OpenSourceAppliances/dryer/docs/design-rules.md

# Dryer design rules

Draft 9, 2026-11-06. Status: proposed, not yet reviewed against a real build.

Changes in draft 9: the parts of the reference build are finished (`DECISIONS.md`, 2026-11-06, three entries). The blower housing hangs on a blower plate, a 1.5 mm steel plate across the bay in front of it on two angle feet, with the spool's bore cut through it (7a Drive). The exhaust is drawn as parts: the housing's 102 discharge collar, a catalog 4 in aluminium pipe along the bay floor through the rear lower panel's port and 50 proud of it as the vent hose spigot, two clamps, the air-proving tap and its tube (7a Air). The two chassis sensors the UCI-D wires to J2 are placed: the exhaust thermistor on the lint box's back plate and the moisture bar set on the front bulkhead's drum side (7a Air, 7a Bulkheads). The gas entry and the condensate drain are cut in the rear lower panel and blanked (3.2, 7a Panels). The cable clamp holes get their clips. The no-heat module is the electric module's empty box (5.1). Section 11 closes its items 4 and 5. 213 parts.

Changes in draft 8: the ducts are drawn as parts (`DECISIONS.md`, 2026-11-06). Every duct is 1.5 mm laser-cut plate screwed with M4 button heads into the tapped edges of aluminium flat bar frames: the lint box between the front stubs (30 x 8 bars, the bulkhead its back wall above 265), a spool to the blower's mouth (40 x 8), the riser's hood (25 x 8), trunk (50 x 8) and inlet nozzle (40 x 8). Drawing them found that nothing closed the door throat between the ring and the bulkhead, so a rolled 1.5 mm throat liner now stands there and the lint box's top follows it (7a Door, 7a Air). The lint filter is a mesh basket on laser-cut sector plates through the slot (widened to radius 238 to 267), lifted out through the door by a D-pull on its lip (7 Lint management). The door switch, the air-proving switch, the exhaust thermostats and the motor cradle bolts are placed (7a Door, 7a Drive). Fusion's motion model slides the basket. 198 parts.

Changes in draft 7: the two modules and the drum's support are drawn, from published figures, before the first build (`DECISIONS.md`, 2026-11-06). The electric heat module is a bolted 1.5 mm duct box on the tray with the catalog element on two angle rails inside, a round 125 collar on its lid under the riser's hood, and its contactor and terminal strips on a DIN rail on a plate behind the box; the tray rails run the full depth and take the tray with M4 T-nuts (7a Heat module, 5.2). The common power module is no longer a box in the bay: it is a 150 x 720 plate on the rear faces of the two rear cross rails, left of the riser, with five short DIN rails, a cover over the mains rails and a barrier below the SELV rails, serviced with the rear upper panel off (section 4, 7a Power module); the cord and the harnesses pass through grommets in the bay ceiling and the top panel. The drum is located endways by two nylon glides on each bulkhead, with the felt in two arcs round them (7b Seals), and the rollers turn on ISO 7379 shoulder screws through the bulkheads (7b Rollers), 32 degrees each side of bottom so their nuts clear the lint duct. The motor pulley is 20 mm: 30 gave 83 drum rpm, outside the 45 to 55 target (7a Drive). The box joints are M4 button heads with nuts, not rivets, and the tray and box use M4, not M6, into the 2020 rails (section 8).

Changes in draft 6: the three findings of draft 5 are settled (`DECISIONS.md`, 2026-11-06). The drum rings' bore grows from 480 to 540 and the lint slot becomes a curved slot inside that bore, below the 460 door opening, so the front felt fits and both seals are drawn (7a Bulkheads, 7b). The heat module leaves by the back: the riser's bottom rises to 230, with a hood over the module's outlet, and the cord enters through the base pan instead of the rear lower panel (7a Air, 7a Panels, 7 Access). The console is a 200 mm box across the rear of the top on its own small 4040 frame, deep enough for the whole UCI-D envelope (7a Console). Every M4 is a button head with a hex socket (section 8). The Tier 0 faceplate moves its 22 mm devices up and K1's rail down so K1 stays inside the aperture (`controls/tier0-mechanical`). The feet grow to 18 mm under the pan for the cord.

Changes in draft 3: the mechanical architecture is decided (section 7a) and exists as a parametric model in `mechanical/cad/osa_dryer_cad.py`; the drum is made by the builder from a laser-cut sheet on two laser-cut rings (section 7b); drum 620 mm; the verification plan (`docs/verification.md`) is the gate structure for building this fully on paper and then once for real.

Changes in draft 5: the model now draws what this document already called for but had only implied: the T-slot profiles of every extrusion, 6 mm corner radii on every plate (3 mm on the cheeks, the splice and the tabs), every panel bolt (M6 x 12 hex with washer into a T-nut), the four leveling feet, the belt on its real path with the flat idler, its arm and spring, the door's two flag hinges, handle, seal and catch with their screws, the ring's eight M4 bolts, the Tier 0 control module (faceplate, timers, knobs, selector, START, K1), the rear felt seal, the cord bushing, and the detail of the motor, pulley and blower. Drawing the belt showed that a single ceiling slot on the centre line cannot pass it; the bay ceiling now has two slots where the runs cross (7a). Drawing the felt showed that the front felt annulus and the lint slot occupy the same band of the front bulkhead, and that the slot's ends lie outside the drum; the front felt is not drawn and the slot waits on a decision (`docs/verification.md` V-010, V-016). The drum's M4 bolts are 8 long, not 10, and the baffle bolts are M6 (the holes were always 6.5).

Changes in draft 4: numbers in 7a and 7b corrected to what the model and the drawings hold after the CAD audit (`mechanical/cad/cad_audit.py`, V-010): inlet field 200 x 130, lint duct 336 x 36, rings' hole circle 299.2, bay ceiling behind the front bulkhead, front and rear panels split at the bottom of the mid rail, belt track on the drum at the pulley, rollers over the rings. The audit also found and fixed a console face plate drawn sloping the wrong way.

Changes in draft 2: the heat source is a module and the builder picks one of four (none, electric, gas, heat pump); the cabinet base is the heat module bay; the heat module interface (section 3.2); the door switch has a contact in the motor line; a note on fastener heads.

The charter sets the rules for every appliance. This document sets the rules for this one. The UCI-D spec (`controls/uci-spec.md`) sets the control interface. CAD, the wiring, the BOM, and the build guide must meet all three. The Fusion archive is the design of record and the script, STEP, DXF and the wiring document are its open form (`DECISIONS.md` 2026-11-06). Where this document and the charter disagree, the charter wins unless `DECISIONS.md` records why not.

## 1. One chassis, four heat choices

The chassis (frame, cabinet, drum, drive, blower, console, common power module, control module) is the same whatever makes the heat. The builder picks a heat module. The heat module and the cord are the only things that change.

| Heat choice | What goes in the bay | Supply and cord | What else the builder needs | Dry time, 4 kg cotton (target) | Difficulty | Status |
| --- | --- | --- | --- | --- | --- | --- |
| None | The electric module's duct box on its tray with nothing in it, so room air reaches the drum (5.1, `DECISIONS.md` 2026-11-06) | 120 V, 15 A, NEMA 5-15 | Nothing. Vent outside, or into the room if lint is acceptable there. | Not a target. It is a tumbling fan: line-dry assist, fluffing, airing, pet hair. | Easiest. Every build runs this way first (section 5.1). | Part of every build |
| Electric | Element box, 5.0 to 5.6 kW, thermal fuse, high-limit, contactor | 240 V split phase, 30 A, NEMA 14-30 | A dryer circuit | 45 to 60 min | Easy. The deepest parts market there is. | Reference build |
| Gas | Listed burner assembly (valve, igniter, flame sensor, orifice), burner high-limit, thermal fuse, relay | 120 V, 15 A, NEMA 5-15, plus a gas line | A gas supply with a shutoff, an LP orifice kit on propane, combustion air, and venting outdoors, which is not optional | 45 to 60 min | Moderate. Connecting gas may legally require a licensed person; the builder finds that out before buying anything. | Variant, after the reference build |
| Heat pump | Sealed, pre-charged heat pump unit, compressor contactor, anti-short-cycle timer, condensate pump or tank with float switch, secondary lint filter, return duct | 120 V, 15 or 20 A | A drain or a tank to empty; no vent | 2 to 3 h | Hardest. Depends on a sealed unit being obtainable (section 5.4). No refrigerant work, ever. | Variant, blocked on sourcing |

Rules that follow from the table:

- The reference build is electric. It is the first one built and the one the build guide is written from.
- Every build, whatever its heat choice, is first run with no heat module fitted, during commissioning, to prove the drum, drive, airflow, and interlocks before anything hot goes in.
- A builder may change heat choice later by swapping the module and the cord. Nothing else moves.
- 230 V single-phase (Europe, UK, Australia and elsewhere) is the same chassis with a 230 V motor and a 230 V heat module. It is documented after the reference build works.

## 2. Six blocks

Everything in the dryer belongs to one of these, and each one comes out as a unit.

| Block | What is in it | Expected life | What wears |
| --- | --- | --- | --- |
| Frame and cabinet | T-slot aluminum extrusion or bolted steel angle frame, laser-cut flat panels bolted on, the console, the heat module bay, feet | The life of the building | Nothing. A dented panel is unbolted and a new one cut. |
| Drum and door | Drum, front and rear bulkheads, drum support (rollers or bearings), felt seals, door, door glass or panel, hinge, latch, door switch | Decades | Rollers, bearings, felts, glides, door switch, latch |
| Drive and air | Motor, belt, idler, blower wheel and housing, lint filter, riser duct, exhaust or return duct | Decades for the housings and ducts | Belt, idler bearing, motor (as a whole; it is a catalog part), lint filter |
| Heat module | One of: nothing but a blanking duct; an element box with its limits; a burner assembly with its limits; a sealed heat pump unit with its contactor, timer, and condensate handling. Each on its own tray. | Element: years to decades. Burner: decades, parts by the kit. Heat pump: as long as the sealed unit lasts, then the whole unit. | Element, every fuse and thermostat, igniter, flame sensor, valve coils, compressor contactor, condensate pump |
| Common power module | Terminal block for the cord, 24 V supply, motor contactor, interface relays, air-proving switch, exhaust thermal fuse, cycling thermostats, PTC fuses, harness to J1 and J2, terminals to the heat module | Decades | Contactor contacts, relays, supply (as a whole), thermostats |
| Control module | Whatever is bolted into the UCI-D aperture | Until its technology is gone, then it is replaced by whatever exists | The whole thing, by design |

## 3. Electrical architecture: the interlock chain

This is the part of the design that decides whether the dryer is safe, so it is fixed here before any wiring is drawn. The ladder diagram and the part families are in `controls/uci-spec.md` section 9. This section states the rules behind it.

### 3.1 Rules

1. Every heat module has its own listed limits in series with its heat source, independent of everything else: a one-shot thermal fuse and an auto-reset high-limit for the element and for the burner, both rated for their circuit; the compressor's own thermal protector and a condenser outlet high-limit for the heat pump. No control, relay, or contactor can bypass them. (Charter: every heat source has a non-resettable thermal fuse and a resettable high-limit in series, independent of any control board.)
2. The common power module permits heat through one 24 V terminal, HEAT_EN, which is live only while all of these are closed, in series: the door switch, the air-proving switch, the exhaust thermal fuse, the selected cycling thermostat, and the contact of the interface relay that the control module drives. Every one of those is a plain switch. Opening any one of them removes the permission.
3. The door switch has two contacts. One is in the motor's 120 V line and is rated for the motor, so opening the door opens the motor circuit itself (the charter's hardwired interlock in the mains path). The other gates the 24 V bus that every coil circuit and STAT_DOOR hang from. The motor contactor's coil circuit passes through that bus and the contact of its interface relay. The motor has its own overload: a built-in thermal protector or a separate listed overload relay. No heat module has a door contact in its own mains line, because no door switch is rated for element current; heat is cut by the 24 V bus and by the air-proving switch when the motor stops.
4. Airflow is proven by a switch that senses the blower, not by assuming the motor is turning. With the motor stopped, a broken belt, or a seized blower, no heat module can be energized.
5. Everything the control module touches is 24 V DC or less. There is no mains voltage in the console.
6. The 24 V supply is a listed unit. 0V is bonded to protective earth at one point in the common power module.
7. The cord enters through a strain relief into a terminal block. PE bonds to the frame at that block with a ring terminal and a star washer on bare metal, and every panel and tray that carries anything electrical is bonded to the frame the same way.
8. Wire colors follow the US convention on the mains side (black and red for L1 and L2, white for N, green for PE) and are listed on the wiring drawing. The 24 V side uses its own distinct colors, listed on the same drawing.
9. Mains and the 24 V side are separated inside the common power module and inside every heat module: mains on one side of a barrier or in its own compartment, 24 V on the other. The SELV side never shares a terminal strip with mains.

### 3.2 The heat module interface

The common power module and the heat module meet at one terminal strip and three flanges. This interface is fixed for the dryer family the same way the UCI-D is fixed for controls, so a heat module designed later fits a chassis built earlier.

Electrical, on two DIN terminal strips in the common power module (mains and SELV never share a strip), reached with the rear upper panel off (draft 7); the module's own strips are on its tray behind the rear lower panel. The full terminal map and wire list are in `electrical/wiring/common-power-module.md`.

| Terminals | What | Rule |
| --- | --- | --- |
| X2:1 to X2:4 (L1, L2, N, PE), on the mains strip | Unswitched mains from the cord terminal block | The heat module carries its own listed switching device (contactor or relay) and its own fuse if its circuit needs one. L2 is live only with a 240 V cord; a 120 V heat module leaves it unconnected. |
| X4:1, X4:2 (HEAT_EN, 0V), on the SELV strip | 24 V DC, up to 1 A, present only while the common chain in rule 2 is closed | The heat module makes heat only while HEAT_EN is present, and only through its own limits (rule 1), which it must have whether or not HEAT_EN is there. The heat module may put more switches in series with HEAT_EN on its side (the heat pump's anti-short-cycle timer, high-limit, and condensate safety switch). |
| X4:3, X4:4 (HEAT_ON_A, HEAT_ON_B), on the SELV strip | A dry contact from the heat module, closed while it is producing heat, or as close to that as a listed part can sense | The common power module puts 24 V through this contact and a PTC to STAT_HEAT_ON on J1. The source per heat module is listed in `controls/uci-spec.md` 6.3. The "none" module leaves it open. |

Mechanical, in the cabinet base (section 7):

| Flange or feature | What | Rule |
| --- | --- | --- |
| Riser hood | The inlet of the duct that carries air up to the rear bulkhead and into the drum: a hood 300 wide, 28 tall, with its bottom at 230 from Y 448 to the riser, carrying a 3 mm foam ring round a 125 hole at X 0, Y 525 | Fixed position and size, set in CAD (draft 7). Every heat module stands a 125 round collar under that hole with its rim 3 under the hood, brushing the foam; nothing on the module reaches above 227, so the tray slides out the back under the hood. No bolts at the riser: the tray's bolts hold the module in place. |
| Blower outlet flange | 102 mm round, the blower's discharge: the housing's own collar on the rear face of its outlet box at Y 190, X 230, Z 150 (draft 9) | Vented modules slide the catalog 4 in exhaust pipe over it (7a Air). The heat pump module takes it as the return duct inlet and blanks the rear exhaust port. |
| Tray rails | Two 2020 rails the full depth of the base at X plus and minus 150 to 170, on the bottom end rails, that any heat module tray slides onto and bolts to with M4 button heads into T-nuts in their top slots (draft 7; draft 2 said M6, which a 6 mm slot does not take) | The tray is laser-cut flat stock, 340 x 280 x 1.5 from Y 420 to 700; the heat module is built on it on the bench, then slid in from the back. |
| Air inlet | Louvers in the lower rear and side panels | Vented modules draw room air through them into the module and up the riser. The gas module draws its combustion air through them too. |
| Gas inlet | A 25 mm hole in the rear lower panel at X -230, Z 150 for a 3/8 NPT bulkhead fitting, blanked on every other build by a 60 x 44 x 1.5 plate on two M4 (`drawings/entry-blank.dxf`, draft 9) | Gas module only. The shutoff valve is outside the cabinet. |
| Condensate outlet | A 20 mm hole in the rear lower panel at X -230, Z 66 for a drain hose grommet, blanked on every other build by the same 60 x 44 plate (draft 9) | Heat pump module only. |

### 3.3 Why the cycling thermostats are in the coil circuit (proposed)

Residential dryers put the cycling thermostat in the element circuit, where it switches the full element current. Commercial dryers with contactors put it in the coil circuit. This design proposes the coil circuit because:

- it keeps every temperature control except each heat module's own limits at 24 V,
- it lets the control module select high or low heat through a 24 V relay contact instead of switching element current,
- the thermostats then carry milliamps and last longer,
- it means the same two thermostats serve every heat module, with only their L-ratings changing.

The cost is that the contactor operates every time the thermostat cycles, a few times per load. The contactor is a catalog wear part and gets an entry in the failure-mode guide. If the chosen contactor's rated electrical life does not cover 20 years of that, the thermostats move to the element circuit and this section is rewritten with a `DECISIONS.md` entry. For the heat pump the anti-short-cycle timer sits between the thermostat and the compressor, so the thermostat cannot short-cycle it.

### 3.4 What the control module can and cannot do

Can: start and stop the motor, ask for high or low heat, end heat early, read the door, airflow, and heater state, read temperature and moisture.

Cannot: energize any heat module with the door open, without airflow, past a tripped limit, past the cycling thermostat, or without the motor; keep the motor running with the door open; raise the temperature above the hardware thermostats; restart a compressor against a pressure head; reach mains; tell which heat module is fitted, except by being told in its configuration.

## 4. Common power module rules

- Lives on a laser-cut steel plate, 150 x 720 x 1.5, bolted with four M6 to the rear faces of the two rear cross rails in the rear compartment behind the rear bulkhead, left of the riser, behind the rear upper panel (draft 7; drafts 2 to 6 had a box in the bay, which the heat module tray and the drive left no room for). One panel off gives access to every terminal, relay, and fuse; the heat module's own terminal strip is behind the rear lower panel on its tray.
- Five short DIN rails (140) across the plate for the supply, motor contactor, interface relays, PTC holders, and terminal blocks: A1, A2, A3 (mains) at 360, 470 and 580 from the floor under a 1.5 mm cover on four M4 x 75 standoffs; a 20x20x2 angle with a 1.5 mm shelf at 640 as the barrier; B1 and B2 (SELV) at 700 and 820 above it. All catalog, all clip on and off without tools. Every device is drawn as an envelope from published figures, 15 or more from the rear panel (V-112).
- The cord comes up through its strain relief bushing in the base pan at X -275, Y 690, straight up the bay, through a grommet in the bay ceiling, to X1 on rail A1. The bay harness (motor, door switch, heat module) goes down through a second grommet beside it; the console harness goes up through a grommet in the top panel at X -225, Y 690.
- Terminals: screw or spring-clamp DIN terminal blocks for mains, with the cord, motor leads, and heat module leads landing on them with crimped ferrules or ring terminals. No wire is ever cut to remove a part; every lead unplugs or unscrews.
- The harness to J1 and J2 leaves the box through a grommet with strain relief, and is the only thing that goes to the console.
- Thermistor and moisture leads are twisted pairs routed away from the mains harness.
- It is identical for all four heat choices. A no-heat build may omit the heat-enable chain parts (air-proving switch, exhaust thermal fuse, cycling thermostats, RLY_HEAT, RLY_HEAT_LO); the BOM marks those lines "omit only if a heat module will never be fitted". The default is to fit them, so heat can be added later by sliding in a tray.
- The wiring drawing shows physical routing, every wire color, every terminal number, and the torque for the mains terminals.

## 5. Heat modules

Each heat module is built on its own tray, has its own BOM file (`bom/heat-<choice>.csv`), its own wiring diagram, and its own entries in the failure-mode guide. Each must meet 3.1 rule 1 and 3.2 on its own.

### 5.1 None

- The tray carries the electric module's duct box with nothing in it (`DECISIONS.md` 2026-11-06): the tray, the four walls, the lid, the angles, the collar and the bonding stud, cut and bolted exactly as 7a Heat module draws them, with no element, no element rails, no thermostats, no terminal plate and no devices; the element's terminal opening stays open. `bom/heat-none.csv` lists it. Room air comes in through the louvers and the box's 150 x 60 inlet and leaves through the collar into the riser. Nothing electrical. An electric builder adds the element and the electrics to this same box later.
- This is the first stage of commissioning for every build: the drum turns, the belt tracks, the blower proves airflow, the door stops everything, the control module starts and stops a cycle, and only then does a heat module go in.
- As a finished dryer it is an unheated tumbler. It will not dry a wet load in an evening, and the docs say so. It is the right build for someone who line-dries and wants to soften and de-lint, or who will add heat later.
- A control module at Tier 1 or 2 is configured `heat: none` so it never calls a heat fault. Tier 0 needs nothing; its HEAT switch does nothing and its docs say so.

### 5.2 Electric

- Element 5.0 to 5.6 kW at 240 V, open coil in a steel box, switched on both poles by a contactor in the module.
- The heater-box thermal fuse and high-limit are in the element's mains path, rated for the element current.
- Preferred box: an appliance-market heater element assembly (cheap, listed, imperial). Alternative: a laser-cut box with a bought coil on ceramic insulators (metric, but the mounting is our design and the listing covers only the coil).
- Drawn in draft 7 (7a Heat module): the catalog element on its own frame (Whirlpool 279838 class, a listed subassembly) inside a laser-cut 1.5 mm box of our design, because the chassis wants the outlet on top under the riser's hood, which the appliance cans (open at one end, out the other) would need an elbow for. The box is 290 x 205 x 110 outside on the tray, joined at every edge with 20x20x2 aluminium angle and M4 button heads with nuts, no bends, no rivets; the lid comes off with ten M4 to change the element. Inlet 150 x 60 in the left end, outlet a 125 round catalog starting collar on the lid, the thermal cut-off and high-limit on the lid beside the collar. The element's frame fit, its terminal position and the air speed over the coil are V-108 checks against the element bought.
- Element terminals use rated high-temperature wire and listed terminals.

### 5.3 Gas

- The burner is a listed dryer burner assembly bought as one unit from the appliance market: valve body with its coils, hot surface igniter, radiant flame sensor, orifice, and burner tube. Its parts stay available by the kit for decades. The flame safety is electromechanical and lives in the assembly: the igniter heats through the sensor, the sensor opens when it sees the glow, that opens the valve, and if the flame goes out the sensor closes and the valve closes with it. No board.
- 120 V. The module's relay switches the burner circuit on HEAT_EN. The burner high-limit and a thermal fuse are in that circuit on the burner housing.
- The burner tube is sealed from the lint path. Combustion air comes through the cabinet louvers; the cabinet is lint-managed (section 7) because lint reaching a burner is the classic dryer fire.
- Natural gas by default, LP by the maker's conversion kit (orifice and regulator setting). The docs say which and how to tell.
- The gas connection: a shutoff valve outside the cabinet, a listed flexible connector, a leak test with soap solution before the first light. Many places require a licensed person to connect gas; the build guide says so in the first paragraph of the gas section, and the builder is responsible for finding out.
- Venting outdoors is mandatory for gas. The docs do not describe any other arrangement.
- STAT_HEAT_ON comes from a relay with a 120 V coil wired across the gas valve, so the control module sees "valve open", which is as close to "flame" as a listed part gets without a flame rod.

### 5.4 Heat pump

Rules:

- The refrigeration circuit is a sealed, pre-charged unit bought as one part and never opened. No brazing, no charging, no refrigerant handling. (Charter decision on the fridge: refrigerant loops are not hobbyist work. In the US, handling refrigerant also needs certification.)
- The compressor is fixed-speed and driven by a contactor from HEAT_EN through an anti-short-cycle timer. An inverter-driven compressor is not acceptable, because the inverter is the OEM's board: firmware and a single source in the heat path, which breaks the Tier 0 rule.
- Closed air loop: blower outlet, return duct, evaporator (air is cooled and the water condenses out), condenser (air is reheated), riser, drum, lint filter, blower. The rear exhaust port is blanked. Nothing is vented.
- A secondary fine lint filter sits at the evaporator inlet and is reachable by the person without tools, because lint on the evaporator is what kills heat pump dryers.
- Condensate goes to a drain hose through the rear panel, or to a condensate pump with a safety switch, or to a removable tank with a float switch. The float or safety switch is in series with HEAT_EN on the module side: a full tank or a failed pump stops heat without a board. (Charter, wet appliances: a float switch that cuts the fill without a board; this is the dryer's version of it.)
- A condenser outlet high-limit thermostat is in series with HEAT_EN on the module side, in addition to the compressor's own protector and any high-pressure switch the sealed unit has.
- Weight: a sealed unit is 20 to 35 kg. The tray and rails are sized for it, and the build guide says it is a two-person lift.
- The cycling thermostats for this module are a lower L-rating than for electric, chosen when the unit is known.

What is known about sourcing, as of this draft: Whirlpool lists the heat pump unit of its WHD560CHW family of 24 in dryers as a repair part (W11551760), and GE lists the heat pump module of its combination washer-dryer (WE03X36780). Both are single-source OEM assemblies tied to one model family. Whether their compressors are fixed-speed (usable here) or inverter-driven (not usable), what refrigerant they hold, what they weigh, how they ship, and what they cost on the day, all need checking against the OEM's own documentation before this module gets past paper. A dehumidifier's sealed unit is the same arrangement (evaporator and condenser in series in one air stream) in a cheap, many-maker package, but a dehumidifier is built for room-temperature air and this loop runs warmer; it is an experiment, not a part, until someone measures one. Until a unit is confirmed, this module is specified in principle and blocked in practice, and the docs say so.

## 6. Controls

- UCI-D as published in `controls/uci-spec.md`. Nothing about the controls is decided anywhere else.
- The control module never knows which heat module is fitted. It asks for heat; the chassis decides. Tier 1 and 2 modules are told the heat choice in their configuration file only so they can set the fault timeout and hide the heat settings on a no-heat build.
- Tier 0 is the reference build: two spring-wound interval timers, a heat selector, a start button, and a hold relay. See `controls/tier0-mechanical/`. Timers of 0 to 2 h suit vented builds, 0 to 4 h a heat pump build.
- Tiers 1 and 2 are built after the Tier 0 dryer dries clothes, not before.
- A screen is a Tier 3 accessory with its own mounting spec on the console or the door, never part of the chassis.

## 7a. Mechanical architecture (decided, modeled)

The whole machine is one parametric model, `mechanical/cad/osa_dryer_cad.py`, which writes every STEP and DXF, the extrusion cut list, and the check views in `mechanical/drawings/`. The numbers below are the model's defaults; a measured part changes a parameter, not a drawing.

| Element | How it is done |
| --- | --- |
| Frame | Four 4040 corner posts, 1000 mm. Three levels of rails: bottom (0 to 40), mid (260 to 300, the bay ceiling), top (960 to 1000). Each level has two side rails (670) and a rear end rail (610); bottom and top have a front end rail (610); the mid level has two front stubs (135 each) with a gap for the lint box, their inner end bores tapped M8 for the box's two hang bolts (draft 8). The mid and top levels each have a rear cross rail (610) at the rear bulkhead. Two 2020 tray rails (750, draft 7) the full depth at X plus and minus 150 to 170, lying on the front and rear bottom end rails, each held at both ends by a catalog 2020 inside corner bracket with two M4 x 8 button heads (one into the rail's side slot, one into the end rail's top slot). The console's own frame (below) adds four 200 posts, two 610 end rails and two 58.5 side rails. 29 pieces, all square cuts; `drawings/frame-cut-list.csv`, which now also lists the flat bar for the ducts and the liner strip. Every piece is drawn with its T-slot profile (a generic 8 mm slot 4040 with a 6.8 centre bore, 6 mm slot 2020 with a 4.2 bore; the bought profile's own drawing governs, V-105), so a bolt in the model sits in a slot and a foot in a bore. The four post bores are tapped M8 at the bottom for the feet. |
| Bulkheads | Two 1.5 mm steel plates, 610 wide, from the mid rails to the top rails. The front one sits behind the front rails and carries the door opening (460), the lint slot (draft 8: a curved slot between radius 238 and 267 about the drum axis, 36 degrees each side of straight down, 9201 mm2; it sits 8 outside the opening and 3 inside the rings' 540 bore, so the air leaves the drum through the rings, not past them, and the basket passes it with 0.9 each side), the glide positions (draft 7: four 4.5 holes for the two nylon glides at 10 and 2 o'clock on radius 282) and six 4.5 holes at X plus and minus 162, Z 310, 345 and 380 for the M4 that pull the lint box's side bars against it from the drum side, outside the felt (draft 8). It is the lint box's back wall above 265. Draft 9 adds the moisture bar set (uci-spec 7.2, `MOIST`) on its drum side, right of the lint slot and inside the ring bore: an appliance-market set of two stainless strips on an insulating base, drawn 90 x 30 x 8 along the tangent at 58 degrees right of bottom on radius 250 (its corners reach radius 268.8, inside the rings' 270 bore, and its near end is 47 degrees right of bottom, clear of the basket's lip ring at 37.5), two M4 x 16 from the drum side through its tabs, 35 each side of its centre, nuts in the front gap, and a 16 hole under its centre (X 212, Z 499) for its two terminals; its twisted pair runs down the bulkhead's front face to the door switch cable's bulkhead grommet, which grows to 16 (as does the one in the bay ceiling) to pass both cables. The rear one sits in front of the rear cross rails and carries the same glide holes, the roller stud holes (8.5 for the studs' M8 threads, on both bulkheads, at plus and minus 32 degrees from straight down on the rim radius plus the roller radius, 340: X 180.173, Z 343.164; draft 7, 30 degrees put the front studs' nuts into the lint duct's sides), the air inlet hole field (200 x 130 above the axis: 14 x 9 holes of 10 mm on a 14 mm pitch, 126 holes, inside the ring opening) and ten 4.5 holes round the field for the riser nozzle's M4 from the drum side (draft 8). The rear one passes through a slot in the bay ceiling plate and the front one stands at the plate's front edge, so no lint path exists between the bay and the drum compartment. |
| Bay ceiling | One 1.5 mm plate on the mid rails from 0.5 mm behind the front bulkhead to the back, notched at the rear posts, slotted for the rear bulkhead, cut for the belt (two slots of 40 x 90 at the pulley's Y 402, centred at X -137.9 and X 145.4, where the two belt runs cross the plate: a run from a small pulley 200 mm below the drum leaves the drum far from the centre line, so the single slot at X 0 of draft 4 was 138 mm from one run and 148 from the other), the riser trunk (264 x 57 at Y 650.5 to 707.5, 2 mm around the trunk's plates, draft 8), the power module plate (a 152 x 3.5 slot at Y 652.25, draft 7) and two grommets at Y 690 (22 at X -275 for the cord, 30 at X -200 for the bay harness). In front of the bulkhead the two front stubs and the lint box close the bay. |
| Drum | Made by the builder: one laser-cut 0.8 mm 304 sheet wrapped around two laser-cut 2 mm rings, a splice strip under a butt seam, three catalog aluminum angle baffles, four catalog dryer rollers. Section 7b. Every piece is flat stock, extrusion, or catalog, and the DXF is the documentation. |
| Drive | **Superseded 2026-11-09, to be redrawn in draft 10 (`DECISIONS.md`): a single-shaft NEMA 56 drum motor through a countershaft (6J160 on the motor, 6J 4.5 in and 6J190 on a 5/8 in shaft in two pillow blocks), a 6-rib J drum belt with a 2.4 in flat idler, and a separate packaged blower (Dayton 1TDV4 class) on its own motor. The text that follows describes the draft 9 model until then.** A dual-shaft NEMA 48 frame 1/3 hp 1725 rpm motor on the bay floor, axis along the drum, at 120 mm height, on two cradle mounts from a dryer motor mount kit. Blower wheel on the front shaft in a catalog blower housing, inlet facing front, outlet box on its right side turning into the exhaust duct at Y 190. PJ poly-V pulley (5 ribs), 20 mm, on the 1/2 in rear shaft at Y 402: 1725 x 20 / 620 = 56 drum rpm (draft 7; the 30 pulley of drafts 3 to 6 gave 83, outside the 45 to 55 target in section 7; the model refuses a pulley outside 45 to 57). A catalog J-section poly-V belt, 5 ribs, 12 wide: 2222 mm along the drawn path (round the drum on the 40 mm belt track centred on the pulley, 352 from the drum's front edge; down the right run through the right ceiling slot to the pulley; up the left run over the idler and through the left slot), nearest catalog length chosen at V-012. The idler is a catalog 40 mm flat idler pulley on the left (slack) run at X -60, Z 165, on a 25 x 4 aluminium flat bar arm that pivots on an M8 bolt through an angle bracket on the base pan at X -115, Z 25, pulled toward the belt by an extension spring from a post on the arm to a post on a second bracket at X 65; the arm runs from Y 390 to 394, just behind the motor, the belt 396 to 408, the spring 409 to 417, the heat module tray starts at 420. The pulley wraps 120 degrees with the idler where it is drawn; V-105 sets the final idler position from the bought belt. Blower plate (draft 9): the housing hangs on a 1.5 mm steel plate 260 wide, from the base pan to 245 (15 under the mid rails), standing across the bay at Y 84 to 85.5 in front of the housing on two 90 mm 20x20x2 angle feet (two M4 x 8 and nuts through the plate into each foot's leg, heads on the plate's back below the housing; two M6 x 12 through the base pan into each foot at X plus and minus 70 and 110, Y 74, nuts on the foot). The spool's 140 x 120 bore is cut through the plate at the motor axis; the housing's inlet face sits on the plate's back and its own screws go into the plate on the bought housing's pattern, drawn as four M4 x 8 on 176 x 120 (V-107); the spool's foam lands on the plate's front face. The plate clears the tray rails by 20 and the lint box's bottom bar and the spool pass in front of it. |
| Air, vented | Louvers in the lower panels, heat module tray (Y 420 to 700), the module's inlet (150 x 60 in its left end), the module's 125 round collar on its lid (at X 0, Y 525, rim at 227), the riser (draft 8, all 1.5 mm plates on aluminium flat bar frames, M4 x 8 button heads into tapped edges): a hood of 25 x 8 bars between two 350 x 257.5 plates over the collar, from Y 448 to 705.5, bottom at 230 with a 128 hole and a 3 mm foam ring round the collar, top at 258 under the mid rear cross rail (its top screws sit clear of the rail's footprint), 334 x 25 inside (8350 mm2); a trunk of two 50 x 8 bars between two 260 wide plates standing on the hood's top plate behind the rear bulkhead, Y 652.5 to 705.5, up to 831.5, 244 x 50 inside (12200 mm2), its side bars screwed from inside the hood into their tapped feet; a nozzle of four 40 x 8 bars (228 x 158 outside, 212 x 142 inside) from the bulkhead's back face (2 mm foam compressed to 1) to the trunk's front plate, round the hole field, ten M4 x 10 from the drum side through the bulkhead and ten M4 x 8 from inside the trunk. Then the inlet field, the drum, the lint slot, the lint basket (7 Lint management), the lint box: 1.5 mm front plate at Y 7 (2.5 behind the ring bolts' tips) on two 30 x 8 side bars at X plus and minus 158 to 166 and a bottom bar at Z 62 (2 above the tray rails), hung on the front stubs by two M8 x 20 button heads through the bars and 4 mm spacers into the stubs' tapped end bores, pulled against the bulkhead (its back wall above 265, with 3 mm foam compressed to 1.5 along the bars) by six M4 x 10 from the drum side, a lower back plate below the bulkhead from Z 62 to 275 with a 140 x 120 opening into the spool; the plates' top edges and the bars' mitred ends follow the throat liner on radius 237.2, so the liner is the box's top; 316 x 30 inside (9480 mm2). The spool: four 40 x 8 bars, 156 wide and 62 to 198 tall (140 x 120 inside, 16800 mm2), screwed through the back plate from inside the box (the bottom bar by three M4 x 40 through the box's own bottom bar), its rear edges on 6 mm foam compressed to 4 against the blower's inlet face (V-107); its bottom bar covers the lowest 15 mm of the 130 mouth. Then the blower, whose outlet box (an envelope 100 to 291 across, 94 to 206 tall, Y 111.5 to 190, draft 9) carries the 102 discharge collar of 3.2 on its rear face; a catalog 4 in (102 x 1) aluminium pipe, 609.5 long, slides 23 over the collar and runs along the bay floor's right side at X 230, Z 150, through the 106 port in the rear lower panel and 50 proud of it as the vent hose spigot, held by a worm-drive clamp over the collar joint and a second clamp inside the panel that bears on it (the builder's hose clamp goes on the spigot outside). The air-proving tap is a 6.5 hole on the pipe's top at Y 300 with a brass barb fitting and locknut; the 6 mm silicone tube rises to 240, runs forward over the exhaust thermostats and drops in front of the outlet box to PS1's port (the setpoint and which port are V-205). The exhaust thermistor TH1 (uci-spec 7.1, `TEMP_EXH`) sits on the bay side of the lint box's lower back plate at X 120, Z 160, between the spool's bar and the box's side bar, its sensing nib through a 12 x 18 slot into the box where the air sweeps toward the spool, one M4 x 20 from inside the box through the plate and its body, nut on the body; its two spade terminals face the bay. The hood is what lets the module slide out the back: nothing of the riser reaches below 230. |
| Panels | 1.5 mm steel, flat, 6 mm corner radii, bolted to the extrusion slots with M6 x 12 hex head bolts, flat washers and drop-in T-nuts at 150 mm pitch, every hole on a rail centre line (the model draws every bolt; the T-nuts are not drawn): two side panels, front upper (260 to 1000, door ring opening, bolted to the posts, the mid stubs and the top rail; draft 8 adds the door switch plunger hole, 8.5 on radius 258 at 45 degrees right of bottom, and two 4.5 holes for the switch's ears on radius 288) and lower (0 to 259, 56 louvers of 60 x 5, bolted to the posts and the bottom rail; comes off for the bay), rear upper and lower (the same split; 32 louvers, the 106 exhaust port; draft 9 adds the gas entry, 25 at X -230, Z 150, and the condensate drain, 20 at X -230, Z 66 (4 above the bottom rail), each with two 4.5 holes 21 either side for its 60 x 44 blanking plate inside the panel, M4 x 8 heads outside), top panel (full depth; the console stands on it, so its side rows of bolts stop short of the console posts and four more holes take the console's foot bolts), base pan (with a 22 mm hole at X -275, Y 690, at the rear left, for the cord's strain relief bushing: the cord comes up through the pan, up the bay and through the ceiling grommet to the power module, and runs under the pan to the back in the 18 mm the feet give; draft 8 adds four 6.5 holes for the motor cradles' M6 at X plus and minus 22, Y 230 and 350, and two at X 235 and 265, Y 70, for the air-proving switch's bracket; draft 9 four more at X plus and minus 70 and 110, Y 74, for the blower plate's feet, and the four M4 cable clamp holes at X -250 carry nylon P-clips for a 12 mm bundle). Rubber grommets for 1.5 mm panels in the bay ceiling (22 and 30 for the cord and the bay harness; 16 at X 290, Y 60 for the door switch cable and the moisture pair, draft 9), the front bulkhead (16 at X 290, Z 330, the same two cables) and the top panel (22, at X -225, Y 690, for the console harness). |
| Console | A 200 mm tall box across the rear of the top, from the top rear cross rail (Y 611.5) to the back, on its own small 4040 frame built like the cabinet's: four 200 posts standing on the top panel over the cabinet's top rear cross rail and rear top rail, two 610 end rails and two 58.5 side rails between the posts at the top, twelve catalog inside corner brackets with M6 x 12 hex bolts and T-nuts (the foot brackets bolt down through the top panel into those cabinet rails' top slots, so the console's weight and the push on its knobs go into the frame). Five flat plates bolt to its slots like the cabinet's panels: the vertical face (690 x 200) carrying the UCI-D aperture (500 x 120, uci-spec draft 5) centred 83 above the top panel (the module's nuts clear the front rail, the faceplate clears the rail's bolts, the envelope clears the posts' bracket bolts by 45 each side), a cap, a rear plate and two cheeks that continue the rear and side panels. 138.5 deep inside, which holds the UCI-D envelope (500 x 120 x 120 behind the panel plane) with 18 to spare. Total height 1203 on the frame, 1221 on the feet. The Tier 0 module is drawn on the face: 620 x 160 faceplate (UCI-D draft 6, draft 8 of this document: the 560 x 120 aperture, its holes on 590 x 140, the plate 35 from the console's edges and 9 from the posts' bolt heads) on six M4 button heads, two timers with their yokes and 40 mm skirted knobs, the 22 mm selector and START 20 above the centre line, K1 on its DIN rail segment 24 below it, inside the aperture's projection. |
| Door | 2 mm steel ring (560 outside, 470 inside) bolted to the front panel with eight M4 x 8 button heads on a 257.5 radius, 22.5 degrees off the axes, nuts behind the panel. 2 mm steel disc (540), 8 mm in front of the ring, on two catalog flag hinges at the left: an 8 mm vertical pin at X -278.5, 14 mm in front of the panel, 18 mm knuckles 30 tall at 50 above and 50 below the axis; the pinned halves bolt through the ring and panel with two M6 x 16 countersunk screws each, 14 mm apart (nuts behind the panel), the lift-off halves to the disc with two M4 x 8 button heads from the door's front into tapped leaves (a 2 mm disc cannot take a countersink, and the DXF stays a plain 4.5 hole). A 128 mm D-handle (14 round, 30 standoffs) at X 220, M4 from the back of the disc. A 6 mm OEM seal on the disc's back between radius 237 and 246. A magnetic catch on the ring at X 256 to 268 with its strike on the disc. Opens past 90 degrees (100 in the motion model). No window: a glazed door is a later upgrade, not part of the design (`DECISIONS.md` 2026-11-06). Throat liner (draft 8): a 1.5 mm 5052 aluminium strip, 41.3 wide and 1482.4 long (`drawings/liner.dxf`), rolled by hand round a 471 form to an inside radius of 235.5 and spliced at the top with a 40 x 38.3 strip inside it and two M3 x 6 button heads (heads inside, nuts outside), standing between the ring's back face and the front bulkhead with 0.2 of float (seat it against the bulkhead); the ring's 235 edge covers its front end, the bulkhead opening's 230 edge its back, and the lint box's plates cradle it from below. Without it the 40 mm gap behind the panel was open all round the opening and the blower would have drawn room air past the drum. Door switch (draft 8): a catalog two-contact plunger switch (uci-spec section 13, envelope 30 x 25 x 45, V-115) behind the panel on radius 258 at 45 degrees right of bottom, its 8 mm plunger through the ring and the panel; the closed disc presses it 3 mm; two M4 x 8 button heads from the panel's front into its ears on radius 288, outside the ring. |
| Power module | A 150 x 720 x 1.5 plate on the rear faces of the two rear cross rails (M6 x 12 with T-nuts at Z 280 and 980, X -285 and -165), from X -300 to -150, 20 left of the riser, through a slot in the bay ceiling, behind the rear upper panel (draft 7). Five 140 DIN rails across it at Z 360, 470, 580 (mains: X1, CB1, F1; the PSU and K_MOTOR; X2, X3) and 700, 820 (SELV: the three interface relays, the PTC holders, F2, X4; X5, X6), devices drawn as envelopes from datasheets and listings (V-112), the deepest (the relays, 70) 19.5 from the panel. A 1.5 mm cover 150 x 330 over the mains rails on four M4 x 75 standoffs; a 20x20x2 angle at 640 carrying a 1.5 mm shelf out to the devices' depth as the barrier. An M6 ground stud at the top right. The cord ends under X1 after its grommet; the bay harness leaves by the second ceiling grommet, the console harness by the top panel's. |
| Heat module, electric | On the tray (340 x 280 x 1.5, Y 420 to 700, X plus and minus 170, on the tray rails with four M4 T-nuts shared with the box's side angles, an M6 bonding stud at the rear right): a duct box 290 x 205 x 110 outside from Y 422 to 627, four 1.5 mm walls and a lid, joined with 20x20x2 aluminium angle at every edge (bottom angles outside the side walls and inside the end walls, lid angles outside, four corner angles between them) and 64 M4 x 8 button heads with 60 nuts. Two more angles inside the side walls, sharing the bottom angles' bolts, carry the element on their top legs at 81.5: the catalog open-coil element on its frame (267 x 190 x 51, listing figures) lying along X, its terminals out through a 40 x 25 opening in the right end. Inlet 150 x 60 in the left end (9000 mm2); a 125 flanged starting collar on the lid at X 0, Y 525, cut so its rim stands at 227, 3 under the hood (12272 mm2); the thermal cut-off and high-limit on brackets on the lid at X plus and minus 110. Behind the box a 290 x 100 x 1.5 terminal plate at Y 634 on an angle foot, with a 280 DIN rail on its rear face carrying X_HM mains (4 x UK 6 N), K_HEAT (LC1D18 class, 86 deep, its front at 729, 21 from the rear lower panel), a partition, X_HM SELV (4 x UK 2.5 N) and CS1, the current switch for STAT_HEAT_ON. Nothing on the module reaches above 227, so the whole thing slides out the back under the hood (230) and the mid rear end rail (260). The element's frame holes, terminal position and the box's air speed are V-108; the device sizes are V-112. |

## 7b. The drum

The drum is the one part the charter's fabrication rule makes hard, so it gets its own section. A cylinder cannot be laser-cut, but a thin sheet can be wrapped: 0.8 mm 304 bent to a 310 mm radius stays elastic (about 0.13 percent strain), so the sheet does not take a set and does not need a roll; it needs something round to hold it. Two laser-cut rings do that.

| Piece | What it is | Drawing |
| --- | --- | --- |
| Sheet | One laser-cut 304 blank, 0.8 mm, 1945.3 x 550 plus 30 tabs on each long edge (24 wide, 16 tall, one 4.5 hole each, 8 mm out from the fold), eight seam holes down each short edge (15 in from the edge, 50 mm pitch from 55 to 455, skipping the belt track at 352 and both 45 mm roller tracks), and three columns (at a sixth, a half and five sixths of the width) of four 6.5 baffle holes at 105, 225, 325 and 445 from the front edge | `mechanical/drawings/drum-sheet.dxf` |
| Rings | Two laser-cut 304 rings, 2 mm, 618.4 outside (the sheet's inside), 540 inside (the drum opening; draft 6, up from 480, so the curved lint slot sits inside the bore and the felt has a 18 mm face to ride on), 30 holes of 4.5 on a 301.2 mm radius for the tabs, 12 degrees apart | `drum-ring.dxf` (cut two) |
| Splice | One laser-cut 304 strip, 1 mm, 60 x 544, holes matching the seam holes | `drum-splice.dxf` |
| Baffles | Three pieces of catalog aluminum angle 40 x 40 x 3, 480 long, drilled on the drill press to the sheet's baffle holes, bolted through the wall at 120 degrees apart | `frame-cut-list.csv` |
| Hardware | M4 x 8 button head bolts, nuts, and washers: 60 for the tabs (the stack is 2 ring + 0.8 tab + 3.2 nut; a 10 mm bolt would stop 0.5 mm from the front bulkhead), 16 for the seam; M6 x 12 button heads and nuts, 12 for the baffles (the baffle holes are 6.5, so the M4 of draft 4 was a misprint); button heads inside the drum, nuts outside, except at the baffles where the angle is inside | |
| Rollers | Four catalog dryer drum rollers (60 diameter, 25 wide, 10.5 bore, V-106), two on each bulkhead at 32 degrees each side of bottom on radius 340, the front pair flush with the drum's front end, the rear pair 1.5 proud of its rear end, running on the sheet's outer surface over the rings (whether a 0.8 mm sheet backed by a 2 mm ring carries the roller load without denting is a V-208 question). Each turns on an ISO 7379 shoulder screw 10 x 35 with an M8 thread (draft 7): the shoulder's step bears on the bulkhead's drum-side face and the nut, on a washer on the far side, clamps it there; between the head and the bulkhead the roller runs on the shoulder with a 1.0 shim under the head and a spacer 16 x 10.5 x 8.5 against the bulkhead, 0.5 end float. The front nuts sit in the gap in front of the bulkhead beside the lint duct, 4 from its sides; the rear ones in the rear compartment. 5 mm hex key, 13 mm socket | |
| Seals | Felt strip, 10 mm, 18 wide, glued to each bulkhead on the ring faces between radius 273 and 291, outside the 540 bore and inboard of the tabs (the 16 tall tabs start at 293.2), in two arcs: a long one round the bottom (260 degrees, 1282 long on the strip's centre line) and a short one over the top (80 degrees, 396), with a nylon glide pad in each gap (draft 7). The glides, 45 x 20 on the same radius at 10 and 2 o'clock, two M4 each with the nuts sunk in the pad, locate the drum endways: 8 thick at the front (41.5 to 49.5, 0.5 off the ring face at 50) and 9.5 at the rear (600.5 to 610, 0.5 off the ring face at 600), so the drum floats 1 mm between them and the felt only seals. The felt is drawn compressed to the gap: 8 at the front, 10 at the rear. The lint slot sits inside the bore (7a Bulkheads), so the front felt and the slot do not compete (the draft 5 finding, settled in `DECISIONS.md`) | `felt-seal-long.dxf`, `felt-seal-short.dxf` (cut two of each, or cut the strip to the lengths in `frame-cut-list.csv`) |

The tab holes are placed for a sharp 90 degree fold at the sheet's inner surface; the hole then lands on the ring's 301.2 radius. A real fold has a small radius, so V-208 checks that the holes line up and the tab height absorbs the bend allowance if they do not. The seam is at the top in the model (12 o'clock), the first tab centre 6 degrees to each side of it, the baffles at 60, 180 and 300 degrees from the seam.

How it goes together: lay the sheet flat, fold every tab inward 90 degrees with a hand seamer, stand the two rings on their edges, wrap the sheet around them with two people, bolt the tabs to the rings working from the seam outward in both directions, close the seam over the splice strip, then fit the baffles. The rings make the ends round; the seam and the tabs hold the middle. The seam goes at the top of the drum in the model only so the drawing is unambiguous; it rotates with the drum.

What is not settled by reasoning and is checked at V-208 before any stainless is cut: how round the wrapped sheet is at mid-length, how much the belt pulls it out of round, and whether 0.8 mm is the right thickness (0.6 wraps more easily and dents more easily). A wrap in 0.5 mm aluminum flashing or heavy card with the real rings answers it for a few dollars.

The no-fabrication alternative, for a builder who will not wrap a sheet: a 55 gallon stainless open-head shipping drum has standardized, published dimensions (572 mm inside, about 1.0 to 1.2 mm wall) from a dozen makers. Cut to length and fitted with a laser-cut front ring, it is a 140 to 155 L drum, a 5 cu ft dryer. The bulkheads are parameters, so it is a parameter change, not a redesign.

## 7. Mechanical targets and rules

Targets, to be fixed in CAD. Anything here that CAD cannot meet comes back to this document and `DECISIONS.md`. `mechanical/drawings/layout-concept.svg` draws these numbers to scale, side and front, so the bay, the drum, and the air path can be argued about before CAD.

| Item | Target or rule |
| --- | --- |
| Outside size | Fits a standard laundry space: about 690 wide, 1203 high (1221 on the feet), 750 deep, including the console, all in mm |
| Capacity | About 6 kg of dry laundry, drum about 165 L (620 mm diameter by 550 mm long as modeled). The 300 mm bay under the drum is what caps it; the measured OEM drum sets the final number and the body height follows it in the model. |
| Frame | 40 series T-slot aluminum extrusion (8 mm slot) as the default. Bolted steel angle is the documented alternative for a builder who cannot get extrusion. No welding anywhere. |
| Panels | Laser-cut flat stock, bolted to the frame with no bends. 1.5 mm steel outside, 1.0 to 1.5 mm inside. Where a bend is unavoidable, it is drawn for an online cut-and-bend service and a flat-and-bolted version is also drawn. |
| Heat module bay | The cabinet base below the drum, full width and depth, about 300 mm high. Tray rails, the riser's hood, the blower outlet flange, the louvered inlets, the gas and condensate entries, and the cord's bushing live here; the common power module stands above it, behind the rear bulkhead (draft 7). The rear lower panel comes off to slide a tray in or out (draft 6: the drive sits on the centre line in front of the tray, so the tray leaves by the back, under the riser's hood). |
| Air path, vented | Louvers, heat module, riser duct up the back, rear bulkhead inlet, drum, front lint filter, blower at the base front, exhaust duct through the base, rear port. |
| Air path, heat pump | Blower, return duct, heat module (evaporator then condenser), riser, drum, lint filter, blower. Rear port blanked. |
| Lint management | The lint filter is upstream of the blower and reachable from the front without tools: a basket (draft 8) of stainless 18 x 16 mesh wrapped round two laser-cut 3 mm sector plates between radius 239.5 and 265.5, 35.6 degrees each side of straight down (`drawings/basket-far-plate.dxf`, `basket-lip-plate.dxf`), a lip on the drum side of the front bulkhead with an opening the size of the basket and a 64 wide tab reaching into the door opening, and a closed far end 2 mm behind the lint box's front plate; the mesh's edges fold 5 mm (outward at the lip, inward at the far end) and two 1.5 mm clamp plates hold them on six M3 x 5 button heads into the tapped plates at each end. It passes through the curved slot (radius 238 to 267) with 0.9 mm each side; its outer wall faces down into the box (9060 mm2 inside the box, above the 8171 mm2 exhaust). A catalog 64 mm D-pull on the lip's tab, two M4 x 10 from the tab's back, sits at the bottom of the throat: open the door, pull the basket 40 mm back into the drum (the lip's outer radius 268.5 rides inside the rings' 540 bore), lift it out through the door. The base is sealed from the drum compartment except through the riser and the lint box, so lint does not collect around a burner or a compressor. The failure-mode guide has a lint inspection schedule. |
| Drum | Made from a wrapped laser-cut 304 sheet on two laser-cut rings, 620 mm diameter by 550 mm long (about 165 L), 35 mm to each side panel. Section 7b. |
| Drum support | Four catalog dryer drum rollers on shoulder screws through the bulkheads, two on each bulkhead, 32 degrees each side of bottom, running on the sheet's outer surface where the rings back it; two nylon glides on each bulkhead at 10 and 2 o'clock take the drum's end thrust (7b). |
| Drum seals | Felt strip glued to the bulkheads in two arcs round the glides, riding on the ring faces, replaceable with the front panel off. |
| Drive | Belt drive through a countershaft (`DECISIONS.md` 2026-11-09): catalog J-section poly-V sheaves and belts in standard lengths, a catalog flat idler on a spring, a stock NEMA 56 motor, two pillow block bearings. Every part from two or more makers. |
| Blower | Catalog blower wheel and housing set, 1/2 in bore, on the motor's front shaft, inlet facing front, fed from the lint box through the spool (7a Air), the housing hung on the blower plate (7a Drive, draft 9) and discharging through its 102 collar into the catalog 4 in exhaust pipe (7a Air). The thermal fuse TF2 and the cycling thermostats T_HI and T_LO sit on its outlet box at X 130, 180 and 230 (envelopes, the kit's screws; draft 8). The motor's two cradle brackets take two M6 x 12 each through the base pan, nuts on their feet (draft 8); the air-proving switch PS1 stands on a 60 mm 20x20x2 angle bracket on the pan at X 250, Y 70, two M6 through the pan and two M4 into the switch (envelope); its tap is a barb fitting on the exhaust pipe's top at Y 300 with a 6 mm tube over the thermostats (draft 9; the setpoint is V-205). |
| Door | Laser-cut ring, a glass or stainless panel, a catalog hinge, a catalog latch, and the door switch. Opens past 90 degrees. |
| Console | Part of the cabinet, carrying the UCI-D aperture (560 x 120, draft 8): a box on its own small frame across the rear of the top (7a), sized to the UCI-D envelope so any module in the family fits without touching the chassis. |
| Feet | Four catalog M8 leveling feet (50 mm pad), screwed into the posts' tapped centre bores through 8.5 holes in the base pan; 18 mm from the floor to the pan with the feet run in, which leaves 3 mm under the cord where it runs under the pan. |
| Access | Door open: lint basket. Front upper panel off: drum front, front felt and glides, front rollers and their nuts, belt, lint box, throat liner, door switch, the moisture bar set's nuts and terminals. Rear lower panel off: heat module tray (out the back under the riser's hood), heat module terminals and contactor, cord bushing, motor, pulley, idler and belt tension, blower, exhaust thermostats, PS1 and its tube, the exhaust pipe and its clamps, the two blanks. Rear upper panel off: common power module (every terminal, fuse and relay; the cover comes off its four standoffs for the mains rails), rear felt and glides, rear roller nuts, riser trunk and nozzle. Front lower panel off: blower inlet, spool, lint box back plate and the exhaust thermistor on it, the blower plate and its feet, the cable clamps. Nothing needs two panels off at once. |
| Tolerances | Laser-cut and drill-press tolerances. Nothing tighter than plus or minus 0.5 mm without a reason in `DECISIONS.md`. |

## 8. Fastener budget

The charter allows four fastener sizes per appliance. The dryer's four:

| Size | Head | Tool | Used for |
| --- | --- | --- | --- |
| M8 | Hex | 13 mm socket | Frame joints with T-nuts, leveling feet, the roller studs' nuts; M8 x 20 button heads (5 mm key) hang the lint box on the front stubs' tapped end bores (draft 8) |
| M6 | Hex | 10 mm socket | Panels to frame, brackets, the power module plate to the cross rails, bonding studs, door hinge, the motor cradles, the PS1 bracket and the blower plate's feet through the base pan |
| M4 | Button head, hex socket | 2.5 mm hex key | Drum tabs and seam, door ring, hinge lift-off halves, control faceplate, DIN rails, the heat module tray and box (into the 2020 rails' T-nuts and the angles), the power module's rails, standoffs, barrier and cover, drum glides, every duct plate into its bars' tapped edges (M4 x 8, x 10 through the bulkheads and foam, x 40 through the lint box's bottom bar), the door switch, the basket's pull, the exhaust thermostats, the blower plate (x 8 into the housing and the feet), the moisture bar set (x 16, draft 9), the exhaust thermistor (x 20), the entry blanks, the cable clamps, small brackets |
| M3 | Button head, hex socket | 2 mm hex key | The throat liner's splice (M3 x 6, nuts), the lint basket's clamp plates (M3 x 5 into tapped 3 mm plates); PCB standoffs inside control modules |

Nylon lock nuts or thread locker on anything that vibrates (motor, blower housing, idler, compressor tray). T-nuts for the extrusion. No rivets, no self-tappers into plastic, no snap fits on anything that opens.

Head types in the model, draft 7: hex head M6 x 12 with washers on every panel, on the power module plate and in the console frame's brackets; button head M4 x 8 inside the drum (7b), on the door ring, the tray rails' brackets, the heat module (64) and the power module (22), M4 x 8 and x 10 at the drum glides, M4 x 10 on the faceplate and the hinge lift-off halves, button head M6 x 12 at the baffles; countersunk M6 x 16 at the fixed hinge halves, where a proud head would foul the door; ISO 7379 shoulder screws 10 x 35 M8 at the rollers (a 5 mm hex key, their nuts a 13 mm socket). Every M4 is a button head with a 2.5 mm hex socket (`DECISIONS.md` 2026-11-06): one head type, one key, no washer under the small heads inside the drum. The countersunk screws take a 4 mm key. The service set is therefore the charter's four tools plus 2.5, 4 and 5 mm hex keys. Draft 7 moves the tray, the heater box and the power module from the M6 line of draft 2 to M4: the 2020 tray rails have a 6 mm slot, and a 20 mm angle leg or a 1.5 mm box wall has no use for an M6 (`DECISIONS.md`).

If a bought part comes with its own imperial screws (the spring timers come with 6-32, for example), they are used as supplied and listed in the BOM as "supplied with part".

Charter note: the fastener rule says hex head or socket head, which the button heads are. The charter's service set (10 and 13 mm sockets, a Phillips driver, a multimeter) is a target; this appliance adds two hex keys to it and keeps the Phillips driver for the M3 pan heads inside control modules and for whatever bought parts bring (the timers' 6-32 yoke screws, for example). Recorded in `DECISIONS.md`.

## 9. Performance targets

To be measured on the first build, not promised.

| Item | Target |
| --- | --- |
| Airflow at the exhaust, clean filter, 2 m of straight 102 mm duct, vented builds | 2.5 to 4 m3/min (about 90 to 140 cfm, since blowers are sold that way) |
| Exhaust temperature, electric and gas, high heat, steady state | 60 to 70 °C, set by the high cycling thermostat |
| Exhaust temperature, electric and gas, low heat | 50 to 60 °C, set by the low cycling thermostat |
| Heat input, gas | About 6 kW (20,000 to 22,000 BTU/h, since burners are sold that way) |
| Heat pump loop temperature and compressor power | Unknown until a unit is chosen; typical commercial units run the drum air at 50 to 60 °C on 400 to 700 W of compressor |
| Dry time, 4 kg cotton load from a spin-dried washer | Electric and gas, high heat: 45 to 60 min. Heat pump: 2 to 3 h. None: not a target. |
| Drum speed | 45 to 55 rpm |
| Noise | Not specified. A frame with no thin sheet metal to resonate should be quieter than a commercial dryer; measure and report. |

## 10. What the dryer will not do

- Steam, drum reversal, sanitize cycles, or any function that needs a part the appliance market does not already sell for a basic dryer. A later revision may add any of these through the reserved UCI-D pins.
- Lock the door. Opening the door stops the machine, and that is the whole of the door's safety story.
- Run two heat modules at once (no hybrid heat pump with a booster element). One tray, one module.
- Use an inverter-driven compressor, or any refrigeration circuit that is not bought sealed and charged.
- Anything that needs an account or the internet.

## 11. Open questions for the CAD and electrical phases

Decided in draft 3 and logged in `DECISIONS.md`: the drum (made by the builder from a wrapped sheet on laser-cut rings), the motor (dual-shaft NEMA 48), the drum support (four catalog rollers), the bay height (300, fixed by the drum and the overall height), the riser and lint duct (laser-cut and bolted sheet, drawings to follow the measured parts).

Still open:

1. The drum wrap: roundness at mid-length and the sheet thickness, answered by the cheap-material wrap at V-208 before the stainless is cut.
2. Air proving. Pressure switch against sail switch, tap location, setpoint, lint behavior. V-205 is the bench test; the setpoint cannot be reasoned out.
3. The gas burner assembly family and the heat pump sealed unit, both outside the first build's scope (section 5).
4. Settled in drafts 8 and 9: the ducts are plates on flat bar frames with foam where they meet a part they are not screwed to, the exhaust is a catalog pipe over the housing's collar with two clamps. What still waits on the bought housing (V-107) is its screw pattern on the blower plate and where its collar really sits.
5. Settled in drafts 8 and 9: the motor sits in its kit's cradles on four M6 through the pan; the housing hangs on the blower plate. The plate's screw holes are drilled from the housing in hand.

## 12. Needs a real-world check

- Every rating and typical value quoted for appliance-market fuses, thermostats, burners, and heat pump units anywhere in this repo. They are typical of the US parts market and have not yet been read off a datasheet for a specific part.
- The 30 A circuit and the 14-30 plug are the US norm for an electric dryer, and 15 A on 5-15 for gas and most heat pump dryers. The builder is responsible for their own circuit, receptacle, gas supply, and local code, and the build guide says so.
- Whether an auto-reset high-limit is acceptable under the builder's local code reading, or whether a manual-reset one is wanted. Both are catalog.
- The 20-year contactor life claim in section 3.3, against the chosen contactor's datasheet.
- A listed door switch with a motor-rated contact and a second contact, available from two makers (see `controls/uci-spec.md` section 13).
- Whether the no-heat build needs any airflow interlock at all, and whether leaving the heat-enable chain unfitted changes anything in commissioning.
- The exhaust thermistor and the moisture bar set are drawn as envelopes of appliance-market parts; the bought parts' footprints, slots and screw holes (V-112) set the final cut in the lint box's back plate and the front bulkhead.
- Gas: the legal position on connecting gas appliances where the builder lives, before any gas parts are bought.
