OpenSourceAppliances/dryer/mechanical/cad/audit/fusion-screens/02-inside-iso-panels-hidden.jpg

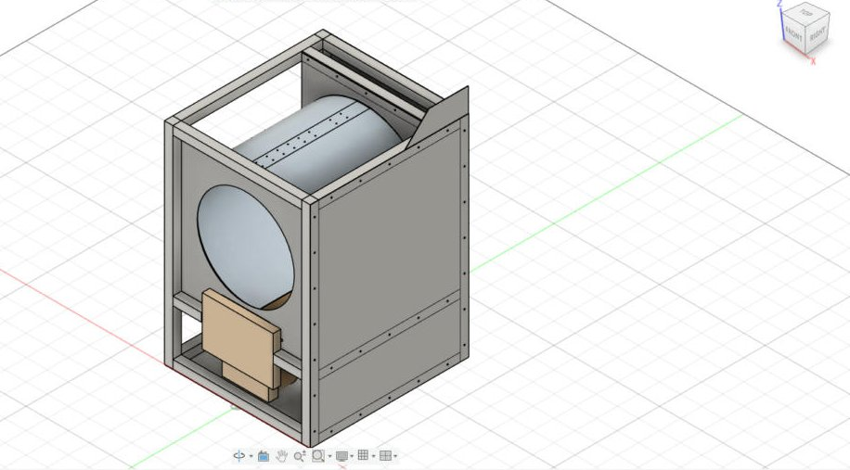
mechanical/cad/audit/fusion-screens/02-inside-iso-panels-hidden.jpg
