OpenSourceAppliances/dryer/mechanical/cad/audit/fusion-screens/03-inside-left-panels-hidden.jpg

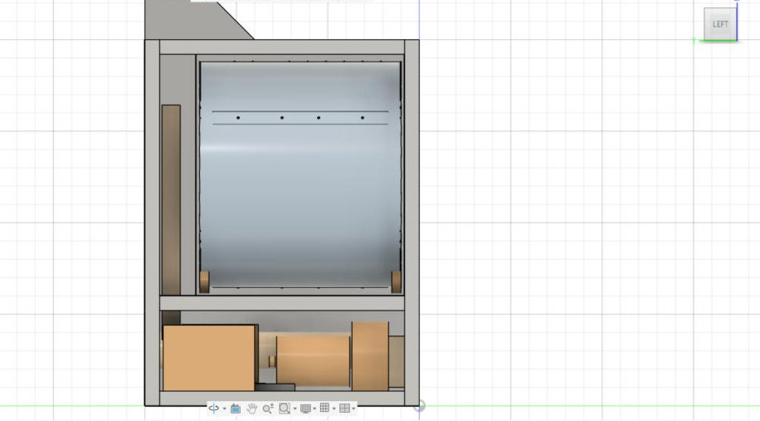
mechanical/cad/audit/fusion-screens/03-inside-left-panels-hidden.jpg
