OpenSourceAppliances/dryer/mechanical/cad/audit/fusion-screens/04-front.jpg

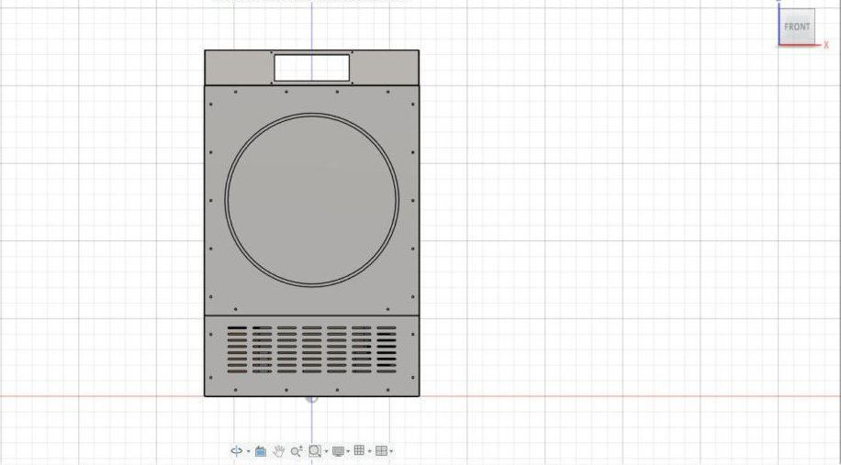
mechanical/cad/audit/fusion-screens/04-front.jpg
