OpenSourceAppliances/dryer/mechanical/cad/audit/fusion-screens/05-left.jpg

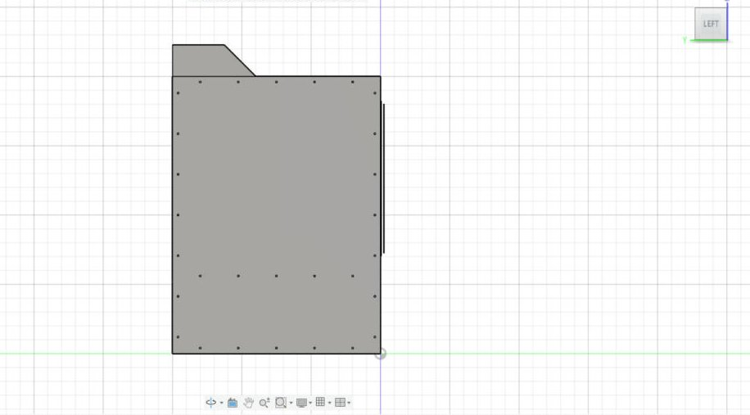
mechanical/cad/audit/fusion-screens/05-left.jpg
