OpenSourceAppliances/dryer/mechanical/cad/audit/fusion-screens/07-top.jpg

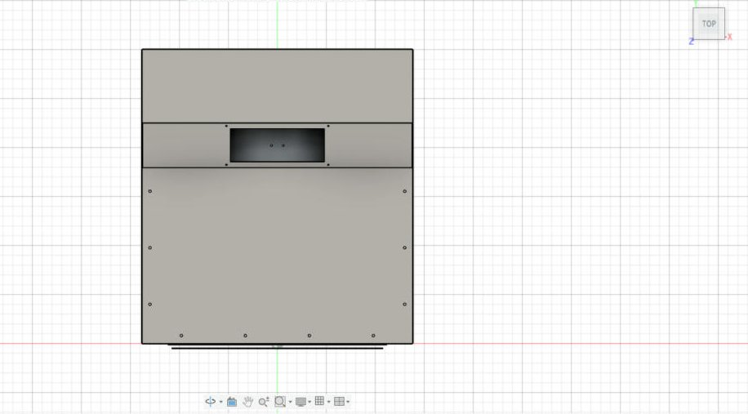
mechanical/cad/audit/fusion-screens/07-top.jpg
