OpenSourceAppliances/dryer/mechanical/cad/audit/fusion-screens/10-drum-diameter-620.jpg

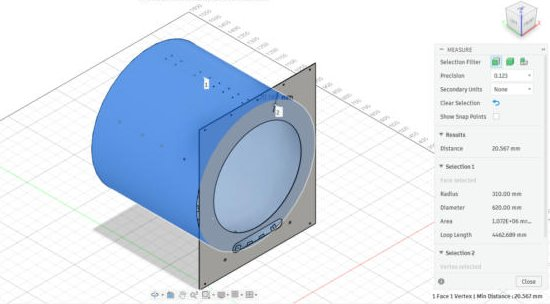
mechanical/cad/audit/fusion-screens/10-drum-diameter-620.jpg
