OpenSourceAppliances/dryer/mechanical/cad/audit/fusion-screens/10b-drum-diameter-620-dialog.jpg

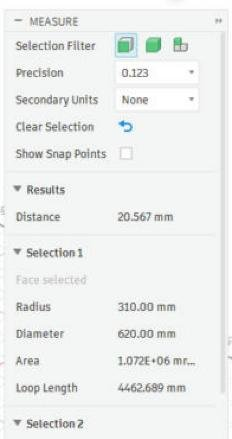
mechanical/cad/audit/fusion-screens/10b-drum-diameter-620-dialog.jpg
