OpenSourceAppliances/dryer/mechanical/cad/audit/fusion-screens/11-drum-to-side-panel-35.jpg

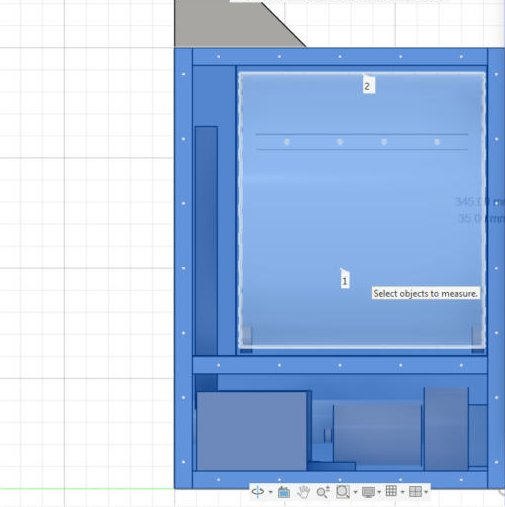
mechanical/cad/audit/fusion-screens/11-drum-to-side-panel-35.jpg
