OpenSourceAppliances/dryer/mechanical/cad/audit/fusion-screens/11b-drum-to-side-panel-35-dialog.jpg

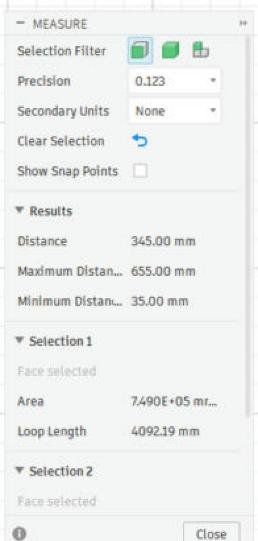
mechanical/cad/audit/fusion-screens/11b-drum-to-side-panel-35-dialog.jpg
