OpenSourceAppliances/dryer/mechanical/cad/audit/fusion-screens/12-drum-to-front-bulkhead-7p7.jpg

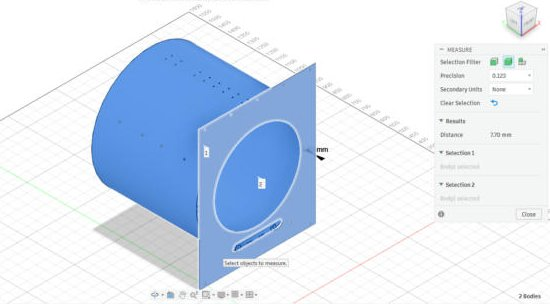
mechanical/cad/audit/fusion-screens/12-drum-to-front-bulkhead-7p7.jpg
