OpenSourceAppliances/dryer/mechanical/cad/audit/fusion-screens/12b-drum-to-front-bulkhead-7p7-dialog.jpg

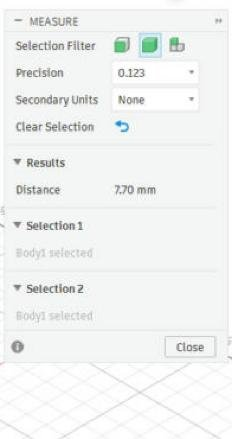
mechanical/cad/audit/fusion-screens/12b-drum-to-front-bulkhead-7p7-dialog.jpg
