OpenSourceAppliances/dryer/mechanical/cad/audit/fusion-screens/13-drum-to-rear-bulkhead-9p2.jpg

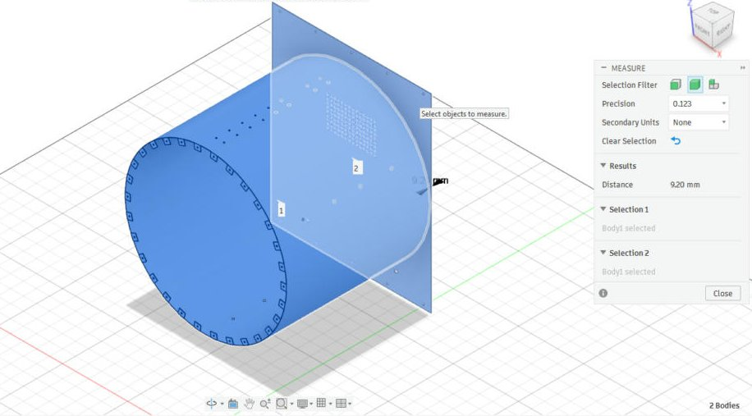
mechanical/cad/audit/fusion-screens/13-drum-to-rear-bulkhead-9p2.jpg
