OpenSourceAppliances/dryer/mechanical/cad/audit/fusion-screens/14-drum-to-bay-ceiling-20.jpg

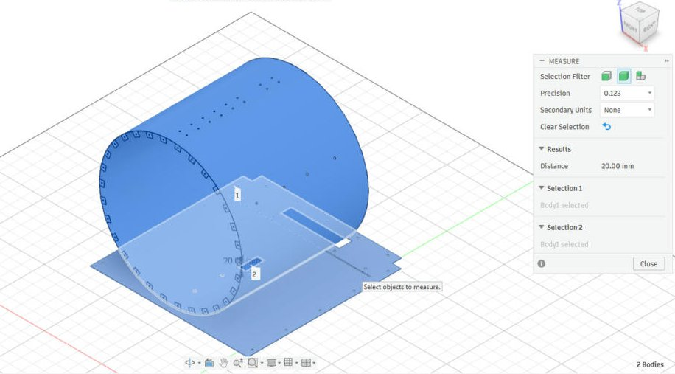
mechanical/cad/audit/fusion-screens/14-drum-to-bay-ceiling-20.jpg
