OpenSourceAppliances/dryer/mechanical/cad/audit/fusion-screens/15-drum-to-roller-0.jpg

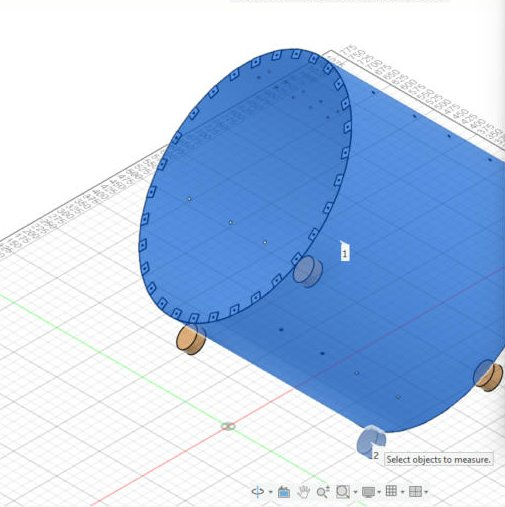
mechanical/cad/audit/fusion-screens/15-drum-to-roller-0.jpg
