OpenSourceAppliances/dryer/mechanical/cad/audit/fusion-screens/15b-drum-to-roller-0-dialog.jpg

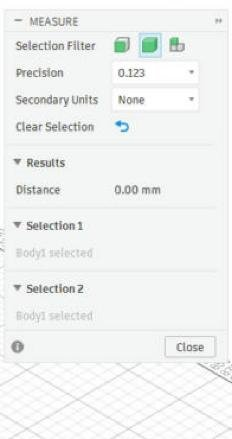
mechanical/cad/audit/fusion-screens/15b-drum-to-roller-0-dialog.jpg
