OpenSourceAppliances/dryer/mechanical/cad/audit/fusion-screens/16-lint-duct-to-stub-2.jpg

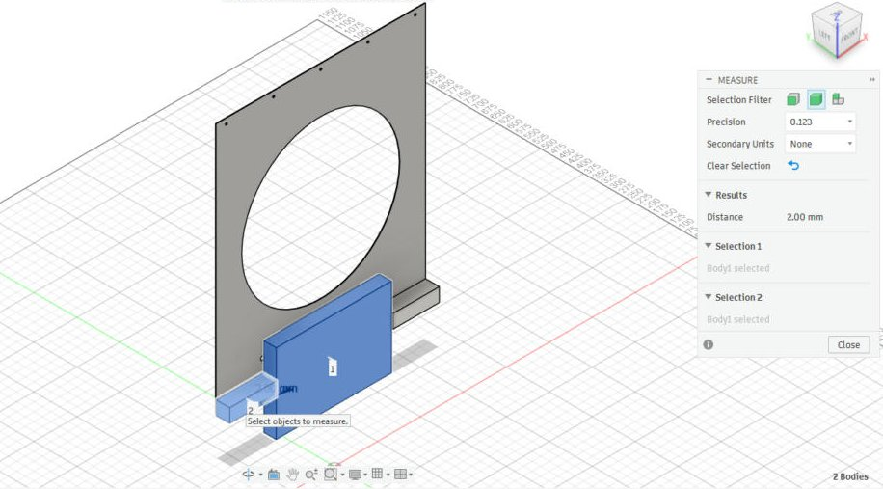
mechanical/cad/audit/fusion-screens/16-lint-duct-to-stub-2.jpg
