OpenSourceAppliances/dryer/mechanical/cad/audit/fusion-screens/17-door-opening-460.jpg

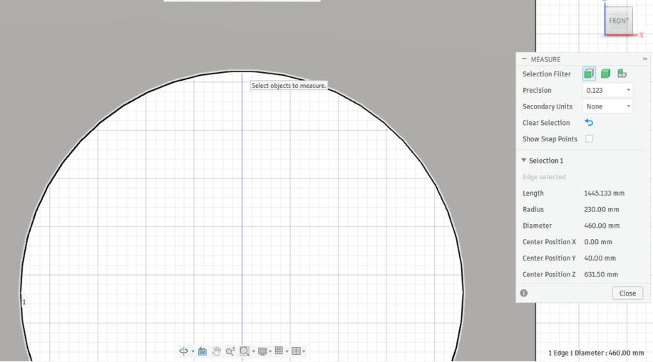
mechanical/cad/audit/fusion-screens/17-door-opening-460.jpg
