OpenSourceAppliances/dryer/mechanical/cad/audit/fusion-screens/18-roller-shaft-hole-10p5.jpg

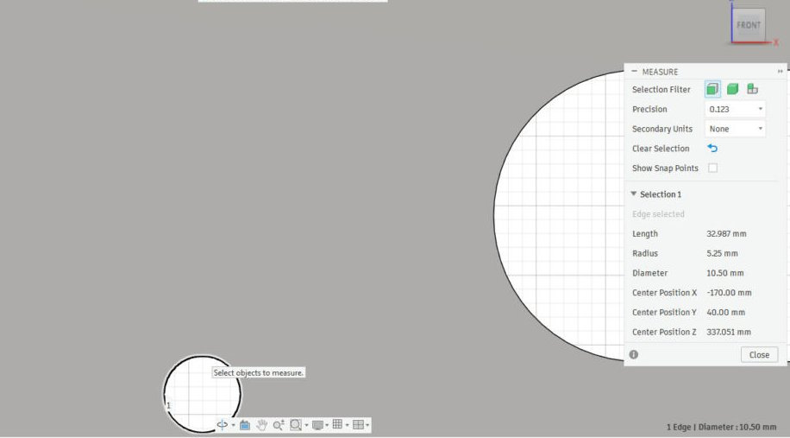
mechanical/cad/audit/fusion-screens/18-roller-shaft-hole-10p5.jpg
