OpenSourceAppliances/dryer/mechanical/cad/audit/fusion-screens/19-lint-slot-straight-edge-220.jpg

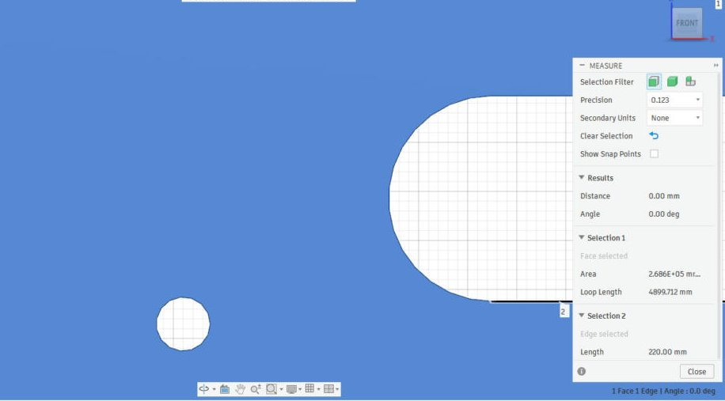
mechanical/cad/audit/fusion-screens/19-lint-slot-straight-edge-220.jpg
