OpenSourceAppliances/dryer/mechanical/cad/audit/fusion-screens/20-lint-slot-end-r20.jpg

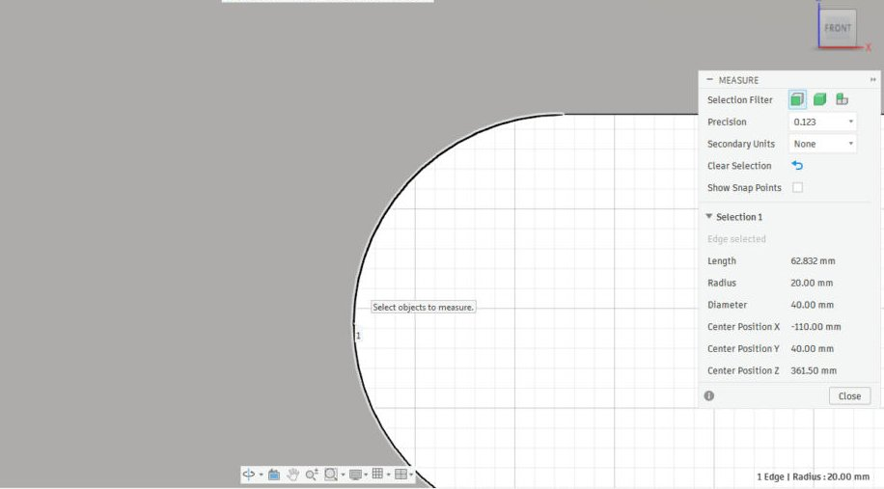
mechanical/cad/audit/fusion-screens/20-lint-slot-end-r20.jpg
