OpenSourceAppliances/dryer/mechanical/cad/audit/fusion-screens/21-cabinet-width-690.jpg

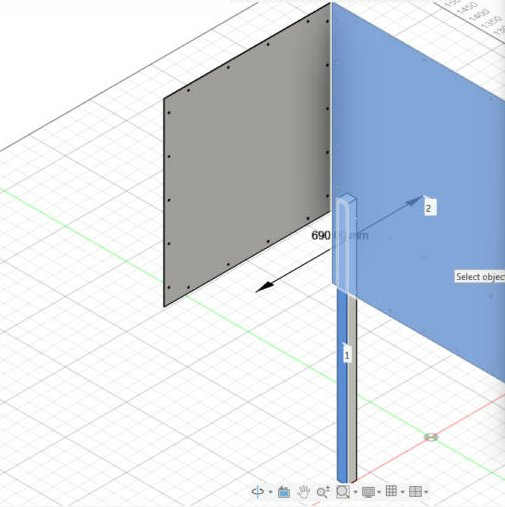
mechanical/cad/audit/fusion-screens/21-cabinet-width-690.jpg
