OpenSourceAppliances/dryer/mechanical/cad/audit/fusion-screens/21b-cabinet-width-690-dialog.jpg

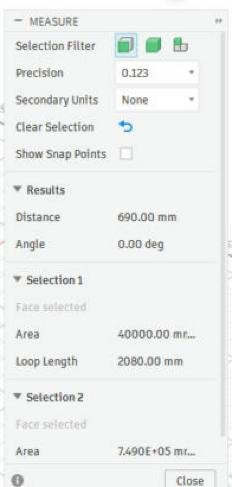
mechanical/cad/audit/fusion-screens/21b-cabinet-width-690-dialog.jpg
