OpenSourceAppliances/dryer/mechanical/cad/audit/fusion-screens/22-cabinet-depth-750-post-1000.jpg

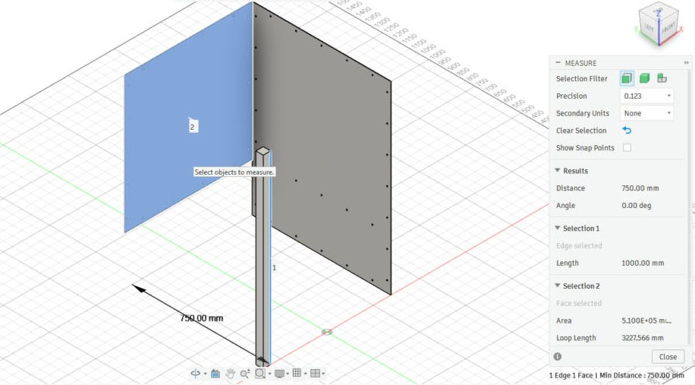
mechanical/cad/audit/fusion-screens/22-cabinet-depth-750-post-1000.jpg
