OpenSourceAppliances/dryer/mechanical/cad/audit/fusion-screens/23-cabinet-height-1001p5.jpg

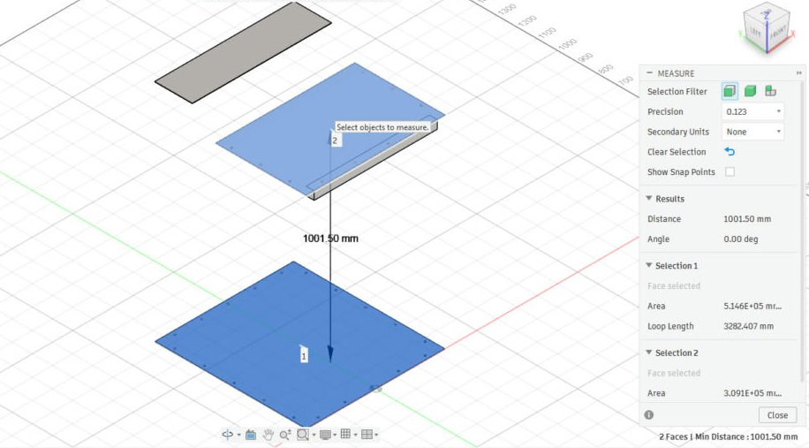
mechanical/cad/audit/fusion-screens/23-cabinet-height-1001p5.jpg
