OpenSourceAppliances/dryer/mechanical/cad/audit/fusion-screens/24-console-cap-113p137.jpg

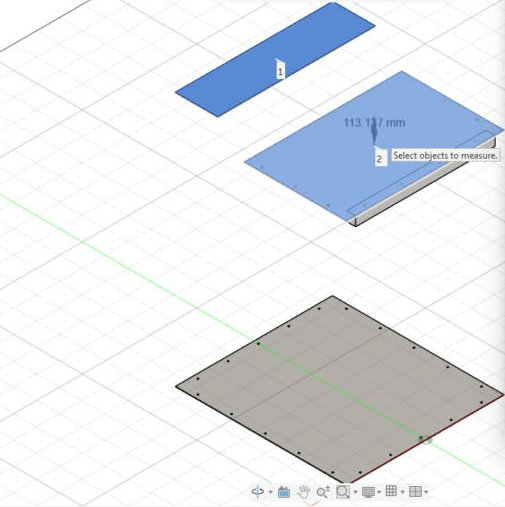
mechanical/cad/audit/fusion-screens/24-console-cap-113p137.jpg
