OpenSourceAppliances/dryer/mechanical/cad/audit/fusion-screens/25-uci-aperture-edge-240-face-area.jpg

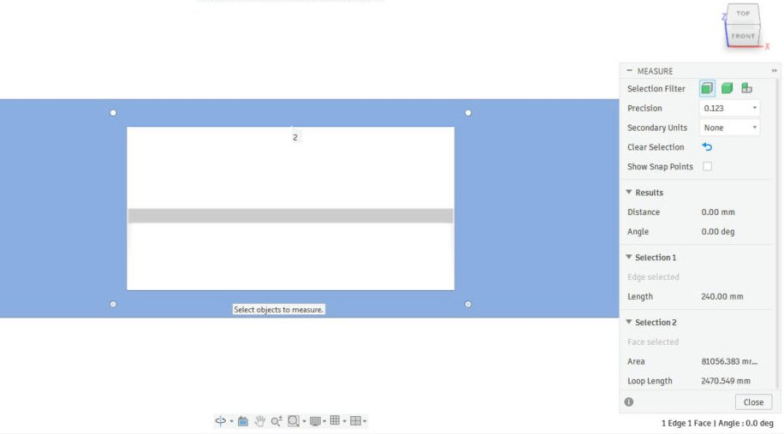
mechanical/cad/audit/fusion-screens/25-uci-aperture-edge-240-face-area.jpg
