OpenSourceAppliances/dryer/mechanical/cad/audit/fusion-screens/27-uci-m4-hole-4p5.jpg

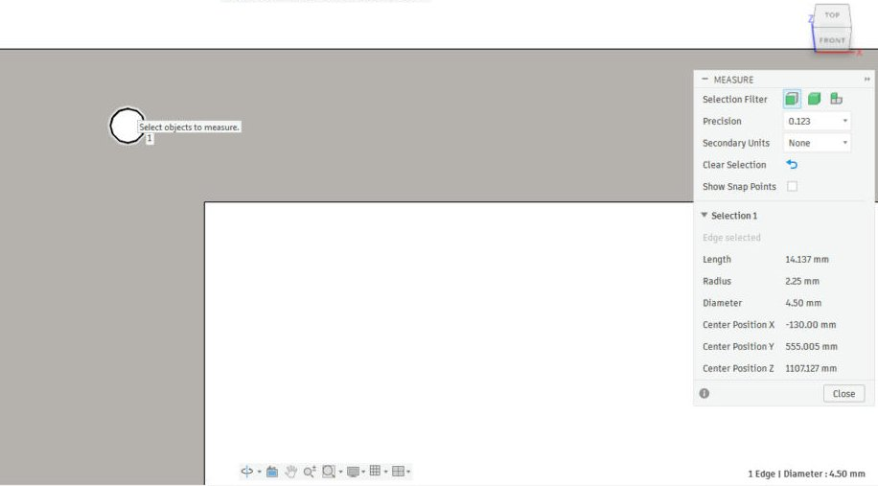
mechanical/cad/audit/fusion-screens/27-uci-m4-hole-4p5.jpg
