OpenSourceAppliances/dryer/mechanical/cad/audit/fusion-screens/28-exhaust-port-106.jpg

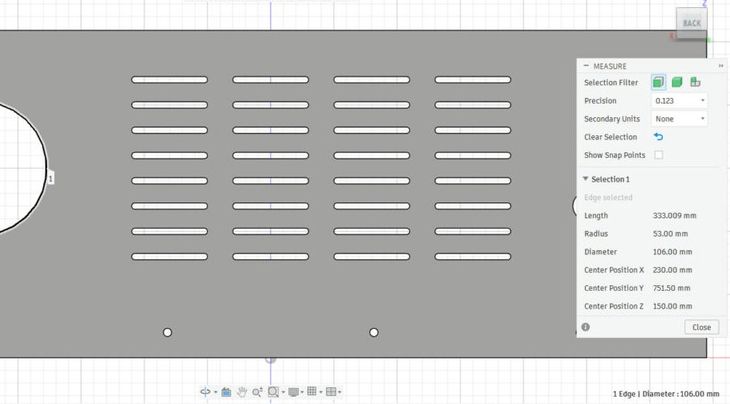
mechanical/cad/audit/fusion-screens/28-exhaust-port-106.jpg
