OpenSourceAppliances/dryer/mechanical/cad/audit/fusion-screens/29-cord-hole-22.jpg

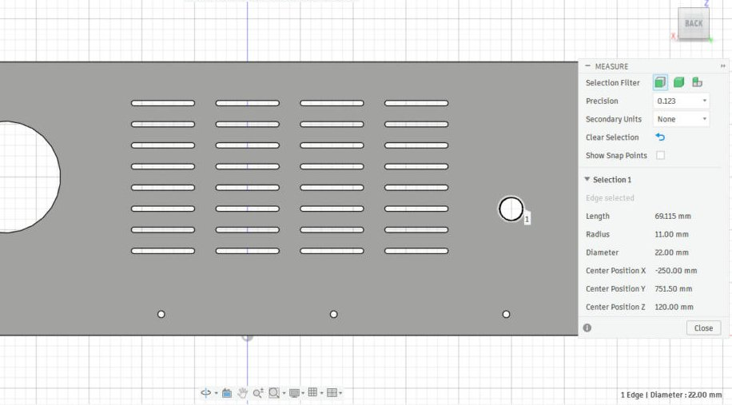
mechanical/cad/audit/fusion-screens/29-cord-hole-22.jpg
