OpenSourceAppliances/dryer/mechanical/cad/audit/fusion-screens/30-bay-ceiling-301p5-slot-612.jpg

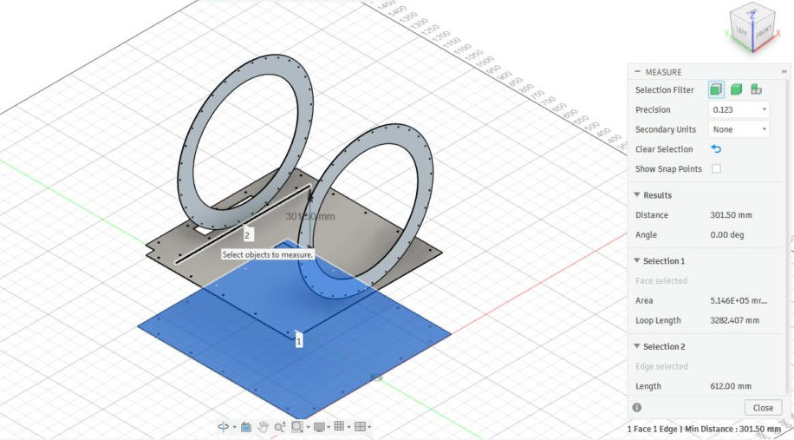
mechanical/cad/audit/fusion-screens/30-bay-ceiling-301p5-slot-612.jpg
