OpenSourceAppliances/dryer/mechanical/cad/audit/fusion-screens/31-rings-618p4-and-548-apart.jpg

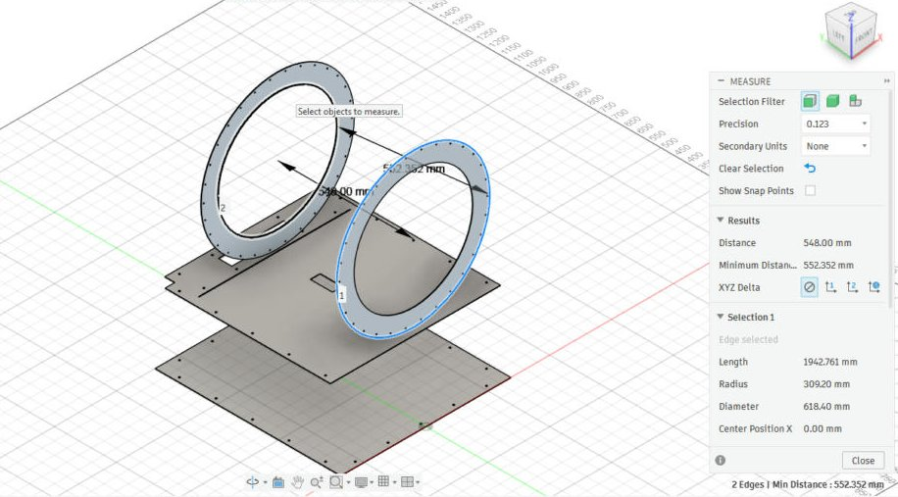
mechanical/cad/audit/fusion-screens/31-rings-618p4-and-548-apart.jpg
