OpenSourceAppliances/dryer/mechanical/cad/audit/fusion-screens/40-draft5-iso-dressed.jpg

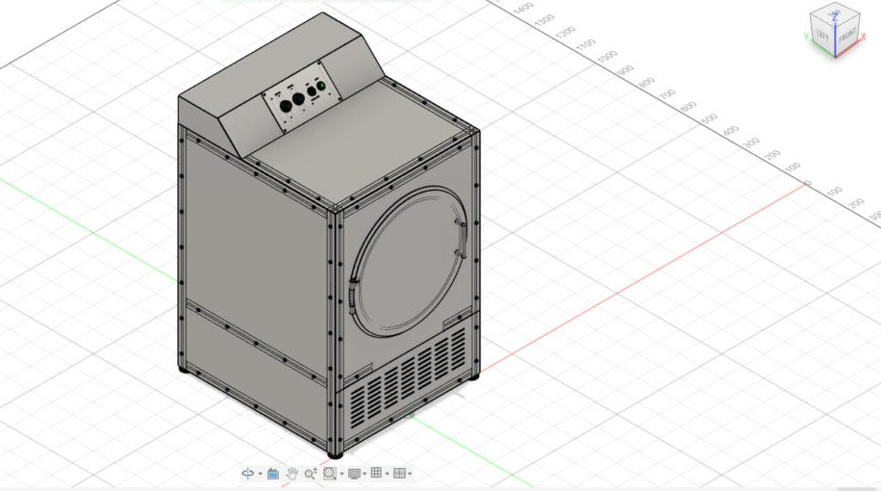
mechanical/cad/audit/fusion-screens/40-draft5-iso-dressed.jpg
