OpenSourceAppliances/dryer/mechanical/cad/audit/fusion-screens/41-draft5-inside-left-top-front-off.jpg

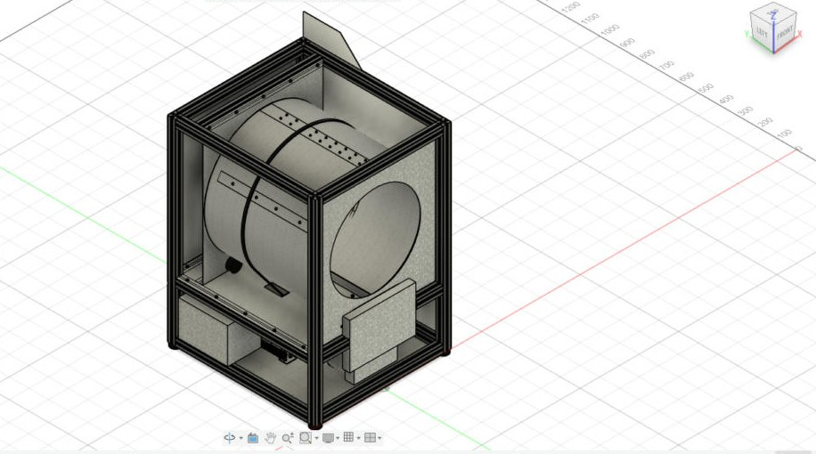
mechanical/cad/audit/fusion-screens/41-draft5-inside-left-top-front-off.jpg
