OpenSourceAppliances/dryer/mechanical/cad/audit/fusion-screens/42-draft5-pose-door-open.jpg

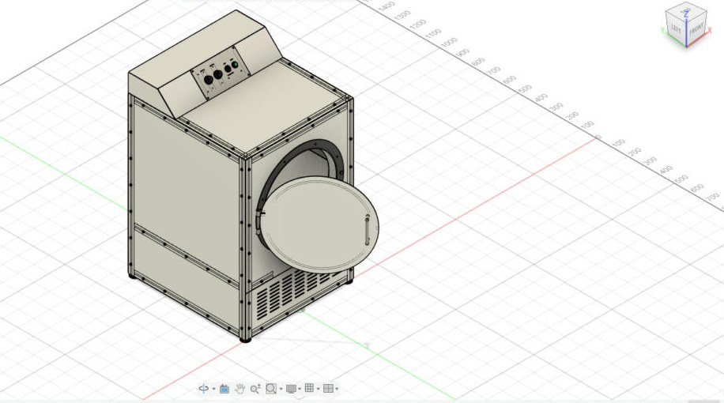
mechanical/cad/audit/fusion-screens/42-draft5-pose-door-open.jpg
