OpenSourceAppliances/dryer/mechanical/cad/audit/fusion-screens/43-draft5-left-side-off-drive-and-belt.jpg

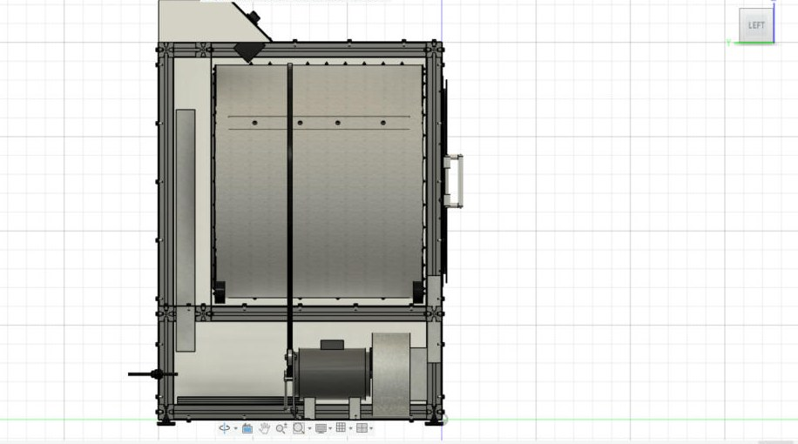
mechanical/cad/audit/fusion-screens/43-draft5-left-side-off-drive-and-belt.jpg
