OpenSourceAppliances/dryer/mechanical/cad/audit/fusion-screens/44-draft5-console-tier0-module.jpg

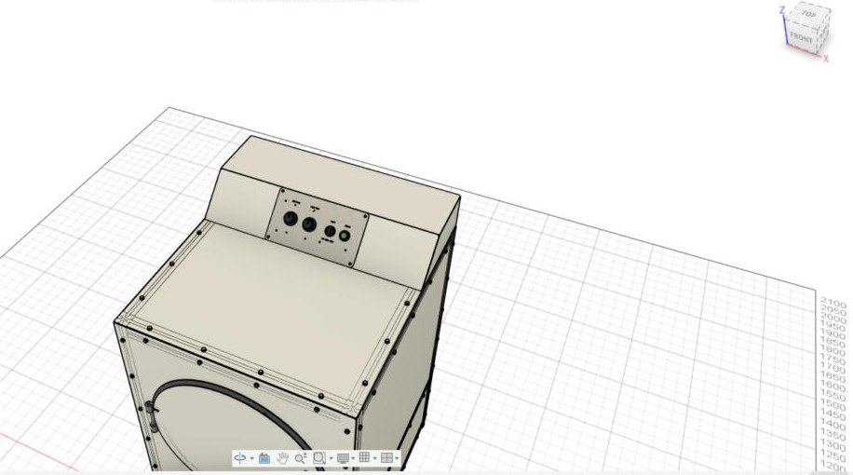
mechanical/cad/audit/fusion-screens/44-draft5-console-tier0-module.jpg
