OpenSourceAppliances/dryer/mechanical/cad/audit/fusion-screens/45-draft6-iso-dressed.jpg

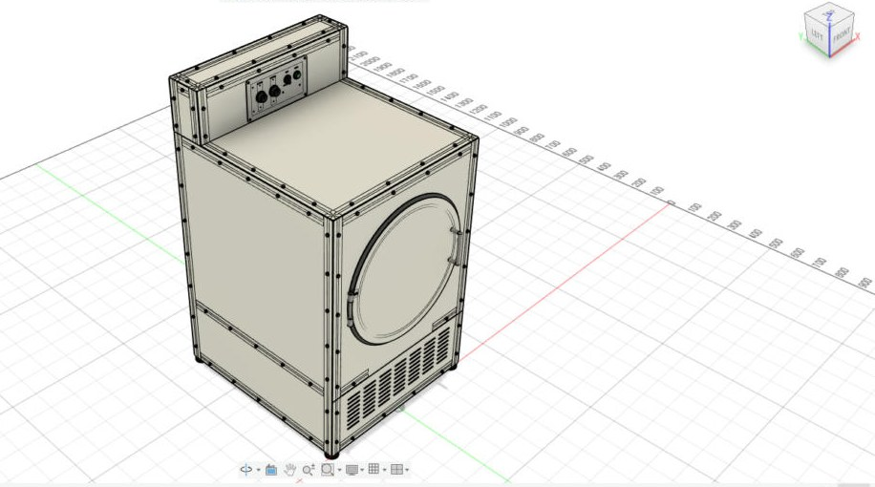
mechanical/cad/audit/fusion-screens/45-draft6-iso-dressed.jpg
