OpenSourceAppliances/dryer/mechanical/cad/audit/fusion-screens/46-draft6-pose-tray-out-the-back.jpg

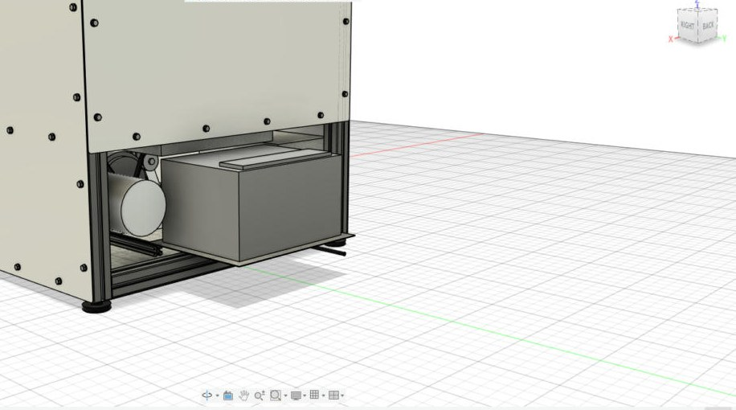
mechanical/cad/audit/fusion-screens/46-draft6-pose-tray-out-the-back.jpg
