OpenSourceAppliances/dryer/mechanical/cad/audit/fusion-screens/47-draft6-inside-right-top-front-off.jpg

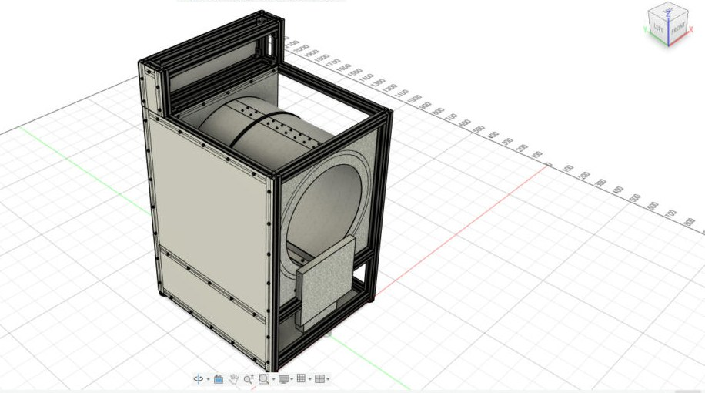
mechanical/cad/audit/fusion-screens/47-draft6-inside-right-top-front-off.jpg
