OpenSourceAppliances/dryer/mechanical/cad/audit/fusion-screens/48-draft6-console-tier0-module.jpg

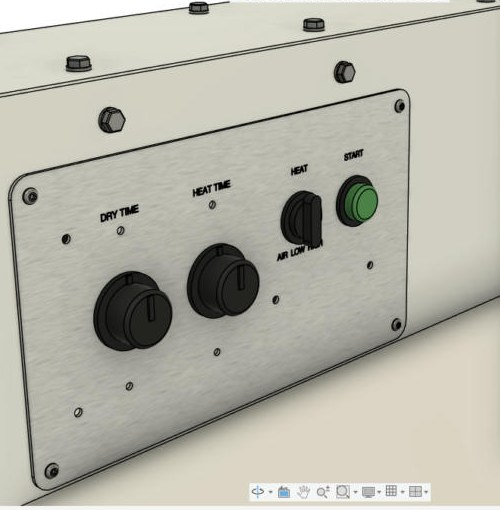
mechanical/cad/audit/fusion-screens/48-draft6-console-tier0-module.jpg
