OpenSourceAppliances/dryer/mechanical/cad/audit/fusion-screens/49-draft6-front-bulkhead-curved-lint-slot.jpg

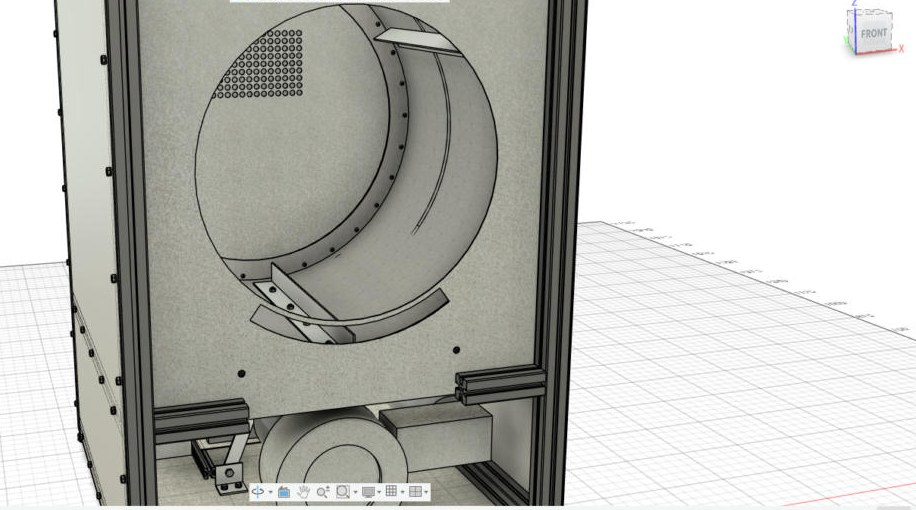
mechanical/cad/audit/fusion-screens/49-draft6-front-bulkhead-curved-lint-slot.jpg
