OpenSourceAppliances/dryer/mechanical/cad/audit/fusion-screens/50-draft6-bay-from-the-back-left.jpg

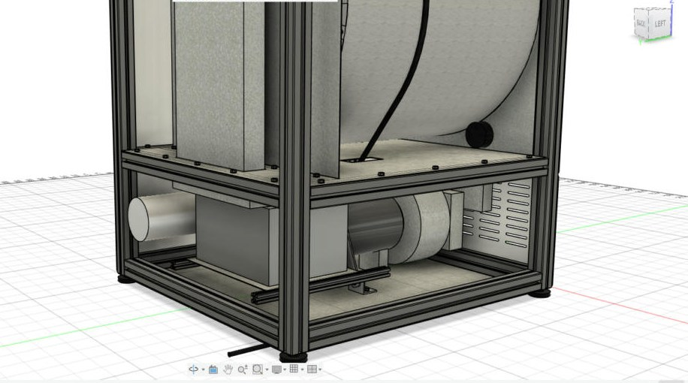
mechanical/cad/audit/fusion-screens/50-draft6-bay-from-the-back-left.jpg
