OpenSourceAppliances/dryer/mechanical/cad/audit/fusion-screens/51-draft7-iso-dressed.jpg

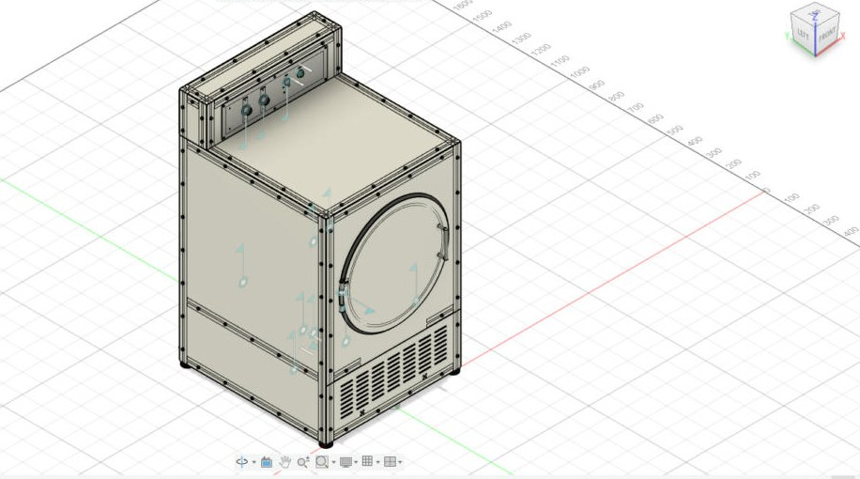
mechanical/cad/audit/fusion-screens/51-draft7-iso-dressed.jpg
