OpenSourceAppliances/dryer/mechanical/cad/audit/fusion-screens/52-draft7-pose-tray-out-the-back.jpg

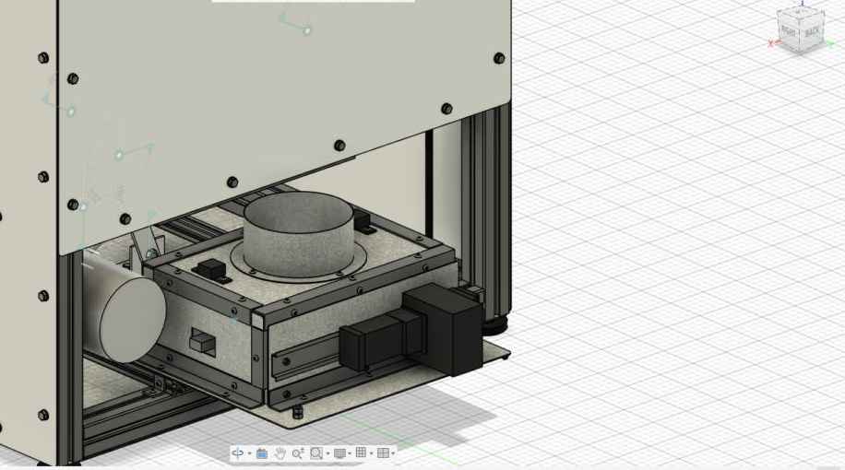
mechanical/cad/audit/fusion-screens/52-draft7-pose-tray-out-the-back.jpg
