OpenSourceAppliances/dryer/mechanical/cad/audit/fusion-screens/53-draft7-back-panels-off-modules.jpg

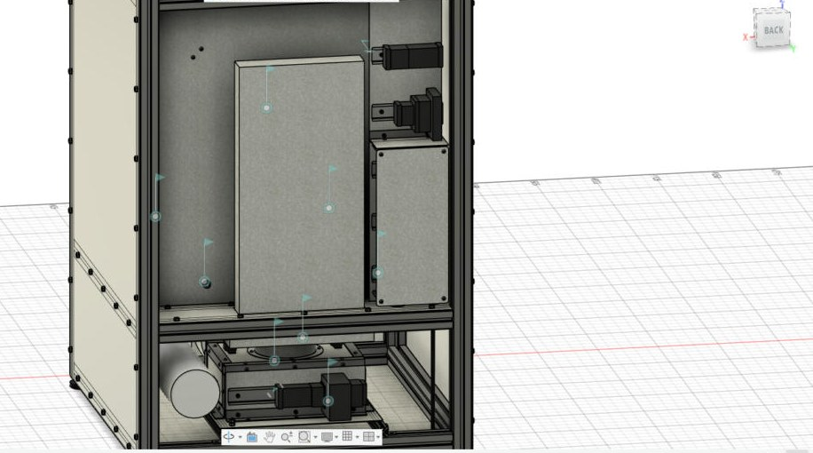
mechanical/cad/audit/fusion-screens/53-draft7-back-panels-off-modules.jpg
