OpenSourceAppliances/dryer/mechanical/cad/audit/fusion-screens/54-draft7-rear-compartment-power-module.jpg

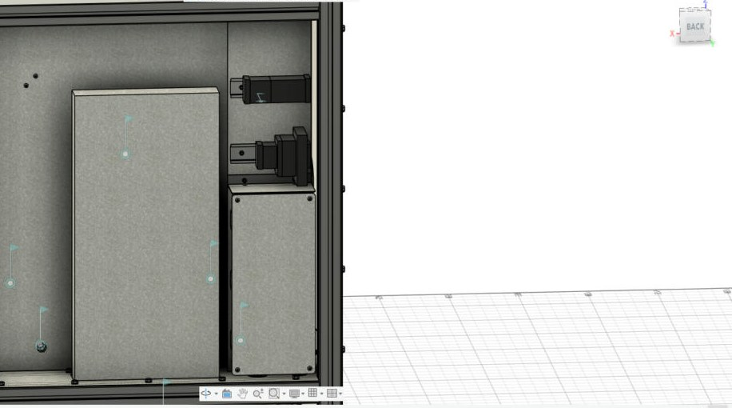
mechanical/cad/audit/fusion-screens/54-draft7-rear-compartment-power-module.jpg
