OpenSourceAppliances/dryer/mechanical/cad/audit/fusion-screens/55-draft7-rear-bulkhead-felt-arcs-glides-rollers.jpg

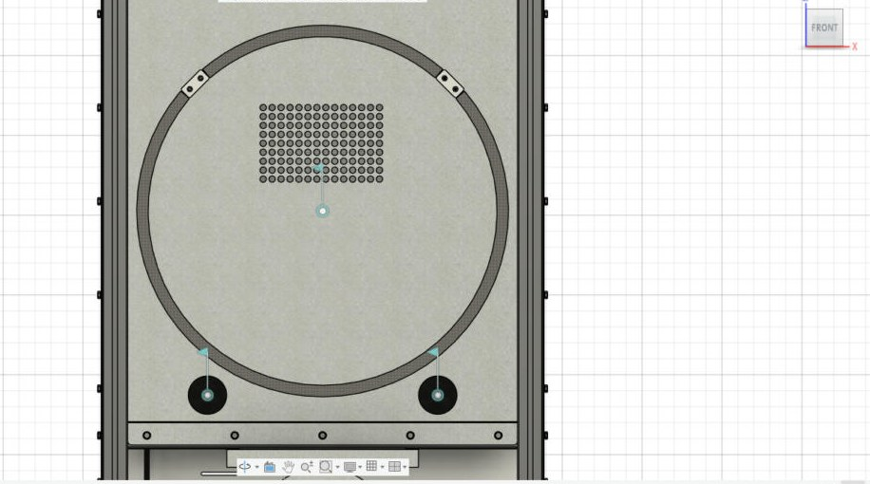
mechanical/cad/audit/fusion-screens/55-draft7-rear-bulkhead-felt-arcs-glides-rollers.jpg
