OpenSourceAppliances/dryer/mechanical/cad/audit/fusion-screens/56-draft7-heat-module-on-its-rails.jpg

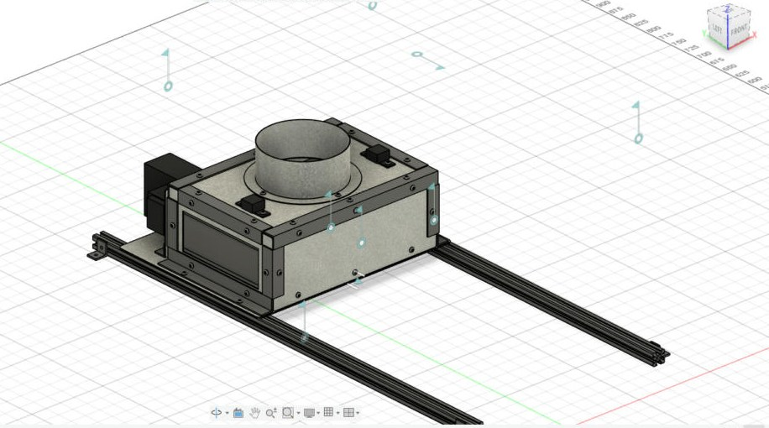
mechanical/cad/audit/fusion-screens/56-draft7-heat-module-on-its-rails.jpg
