OpenSourceAppliances/dryer/mechanical/cad/audit/fusion-screens/57-draft7-heat-module-from-the-back.jpg

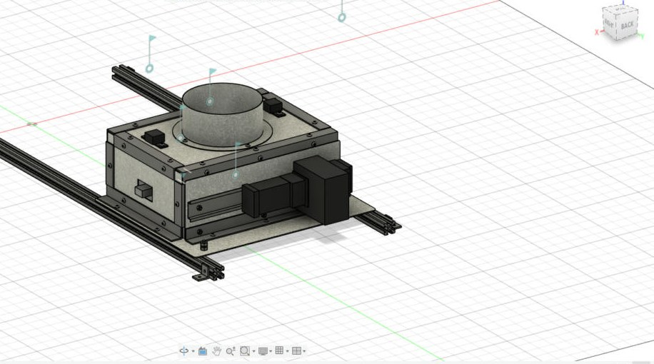
mechanical/cad/audit/fusion-screens/57-draft7-heat-module-from-the-back.jpg
