OpenSourceAppliances/dryer/mechanical/cad/audit/fusion-screens/59-draft8-back-riser-trunk-power-module.jpg

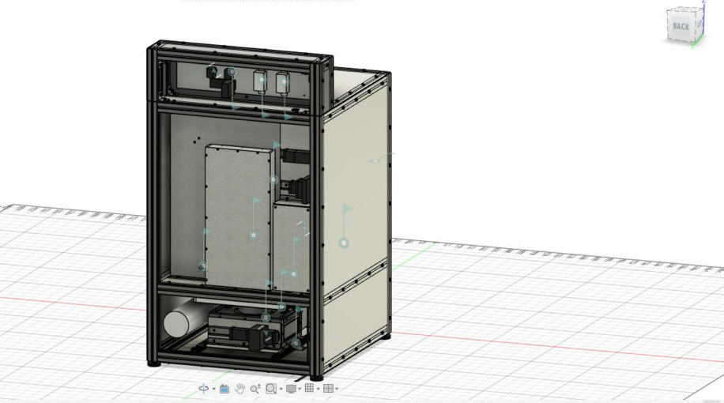
mechanical/cad/audit/fusion-screens/59-draft8-back-riser-trunk-power-module.jpg
