OpenSourceAppliances/dryer/mechanical/cad/audit/fusion-screens/60-draft8-front-lint-box-liner.jpg

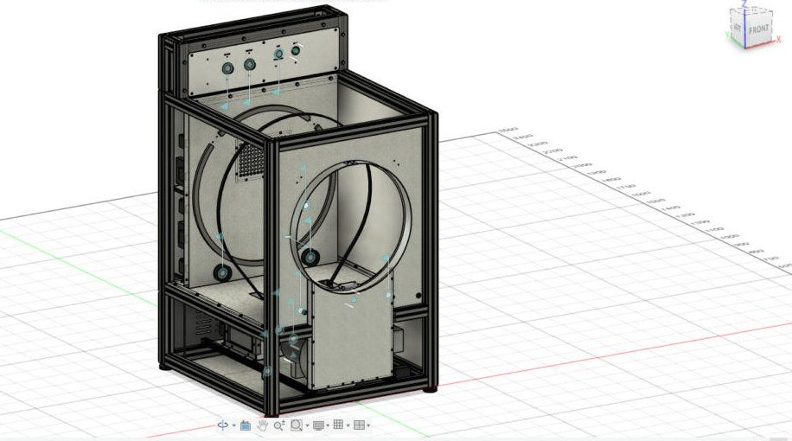
mechanical/cad/audit/fusion-screens/60-draft8-front-lint-box-liner.jpg
