OpenSourceAppliances/dryer/mechanical/cad/audit/fusion-screens/61-draft8-throat-liner-basket-pulled.jpg

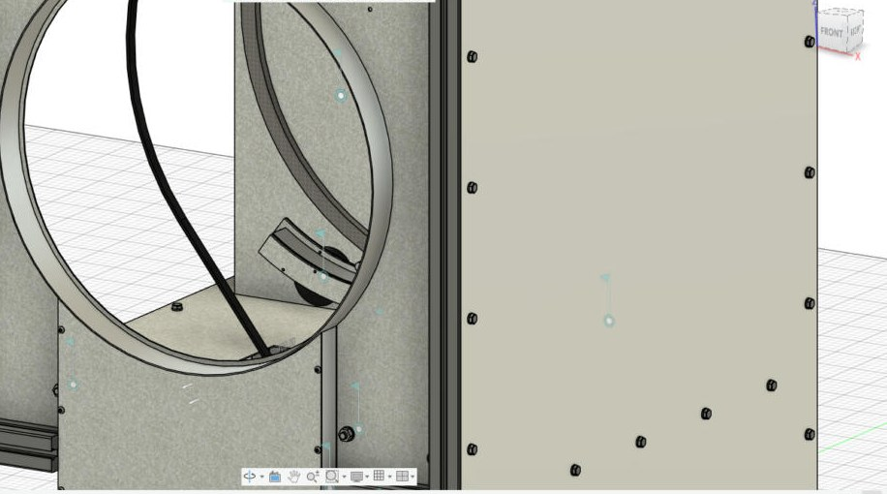
mechanical/cad/audit/fusion-screens/61-draft8-throat-liner-basket-pulled.jpg
