OpenSourceAppliances/dryer/mechanical/cad/audit/fusion-screens/62-draft8-console-faceplate-620.jpg

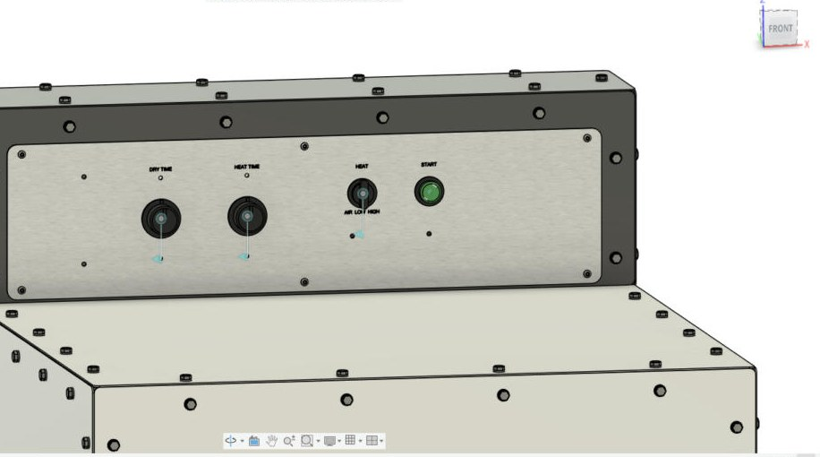
mechanical/cad/audit/fusion-screens/62-draft8-console-faceplate-620.jpg
