OpenSourceAppliances/dryer/mechanical/cad/audit/fusion-screens/63-draft8-bay-blower-exhaust-thermostats.jpg

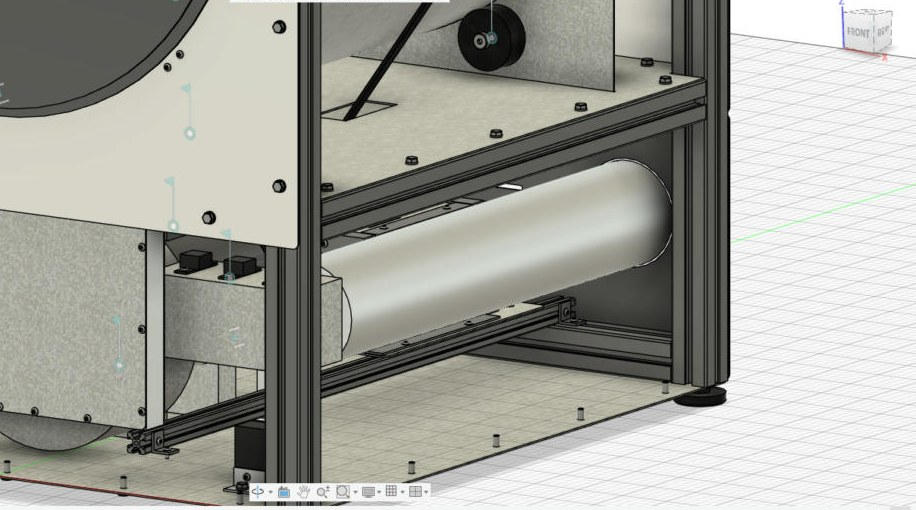
mechanical/cad/audit/fusion-screens/63-draft8-bay-blower-exhaust-thermostats.jpg
