OpenSourceAppliances/dryer/mechanical/cad/audit/fusion-screens/64-draft8-riser-trunk-from-the-rear-right.jpg

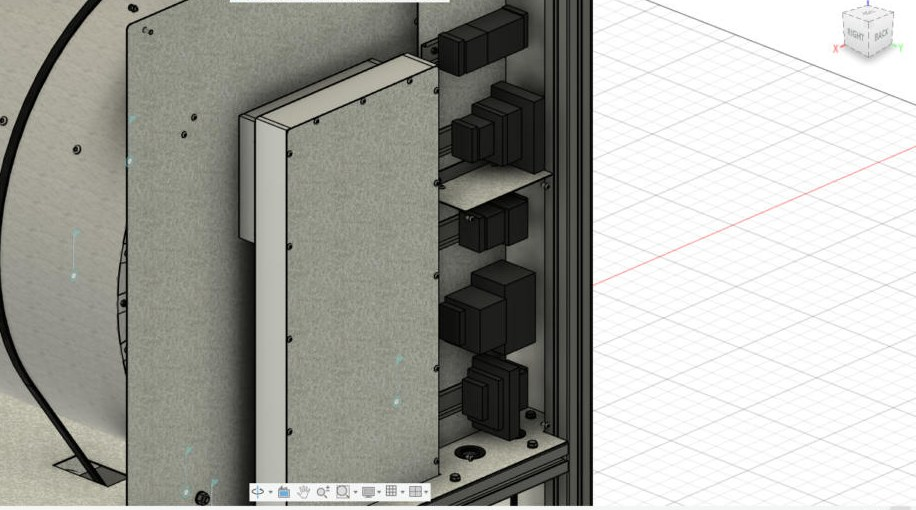
mechanical/cad/audit/fusion-screens/64-draft8-riser-trunk-from-the-rear-right.jpg
