OpenSourceAppliances/dryer/mechanical/cad/audit/fusion-screens/65-draft8-pose-heat-module-out-the-back.jpg

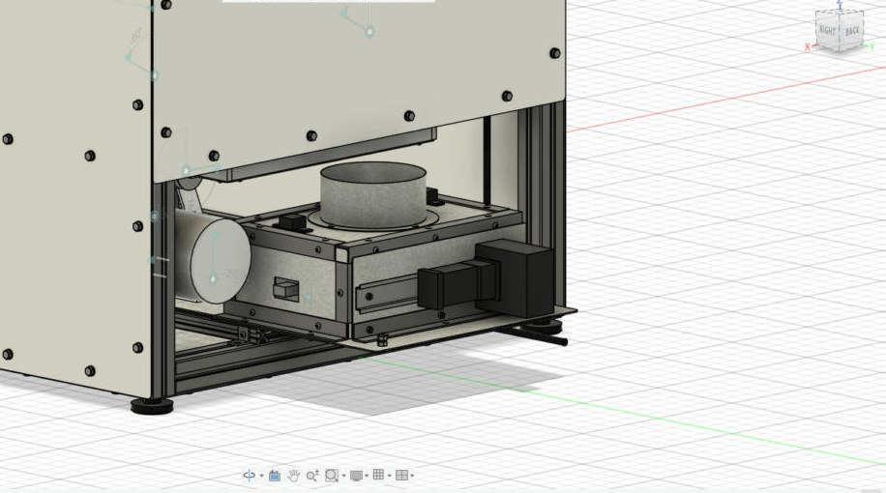
mechanical/cad/audit/fusion-screens/65-draft8-pose-heat-module-out-the-back.jpg
