OpenSourceAppliances/dryer/mechanical/cad/audit/fusion-screens/67-draft9-bay-front-right-spool-blower-exhaust-pipe.jpg

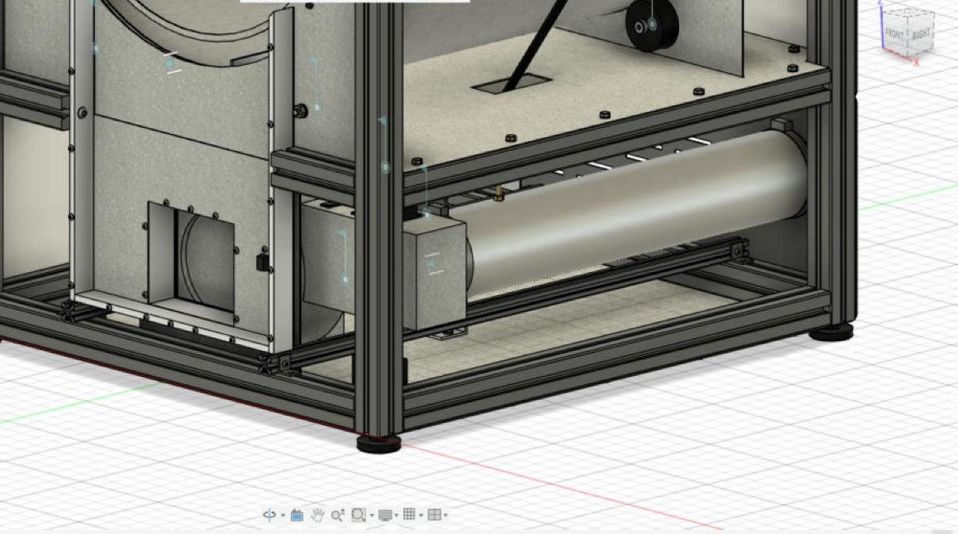
mechanical/cad/audit/fusion-screens/67-draft9-bay-front-right-spool-blower-exhaust-pipe.jpg
