OpenSourceAppliances/dryer/mechanical/cad/audit/fusion-screens/68-draft9-rear-lower-panel-spigot-louvers-blanked-entries.jpg

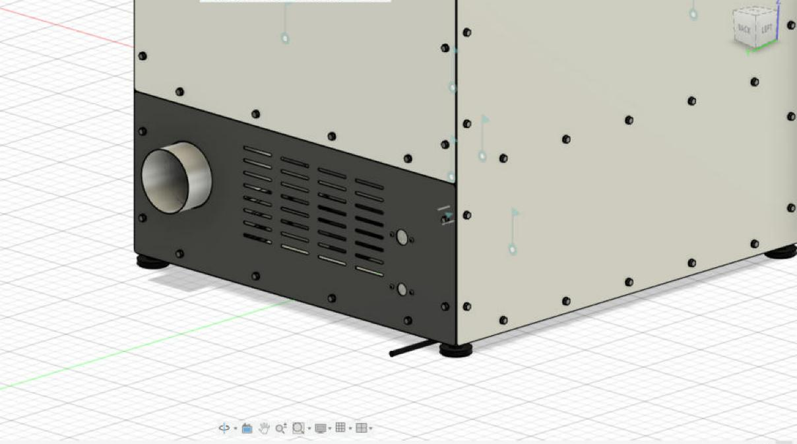
mechanical/cad/audit/fusion-screens/68-draft9-rear-lower-panel-spigot-louvers-blanked-entries.jpg
