OpenSourceAppliances/dryer/mechanical/cad/audit/fusion-screens/69-draft9-rear-lower-panel-off-pipe-clamp-blanks-motor.jpg

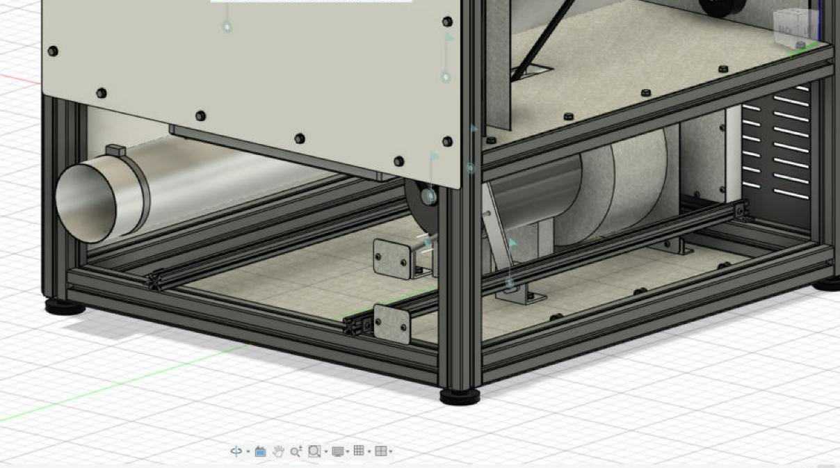
mechanical/cad/audit/fusion-screens/69-draft9-rear-lower-panel-off-pipe-clamp-blanks-motor.jpg
