OpenSourceAppliances/dryer/mechanical/cad/audit/fusion-screens/70-draft9-front-bulkhead-drum-side-moisture-bars-basket-lip.jpg

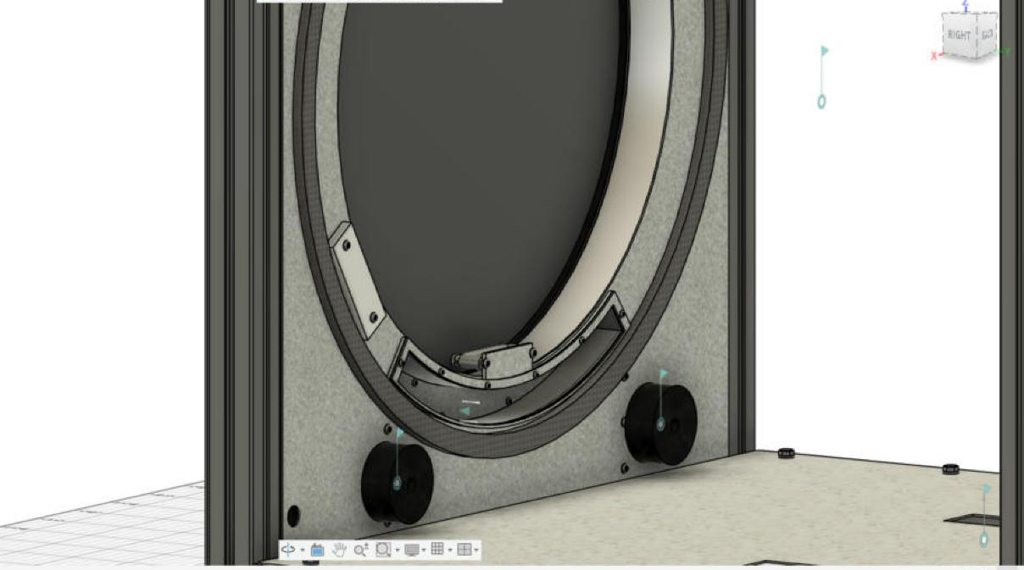
mechanical/cad/audit/fusion-screens/70-draft9-front-bulkhead-drum-side-moisture-bars-basket-lip.jpg
