OpenSourceAppliances/dryer/mechanical/cad/audit/fusion-screens/71-draft9-lint-box-back-plate-spool-thermistor-from-the-bay.jpg

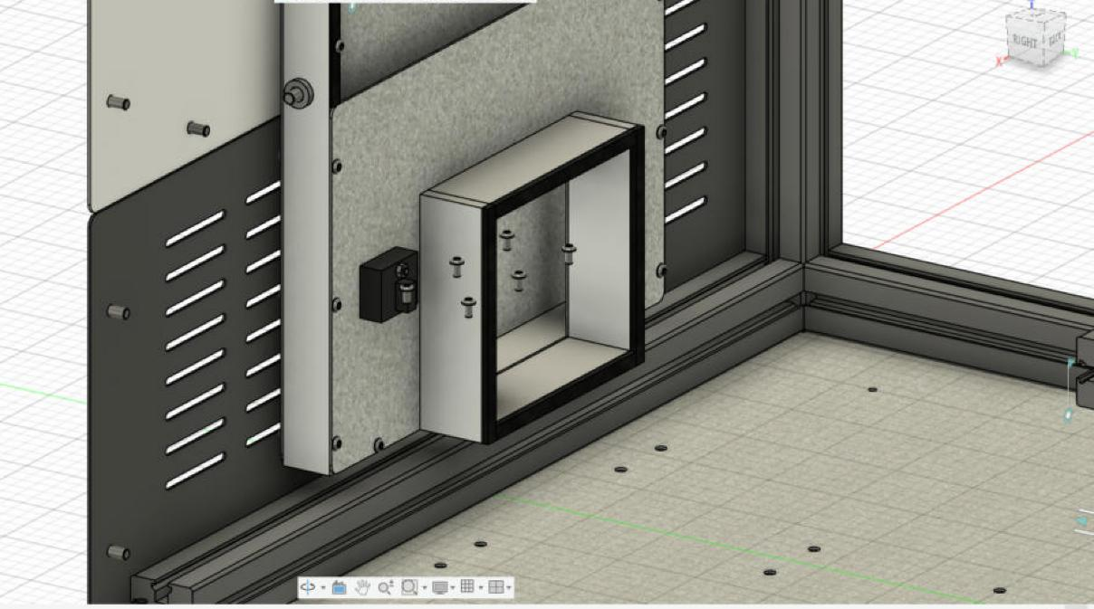
mechanical/cad/audit/fusion-screens/71-draft9-lint-box-back-plate-spool-thermistor-from-the-bay.jpg
