OpenSourceAppliances/dryer/mechanical/cad/audit/fusion-screens/72-draft9-pose-door-open-basket-out.jpg

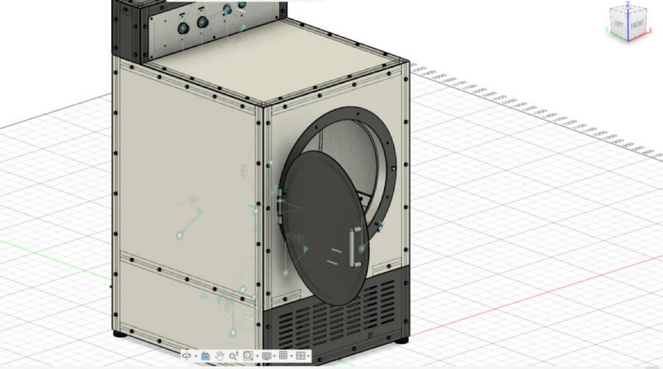
mechanical/cad/audit/fusion-screens/72-draft9-pose-door-open-basket-out.jpg
