OpenSourceAppliances/dryer/mechanical/cad/audit/fusion-screens/73-parametric-stages-a-to-d-ducts-from-the-front-right.jpg

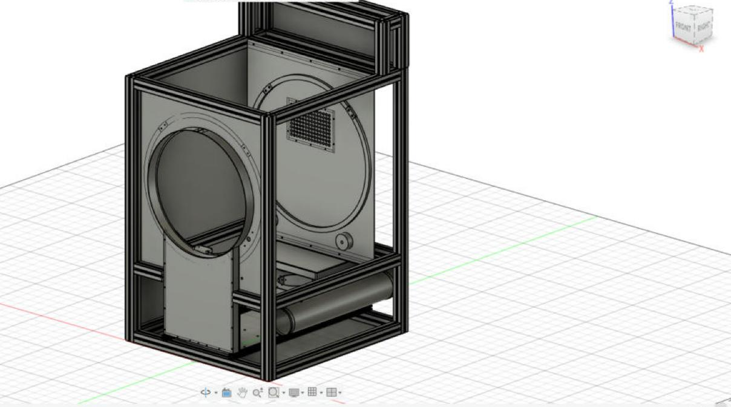
mechanical/cad/audit/fusion-screens/73-parametric-stages-a-to-d-ducts-from-the-front-right.jpg
