OpenSourceAppliances/dryer/mechanical/renders/02-dryer-rear-right.png

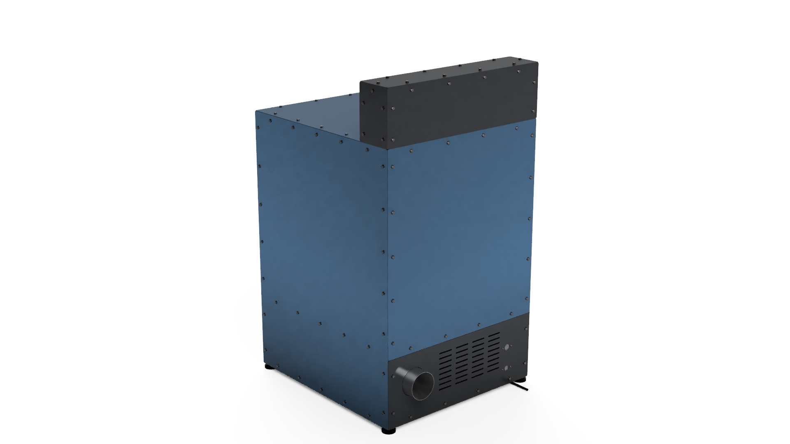
mechanical/renders/02-dryer-rear-right.png
