OpenSourceAppliances/dryer/mechanical/renders/03-dryer-front.png

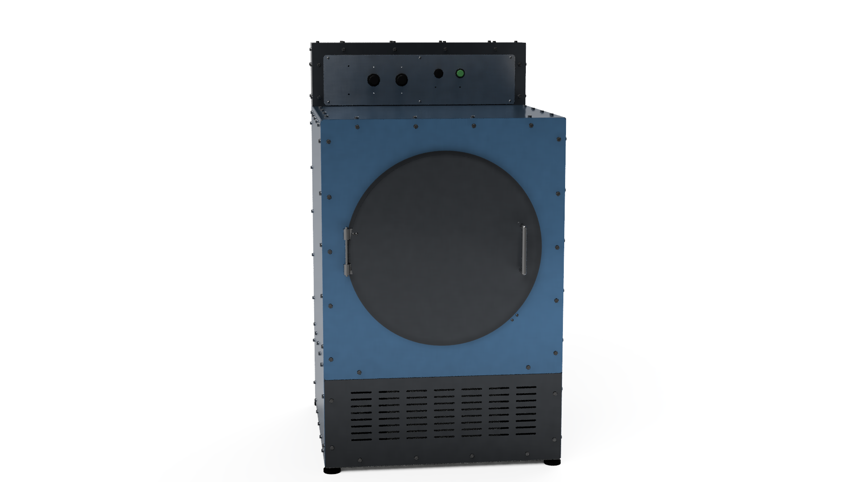
mechanical/renders/03-dryer-front.png
