OpenSourceAppliances/dryer/mechanical/renders/04-dryer-service-side.png

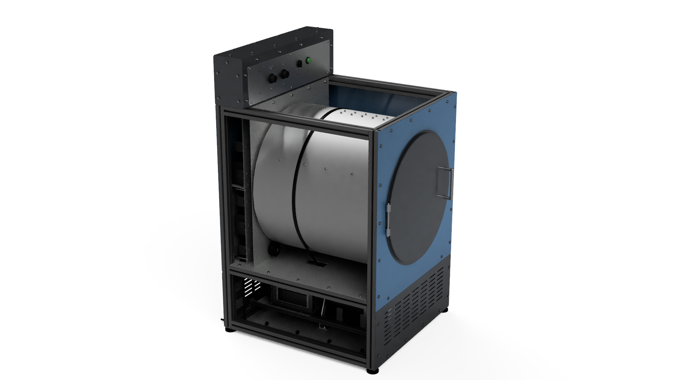
mechanical/renders/04-dryer-service-side.png
