OpenSourceAppliances/dryer/mechanical/renders/05-dryer-rear-open.png

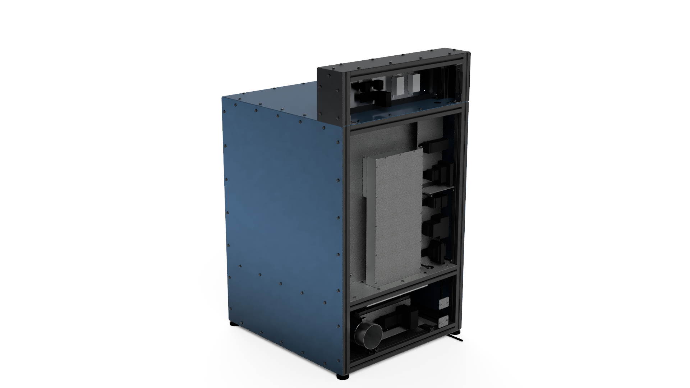
mechanical/renders/05-dryer-rear-open.png
