OpenSourceAppliances/dryer/mechanical/renders/06-drum-set.png

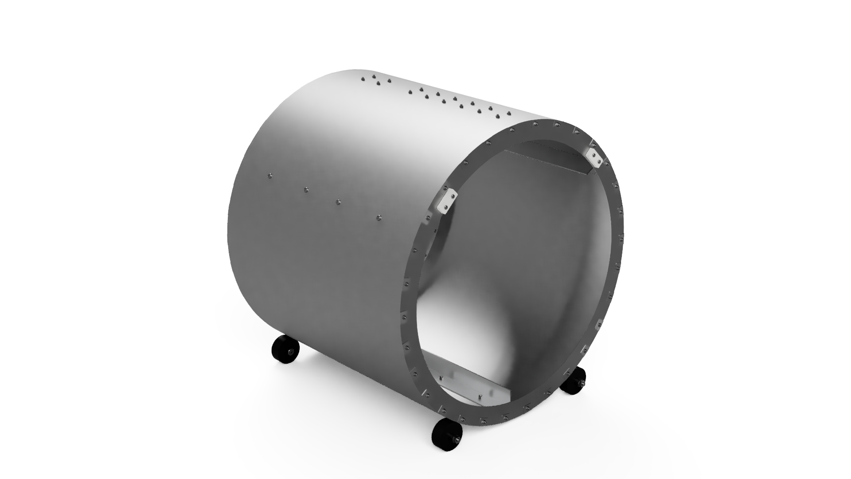
mechanical/renders/06-drum-set.png
