OpenSourceAppliances/dryer/mechanical/renders/07-heat-module.png

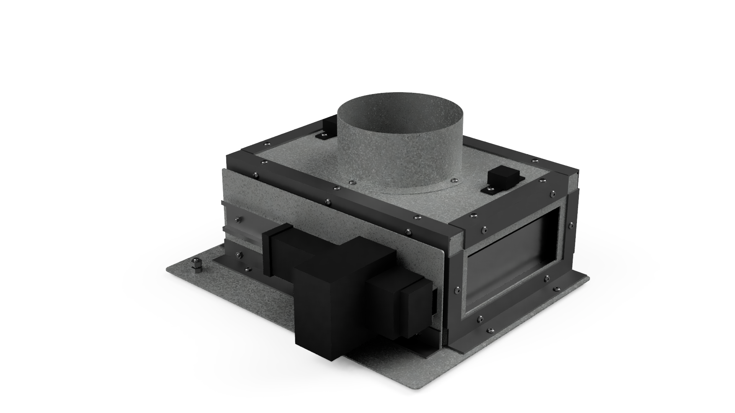
mechanical/renders/07-heat-module.png
