OpenSourceAppliances/dryer/mechanical/renders/09-tier0-module.png

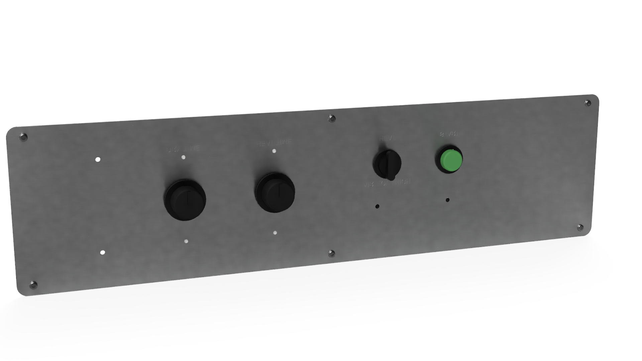
mechanical/renders/09-tier0-module.png
