OpenSourceAppliances/dryer/mechanical/renders/11-drive.png

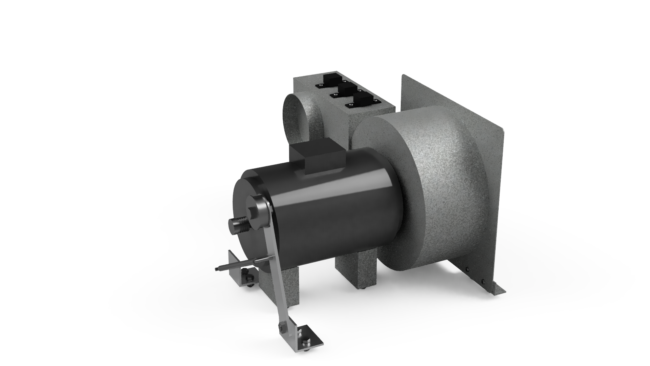
mechanical/renders/11-drive.png
