OpenSourceAppliances/dryer/mechanical/renders/12-lint-path.png

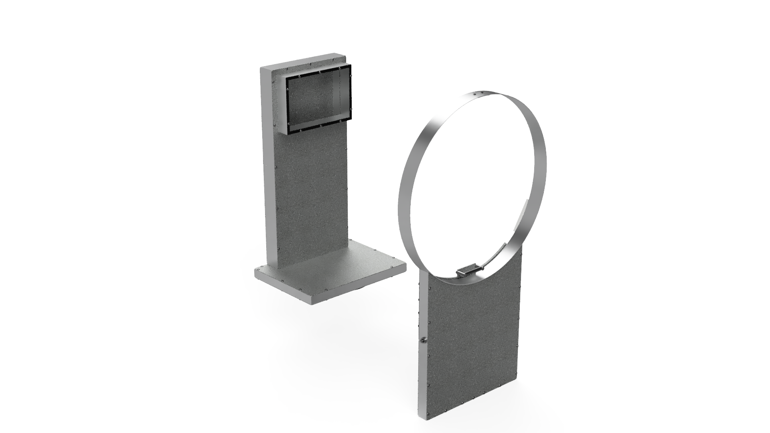
mechanical/renders/12-lint-path.png
