OpenSourceAppliances/dryer/mechanical/renders/13-exhaust-set.png

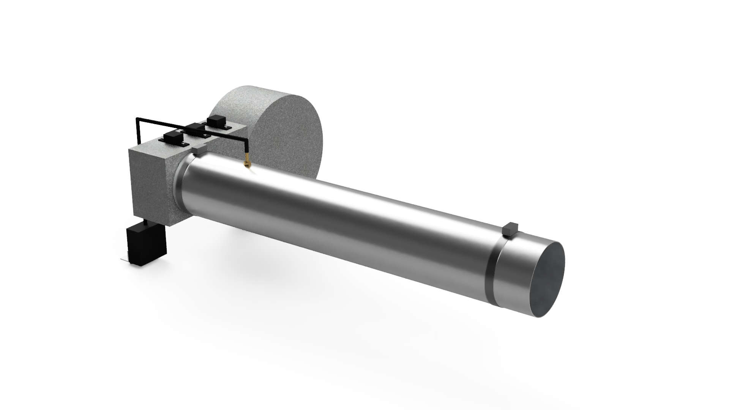
mechanical/renders/13-exhaust-set.png
