OpenSourceAppliances/dryer/mechanical/renders/14-frame.png

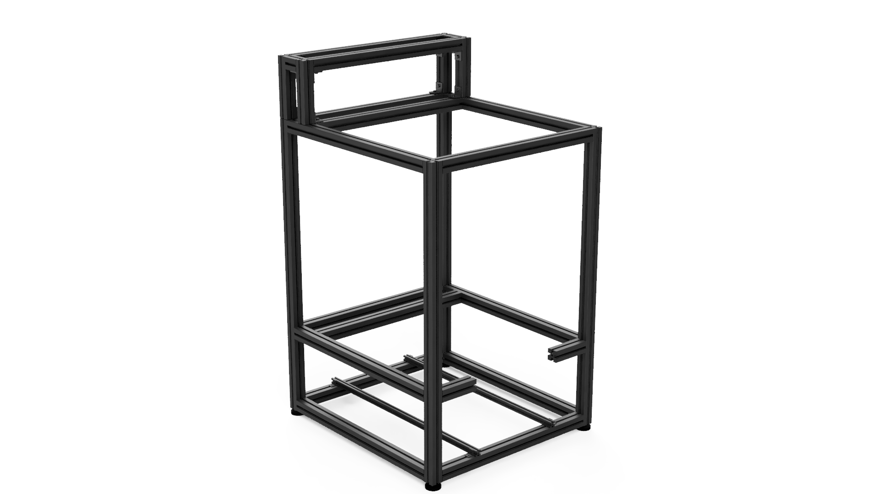
mechanical/renders/14-frame.png
