OpenSourceAppliances/dryer/bom/sourcing-2026-11-09.md

# Sourcing pass, 2026-11-09

Carts were filled at seven sellers for one electric reference build (Tier 0). Nothing was ordered. Prices are the sellers' listed prices on 2026-11-09, before shipping and tax, and will drift. This file records what went into each cart, what was substituted, and what was left out on purpose.

Read `docs/verification.md` before ordering. Gate 1 measures bought parts against the drawings, and several drawings wait on those measurements. Buying the parts below is how Gate 1 starts. Cutting plates is not part of this pass.

## Totals

| Seller | Lines | Subtotal (USD) | What |
| --- | --- | --- | --- |
| Digi-Key | 27 | 724.37 | Contactors, relays, sockets, PSU, breaker, buttons, terminal blocks, DIN rail, connectors, fuses, door switch S2 |
| SupplyHouse | 2 | 130.95 | Two Intermatic FD2HW timers, Cleveland Controls NS2-0000-00 air switch (free shipping) |
| Kele | 1 | 47.40 | Veris H908 current switch (lead time over 15 days) |
| AppliancePartsPros | 10 | 325.50 | Element, thermal parts, thermostats, door switch S1, thermistor, moisture bar, cord, drum rollers |
| McMaster-Carr | 50 | 2627.13 | 4040 and 2020 extrusion cut to length, brackets, T-nuts, all fasteners, feet, shoulder screws, shims, spacers, bar and angle stock, grommets, P-clips, countershaft sheave, bushing, bearings, shaft, key, idler |
| Grainger | 2 | 590.44 | Drum motor, blower |
| Texas Belting | 2 | 126.88 | Motor and countershaft sheaves |
| Total | | 4572.67 | |

## Digi-Key

Same parts as the BOM except where noted.

- Schneider LC1D18BD, LP4K0910BW3, XB4BD33, XB4BA31
- Finder 38.51.7.024.0050 (3)
- Littelfuse 60R010XU (3)
- Phoenix Contact 3004524 UK 6 N (8), 3003347 UK 2.5 N (25), 3004100 UK 5-HESI fuse terminal (2), 1201442 E/UK end clamp (8), 3003020 D-UK 4/10 end cover (4)
- Phoenix Contact 0441504 USLKG 5 ground terminal (2) and 0441119 USLKG 2.5 N ground terminal (1). Substitution: the UK 6 N PE (0442079) was out of stock.
- Phoenix Contact 0801733 DIN rail, 2 m, cut by hand into the five 140 mm rails and the other short pieces
- Omron MY2N-D2-GS-R DC24 hold relay and PYFZ-08-E socket. Substitution: MY2N-D2 DC24 (S) and MY2N-D2-GS DC24 were backordered or not available.
- Honeywell V7-1C17E9-201 door switch S2. Substitution for a V7 with 6.3 mm (0.250 in) tabs; the V7-2B17D8-201 first tried has 0.187 in tabs.
- Mean Well HDR-60-24
- Eaton FAZ-C10/1-SP breaker. Substitution: the WMZT1C10 is listed as discontinued. Both are UL 1077 (the BOM had said UL 489 for the WMZT1C10, which was wrong).
- Littelfuse 0218002.MXP, 5 x 20 mm T2A fuse (5)
- Molex 39-01-2160, 39-01-2165, 39-00-0039 (20), male terminals WM1138CT-ND (10)
- JST XHP-8 and SXH-001T-P0.6 terminals (100, Digi-Key 455-1135-100-ND)
- Two 1N4007 diodes (0.48 USD) are left over from an earlier draft and are not needed. Delete them from the cart before ordering.

## SupplyHouse

- Intermatic FD2HW (2)
- Cleveland Controls NS2-0000-00. The BOM names the NS2 family with the black spring (0.10 to 0.30 in w.c.). Check the range of the -00 against the data sheet before ordering; Kele had no stock of NS2-0000-02.

## Kele

- Veris H908

## AppliancePartsPros

- Whirlpool 279838 element, 279816 thermal cut-off kit, WP3392519 exhaust thermal fuse, WP3387134 cycling thermostat (high), WP3406107 door switch S1, WP8577274 exhaust thermistor, WP3387223 moisture sensor bar
- Pro TJ90L135 limit thermostat, the L135 low thermostat. Out of stock, 4 to 14 days. It is a 135 F (57 C) opening disc; check that its mounting matches the blower housing before relying on it.
- Whirlpool PT220L 4-wire 30 A dryer cord. Check the length: the BOM asks for 1.8 m and this cord may be shorter. V-112 checks the strain relief against the cord bought.
- Whirlpool 349241T rear drum roller kit (4). Check how many rollers one kit holds; the design needs 4 rollers, and 4 kits may be twice what is needed.

## McMaster-Carr

### Frame

- 5537T904 solid 4040 rail, 8 mm slot, cut to length: 4 x 100 cm, 6 x 67 cm, 9 x 61 cm, 4 x 20 cm, 2 x 13.5 cm, 2 x 6 cm. The 58.5 mm pieces are ordered at 60 mm, because McMaster cuts in 2.5 mm steps; file 1.5 mm off by hand. The center hole is 7 mm, not 6.8 mm: tapping M8 into it gives less thread, so check the tapped ends (feet and the tapped rails) under a pull test.
- 5537T9 solid 2020 rail, cut to 2 x 75 cm. McMaster's 20 mm rail has a 5 mm slot, so its own 20 mm nuts are carted with it.
- 5537T937 corner bracket for 40 mm (52), fasteners included. This replaces the separate M8 T-nut and M8 x 16 line (CH-TNUT-M8).
- 5537T935 corner bracket for 20 mm (4)
- 6000N213 M6 drop-in hammer nut for the 40 mm rail (69 packs of 4), 6000N216 M4 for the 40 mm rail (2 packs of 4), 5278N43 M4 drop-in for the 20 mm rail (3 packs of 4)
- 2531K601 leveling foot, M8 x 50 mm stud, 50 mm 316 stainless base (4)

### Fasteners

- 91280A324 M6 x 12 hex, class 8.8 zinc (3 x 100), 91166A250 M6 washer zinc (3 x 100), 94645A205 M6 nylon-insert nut zinc (100)
- 92095A226 M6 x 12 button A2 (50), 92125A238 M6 x 16 flat head A2 (25)
- 92095A189 M4 x 8 (4 x 100), 92095A190 M4 x 10 (100), 92095A194 M4 x 16 (100), 92095A196 M4 x 20 (50), 92095A200 M4 x 40 (25), all button A2
- 93625A150 M4 nylon-insert nut A2 (3 x 100)
- 92095A177 M3 x 5 (100), 92095A179 M3 x 6 (100) button A2, 93625A100 M3 nylon-insert nut A2 (100)
- 92095A284 M8 x 20 button A2 (25), for the lint box hang bolts
- 90265A302 shoulder screw, 10 mm x 35 mm, M8, 18-8 (4)
- 98089A385 shim 10 x 16 x 1 mm (25)
- Roller stud spacer 16 x 10.5 x 8.5 mm is not a catalog length. It is built from two 92871A836 spacers (16 OD, 10.5 ID, 4 mm, 8 carted) and one 98089A340 shim (0.5 mm, pack of 50).
- Lint box spacer: 92871A837 (16 OD, 8.4 ID, 5 mm, 4 carted). The drawing asks for 4 mm; 5 mm is the shortest McMaster has with an 8.4 mm hole. Check the hang height.

### Bar and angle stock (6061)

- 9146T59 8 x 25 mm, 6 ft; 9146T61 8 x 30 mm, 6 ft; 9146T62 8 x 40 mm, 6 ft
- 8975K58 5/16 x 2 in, 6 ft, for the 50 x 8 bars (50.8 mm wide; check the trunk frame fit)
- 9146T33 4 x 25 mm, 1 ft, for the idler arm
- 8982K524 angle 3/4 x 3/4 x 1/16 in, square corners, 8 ft (2), for the 20 x 20 x 2 angle
- 8982K505 angle 1-1/2 x 1-1/2 x 1/8 in, square corners, 8 ft, for the 40 x 40 x 3 angle

### Electrical hardware

- 1061T53 silicone grommet for a 5/8 in (16 mm) hole (10)
- 1061T58 silicone grommet for a 7/8 in (22 mm) hole (5)
- 1061T56 silicone grommet for a 1-1/4 in hole. There is no silicone grommet for a 30 mm hole; this one needs a 32 mm hole, so the bay ceiling harness hole should change from 30 to 32 mm before that DXF is cut.
- 8876T3 nylon loop clamp, 1/2 in, black (100)

## Not carted, and why

## Drive and blower (decided later on 2026-11-09)

The drawn drive cannot be bought: no catalog 1/3 hp 1725 rpm 48-frame motor has a shaft on each end, and the smallest catalog J sheave on a 1/2 in bore would spin the drum at about twice the target speed. An appliance dryer motor (Whirlpool 279827) solves the speed with ribs ground into its shaft, but was rejected because it ties the machine to one maker. The drive is now a stock motor through a countershaft, and the blower has its own motor (`DECISIONS.md` 2026-11-09). The model will be redrawn to it in draft 10.

| Seller | Part | Price (USD) |
| --- | --- | --- |
| Grainger | Dayton 5K121 drum motor: 1/3 hp, 1725 rpm, NEMA 56, capacitor start, TEFC, ball bearings, auto thermal, 5/8 in keyed shaft | 343.29 |
| Grainger | Dayton 1TDV4 blower: 6-1/8 in wheel, 1/15 hp, 1640 rpm, ball bearings, thermally protected, 450 F inlet, 230 cfm at 0.5 in water | 247.15 |
| Texas Belting | B&B 6J160X5/8 motor sheave (1.63 in pitch) | 61.14 |
| Texas Belting | B&B 6J190X5/8 countershaft drive sheave (1.93 in pitch) | 65.74 |
| McMaster-Carr | 1405K13 J sheave, 6 grooves, 4.5 in OD, SH bushing; 6086K212 SH bushing, 5/8 in | 125.77 + 27.97 |
| McMaster-Carr | 6361K33 SKF pillow block, 5/8 in (2); spare insert is 6361K212 | 150.44 |
| McMaster-Carr | 1497K141 keyed shaft 5/8 x 12 in; 98830A150 key stock 3/16 in | 26.54 |
| McMaster-Carr | 6235K61 flat idler pulley, 2.4 in OD, 3/8 in shaft | 18.98 |

Speeds: 1725 x 1.63 / 4.53 = 621 rpm on the countershaft; 621 x 49.0 / 622 = 49 drum rpm, inside the 45 to 55 target.

Not yet carted: the two 6-rib J belts (lengths come from the draft 10 layout), the idler spring, the motor plate and countershaft brackets (laser-cut in draft 10), and the transition from the blower's rectangular outlet to the 4 in pipe.

Checks this adds: the motor contactor's horsepower rating with both motors on it; the blower's pressure against the real air path (rated to 0.75 in of water); the motor's 40 C ambient rating against the bay; the blower's 11-1/8 in height in the 300 mm bay; the fixed-bore sheaves list set screws but no keyway.

## Also not carted

- Laser-cut plates (steel, stainless, aluminium). `docs/verification.md` marks several DXFs as not to be cut until their Gate 1 checks close, and those checks need the parts above in hand. Upload the DXFs to a cutting service after the checks, not before.
- Strain relief. Size it to the cord that arrives (V-112).
- Wire, twisted pair, ferrules, ring terminals, quick-disconnects and wire labels. The BOM sets their quantities when the wiring box is drawn.
- Mini-Fit Jr. and JST XH crimp tools.
- Door hinges, door handle, magnetic catch, lint mesh and pull, door seal, drum felt, glide stock, silicone foam gasket, brass barb and silicone tube, hose clamps, 4 in duct pipe, 5 in starting collar, ground stud kit, paint. These are common hardware; match each to its drawing before buying.
- The 120 V cord for the gas, heat pump and no-heat builds. Not needed for the electric build.
