OpenSourceAppliances/dryer/bom/vendors.md

# Vendors and substitutions

Notes on where parts come from and what to do when a line in `bom.csv` goes stale.

Rules (from the charter):

- Every line in `bom.csv` lists two vendors, or a note explaining why only one exists and what the fallback is.
- The `generic_spec` column is the real identity of the part. Vendor part numbers are conveniences that will rot.
- Prefer industrial suppliers and appliance repair-parts houses over marketplaces. Marketplace links are a third source only.
- Every line carries a `last_verified` date. Older than 12 months means unverified.
- Costs are indicative, dated, and in USD for this BOM.

## Which BOM file is which

- `bom.csv`: the chassis and the common power module. Everything every build needs.
- `bom-tiers.csv`: which lines belong to which control tier.
- `heat-electric-240.csv`, `heat-gas.csv`, `heat-heatpump.csv`: one file per heat module, as the charter asks (one BOM per optional module). The no-heat build has no file of its own; its blanking duct is a line in `bom.csv` marked "fit when no heat module is installed".
- Lines in `bom.csv` that belong to the heat-enable chain carry the note "omit only if a heat module will never be fitted".

## The order plan

`order-plan.csv` is generated by `order_plan.py` from the BOM files, the DXF drawings, the cut list, the model's
hardware counts and the verification plan: one row per thing to order, grouped by who sells it (one cart or one quote
request each), with what to send them (the DXF files and stock, the cut list, the part number or the generic spec), the
quantity, and the check that must close before it is ordered or cut. Wave 1 is bought and measured first, wave 2 is cut
after its checks, wave 3 is the drum sheet after the trial wrap. Run `python3 bom/order_plan.py` after any change to the
BOM, the drawings or the model.

Laser-cut parts are ordered in US sheet stock: 1.5 mm steel as 0.060 in (16 ga), 2 mm steel and 304 as 0.075 in (14 ga),
2 mm 5052 as 0.080 in, 1.5 mm 5052 as 0.063 in. The drum sheet (0.8 mm 304: 0.030 or 0.036 in), the splice and the
basket plates have no exact match and wait on a decision. The drum sheet is 1945 mm long in one piece, past SendCutSend's
instant-quote size (68 x 44 in, custom quote to 119 x 59 in); OSH Cut lists 0.036 in 304 to 119 x 47 in (both checked
2026-11-07). This is V-101.

## Sources used so far

(none yet)

## Known substitutions

(none yet)
