OpenSourceAppliances/dryer/bom/bom.csv

part_id | description | quantity | category | generic_spec | vendor_1 | vendor_1_part_number | vendor_2 | vendor_2_part_number | unit_cost | last_verified | notes
CPM-X1 | Terminal blocks, cord in (L1, L2, N) plus one ground block | 4 | electrical | DIN rail screw or spring terminal block, 600 V, 30 A or more, accepts 10 AWG (6 mm2); ground block of the same family | Phoenix Contact | UK 6 N family and UK 6 N PE | Dinkle | DK6N family and DK6N-PE |  | 2026-11-09 | Phoenix UK 6 N verified 2026-11-09 against the maker's datasheet: 41 A IEC, 50 A 600 V UL, 24 to 8 AWG, cULus recognized, -60 to 110 C; unverified: part number from memory, confirm before ordering; cost not yet collected
CPM-X2 | Terminal blocks, heat module mains (L1, L2, N) plus one ground block | 4 | electrical | Same as CPM-X1 | Phoenix Contact | UK 6 N family and UK 6 N PE | Dinkle | DK6N family and DK6N-PE |  |  | unverified: part number from memory, confirm before ordering; cost not yet collected
CPM-X3 | Terminal blocks, motor and door switch S1, plus one ground block | 5 | electrical | DIN rail terminal block, 600 V, 20 A or more, accepts 14 AWG; ground block of the same family | Phoenix Contact | UK 2.5 N family and UK 2.5 N PE | Dinkle | DK2.5N family and DK2.5N-PE |  |  | unverified: part number from memory, confirm before ordering; cost not yet collected
CPM-X4-X6 | Terminal blocks, SELV side (X4 heat module 4, X5 chassis switches 10, X6 sensors 6) | 20 | electrical | DIN rail terminal block, 2.5 mm2, 24 V service | Phoenix Contact | UK 2.5 N family | Wago | 2002-1201 family |  |  | unverified: part number from memory, confirm before ordering; cost not yet collected; end plates and end clamps as the family needs
CPM-CB1 | Supplementary circuit breaker, 120 V side | 1 | electrical | 1-pole, 10 A, C curve, DIN rail, UL 489 listed (preferred) or UL 1077 recognized, or IEC 60947-2 outside North America | Eaton | FAZ-C10/1-SP (FAZ, UL 1077; Digi-Key 5730-FAZ-C10/1-SP-ND) | ABB | S201-C10 (IEC; in North America use the UL-marked S200 family instead; unverified) |  | 2026-11-09 | Changed 2026-11-09: the first pick WMZT1C10 is listed as discontinued (Elliott Electric) and is UL 1077, not UL 489 as first written here; FAZ-C10/1-SP is the same Eaton FAZ breaker, UL 1077, CSA C22.2 No. 235, IEC 60947-2, C curve, 277 V, in stock at Digi-Key at 52.53 USD on 2026-11-09; UL 1077 is what the spec asks for; for UL 489 use FAZ-C10/1-NA-SP (74.07 USD); ABB line unverified; C curve so the motor start holds; check in commissioning
CPM-F1 | Fuse terminal and fuse, supply input | 1 | electrical | DIN rail fuse terminal for 5 x 20 mm fuse, with a 2 A time-delay 250 V fuse | Phoenix Contact | UK 5-HESI family | Dinkle | DK4N-F family |  |  | unverified: part number from memory, confirm before ordering; cost not yet collected; fuse: any listed 5 x 20 mm T2A 250 V, buy a card of them
CPM-F2 | Fuse terminal and fuse, control module rail | 1 | electrical | Same terminal as CPM-F1 with a 2 A fuse, or a 2 A hold resettable PTC on a carrier | Phoenix Contact | UK 5-HESI family | Dinkle | DK4N-F family |  |  | unverified: part number from memory, confirm before ordering; cost not yet collected
CPM-PSU | Power supply, 24 V DC | 1 | electrical | 24 V DC, 2.5 A, 60 W, universal input 85 to 264 V AC, listed, DIN rail mount | Digi-Key | HDR-60-24 (Mean Well) | Jameco | HDR-60-24 (Mean Well) |  | 2026-11-09 | verified on vendor listings 2026-11-05 and the maker's datasheet 2026-11-09: UL 62368-1 and UL 508, -30 to 70 C, free air convection, MTBF over 500,000 h (Telcordia); Mean Well MDR-60-24 and Phoenix UNO-PS/1AC/24DC/60W are equivalents; cost not yet collected
CPM-K_MOTOR | Contactor, motor | 1 | electrical | IEC mini contactor, AC-3 9 A or more at 120 V, 24 V DC coil with built-in suppression, listed; one pole used; 45 x 58 x 57 class so it fits the 97 mm between the power module plate and the rear upper panel (draft 7) | Schneider Electric | LP4K0910BW3 (TeSys K, 24 V DC low consumption coil, built-in suppressor) | Schneider Electric | LP1K0910BD (TeSys K, 24 V DC coil, no suppressor: add a diode across A1-A2) |  | 2026-11-09 | verified 2026-11-09 against the maker's datasheets (bom/electrical-durability.md): 30 Mcycles mechanical, 1.3 Mcycles at 9 A AC-3, UL and CSA, operating -25 to 50 C; the LC1K0910BD of drafts 7 to 9 does not exist (TeSys K DC-coil contactors are LP1K and LP4K); the Siemens 3RT2015-1BB41 of earlier drafts is S00 frame and has not been checked against the 97 mm depth; cost not yet collected
CPM-RLY | Interface relay, request lines (RLY_MOTOR, RLY_HEAT, RLY_HEAT_LO) | 3 | electrical | Slim interface relay module, 24 V DC coil with suppression diode and LED, 1 changeover contact, 6 A, DIN rail, 6.2 mm | RS Components | 38.51.7.024.0050 (Finder) | FactoryMation | 38.51.7.024.0050 (Finder) |  | 2026-11-09 | Finder 38.51 verified 2026-11-09 against the maker's datasheet: 10 M cycles mechanical, 60,000 at 6 A AC1 (here it switches a contactor coil of under 0.25 A), -40 to 70 C, 6.2 mm; verified on vendor listings 2026-11-05; Phoenix Contact PLC-RSC-24DC/21 is an equivalent; cost not yet collected
CPM-PTC | Resettable fuse, status lines (PTC1, PTC2, PTC3) | 3 | electrical | PTC resettable fuse, 100 mA hold, 30 V or more, radial, mounted in a DIN terminal with a component carrier or a small screw-terminal block | Littelfuse | 60R010XU | Bourns | MF-R010 |  |  | unverified: part number from memory, confirm before ordering; cost not yet collected
CPM-S1 | Door switch, contact 1 (mains, motor line) | 1 | electrical | Listed appliance dryer door switch, contact rated for the motor at 120 V including starting current, 6.3 mm tabs | Whirlpool (any appliance parts house) | 3406107 family | Supco or ERP (aftermarket) | equivalent to 3406107 |  |  | unverified: part number from memory, confirm before ordering; cost not yet collected; rating against the chosen motor to be checked
CPM-S2 | Door switch, contact 2 (SELV) | 1 | electrical | Listed snap-action limit switch, 24 V DC, 1 A or more, roller or lever actuator, on the same door actuator as S1 | Honeywell (MICRO SWITCH) | V7 or V15 series | ZF Electronics (Cherry) | D4 series |  | 2026-11-09 | Honeywell V7 verified 2026-11-09 against the maker's datasheet: up to 10 M cycles mechanical, -40 to 85 C, UL, CSA, ENEC; 6.3 mm E9 terminals; roller levers -201 and -207; unverified: part number from memory, confirm before ordering; cost not yet collected; actuator type decided in CAD
CPM-PS1 | Air-proving switch | 1 | electrical | Listed air pressure switch, normally open, closes on blower pressure, 24 V DC contact, setpoint to be measured on the prototype | Cleveland Controls | NS2 series | Honeywell | IS series |  | 2026-11-09 | Cleveland Controls NS2 verified 2026-11-09 against the maker's data sheet: 0.10 to 10.0 in w.c. by spring (black spring 0.10 to 0.30, natural 0.30 to 0.90), SPDT fine silver, 100,000 cycles minimum, UL and cUL, -40 to 88 C; unverified: part number from memory, confirm before ordering; cost not yet collected; setpoint and tap location are open questions; see design-rules section 11
CPM-TF2 | Exhaust thermal fuse | 1 | wear | One-shot thermal cutoff, about 91 C (196 F), 6.3 mm tabs, mounts on the blower housing; carries coil current only here | Whirlpool Parts | WP3392519 | Ferguson | SET401 (Supco, 25 A) |  | 2026-11-05 | verified on vendor listings 2026-11-05; buy two, one spare; cost not yet collected
CPM-T_HI | Cycling thermostat, high | 1 | wear | Bimetal disc thermostat, normally closed, L155-25 (opens about 68 C, closes about 54 C), 6.3 mm tabs, blower housing mount | Whirlpool (any appliance parts house) | 3387134 family | Supco or ERP (aftermarket) | equivalent to 3387134 |  |  | unverified: part number from memory, confirm before ordering; cost not yet collected; L-rating per heat module; this is the electric and gas value
CPM-T_LO | Cycling thermostat, low | 1 | wear | Bimetal disc thermostat, normally closed, L135-25 (opens about 57 C), 6.3 mm tabs, blower housing mount | appliance parts house | L135-25 disc thermostat | Supco or ERP (aftermarket) | L135-25 disc thermostat |  |  | unverified: part number from memory, confirm before ordering; cost not yet collected; exact part to be chosen
CPM-DIN | DIN rail, 35 mm, five 140 mm lengths (rails A1, A2, A3, B1, B2 on the power module plate) | 5 | structure | 35 mm x 7.5 mm steel DIN rail, EN 60715, slotted, cut to 140 mm (draft 7: five short rails across the 150 wide plate, two M4 each) | McMaster-Carr | 35 mm DIN rail | AutomationDirect | DN-R35S1 family |  |  | unverified: part number from memory, confirm before ordering; plus ten end clamps (CLIPFIX 35 class); cost not yet collected
CPM-BOX | Power module plate, cover and barrier, laser-cut 1.5 mm steel | 3 | structure | Laser-cut plate 150 x 720 (four M6 to the rear cross rails, two M4 per DIN rail, four M4 standoff holes, two for the barrier angle, one 6.6 for the ground stud), cover 150 x 330 on four M4 x 75 hex standoffs, barrier shelf 150 x 75.5 on a 150 length of 20x20x2 aluminium angle at 640; mechanical/drawings/power-module-plate.dxf, power-module-cover.dxf, power-module-barrier.dxf (draft 7) | online laser-cut service | per DXF | local laser-cut shop | per DXF |  |  | drawn in draft 7 behind the rear bulkhead, left of the riser, serviced with the rear upper panel off (DECISIONS.md 2026-11-06); plus 4 x M4 x 75 female-female hex standoffs, 22 x M4 x 8 button heads and 14 nuts; cost not yet collected
CPM-CORD-240 | Cord, electric build | 1 | electrical | Listed dryer cord, NEMA 14-30P, 4-wire, 10 AWG, 1.8 m, ring or spade ends | appliance parts house | 4-wire 30 A dryer cord | hardware store | 4-wire 30 A dryer cord |  |  | cost not yet collected; electric build only
CPM-CORD-120 | Cord, gas, heat pump, and no-heat builds | 1 | electrical | Listed appliance cord, NEMA 5-15P (5-20P if the heat pump unit needs it), 3-wire, 14 AWG (12 AWG for 5-20P), 1.8 m | hardware store | appliance cord 14 AWG 5-15P | electrical distributor | appliance cord 14 AWG 5-15P |  |  | cost not yet collected; one cord per build, not both
CPM-STRAIN | Cord strain relief | 1 | electrical | Listed cord strain relief bushing sized to the cord, PG16 or 1/2 in NPT thread with a locknut, through the 22 mm hole in the base pan at X -275, Y 690 (draft 7: the cord comes up through the pan, up the bay and through a 22 mm grommet in the bay ceiling to the power module, and runs under the pan to the back) | Heyco | Pigtail strain relief family | McMaster-Carr | strain relief bushing |  |  | unverified: part number from memory, confirm before ordering; the 22 mm pan hole is sized for a PG16 body, V-112 confirms it against the bushing bought; cost not yet collected
CPM-GROMMET | Panel grommets for the cord and the harnesses | 5 | electrical | Rubber grommets for 1.5 mm panels: two for 22 mm holes (the cord through the bay ceiling, the console harness through the top panel at X -225, Y 690), one for a 30 mm hole (the bay harness through the bay ceiling at X -200, Y 690) and two for 16 mm holes (the door switch cable and the moisture pair through the bay ceiling at X 290, Y 60 and the front bulkhead at X 290, Z 330; model draft 9, 12 in draft 8); 105 C or better | McMaster-Carr | rubber grommets for 16, 22 and 30 mm holes, 1.5 mm panel | Heyco | grommets for 16 mm and 22 mm and 30 mm holes |  |  | draft 7; draft 9 adds the two 16; cost not yet collected
CPM-GND | Ground stud kit | 1 | fastener | M6 stud, nuts, star washers, ring terminals for 10 AWG and 14 AWG and 18 AWG | McMaster-Carr | M6 ground stud and ring terminals | electrical distributor | M6 ground stud and ring terminals |  |  | cost not yet collected
CPM-WIRE | Appliance wire, 105 C, 600 V: 10 AWG black red white green; 14 AWG black white green; 18 AWG black white green blue white/blue; 20 AWG blue orange yellow | 1 | electrical | Stranded appliance wire, 105 C, 600 V, colors as in the wire list | electrical distributor | MTW or TEW wire by color and gauge | McMaster-Carr | MTW or TEW wire by color and gauge |  |  | cost not yet collected; quantities set when the box is drawn
CPM-TP | Twisted pair, sensors | 1 | electrical | 22 AWG twisted pair, 105 C, brown/brown-white, green/green-white, gray/gray-white | electrical distributor | 22 AWG twisted pair | McMaster-Carr | 22 AWG twisted pair |  |  | cost not yet collected
CPM-TERM | Ferrules, ring terminals, 6.3 mm quick-disconnects, wire labels | 1 | electrical | Insulated ferrules for 10 to 20 AWG; insulated ring terminals; insulated 6.3 mm female quick-disconnects; heat-shrink wire markers | McMaster-Carr | assorted | electrical distributor | assorted |  |  | cost not yet collected
UCI-J1-HSG | J1 receptacle housing, chassis side | 1 | electrical | Mini-Fit Jr. 16-circuit (2 x 8) receptacle housing, 4.2 mm pitch, with latch | Molex (via Digi-Key or Mouser) | 5557-16R (39-01-2160) | Wurth Elektronik (via Digi-Key or Mouser) | WR-MPC4 16-pin receptacle housing |  | 2026-11-09 | Molex Mini-Fit Jr. verified 2026-11-09 against the maker's spec: 600 V, 6 A per circuit at 18 AWG in 12 to 24 circuits, 30 mating cycles, -40 to 105 C, UL and CSA; unverified: part number from memory, confirm before ordering; cost not yet collected; intermateability of the two makers to be confirmed, see uci-spec section 13
UCI-J1-TERM | J1 female crimp terminals | 20 | electrical | Mini-Fit Jr. female crimp terminal, 18 to 24 AWG, tin | Molex (via Digi-Key or Mouser) | 5556 (39-00-0039) | Wurth Elektronik (via Digi-Key or Mouser) | WR-MPC4 female crimp terminal |  |  | unverified: part number from memory, confirm before ordering; cost not yet collected; 16 used, 4 spare
UCI-J2-HSG | J2 housing, chassis side | 1 | electrical | JST XH 8-position housing, 2.5 mm pitch | JST (via Digi-Key or Mouser) | XHP-8 | compatible maker (via Digi-Key or Mouser) | XH-compatible 8-position housing |  |  | unverified: part number from memory, confirm before ordering; cost not yet collected
UCI-J2-TERM | J2 crimp terminals | 10 | electrical | JST XH female crimp terminal, 22 to 28 AWG | JST (via Digi-Key or Mouser) | SXH-001T-P0.6 | compatible maker (via Digi-Key or Mouser) | XH-compatible crimp terminal |  |  | unverified: part number from memory, confirm before ordering; cost not yet collected; 6 used, 4 spare
UCI-CRIMP | Crimp tools | 2 | electrical | Ratcheting crimper for Mini-Fit Jr. terminals; ratcheting crimper for JST XH terminals | generic tool maker (any) | Mini-Fit crimper | generic tool maker (any) | XH crimper |  |  | cost not yet collected; tools, not parts of the dryer
T0-TMR | Spring-wound interval timer, DRY TIME and HEAT TIME | 2 | control | Spring-wound interval timer, 0 to 2 h, SPST normally open contact closed while timing, no HOLD position, standard wall-device yoke, 125 to 277 V AC rated | Platt | FD2HW (Intermatic) | Zoro | FD2HW (Intermatic) |  | 2026-11-09 | Intermatic FD series verified 2026-11-09 on the maker's catalogue page and distributor listings: FD2HW is 2 h, no hold, 1 NO, 20 A at 125 V resistive, 1 hp at 125 V, UL and CSA (E10694); one-year warranty and no published cycle life, so it is a wear part on a standard wall-device yoke; verified on vendor listings and the maker's family sheet 2026-11-05: FD2HW is white, FD2H ivory, both without HOLD (HOLD models carry a second H, as in FD6HH; none exists at 2 h or 4 h); FD4HW or FD4H for a heat pump build; body 70.9 x 40.6 x 30.2 mm; Marktime 93 series is a second family; minimum load at 24 V DC to be confirmed; cost not yet collected
T0-SW | Heat selector switch | 1 | control | 22 mm panel-mount 3-position selector switch, maintained, with two normally open contact blocks (one closed in LOW, one in HIGH), rated for 24 V DC | Schneider Electric | XB4BD33 (3-position maintained, two NO contacts included) | Eaton | M22-WRK3 with two M22-K10 contact blocks |  | 2026-11-09 | Schneider line verified 2026-11-09 against the maker's datasheet: the XB4BD33 already carries its two NO contacts, so no separate ZBE101 blocks are ordered (earlier drafts listed them); 1 Mcycle mechanical and electrical (DC-13 0.5 A 24 V), IP66/67/69K, -40 to 70 C, UL and CSA; Eaton line unverified; cost not yet collected
T0-START | Start push button | 1 | control | Momentary push button, normally open, 22 mm panel mount, 24 V DC rated, with one NO contact block | Schneider Electric | XB4BA31 (green, one NO contact included) | Eaton | M22-D-G with M22-K10 |  | 2026-11-09 | Schneider line verified 2026-11-09 against the maker's datasheet: 10 Mcycles mechanical, 1 Mcycle electrical, IP66/67/69K, -40 to 70 C, UL and CSA; Eaton line unverified; cost not yet collected
T0-K1 | Hold relay with socket | 1 | control | Plug-in relay, 24 V DC coil with suppression diode, 2 changeover contacts, 5 A or more, with DIN or panel socket | Omron | Omron MY2N-D2 DC24 (S) (current catalogue code MY2N-D2-GS) with PYFZ-08-E DIN socket | Finder | 55.32.9.024 series with 94.72 socket |  | 2026-11-09 | Omron line verified 2026-11-09 against the maker's catalogue: 50 M operations mechanical, coil 37.7 mA at 24 V (under the 50 mA limit), -40 to 70 C, UL 508 and CSA; the PYF08A-E socket of earlier drafts is not in the catalogue, PYFZ-08-E (10 A, -55 to 70 C) replaces it; Finder line unverified; cost not yet collected
T0-PLUG-HSG | Plug housing to J1 | 1 | control | Mini-Fit Jr. 16-circuit plug housing with male crimp terminals | Molex (via Digi-Key or Mouser) | 5559-16P (39-01-2165) | Wurth Elektronik (via Digi-Key or Mouser) | WR-MPC4 16-pin plug housing |  |  | unverified: part number from memory, confirm before ordering; cost not yet collected
T0-PLUG-TERM | Male crimp terminals for the plug | 8 | control | Mini-Fit Jr. male crimp terminal, 18 to 24 AWG, tin | Molex (via Digi-Key or Mouser) | 5558 (39-00-0059) | Wurth Elektronik (via Digi-Key or Mouser) | WR-MPC4 male crimp terminal |  |  | unverified: part number from memory, confirm before ordering; cost not yet collected; 5 used, 3 spare
T0-FACE | Faceplate, laser-cut 2 mm aluminum, 620 x 160 mm, UCI-D hole pattern | 1 | control | Laser-cut 2 mm aluminum per mechanical/drawings/tier0-faceplate.dxf (CUT layer), optional engraving (LABEL layer) | online laser-cut service | per DXF | local laser-cut shop | per DXF |  |  | drawing exists; shaft hole and knob diameter to be checked on a timer in hand before cutting; cost not yet collected
T0-RAIL | DIN rail segment and standoffs for K1 | 1 | control | 100 mm of 35 mm DIN rail on two M4 x 12 mm standoffs with M4 x 8 button head screws (2.5 mm hex key), 24 below the faceplate's centre line (faceplate draft 2) | McMaster-Carr | 35 mm DIN rail, M4 standoffs | AutomationDirect | DN-R35S1 family, M4 standoffs |  |  | cost not yet collected
T0-NUTS | Nuts for the timer yoke screws | 4 | fastener | 6-32 hex nuts with flat washers, for the 6-32 screws supplied with the timers | hardware store | 6-32 nuts | McMaster-Carr | 6-32 nuts |  |  | imperial because the timers are; listed as supplied-with-part hardware; cost not yet collected
T0-WIRE | Wire and terminals inside the module | 1 | control | 0.5 mm2 (20 AWG) stranded, 105 C; 6.3 mm insulated quick-disconnects; ring terminals for the switch and button | electrical distributor | assorted | McMaster-Carr | assorted |  |  | cost not yet collected
CH-EXT-4040 | Aluminum extrusion 4040, 8 mm slot | 15 m | structure | 4040 T-slot aluminum extrusion, 8 mm slot, cut to the lengths in mechanical/drawings/frame-cut-list.csv (cabinet: 4 x 1000, 7 x 610, 6 x 670, 2 x 135; console: 4 x 200, 2 x 610, 2 x 58.5; 14.7 m before cutting waste); buy 8 x 2 m | Misumi | HFS8-4040 | McMaster-Carr | 4040 T-slot framing, 8 mm slot |  |  | unverified: part number from memory, confirm before ordering; many other makers; cost not yet collected
CH-EXT-2020 | Aluminum extrusion 2020, tray rails | 2 x 750 mm | structure | 2020 T-slot extrusion, 6 mm slot, 2 x 750 mm, the full depth of the cabinet on the bottom end rails (draft 7), each held by two 2020 inside corner brackets; the heat module tray and its box bolt into their top slots with M4 T-nuts | Misumi | HFS5-2020 | McMaster-Carr | 2020 T-slot framing |  |  | unverified: part number from memory, confirm before ordering; cost not yet collected
CH-BRKT-2020 | Corner brackets for the 2020 tray rails | 4 | structure | 2020 inside corner bracket (20 x 20 x 17, 2.5 thick, one hole per leg) with M4 x 8 button heads: one into the rail's side slot with an M4 T-nut for the 6 mm slot, one into the 4040 end rail's top slot with an M4 T-nut for the 8 mm slot (draft 7) | Misumi | HBLFSN5 | McMaster-Carr | 2020 corner bracket |  |  | unverified: part number from memory, confirm before ordering; cost not yet collected
CH-BRKT | Corner brackets for 4040 | 52 | structure | Cast or extruded inside corner bracket for 8 mm slot 4040, with M8 or M6 hardware | Misumi | HBLFSN8 | McMaster-Carr | 4040 corner bracket |  |  | unverified: part number from memory, confirm before ordering; count from the model: 4 per rail-to-post joint on the cabinet (40) plus 12 on the console frame (two per post foot and end rail joint, one per side rail end); cost not yet collected
CH-TNUT-M6 | T-nuts M6 for the 8 mm slot | 240 | fastener | Drop-in or slide-in T-nut, M6, for 8 mm slot | Misumi | HNTT8-6 | McMaster-Carr | M6 T-nut, 8 mm slot |  |  | unverified: part number from memory, confirm before ordering; the console adds 24 for its brackets and 32 for its plates; cost not yet collected
CH-BOLT-M6 | Bolts M6 x 12 hex head with washers | 200 | fastener | M6 x 12 hex head, zinc, with flat washers | McMaster-Carr | M6 x 12 hex head | Fastenal | M6 x 12 hex head |  |  | cost not yet collected
CH-TNUT-M8 | T-nuts M8 and M8 x 16 hex bolts for the brackets | 80 | fastener | M8 T-nut, 8 mm slot, and M8 x 16 hex head | Misumi | HNTT8-8 | McMaster-Carr | M8 T-nut, M8 x 16 hex head |  |  | unverified: part number from memory, confirm before ordering; cost not yet collected
CH-FEET | Leveling feet | 4 | structure | M8 leveling foot with a 50 mm pad, 150 kg class each, hex 8 tall, screwed into the post's 6.8 mm centre bore tapped M8, through an 8.5 hole in the base pan; 18 mm from the floor to the pan run in, so the cord passes under the pan with 3 mm to spare | Misumi | leveling foot M8 | McMaster-Carr | leveling foot M8 |  |  | method into the post end confirmed by V-113; the 18 mm under the pan is the pad plus the hex as modeled and needs checking on the foot bought; cost not yet collected
CH-PLATES | Laser-cut plates, 1.5 mm steel: side panels (2), front upper, front lower, rear upper, rear lower, top panel, base pan, bay ceiling, front bulkhead, rear bulkhead; 2 mm steel: door ring, door disc; 1.5 mm steel: console face, cap, rear, two cheeks (the heat module's plates are on HE-TRAY and HE-BOX, the power module's on CPM-BOX) | 18 | structure | Per the DXF files in mechanical/drawings, CUT layer; mild steel, powder coated or painted after cutting; stainless for the bulkheads is optional | online laser-cut service | per DXF | local laser-cut shop | per DXF |  |  | do not cut until the gates in docs/verification.md that unlock each plate are closed; cost not yet collected
CH-M1 | Drum motor | 1 | wear | 120 V single phase, 1/3 hp, 1725 rpm, NEMA 56 frame, capacitor start, totally enclosed fan cooled, ball bearings, built-in automatic thermal protector, 5/8 in keyed shaft, UL recognized | Grainger | Dayton 5K121 | Leeson, Marathon, Baldor or WEG (via distributor) | same rating, NEMA 56, TEFC, capacitor start | 343.29 | 2026-11-09 | Changed 2026-11-09 (DECISIONS.md): replaces the dual-shaft NEMA 48 motor, which no catalog lists. Dayton 5K121 checked on Grainger 2026-11-09: capacitor start, TEFC, ball bearings, auto thermal, 5/8 x 1-7/8 in keyed shaft, 7/3.3-3.5 A, 40 C max ambient (check the bay temperature in the test run), UL recognized E37403, CSA
CH-PULLEY | Drive sheaves: motor, countershaft driven, countershaft drive | 3 | wear | J-section poly-V, 6 ribs: 1.63 in pitch on 5/8 in bore (motor); 4.53 in pitch, SH bushing bore (countershaft driven); 1.93 in pitch on 5/8 in bore (countershaft drive to the drum). 1725 x 1.63 / 4.53 = 621 rpm; 621 x 49.0 / 622 = 49 drum rpm | Texas Belting (B&B) and McMaster-Carr | B&B 6J160X5/8; McMaster 1405K13 (6J, 4.5 in OD, SH) with 6086K212 SH bushing 5/8 in; B&B 6J190X5/8 | TB Woods, Mitsuboshi or Powerdrive | 6J16058 and 6J19058 (TB Woods), 6J450SH (B&B) | 61.14; 125.77 + 27.97; 65.74 | 2026-11-09 | Changed 2026-11-09 (DECISIONS.md): replaces the 20 mm PJ pulley, which cannot be bought on a 1/2 in bore. The fixed-bore sheaves list a set screw and no keyway: check against the keyed shafts
CH-BLOWER | Blower, packaged with its own motor | 1 | wear | Direct-drive centrifugal blower, 115 V, ball bearings, thermally protected, about 230 cfm at 0.5 in water, rated for at least 400 F inlet air; outlet transition to the 4 in exhaust pipe | Grainger | Dayton 1TDV4 (6-1/8 in wheel, 1/15 hp, 1640 rpm, 0.86 A, 450 F max inlet, rectangular 3-3/4 x 4-1/4 in outlet, 11-1/8 x 8-11/16 x 10-3/8 in) | Fasco or Rotom (via distributor) | same class | 247.15 | 2026-11-09 | Changed 2026-11-09 (DECISIONS.md): its own motor, on the motor contactor with the drum motor. Rated only to 0.75 in of water: measure the real air path in commissioning with no heat; needs a transition to the round pipe; check the fit in the 300 mm bay
CH-DUCTS | Duct plates: lint box (2), riser hood (2), riser trunk (2), laser-cut 1.5 mm steel | 6 | structure | Laser-cut 1.5 mm steel plates, 6 mm corner radii, 4.5 holes, the same stock as the panels (draft 8): lint-box-front 332 x 408 with its top on an arc of radius 237.2 (the throat liner), lint-box-back 332 x 213 with a 140 x 120 opening, hood-bottom and hood-top 350 x 257.5 (128 collar hole; 244 x 50 trunk opening), trunk-front and trunk-rear 260 x 573.5 (212 x 142 nozzle opening). Screwed with M4 button heads into the tapped edges of the flat bar frames (CH-FLATBAR). The spool and the nozzle have no plates of their own. | online laser-cut service | per DXF | local laser-cut shop | per DXF |  |  | drawings in mechanical/drawings (lint-box-front.dxf, lint-box-back.dxf, hood-bottom.dxf, hood-top.dxf, trunk-front.dxf, trunk-rear.dxf); the spool's foam face waits on the blower housing's inlet face, V-107; cost not yet collected
CH-FLATBAR | Aluminium flat bar for the duct frames | 1 | structure | 6061 or 6082 aluminium flat bar, cut to length with a hacksaw or chop saw, every edge hole tapped M4 on the drill press (3.3 tap drill, square to the edge): 30 x 8 (1-1/4 x 5/16 in), two 400 and one 316 for the lint box (the side bars' top ends cut at 43 degrees, one 8.5 hole each for the hang bolt); 40 x 8, two 136 and two 140 for the spool, two 158 and two 212 for the nozzle; 25 x 8 (1 x 5/16 in), two 257.5 and two 334 for the hood; 50 x 8 (2 x 5/16 in), two 573.5 and one 244 for the trunk (the side bars also tapped in their lower end face). About 4.5 m in all; lengths in drawings/frame-cut-list.csv | McMaster-Carr | 6061 aluminium flat bar, 5/16 in thick | Online Metals or a local metal supplier | 6061/6082 flat bar 8 mm thick |  |  | draft 8; imperial 5/16 in (7.94) stock is the same part; the model draws 8.0; cost not yet collected
CH-LINER | Throat liner strip and splice, 1.5 mm aluminium | 1 | structure | 5052-H32 (or 3003) aluminium sheet 1.5 mm, laser-cut: the strip 1482.4 x 41.3 with two 3.4 holes (drawings/liner.dxf), rolled by hand round a 471 form (a plywood disc) to an inside radius of 235.5, seam at the top; the splice 40 x 38.3 (drawings/liner-splice.dxf) inside the seam on two M3 x 6 button heads with nuts (CH-BOLT-M3). Stands between the door ring's back face and the front bulkhead; seat it against the bulkhead | online laser-cut service | per DXF, 1.5 mm 5052 | local laser-cut shop | per DXF |  |  | draft 8 (DECISIONS.md: the throat was open all round the opening); the only rolled part besides the drum sheet; cost not yet collected
CH-BOLT-M3 | Button head M3 and nuts | 30 | fastener | M3 button head stainless (ISO 7380, 2 mm hex key): M3 x 6 with nyloc nuts, 2 for the liner's splice; M3 x 5, 12 for the lint basket's clamp plates into the tapped 3 mm plates; spares | McMaster-Carr | M3 x 6 and M3 x 5 button head stainless | Fastenal | M3 x 6 and M3 x 5 button head stainless |  |  | draft 8; cost not yet collected
CH-BOLT-M8 | Button head M8 for the lint box | 2 | fastener | M8 x 20 button head stainless (ISO 7380, 5 mm hex key) with a 16 x 8.5 x 4 spacer each, through the lint box's side bars into the front stubs' end bores, tapped M8 (6.8 bore, the same tap as the feet) | McMaster-Carr | M8 x 20 button head stainless; aluminium spacer 16 OD x 8.5 ID x 4 | Fastenal | M8 x 20 button head stainless |  |  | draft 8; cost not yet collected
CH-DS-MOUNT | Door switch mounting | 2 | fastener | M4 x 8 button heads from the panel's front into the switch's tapped ears (or its bracket), on radius 288, 45 degrees right of bottom; the plunger hole 8.5 through the ring and the panel on radius 258 (both in the DXFs) | with CH-BOLT-M4 |  |  |  |  |  | draft 8; the ear pattern is the switch's own and is confirmed at V-115 before the panel is cut
CH-PS1-BRKT | Air-proving switch bracket | 1 | structure | 20 x 20 x 2 aluminium angle, 60 long, two 6.5 holes in one leg (M6 x 12 hex with nuts through the base pan at X 235 and 265, Y 70), two 4.5 holes in the other for M4 x 8 into the switch's bracket; the switch's own ears govern (V-205) | with CH-ANGLE-20 |  |  |  |  |  | draft 8; envelope 60 x 28 x 60 in the model
CH-EXHAUST | Exhaust pipe inside the cabinet | 1 | structure | 4 in (102 mm) rigid aluminium duct pipe, about 1 mm wall, cut to 609.5 (mechanical/drawings/frame-cut-list.csv): it slides 23 over the blower housing's 102 discharge collar at Y 192, runs straight along the bay floor's right side at X 230, Z 150, through the 106 port in the rear lower panel and 50 proud of it as the vent hose spigot; one 6.5 hole drilled on top at Y 300 for the air-proving tap (model draft 9). No elbows: the run is straight. | hardware store | 4 in rigid aluminum duct pipe (24 in or 5 ft length) | HVAC supply | 4 in x 5 ft aluminum snap-lock pipe |  |  | draft 9 replaces the elbows of draft 2 with a straight run; the cut length follows the bought housing's collar position (V-107); cost not yet collected
CH-EXH-CLAMP | Exhaust pipe clamps | 2 | fastener | Worm-drive hose clamps for 102 mm (4 in), stainless band 12 wide: one over the pipe on the housing's collar, one on the pipe just inside the rear lower panel, bearing on it (model draft 9). The builder's vent hose takes its own clamp on the spigot outside. | hardware store | 4 in worm-drive hose clamp | McMaster-Carr | worm-drive clamp for 4 in |  |  | draft 9; cost not yet collected
CH-TAP | Air-proving tap and tube | 1 | electrical | Brass barb fitting with a locknut for a 6.5 hole in the pipe (1/8 NPT or M6 thread, 5 mm barb) and 1 m of 6 mm (1/4 in) silicone tube rated 105 C from the barb to PS1's port (model draft 9: up to 240, over the exhaust thermostats, down in front of the outlet box) | McMaster-Carr | brass barbed fitting 1/8 NPT with locknut and 1/4 in silicone tubing | hardware store | brass barb and silicone fuel line |  |  | draft 9; which PS1 port and whether the tap moves are V-205; cost not yet collected
CH-BLOWER-PLATE | Blower plate and its feet, laser-cut 1.5 mm steel and angle | 1 | structure | Laser-cut 1.5 mm steel plate 260 x 245, 6 mm corner radii, with the spool's 140 x 120 bore and eight 4.5 holes (mechanical/drawings/blower-plate.dxf; the four housing holes are drawn on a nominal 176 x 120 and are drilled from the bought housing, V-107); two 90 mm pieces of CH-ANGLE-20 as feet, each with two 4.5 and two 6.5 holes drilled on the drill press; stands across the bay at Y 84 in front of the housing on four M6 through the base pan (model draft 9) | online laser-cut service | per DXF | local laser-cut shop | per DXF |  |  | draft 9; cut after V-107 closes; cost not yet collected
CH-BLANKS | Entry blanking plates, laser-cut 1.5 mm steel | 2 | structure | Two 60 x 44 plates with two 4.5 holes 42 apart (mechanical/drawings/entry-blank.dxf), inside the rear lower panel over the gas entry (25 at X -230, Z 150) and the condensate drain (20 at X -230, Z 66), M4 x 8 heads outside, nuts inside; a gas or heat pump build leaves the one it uses out (model draft 9) | online laser-cut service | per DXF | local laser-cut shop | per DXF |  |  | draft 9; cost not yet collected
CH-CLIPS | Cable clamps for the bay harness | 4 | fastener | Nylon P-clips (cable clamps) for a 12 mm bundle with a 4.5 mounting hole, on the base pan at X -250, Y 120, 280, 440 and 600, M4 x 8 and nuts under the pan (model draft 9) | McMaster-Carr | nylon cable clamp for 1/2 in bundle | Heyco | nylon cable clamp 12 mm |  |  | draft 9; cost not yet collected
CPM-TH1 | Exhaust air thermistor (TEMP_EXH) | 1 | electrical | Appliance-market dryer exhaust thermistor, NTC 10 kilohm at 25 C, two 6.3 mm spade terminals, plastic body with a sensing nib and one mounting hole (the model draws a 36 x 30 x 14 body with a 10 x 16 nib through a 12 x 18 slot and one M4 at 10 above its centre, on the bay side of the lint box's back plate at X 120, Z 160; model draft 9); its resistance table goes in the module's configuration (uci-spec 7.1) | PartSelect | dryer thermistor, 10 k NTC (Whirlpool 8577274 class) | AppliancePartsPros | dryer thermistor, 10 k NTC |  |  | unverified: a part class from memory, confirm the curve and the footprint before ordering (V-112); the slot and hole in lint-box-back.dxf follow the bought part; cost not yet collected
CPM-MOIST | Moisture sensor bar set (MOIST) | 1 | electrical | Appliance-market dryer moisture sensor bar set: two stainless strips on an insulating base with two mounting tabs and two spade terminals (the model draws a 90 x 30 x 8 envelope with two M4 at 35 either side of its centre, on the front bulkhead's drum side at 58 degrees right of bottom on radius 250, terminals through a 16 hole; model draft 9); the fallback is two 304 strips on a printed insulating base (uci-spec 7.2) | PartSelect | dryer moisture sensor bars (Whirlpool 3387223 class) | AppliancePartsPros | dryer moisture sensor |  |  | unverified: a part class from memory, confirm the footprint and the tab holes before ordering (V-112); the three holes in front-bulkhead.dxf follow the bought part; cost not yet collected
CH-HINGE | Door hinges, bolt-on lift-off (flag) type | 2 | wear | Stainless bolt-on lift-off hinge pair, 8 mm pin, leaves about 6 x 30 with two holes each; the model draws 18 mm knuckles 30 tall with the pin at X -278.5, 14 in front of the panel, one half on the ring (M6 countersunk), the other on the disc (M4 button heads from the front into the tapped leaf) | McMaster-Carr | stainless butt hinge 60 mm | hardware store | stainless butt hinge 60 mm |  |  | holes at V-115; the drawn hinge is a representation, the catalog part's leaf and pin positions replace it in the model; cost not yet collected
CH-LATCH | Door latch and strike | 1 | wear | Dryer door strike and catch from the appliance market, or a magnetic catch rated 5 kg | OEM parts channel | door catch kit | McMaster-Carr | magnetic catch |  |  | holes at V-115; cost not yet collected
CH-DOORSEAL | Door seal | 1 | wear | Dryer door seal from the appliance market, or closed-cell foam strip about 9 x 6 mm, as an annulus between radius 237 and 246 on the back of the disc (the model draws 6 thick in the 8 mm gap) | OEM parts channel | door seal | McMaster-Carr | closed-cell foam strip |  |  | cost not yet collected
CH-GASKET | Duct and flange gaskets | 1 | wear | Closed-cell silicone foam, 105 C: a 3 mm ring 150 outside, 125 inside, glued under the riser's hood round the collar hole (the heat module's collar rim brushes it, draft 7); 3 mm tape 8 wide, 2 x 190, between the lint box's side bars and the front bulkhead, compressed to 1.5 (draft 8); 2 mm tape 8 wide, 900, between the nozzle's bars and the rear bulkhead, compressed to 1; 6 mm tape 8 wide, 600, on the spool's rear edges against the blower's inlet face, compressed to 4 | McMaster-Carr | silicone foam strip | Grainger | silicone foam strip |  |  | draft 8: the tape thicknesses are the model's; the spool's 6 mm waits on the housing's inlet face (V-107); cost not yet collected
CH-PAINT | Finish for the plates | 1 | structure | Powder coat by the cutting service, or self-etching primer and appliance enamel | online laser-cut service | powder coat option | hardware store | primer and enamel |  |  | cost not yet collected
CH-DRUM-SHEET | Drum sheet, laser-cut 304 stainless, 0.8 mm | 1 | structure | One blank per mechanical/drawings/drum-sheet.dxf (1945.3 x 550 plus tabs), 304 2B finish, tabs folded by hand | online laser-cut service | per DXF, 0.8 mm 304 | local laser-cut shop | per DXF, 0.8 mm 304 |  |  | cut only after V-208; cost not yet collected
CH-DRUM-RINGS | Drum rings, laser-cut 304 stainless, 2 mm | 2 | structure | Per mechanical/drawings/drum-ring.dxf, 618.4 outside, 540 inside (draft 6), 30 tab holes on radius 301.2 | online laser-cut service | per DXF, 2 mm 304 | local laser-cut shop | per DXF, 2 mm 304 |  |  | cost not yet collected
CH-DRUM-SPLICE | Drum seam splice strip, laser-cut 304, 1 mm | 1 | structure | Per mechanical/drawings/drum-splice.dxf, 60 x 544 | online laser-cut service | per DXF, 1 mm 304 | local laser-cut shop | per DXF, 1 mm 304 |  |  | cost not yet collected
CH-DRUM-BAFFLE | Drum baffles, aluminum angle | 3 | structure | Aluminum angle 40 x 40 x 3 mm, 6063 or 6061, cut to 480 mm, drilled to the sheet's baffle holes, edges rounded with a file | McMaster-Carr | aluminum angle 40 x 40 x 3 | metal supplier | aluminum angle 40 x 40 x 3 |  |  | cost not yet collected
CH-DRUM-HW | Drum hardware | 100 | fastener | M4 x 8 button head stainless bolts with nuts and washers (60 tabs, 16 seam, spares); M6 x 12 button head stainless with nuts for the 12 baffle bolts (the baffle holes are 6.5) | McMaster-Carr | M4 button head stainless | Fastenal | M4 button head stainless |  |  | cost not yet collected
CH-ROLLERS | Drum support rollers | 4 | wear | Catalog dryer drum support roller, about 60 mm diameter, 25 wide, 10.5 bore or a bushing that takes a 10 mm shoulder, high-temperature tread; the shaft is CH-ROLLER-STUDS, not the kit's (draft 7) | appliance parts house | dryer drum roller kit (Whirlpool 349241T family or equivalent) | Supco or ERP (aftermarket) | equivalent |  |  | unverified: part number from memory, confirm before ordering; measured at V-102 (if the roller's bore is not 10, the stud changes); cost not yet collected
CH-ROLLER-STUDS | Roller studs | 4 | fastener | ISO 7379 shoulder screw 10 x 35, M8 thread, hex socket (5 mm key), with a 10 x 16 x 1.0 shim washer (DIN 988) under the head, a spacer 16 x 10.5 x 8.5, an M8 washer and an M8 nyloc nut on the far side of the bulkhead (draft 7); the shoulder's step bears on the bulkhead, the roller runs on the shoulder with 0.5 end float | McMaster-Carr | ISO 7379 shoulder screw 10 x 35 M8, stainless | Fastenal | shoulder bolt 10 x 35 M8 |  |  | draft 7; the spacer length follows the roller width (V-102); cost not yet collected
CH-GLIDES | Drum glides | 4 | wear | Nylon or PTFE-filled acetal pad, 45 x 20, 8 thick (front, two) and 9.5 thick (rear, two), two 4.5 holes 24 apart with hex pockets for M4 nuts on the drum side (draft 7); they ride on the drum rings' faces at 10 and 2 o'clock on radius 282 and take the drum's end thrust | appliance parts house | dryer drum glide pads (cut to size) or nylon bar stock | McMaster-Carr | nylon 6/6 bar 20 x 10, cut and drilled |  |  | draft 7: cut on the drill press from bar if no catalog pad fits; thickness pairs with the felt's compressed thickness (V-104); cost not yet collected
CH-FELT | Drum seal felt strip | 4 m | wear | High-temperature felt, 10 mm thick and 18 to 25 mm wide (it compresses to the 8.5 mm between the front bulkhead and the ring face and fills the 10 mm at the rear), wool or polyester, laid in two arcs on each bulkhead round the glides: a long one round the bottom (1282 mm on the glide radius, mechanical/drawings/felt-seal-long.dxf) and a short one over the top (396 mm, felt-seal-short.dxf), glued with high-temperature contact adhesive | appliance parts house | dryer felt seal strip | McMaster-Carr | felt strip, high temperature |  |  | unverified: part number from memory, confirm before ordering; V-104; the arcs and the glides are drawn in draft 7; cost not yet collected
CH-BELT | Belts: countershaft and drum | 2 | wear | J-section poly-V, 6 ribs: one countershaft belt and one drum belt, each the nearest catalog length to the draft 10 layout (V-012) | Gates or PIX (via distributor) | Micro-V J6, lengths per draft 10 | Optibelt or Bando | J6, lengths per draft 10 |  | 2026-11-09 | Changed 2026-11-09: 6 ribs to match the sheaves; lengths are set by the draft 10 layout, so not yet bought
CH-IDLER | Drum belt idler, spring and posts | 1 | wear | Flat-belt idler pulley for up to 7/8 in belt, 2.4 in OD, ball bearing, 3/8 in shaft, on a 3/8 in bolt on the idler arm, on the drum belt's slack run; extension spring 50 to 80 N at working length on two posts (positions per draft 10) | McMaster-Carr | 6235K61 idler pulley; spring per draft 10 | Grainger | flat idler pulley with bearing | 18.98 | 2026-11-09 | Changed 2026-11-09: 2.4 in idler on a 3/8 in bolt replaces the 40 mm one on M8; nylon tread, check it against the bay temperature
CH-IDLER-ARM | Idler arm and brackets | 1 | structure | Aluminum flat bar 25 x 4, 175 mm, with two 8.5 holes 150.4 apart and one 5.2 hole (the arm); two pieces of aluminum angle 40 x 40 x 3, 50 mm (pivot bracket and spring bracket), each with two 6.5 holes for M6 x 12 bolts through the base pan and one 8.5 or 5.2 hole | metal supplier | aluminum flat bar 25 x 4 and angle 40 x 40 x 3 | McMaster-Carr | aluminum flat bar 25 x 4 and angle 40 x 40 x 3 |  |  | drawn in the model as a placeholder for the catalog idler kit (V-105); cost not yet collected
CH-HANDLE | Door handle | 1 | structure | D handle, 128 mm hole centres, about 14 mm round, 30 mm standoff, stainless or aluminum, M4 tapped | McMaster-Carr | D handle 128 mm centres | hardware store | D handle 128 mm centres |  |  | two M4 x 10 button heads from the back of the disc; cost not yet collected
CH-BOLT-M4 | Button head M4 and nuts | 300 | fastener | M4 button head stainless (ISO 7380, 2.5 mm hex key) with nyloc nuts where a nut is drawn: M4 x 8, 8 for the door ring (the lint box's front plate sits 2.5 behind their tips), 8 for the tray rail brackets, 64 for the heat module box and 22 for the power module (draft 7), 4 for the front drum glides, about 100 into the duct frames' tapped edges (draft 8: lint box, spool, hood, trunk, nozzle), 2 for the door switch, 6 for the exhaust thermostats; M4 x 10, 6 for the Tier 0 faceplate, 2 for the handle, 4 for the lift-off hinge halves, 4 for the rear drum glides, 16 through the bulkheads and foam into the lint box's side bars and the nozzle's bars, 2 into the basket's pull; M4 x 40, 3 through the lint box's bottom bar into the spool's; draft 9: M4 x 8, 4 into the blower housing, 4 into the blower plate's feet, 4 for the entry blanks, 4 for the cable clamps; M4 x 16, 2 for the moisture bar set; M4 x 20, 1 for the exhaust thermistor; spares. One head type, one key. | McMaster-Carr | M4 x 10 button head stainless | Fastenal | M4 x 10 button head stainless |  |  | draft 8 counts from the model's hardware sets; cost not yet collected
CH-TNUT-M4 | T-nuts M4 for the 6 mm slot | 12 | fastener | Drop-in or sliding T-nut, M4, for 6 mm slot 2020: 4 for the tray rail brackets, 4 for the heat module tray and box, spares (draft 7); plus 4 M4 T-nuts for the 8 mm slot for the brackets' other legs | Misumi | HNTT5-4 | McMaster-Carr | 2020 T-nut M4 |  |  | unverified: part number from memory, confirm before ordering; cost not yet collected
CH-ANGLE-20 | Aluminium angle 20x20x2 | 3 m | structure | Aluminium angle 20 x 20 x 2, cut on the hand saw to the lengths in mechanical/drawings/frame-cut-list.csv: heat module box 12 pieces (2 x 205, 2 x 283, 2 x 165, 2 x 290, 4 x 72), element rails 2 x 198, terminal plate foot 290, power module barrier 150 (draft 7), the PS1 bracket 60 (draft 8), the blower plate's feet 2 x 90 (draft 9); drilled 4.5 and 6.5 on the drill press | metal supplier | aluminium angle 20 x 20 x 2 | McMaster-Carr | aluminum angle 20 x 20 x 2 mm |  |  | draft 7; cost not yet collected
CH-CSK | Countersunk screws for the fixed hinge halves | 6 | fastener | M6 x 16 countersunk socket stainless with nyloc nuts (4, hinge halves to the ring and panel); spares | McMaster-Carr | M6 countersunk socket stainless | Fastenal | M6 countersunk socket stainless |  |  | see design-rules section 8 on head types; cost not yet collected
CH-MOTOR-MOUNT | Motor base and countershaft bearings | 1 | wear | NEMA 56 rigid base bolted to a slotted motor plate for belt tension; 5/8 in keyed countershaft, about 200 mm, in two pillow block ball bearings with replaceable inserts; 3/16 in square key stock | McMaster-Carr | 6361K33 SKF pillow block (2, insert 6361K212), 1497K141 shaft 5/8 x 12 in keyed (cut to length), 98830A150 key stock | Dodge or generic UCP202-10 (via distributor) | 5/8 in pillow block | 75.22 x 2; 25.13; 1.41 | 2026-11-09 | Changed 2026-11-09: replaces the appliance motor cradle kit; the motor plate and shaft brackets are laser-cut in draft 10
CH-LINT | Lint basket: sector plates, clamp plates, mesh, pull | 1 | wear | A basket for the curved slot in the front bulkhead (radius 238 to 267, 72 degrees about the drum axis, below the door opening; draft 8): two laser-cut 3 mm stainless (or steel) sector plates between radius 239.5 and 265.5, 35.6 degrees each side of straight down, tapped M3 in six places each (basket-far-plate.dxf; basket-lip-plate.dxf with its lip ring to radius 232 and 268.5 and a 64 wide tab into the opening), two 1.5 mm clamp plates (basket-far-clamp.dxf, basket-lip-clamp.dxf), a strip of stainless 18 x 16 insect mesh 42 x 350 wrapped round the plates with its edges folded 5 mm and clamped (12 x M3 x 5), and a catalog 64 mm D-pull (two M4 x 10 from the tab's back). Slides through the slot with 0.9 each side; the pull sits at the bottom of the door opening | online laser-cut service | plates per DXF; mesh and pull from any hardware store | local laser-cut shop | plates per DXF |  |  | draft 8; fit at V-018 (slot clearance, pull-out through the door); cost not yet collected
