OpenSourceAppliances/dryer/bom/order-plan.csv

wave | package | ref | item | qty | give | source_1 | pn_1 | source_2 | pn_2 | gate | flags | note
1 | motor-drive | CH-BLOWER | Blower, packaged with its own motor | 1 | Direct-drive centrifugal blower, 115 V, ball bearings, thermally protected, about 230 cfm at 0.5 in water, rated for at least 400 F inlet air; outlet transition to the 4 in exhaust pipe | Grainger | Dayton 1TDV4 (6-1/8 in wheel, 1/15 hp, 1640 rpm, 0.86 A, 450 F max inlet, rectangular 3-3/4 x 4-1/4 in outlet, 11-1/8 x 8-11/16 x 10-3/8 in) | Fasco or Rotom (via distributor) | same class
1 | motor-drive | CH-IDLER | Drum belt idler, spring and posts | 1 | Flat-belt idler pulley for up to 7/8 in belt, 2.4 in OD, ball bearing, 3/8 in shaft, on a 3/8 in bolt on the idler arm, on the drum belt's slack run; extension spring 50 to 80 N at working length on two posts (positions per draft 10) | McMaster-Carr | 6235K61 idler pulley; spring per draft 10 | Grainger | flat idler pulley with bearing
1 | motor-drive | CH-M1 | Drum motor | 1 | 120 V single phase, 1/3 hp, 1725 rpm, NEMA 56 frame, capacitor start, totally enclosed fan cooled, ball bearings, built-in automatic thermal protector, 5/8 in keyed shaft, UL recognized | Grainger | Dayton 5K121 | Leeson, Marathon, Baldor or WEG (via distributor) | same rating, NEMA 56, TEFC, capacitor start
2 | motor-drive | CH-BELT | Belts: countershaft and drum | 2 | J-section poly-V, 6 ribs: one countershaft belt and one drum belt, each the nearest catalog length to the draft 10 layout (V-012) | Gates or PIX (via distributor) | Micro-V J6, lengths per draft 10 | Optibelt or Bando | J6, lengths per draft 10 | V-012, V-105 | no price yet
2 | motor-drive | CH-PULLEY | Drive sheaves: motor, countershaft driven, countershaft drive | 3 | J-section poly-V, 6 ribs: 1.63 in pitch on 5/8 in bore (motor); 4.53 in pitch, SH bushing bore (countershaft driven); 1.93 in pitch on 5/8 in bore (countershaft drive to the drum). 1725 x 1.63 / 4.53 = 621 rpm; 621 x 49.0 / 622 = 49 drum rpm | Texas Belting (B&B) and McMaster-Carr | B&B 6J160X5/8; McMaster 1405K13 (6J, 4.5 in OD, SH) with 6086K212 SH bushing 5/8 in; B&B 6J190X5/8 | TB Woods, Mitsuboshi or Powerdrive | 6J16058 and 6J19058 (TB Woods), 6J450SH (B&B) | V-105, V-106
1 | appliance | CH-DOORSEAL | Door seal | 1 | Dryer door seal from the appliance market, or closed-cell foam strip about 9 x 6 mm, as an annulus between radius 237 and 246 on the back of the disc (the model draws 6 thick in the 8 mm gap) | OEM parts channel | door seal | McMaster-Carr | closed-cell foam strip |  | no price yet
1 | appliance | CH-FELT | Drum seal felt strip | 4 m | High-temperature felt, 10 mm thick and 18 to 25 mm wide (it compresses to the 8.5 mm between the front bulkhead and the ring face and fills the 10 mm at the rear), wool or polyester, laid in two arcs on each bulkhead round the glides: a long one round the bottom (1282 mm on the glide radius, mechanical/drawings/felt-seal-long.dxf) and a short one over the top (396 mm, felt-seal-short.dxf), glued with high-temperature contact adhesive | appliance parts house | dryer felt seal strip | McMaster-Carr | felt strip, high temperature | V-104 | part no. unverified; no price yet | measure on arrival: V-104
1 | appliance | CH-GLIDES | Drum glides | 4 | Nylon or PTFE-filled acetal pad, 45 x 20, 8 thick (front, two) and 9.5 thick (rear, two), two 4.5 holes 24 apart with hex pockets for M4 nuts on the drum side (draft 7); they ride on the drum rings' faces at 10 and 2 o'clock on radius 282 and take the drum's end thrust | appliance parts house | dryer drum glide pads (cut to size) or nylon bar stock | McMaster-Carr | nylon 6/6 bar 20 x 10, cut and drilled | V-104 | no price yet | measure on arrival: V-104
1 | appliance | CH-LATCH | Door latch and strike | 1 | Dryer door strike and catch from the appliance market, or a magnetic catch rated 5 kg | OEM parts channel | door catch kit | McMaster-Carr | magnetic catch | V-115 | no price yet | measure on arrival: V-115
1 | appliance | CH-MOTOR-MOUNT | Motor base and countershaft bearings | 1 | NEMA 56 rigid base bolted to a slotted motor plate for belt tension; 5/8 in keyed countershaft, about 200 mm, in two pillow block ball bearings with replaceable inserts; 3/16 in square key stock | McMaster-Carr | 6361K33 SKF pillow block (2, insert 6361K212), 1497K141 shaft 5/8 x 12 in keyed (cut to length), 98830A150 key stock | Dodge or generic UCP202-10 (via distributor) | 5/8 in pillow block
1 | appliance | CH-ROLLERS | Drum support rollers | 4 | Catalog dryer drum support roller, about 60 mm diameter, 25 wide, 10.5 bore or a bushing that takes a 10 mm shoulder, high-temperature tread; the shaft is CH-ROLLER-STUDS, not the kit's (draft 7) | appliance parts house | dryer drum roller kit (Whirlpool 349241T family or equivalent) | Supco or ERP (aftermarket) | equivalent | V-102 | part no. unverified; no price yet | measure on arrival: V-102
1 | appliance | CPM-CORD-240 | Cord, electric build | 1 | Listed dryer cord, NEMA 14-30P, 4-wire, 10 AWG, 1.8 m, ring or spade ends | appliance parts house | 4-wire 30 A dryer cord | hardware store | 4-wire 30 A dryer cord |  | no price yet
1 | appliance | CPM-MOIST | Moisture sensor bar set (MOIST) | 1 | Appliance-market dryer moisture sensor bar set: two stainless strips on an insulating base with two mounting tabs and two spade terminals (the model draws a 90 x 30 x 8 envelope with two M4 at 35 either side of its centre, on the front bulkhead's drum side at 58 degrees right of bottom on radius 250, terminals through a 16 hole; model draft 9); the fallback is two 304 strips on a printed insulating base (uci-spec 7.2) | PartSelect | dryer moisture sensor bars (Whirlpool 3387223 class) | AppliancePartsPros | dryer moisture sensor | V-112 | part no. unverified; no price yet | measure on arrival: V-112
1 | appliance | CPM-S1 | Door switch, contact 1 (mains, motor line) | 1 | Listed appliance dryer door switch, contact rated for the motor at 120 V including starting current, 6.3 mm tabs | Whirlpool (any appliance parts house) | 3406107 family | Supco or ERP (aftermarket) | equivalent to 3406107 |  | part no. unverified; no price yet
1 | appliance | CPM-TF2 | Exhaust thermal fuse | 1 | One-shot thermal cutoff, about 91 C (196 F), 6.3 mm tabs, mounts on the blower housing; carries coil current only here | Whirlpool Parts | WP3392519 | Ferguson | SET401 (Supco, 25 A) |  | no price yet
1 | appliance | CPM-TH1 | Exhaust air thermistor (TEMP_EXH) | 1 | Appliance-market dryer exhaust thermistor, NTC 10 kilohm at 25 C, two 6.3 mm spade terminals, plastic body with a sensing nib and one mounting hole (the model draws a 36 x 30 x 14 body with a 10 x 16 nib through a 12 x 18 slot and one M4 at 10 above its centre, on the bay side of the lint box's back plate at X 120, Z 160; model draft 9); its resistance table goes in the module's configuration (uci-spec 7.1) | PartSelect | dryer thermistor, 10 k NTC (Whirlpool 8577274 class) | AppliancePartsPros | dryer thermistor, 10 k NTC | V-112 | part no. unverified; no price yet | measure on arrival: V-112
1 | appliance | CPM-T_HI | Cycling thermostat, high | 1 | Bimetal disc thermostat, normally closed, L155-25 (opens about 68 C, closes about 54 C), 6.3 mm tabs, blower housing mount | Whirlpool (any appliance parts house) | 3387134 family | Supco or ERP (aftermarket) | equivalent to 3387134 |  | part no. unverified; no price yet
1 | appliance | CPM-T_LO | Cycling thermostat, low | 1 | Bimetal disc thermostat, normally closed, L135-25 (opens about 57 C), 6.3 mm tabs, blower housing mount | appliance parts house | L135-25 disc thermostat | Supco or ERP (aftermarket) | L135-25 disc thermostat |  | part no. unverified; no price yet
1 | appliance | HE-R1 | Heating element on its frame | 1 | Open-coil dryer heating element on its steel frame with ceramic insulators, 5400 W at 240 V, appliance market; 10.5 x 7.5 x 2 in (267 x 190 x 51) from a seller listing, drawn as an envelope inside the laser-cut box (draft 7) | PartSelect | 279838 (Whirlpool) | AppliancePartsPros | AP3094254 (Whirlpool 279838) | V-108 | no price yet | measure on arrival: V-108
1 | appliance | HE-TF1 | Heater box thermal cutoff | 1 | One-shot thermal cutoff for the heater box, rated for the element current, appliance market; sold in the 279816 kit with the high-limit | appliance parts house | 279816 kit (Whirlpool), cutoff 3977393 | Supco or ERP (aftermarket) | equivalent to 279816 kit |  | part no. unverified; no price yet
1 | appliance | HE-T_HL | Heater box high-limit thermostat | 1 | Bimetal disc high-limit, normally closed, auto reset, rated for the element current, appliance market; in the 279816 kit | appliance parts house | 279816 kit (Whirlpool), high-limit 3390291 | Supco or ERP (aftermarket) | equivalent to 279816 kit |  | part no. unverified; no price yet
1 | electrical | CPM-CB1 | Supplementary circuit breaker, 120 V side | 1 | 1-pole, 10 A, C curve, DIN rail, UL 489 listed (preferred) or UL 1077 recognized, or IEC 60947-2 outside North America | Eaton | FAZ-C10/1-SP (FAZ, UL 1077; Digi-Key 5730-FAZ-C10/1-SP-ND) | ABB | S201-C10 (IEC; in North America use the UL-marked S200 family instead; unverified) |  | part no. unverified; no price yet
1 | electrical | CPM-DIN | DIN rail, 35 mm, five 140 mm lengths (rails A1, A2, A3, B1, B2 on the power module plate) | 5 | 35 mm x 7.5 mm steel DIN rail, EN 60715, slotted, cut to 140 mm (draft 7: five short rails across the 150 wide plate, two M4 each) | McMaster-Carr | 35 mm DIN rail | AutomationDirect | DN-R35S1 family |  | part no. unverified; no price yet
1 | electrical | CPM-F1 | Fuse terminal and fuse, supply input | 1 | DIN rail fuse terminal for 5 x 20 mm fuse, with a 2 A time-delay 250 V fuse | Phoenix Contact | UK 5-HESI family | Dinkle | DK4N-F family |  | part no. unverified; no price yet
1 | electrical | CPM-F2 | Fuse terminal and fuse, control module rail | 1 | Same terminal as CPM-F1 with a 2 A fuse, or a 2 A hold resettable PTC on a carrier | Phoenix Contact | UK 5-HESI family | Dinkle | DK4N-F family |  | part no. unverified; no price yet
1 | electrical | CPM-GROMMET | Panel grommets for the cord and the harnesses | 5 | Rubber grommets for 1.5 mm panels: two for 22 mm holes (the cord through the bay ceiling, the console harness through the top panel at X -225, Y 690), one for a 30 mm hole (the bay harness through the bay ceiling at X -200, Y 690) and two for 16 mm holes (the door switch cable and the moisture pair through the bay ceiling at X 290, Y 60 and the front bulkhead at X 290, Z 330; model draft 9, 12 in draft 8); 105 C or better | McMaster-Carr | rubber grommets for 16, 22 and 30 mm holes, 1.5 mm panel | Heyco | grommets for 16 mm and 22 mm and 30 mm holes |  | no price yet
1 | electrical | CPM-K_MOTOR | Contactor, motor | 1 | IEC mini contactor, AC-3 9 A or more at 120 V, 24 V DC coil with built-in suppression, listed; one pole used; 45 x 58 x 57 class so it fits the 97 mm between the power module plate and the rear upper panel (draft 7) | Schneider Electric | LP4K0910BW3 (TeSys K, 24 V DC low consumption coil, built-in suppressor) | Schneider Electric | LP1K0910BD (TeSys K, 24 V DC coil, no suppressor: add a diode across A1-A2) |  | no price yet
1 | electrical | CPM-PS1 | Air-proving switch | 1 | Listed air pressure switch, normally open, closes on blower pressure, 24 V DC contact, setpoint to be measured on the prototype | Cleveland Controls | NS2 series | Honeywell | IS series |  | part no. unverified; no price yet
1 | electrical | CPM-PSU | Power supply, 24 V DC | 1 | 24 V DC, 2.5 A, 60 W, universal input 85 to 264 V AC, listed, DIN rail mount | Digi-Key | HDR-60-24 (Mean Well) | Jameco | HDR-60-24 (Mean Well) |  | no price yet
1 | electrical | CPM-PTC | Resettable fuse, status lines (PTC1, PTC2, PTC3) | 3 | PTC resettable fuse, 100 mA hold, 30 V or more, radial, mounted in a DIN terminal with a component carrier or a small screw-terminal block | Littelfuse | 60R010XU | Bourns | MF-R010 |  | part no. unverified; no price yet
1 | electrical | CPM-RLY | Interface relay, request lines (RLY_MOTOR, RLY_HEAT, RLY_HEAT_LO) | 3 | Slim interface relay module, 24 V DC coil with suppression diode and LED, 1 changeover contact, 6 A, DIN rail, 6.2 mm | RS Components | 38.51.7.024.0050 (Finder) | FactoryMation | 38.51.7.024.0050 (Finder) |  | no price yet
1 | electrical | CPM-S2 | Door switch, contact 2 (SELV) | 1 | Listed snap-action limit switch, 24 V DC, 1 A or more, roller or lever actuator, on the same door actuator as S1 | Honeywell (MICRO SWITCH) | V7 or V15 series | ZF Electronics (Cherry) | D4 series |  | part no. unverified; no price yet
1 | electrical | CPM-STRAIN | Cord strain relief | 1 | Listed cord strain relief bushing sized to the cord, PG16 or 1/2 in NPT thread with a locknut, through the 22 mm hole in the base pan at X -275, Y 690 (draft 7: the cord comes up through the pan, up the bay and through a 22 mm grommet in the bay ceiling to the power module, and runs under the pan to the back) | Heyco | Pigtail strain relief family | McMaster-Carr | strain relief bushing | V-112 | part no. unverified; no price yet | measure on arrival: V-112
1 | electrical | CPM-TERM | Ferrules, ring terminals, 6.3 mm quick-disconnects, wire labels | 1 | Insulated ferrules for 10 to 20 AWG; insulated ring terminals; insulated 6.3 mm female quick-disconnects; heat-shrink wire markers | McMaster-Carr | assorted | electrical distributor | assorted |  | no price yet
1 | electrical | CPM-TP | Twisted pair, sensors | 1 | 22 AWG twisted pair, 105 C, brown/brown-white, green/green-white, gray/gray-white | electrical distributor | 22 AWG twisted pair | McMaster-Carr | 22 AWG twisted pair |  | no price yet
1 | electrical | CPM-WIRE | Appliance wire, 105 C, 600 V: 10 AWG black red white green; 14 AWG black white green; 18 AWG black white green blue white/blue; 20 AWG blue orange yellow | 1 | Stranded appliance wire, 105 C, 600 V, colors as in the wire list | electrical distributor | MTW or TEW wire by color and gauge | McMaster-Carr | MTW or TEW wire by color and gauge |  | no price yet
1 | electrical | CPM-X1 | Terminal blocks, cord in (L1, L2, N) plus one ground block | 4 | DIN rail screw or spring terminal block, 600 V, 30 A or more, accepts 10 AWG (6 mm2); ground block of the same family | Phoenix Contact | UK 6 N family and UK 6 N PE | Dinkle | DK6N family and DK6N-PE |  | part no. unverified; no price yet
1 | electrical | CPM-X2 | Terminal blocks, heat module mains (L1, L2, N) plus one ground block | 4 | Same as CPM-X1 | Phoenix Contact | UK 6 N family and UK 6 N PE | Dinkle | DK6N family and DK6N-PE |  | part no. unverified; no price yet
1 | electrical | CPM-X3 | Terminal blocks, motor and door switch S1, plus one ground block | 5 | DIN rail terminal block, 600 V, 20 A or more, accepts 14 AWG; ground block of the same family | Phoenix Contact | UK 2.5 N family and UK 2.5 N PE | Dinkle | DK2.5N family and DK2.5N-PE |  | part no. unverified; no price yet
1 | electrical | CPM-X4-X6 | Terminal blocks, SELV side (X4 heat module 4, X5 chassis switches 10, X6 sensors 6) | 20 | DIN rail terminal block, 2.5 mm2, 24 V service | Phoenix Contact | UK 2.5 N family | Wago | 2002-1201 family |  | part no. unverified; no price yet
1 | electrical | HE-CS1 | Current switch for STAT_HEAT_ON | 1 | Clamp-type current-operated switch, listed, normally open, pickup adjustable or fixed below 5 A, contact rated 24 V DC; or the contactor's auxiliary contact block as the minimum | Veris Industries | H908 family | Schneider Electric | LADN11 auxiliary contact block (minimum alternative) |  | part no. unverified; no price yet
1 | electrical | HE-DIN | DIN rail and end clamps on the terminal plate | 1 | 35 x 7.5 DIN rail cut to 280 with two M4, two end clamps (CLIPFIX 35 class), one partition plate between the mains and SELV strips (draft 7) | McMaster-Carr | 35 mm DIN rail and end clamps | AutomationDirect | DN-R35S1 family and DN-EB35 end clamps |  | no price yet
1 | electrical | HE-K_HEAT | Heater contactor | 1 | IEC contactor, 2 poles used, AC-1 32 A or more at 240 V, 24 V DC coil, listed | RS Components | LC1D18BD (Schneider Electric) | Crescent Electric | LC1D18BD (Schneider Electric) | V-112 | no price yet | measure on arrival: V-112
1 | electrical | HE-WIRE | Element leads | 1 | 10 AWG high-temperature appliance wire (200 C class) with listed high-temperature ring terminals for the element; 10 AWG 105 C for the rest of the tray | electrical distributor | high-temperature appliance wire 10 AWG | McMaster-Carr | high-temperature appliance wire 10 AWG |  | no price yet
1 | electrical | HE-X | Terminal blocks on the tray, mains (L1, L2, N) plus ground, and SELV (HEAT_EN, 0V, HEAT_ON x2) | 8 | Same families as CPM-X1 and CPM-X4-X6, two separate strips | Phoenix Contact | UK 6 N, UK 2.5 N | Dinkle | DK6N, DK2.5N |  | part no. unverified; no price yet
1 | electrical | T0-K1 | Hold relay with socket | 1 | Plug-in relay, 24 V DC coil with suppression diode, 2 changeover contacts, 5 A or more, with DIN or panel socket | Omron | Omron MY2N-D2 DC24 (S) (current catalogue code MY2N-D2-GS) with PYFZ-08-E DIN socket | Finder | 55.32.9.024 series with 94.72 socket |  | part no. unverified; no price yet
1 | electrical | T0-PLUG-HSG | Plug housing to J1 | 1 | Mini-Fit Jr. 16-circuit plug housing with male crimp terminals | Molex (via Digi-Key or Mouser) | 5559-16P (39-01-2165) | Wurth Elektronik (via Digi-Key or Mouser) | WR-MPC4 16-pin plug housing |  | part no. unverified; no price yet
1 | electrical | T0-PLUG-TERM | Male crimp terminals for the plug | 8 | Mini-Fit Jr. male crimp terminal, 18 to 24 AWG, tin | Molex (via Digi-Key or Mouser) | 5558 (39-00-0059) | Wurth Elektronik (via Digi-Key or Mouser) | WR-MPC4 male crimp terminal |  | part no. unverified; no price yet
1 | electrical | T0-RAIL | DIN rail segment and standoffs for K1 | 1 | 100 mm of 35 mm DIN rail on two M4 x 12 mm standoffs with M4 x 8 button head screws (2.5 mm hex key), 24 below the faceplate's centre line (faceplate draft 2) | McMaster-Carr | 35 mm DIN rail, M4 standoffs | AutomationDirect | DN-R35S1 family, M4 standoffs |  | no price yet
1 | electrical | T0-START | Start push button | 1 | Momentary push button, normally open, 22 mm panel mount, 24 V DC rated, with one NO contact block | Schneider Electric | XB4BA31 (green, one NO contact included) | Eaton | M22-D-G with M22-K10 |  | part no. unverified; no price yet
1 | electrical | T0-SW | Heat selector switch | 1 | 22 mm panel-mount 3-position selector switch, maintained, with two normally open contact blocks (one closed in LOW, one in HIGH), rated for 24 V DC | Schneider Electric | XB4BD33 (3-position maintained, two NO contacts included) | Eaton | M22-WRK3 with two M22-K10 contact blocks |  | part no. unverified; no price yet
1 | electrical | T0-TMR | Spring-wound interval timer, DRY TIME and HEAT TIME | 2 | Spring-wound interval timer, 0 to 2 h, SPST normally open contact closed while timing, no HOLD position, standard wall-device yoke, 125 to 277 V AC rated | Platt | FD2HW (Intermatic) | Zoro | FD2HW (Intermatic) |  | no price yet
1 | electrical | T0-WIRE | Wire and terminals inside the module | 1 | 0.5 mm2 (20 AWG) stranded, 105 C; 6.3 mm insulated quick-disconnects; ring terminals for the switch and button | electrical distributor | assorted | McMaster-Carr | assorted |  | no price yet
1 | electrical | UCI-CRIMP | Crimp tools | 2 | Ratcheting crimper for Mini-Fit Jr. terminals; ratcheting crimper for JST XH terminals | generic tool maker (any) | Mini-Fit crimper | generic tool maker (any) | XH crimper |  | no price yet
1 | electrical | UCI-J1-HSG | J1 receptacle housing, chassis side | 1 | Mini-Fit Jr. 16-circuit (2 x 8) receptacle housing, 4.2 mm pitch, with latch | Molex (via Digi-Key or Mouser) | 5557-16R (39-01-2160) | Wurth Elektronik (via Digi-Key or Mouser) | WR-MPC4 16-pin receptacle housing |  | part no. unverified; no price yet
1 | electrical | UCI-J1-TERM | J1 female crimp terminals | 20 | Mini-Fit Jr. female crimp terminal, 18 to 24 AWG, tin | Molex (via Digi-Key or Mouser) | 5556 (39-00-0039) | Wurth Elektronik (via Digi-Key or Mouser) | WR-MPC4 female crimp terminal |  | part no. unverified; no price yet
1 | electrical | UCI-J2-HSG | J2 housing, chassis side | 1 | JST XH 8-position housing, 2.5 mm pitch | JST (via Digi-Key or Mouser) | XHP-8 | compatible maker (via Digi-Key or Mouser) | XH-compatible 8-position housing |  | part no. unverified; no price yet
1 | electrical | UCI-J2-TERM | J2 crimp terminals | 10 | JST XH female crimp terminal, 22 to 28 AWG | JST (via Digi-Key or Mouser) | SXH-001T-P0.6 | compatible maker (via Digi-Key or Mouser) | XH-compatible crimp terminal |  | part no. unverified; no price yet
1 | extrusion | CH-BRKT | Corner brackets for 4040 | 52 | Cast or extruded inside corner bracket for 8 mm slot 4040, with M8 or M6 hardware | Misumi | HBLFSN8 | McMaster-Carr | 4040 corner bracket |  | part no. unverified; no price yet
1 | extrusion | CH-BRKT-2020 | Corner brackets for the 2020 tray rails | 4 | 2020 inside corner bracket (20 x 20 x 17, 2.5 thick, one hole per leg) with M4 x 8 button heads: one into the rail's side slot with an M4 T-nut for the 6 mm slot, one into the 4040 end rail's top slot with an M4 T-nut for the 8 mm slot (draft 7) | Misumi | HBLFSN5 | McMaster-Carr | 2020 corner bracket |  | part no. unverified; no price yet
1 | extrusion | CH-EXT-2020 | 2020 T-slot, 6 mm slot, cut to length | 2 pieces | Cut list (mm): 2 x 750. Total 1.50 m; one cut piece per line on a Misumi order, or 1 x 2 m bars to cut yourself | Misumi | HFS5-2020 | McMaster-Carr | 2020 T-slot framing | V-113 | part no. unverified; no price yet | the posts' bottom ends take the feet; the front stubs' ends take the lint box hang bolts
1 | extrusion | CH-EXT-4040 | 4040 T-slot, 8 mm slot, cut to length | 27 pieces | Cut list (mm): 4 x 1000 (4 tapped M8 in one end); 6 x 670; 9 x 610; 4 x 200; 2 x 135 (2 tapped M8 in one end); 2 x 58.5. Total 14.70 m; one cut piece per line on a Misumi order, or 8 x 2 m bars to cut yourself | Misumi | HFS8-4040 | McMaster-Carr | 4040 T-slot framing, 8 mm slot | V-113 | part no. unverified; no price yet | the posts' bottom ends take the feet; the front stubs' ends take the lint box hang bolts
1 | extrusion | CH-FEET | Leveling feet | 4 | M8 leveling foot with a 50 mm pad, 150 kg class each, hex 8 tall, screwed into the post's 6.8 mm centre bore tapped M8, through an 8.5 hole in the base pan; 18 mm from the floor to the pan run in, so the cord passes under the pan with 3 mm to spare | Misumi | leveling foot M8 | McMaster-Carr | leveling foot M8 | V-113 | no price yet | measure on arrival: V-113
1 | extrusion | CH-TNUT-M8 | T-nuts M8 and M8 x 16 hex bolts for the brackets | 80 | M8 T-nut, 8 mm slot, and M8 x 16 hex head | Misumi | HNTT8-8 | McMaster-Carr | M8 T-nut, M8 x 16 hex head |  | part no. unverified; no price yet
1 | fasteners | CH-CLIPS | Cable clamps for the bay harness | 4 | Nylon P-clips (cable clamps) for a 12 mm bundle with a 4.5 mounting hole, on the base pan at X -250, Y 120, 280, 440 and 600, M4 x 8 and nuts under the pan (model draft 9) | McMaster-Carr | nylon cable clamp for 1/2 in bundle | Heyco | nylon cable clamp 12 mm |  | no price yet
1 | fasteners | CH-ROLLER-STUDS | Roller studs | 4 | ISO 7379 shoulder screw 10 x 35, M8 thread, hex socket (5 mm key), with a 10 x 16 x 1.0 shim washer (DIN 988) under the head, a spacer 16 x 10.5 x 8.5, an M8 washer and an M8 nyloc nut on the far side of the bulkhead (draft 7); the shoulder's step bears on the bulkhead, the roller runs on the shoulder with 0.5 end float | McMaster-Carr | ISO 7379 shoulder screw 10 x 35 M8, stainless | Fastenal | shoulder bolt 10 x 35 M8 | V-102 | no price yet | measure on arrival: V-102
1 | fasteners | CPM-GND | Ground stud kit | 1 | M6 stud, nuts, star washers, ring terminals for 10 AWG and 14 AWG and 18 AWG | McMaster-Carr | M6 ground stud and ring terminals | electrical distributor | M6 ground stud and ring terminals |  | no price yet
1 | fasteners | T0-NUTS | Nuts for the timer yoke screws | 4 | 6-32 hex nuts with flat washers, for the 6-32 screws supplied with the timers | hardware store | 6-32 nuts | McMaster-Carr | 6-32 nuts |  | no price yet
1 | fasteners | model | M6 x 12 hex head bolt | 285 | ISO 4017 / DIN 933, 8.8 zinc | McMaster-Carr |  | Fastenal or Bolt Depot |  |  | no price yet | the model places 259; panels, console, motor cradles, PS1, blower plate, idler brackets
1 | fasteners | model | M6 flat washer | 280 | ISO 7089, zinc | McMaster-Carr |  | Fastenal or Bolt Depot |  |  | no price yet | the model places 253; under the hex heads on the T-nut joints
1 | fasteners | model | M6 T-nut for the 8 mm slot | 275 | drop-in or slide-in, 4040 8 mm slot (Misumi HNTT8-6 class) | McMaster-Carr |  | Fastenal or Bolt Depot |  |  | no price yet | the model places 247; every panel and console joint, plus 2 for the lint box hang bolts
1 | fasteners | model | M6 nyloc nut | 35 | ISO 10511, zinc or stainless | McMaster-Carr |  | Fastenal or Bolt Depot |  |  | no price yet | the model places 28; baffles, hinge, through-the-pan bolts
1 | fasteners | model | M6 x 12 button head | 15 | ISO 7380, stainless A2 | McMaster-Carr |  | Fastenal or Bolt Depot |  |  | no price yet | the model places 12; drum baffles
1 | fasteners | model | M6 x 16 countersunk socket | 4 | ISO 10642, stainless A2 | McMaster-Carr |  | Fastenal or Bolt Depot |  |  | no price yet | the model places 2; fixed hinge half
1 | fasteners | model | M4 x 8 button head | 330 | ISO 7380, stainless A2, 2.5 mm hex key | McMaster-Carr |  | Fastenal or Bolt Depot |  |  | no price yet | the model places 297; drum tabs and seam, modules, ducts, door, sensors
1 | fasteners | model | M4 x 10 button head | 35 | ISO 7380, stainless A2 | McMaster-Carr |  | Fastenal or Bolt Depot |  |  | no price yet | the model places 30; faceplate, handle, glides, riser, basket pull
1 | fasteners | model | M4 x 16 button head | 4 | ISO 7380, stainless A2 | McMaster-Carr |  | Fastenal or Bolt Depot |  |  | no price yet | the model places 2; moisture bars
1 | fasteners | model | M4 x 20 button head | 3 | ISO 7380, stainless A2 | McMaster-Carr |  | Fastenal or Bolt Depot |  |  | no price yet | the model places 1; exhaust thermistor
1 | fasteners | model | M4 x 40 button head | 5 | ISO 7380, stainless A2 | McMaster-Carr |  | Fastenal or Bolt Depot |  |  | no price yet | the model places 3; lint box
1 | fasteners | model | M4 nyloc nut | 210 | ISO 10511, stainless A2 | McMaster-Carr |  | Fastenal or Bolt Depot |  |  | no price yet | the model places 187
1 | fasteners | model | M4 T-nut for the 6 mm slot | 10 | 2020 6 mm slot (Misumi HNTT5-4 class) | McMaster-Carr |  | Fastenal or Bolt Depot |  |  | no price yet | the model places 8; tray rail brackets 4, heat module tray 4
1 | fasteners | model | M4 T-nut for the 8 mm slot | 6 | 4040 8 mm slot | McMaster-Carr |  | Fastenal or Bolt Depot |  |  | no price yet | the model places 4; tray rail brackets' other legs
1 | fasteners | model | M3 x 5 button head | 15 | ISO 7380, stainless A2 | McMaster-Carr |  | Fastenal or Bolt Depot |  |  | no price yet | the model places 12; lint basket clamp plates
1 | fasteners | model | M3 x 6 button head | 4 | ISO 7380, stainless A2 | McMaster-Carr |  | Fastenal or Bolt Depot |  |  | no price yet | the model places 2; liner splice
1 | fasteners | model | M3 nyloc nut | 4 | ISO 10511, stainless A2 | McMaster-Carr |  | Fastenal or Bolt Depot |  |  | no price yet | the model places 2; liner splice
1 | fasteners | model | Lint box hang bolt, 20 long, with a 16 x 8.5 x 4 spacer | 4 | button head, stainless; M8 per the BOM (CH-BOLT-M8), the model's set is named M6 x 20: check before ordering | McMaster-Carr |  | Fastenal or Bolt Depot |  |  | open question | the model places 2; open question
2 | laser-steel-15 | base-pan.dxf | base pan | 1 | mild steel, design 1.5 mm; order 0.060 in (16 ga, 1.52 mm); finish: none (inside part): bare, or primer and enamel; 687 x 750 mm (27.0 x 29.5 in), 43 holes | Online laser service |  |  |  | V-105, V-106, V-107, V-111, V-112, V-113 | no price yet | most holes of any plate are set by bought parts: motor cradles, idler, blower plate feet, PS1 bracket, cord bushing, feet
2 | laser-steel-15 | bay-ceiling.dxf | bay ceiling | 1 | mild steel, design 1.5 mm; order 0.060 in (16 ga, 1.52 mm); finish: none (inside part): bare, or primer and enamel; 687 x 708 mm (27.0 x 27.9 in), 23 holes | Online laser service |  |  |  |  | no price yet
2 | laser-steel-15 | blower-plate.dxf | blower plate | 1 | mild steel, design 1.5 mm; order 0.060 in (16 ga, 1.52 mm); finish: none (inside part): bare, or primer and enamel; 260 x 245 mm (10.2 x 9.6 in), 8 holes | Online laser service |  |  |  | V-107 | no price yet | housing screw holes drilled from the bought housing (V-107)
2 | laser-steel-15 | console-cap.dxf | console cap | 1 | mild steel, design 1.5 mm; order 0.060 in (16 ga, 1.52 mm); finish: RAL 7024 graphite grey; 693 x 142 mm (27.3 x 5.6 in), 10 holes | Online laser service |  |  |  |  | no price yet
2 | laser-steel-15 | console-cheek-left.dxf | console cheek left | 1 | mild steel, design 1.5 mm; order 0.060 in (16 ga, 1.52 mm); finish: RAL 7024 graphite grey; 142 x 202 mm (5.6 x 7.9 in), 5 holes | Online laser service |  |  |  |  | no price yet
2 | laser-steel-15 | console-cheek-right.dxf | console cheek right | 1 | mild steel, design 1.5 mm; order 0.060 in (16 ga, 1.52 mm); finish: RAL 7024 graphite grey; 142 x 202 mm (5.6 x 7.9 in), 5 holes | Online laser service |  |  |  |  | no price yet
2 | laser-steel-15 | console-face.dxf | console face | 1 | mild steel, design 1.5 mm; order 0.060 in (16 ga, 1.52 mm); finish: RAL 7024 graphite grey; 690 x 200 mm (27.2 x 7.9 in), 14 holes | Online laser service |  |  |  |  | no price yet
2 | laser-steel-15 | console-rear.dxf | console rear | 1 | mild steel, design 1.5 mm; order 0.060 in (16 ga, 1.52 mm); finish: RAL 7024 graphite grey; 690 x 202 mm (27.2 x 7.9 in), 8 holes | Online laser service |  |  |  |  | no price yet
2 | laser-steel-15 | entry-blank.dxf | entry blank | 2 | mild steel, design 1.5 mm; order 0.060 in (16 ga, 1.52 mm); finish: none (inside part): bare, or primer and enamel; 60 x 44 mm (2.4 x 1.7 in), 2 holes | Online laser service |  |  |  |  | no price yet | two from the one file
2 | laser-steel-15 | front-bulkhead.dxf | front bulkhead | 1 | mild steel, design 1.5 mm; order 0.060 in (16 ga, 1.52 mm); finish: none (inside part): bare, or primer and enamel; 610 x 730 mm (24.0 x 28.7 in), 24 holes | Online laser service |  |  |  | V-102, V-112 | no price yet | roller stud holes (V-102) and the moisture bar holes (V-112)
2 | laser-steel-15 | front-lower-panel.dxf | front lower panel | 1 | mild steel, design 1.5 mm; order 0.060 in (16 ga, 1.52 mm); finish: RAL 7024 graphite grey; 690 x 259 mm (27.2 x 10.2 in), 8 holes | Online laser service |  |  |  |  | no price yet
2 | laser-steel-15 | front-upper-panel.dxf | front upper panel | 1 | mild steel, design 1.5 mm; order 0.060 in (16 ga, 1.52 mm); finish: RAL 5023 distant blue; 690 x 740 mm (27.2 x 29.1 in), 30 holes | Online laser service |  |  |  | V-115 | no price yet | door switch plunger and ear holes (V-115)
2 | laser-steel-15 | heat-module-terminal-plate.dxf | heat module terminal plate | 1 | mild steel, design 1.5 mm; order 0.060 in (16 ga, 1.52 mm); finish: none (inside part): bare, or primer and enamel; 290 x 100 mm (11.4 x 3.9 in), 5 holes | Online laser service |  |  |  | V-112 | no price yet
2 | laser-steel-15 | heat-module-top.dxf | heat module top | 1 | mild steel, design 1.5 mm; order 0.060 in (16 ga, 1.52 mm); finish: none (inside part): bare, or primer and enamel; 290 x 205 mm (11.4 x 8.1 in), 19 holes | Online laser service |  |  |  | V-108, V-109 | no price yet
2 | laser-steel-15 | heat-module-tray.dxf | heat module tray | 1 | mild steel, design 1.5 mm; order 0.060 in (16 ga, 1.52 mm); finish: none (inside part): bare, or primer and enamel; 340 x 280 mm (13.4 x 11.0 in), 14 holes | Online laser service |  |  |  | V-108, V-112 | no price yet
2 | laser-steel-15 | heat-module-wall-front.dxf | heat module wall front | 1 | mild steel, design 1.5 mm; order 0.060 in (16 ga, 1.52 mm); finish: none (inside part): bare, or primer and enamel; 287 x 108 mm (11.3 x 4.3 in), 8 holes | Online laser service |  |  |  | V-108 | no price yet
2 | laser-steel-15 | heat-module-wall-left.dxf | heat module wall left | 1 | mild steel, design 1.5 mm; order 0.060 in (16 ga, 1.52 mm); finish: none (inside part): bare, or primer and enamel; 205 x 108 mm (8.1 x 4.3 in), 6 holes | Online laser service |  |  |  | V-108 | no price yet
2 | laser-steel-15 | heat-module-wall-rear.dxf | heat module wall rear | 1 | mild steel, design 1.5 mm; order 0.060 in (16 ga, 1.52 mm); finish: none (inside part): bare, or primer and enamel; 287 x 108 mm (11.3 x 4.3 in), 8 holes | Online laser service |  |  |  | V-108 | no price yet
2 | laser-steel-15 | heat-module-wall-right.dxf | heat module wall right | 1 | mild steel, design 1.5 mm; order 0.060 in (16 ga, 1.52 mm); finish: none (inside part): bare, or primer and enamel; 205 x 108 mm (8.1 x 4.3 in), 6 holes | Online laser service |  |  |  | V-108 | no price yet
2 | laser-steel-15 | hood-bottom.dxf | hood bottom | 1 | mild steel, design 1.5 mm; order 0.060 in (16 ga, 1.52 mm); finish: none (inside part): bare, or primer and enamel; 350 x 258 mm (13.8 x 10.1 in), 11 holes | Online laser service |  |  |  |  | no price yet
2 | laser-steel-15 | hood-top.dxf | hood top | 1 | mild steel, design 1.5 mm; order 0.060 in (16 ga, 1.52 mm); finish: none (inside part): bare, or primer and enamel; 350 x 258 mm (13.8 x 10.1 in), 14 holes | Online laser service |  |  |  |  | no price yet
2 | laser-steel-15 | lint-box-back.dxf | lint box back | 1 | mild steel, design 1.5 mm; order 0.060 in (16 ga, 1.52 mm); finish: none (inside part): bare, or primer and enamel; 332 x 213 mm (13.1 x 8.4 in), 19 holes | Online laser service |  |  |  | V-112 | no price yet
2 | laser-steel-15 | lint-box-front.dxf | lint box front | 1 | mild steel, design 1.5 mm; order 0.060 in (16 ga, 1.52 mm); finish: none (inside part): bare, or primer and enamel; 332 x 400 mm (13.1 x 15.8 in), 15 holes | Online laser service |  |  |  |  | no price yet
2 | laser-steel-15 | power-module-barrier.dxf | power module barrier | 1 | mild steel, design 1.5 mm; order 0.060 in (16 ga, 1.52 mm); finish: none (inside part): bare, or primer and enamel; 150 x 76 mm (5.9 x 3.0 in), 2 holes | Online laser service |  |  |  | V-112 | no price yet
2 | laser-steel-15 | power-module-cover.dxf | power module cover | 1 | mild steel, design 1.5 mm; order 0.060 in (16 ga, 1.52 mm); finish: none (inside part): bare, or primer and enamel; 150 x 330 mm (5.9 x 13.0 in), 4 holes | Online laser service |  |  |  | V-112 | no price yet
2 | laser-steel-15 | power-module-plate.dxf | power module plate | 1 | mild steel, design 1.5 mm; order 0.060 in (16 ga, 1.52 mm); finish: none (inside part): bare, or primer and enamel; 150 x 720 mm (5.9 x 28.3 in), 21 holes | Online laser service |  |  |  | V-112 | no price yet
2 | laser-steel-15 | rear-bulkhead.dxf | rear bulkhead | 1 | mild steel, design 1.5 mm; order 0.060 in (16 ga, 1.52 mm); finish: none (inside part): bare, or primer and enamel; 610 x 730 mm (24.0 x 28.7 in), 152 holes | Online laser service |  |  |  | V-102 | no price yet | roller stud holes (V-102)
2 | laser-steel-15 | rear-lower-panel.dxf | rear lower panel | 1 | mild steel, design 1.5 mm; order 0.060 in (16 ga, 1.52 mm); finish: RAL 7024 graphite grey; 690 x 259 mm (27.2 x 10.2 in), 15 holes | Online laser service |  |  |  | V-107 | no price yet | exhaust pipe hole position follows the housing's collar (V-107)
2 | laser-steel-15 | rear-upper-panel.dxf | rear upper panel | 1 | mild steel, design 1.5 mm; order 0.060 in (16 ga, 1.52 mm); finish: RAL 5023 distant blue; 690 x 740 mm (27.2 x 29.1 in), 18 holes | Online laser service |  |  |  |  | no price yet
2 | laser-steel-15 | side-panel-left.dxf | side panel left | 1 | mild steel, design 1.5 mm; order 0.060 in (16 ga, 1.52 mm); finish: RAL 5023 distant blue; 750 x 1000 mm (29.5 x 39.4 in), 29 holes | Online laser service |  |  |  |  | no price yet
2 | laser-steel-15 | side-panel-right.dxf | side panel right | 1 | mild steel, design 1.5 mm; order 0.060 in (16 ga, 1.52 mm); finish: RAL 5023 distant blue; 750 x 1000 mm (29.5 x 39.4 in), 29 holes | Online laser service |  |  |  |  | no price yet
2 | laser-steel-15 | top-panel.dxf | top panel | 1 | mild steel, design 1.5 mm; order 0.060 in (16 ga, 1.52 mm); finish: RAL 5023 distant blue; 690 x 750 mm (27.2 x 29.5 in), 21 holes | Online laser service |  |  |  |  | no price yet
2 | laser-steel-15 | trunk-front.dxf | trunk front | 1 | mild steel, design 1.5 mm; order 0.060 in (16 ga, 1.52 mm); finish: none (inside part): bare, or primer and enamel; 260 x 574 mm (10.2 x 22.6 in), 23 holes | Online laser service |  |  |  |  | no price yet
2 | laser-steel-15 | trunk-rear.dxf | trunk rear | 1 | mild steel, design 1.5 mm; order 0.060 in (16 ga, 1.52 mm); finish: none (inside part): bare, or primer and enamel; 260 x 574 mm (10.2 x 22.6 in), 13 holes | Online laser service |  |  |  |  | no price yet
2 | laser-steel-2 | door-disc.dxf | door disc | 1 | mild steel, design 2 mm; order 0.075 in (14 ga, 1.90 mm); finish: RAL 7024 graphite grey; 540 x 540 mm (21.3 x 21.3 in), 5 holes | Same service as the 1.5 mm steel |  |  |  | V-115 | no price yet | hinge leaf, handle and catch holes (V-115)
2 | laser-steel-2 | door-ring.dxf | door ring | 1 | mild steel, design 2 mm; order 0.075 in (14 ga, 1.90 mm); finish: RAL 7024 graphite grey; 560 x 560 mm (22.0 x 22.0 in), 13 holes | Same service as the 1.5 mm steel |  |  |  | V-115 | no price yet | hinge and switch holes (V-115)
1 | laser-stainless | drum-ring.dxf | drum ring | 2 | 304 stainless, design 2 mm; order 0.074 to 0.075 in (14 ga, 1.9 mm); finish: none (2B or mill); 618 x 618 mm (24.3 x 24.3 in), 32 holes | OSH Cut |  |  |  |  | no price yet | cut early: the trial wrap (V-208) needs the real rings
2 | laser-stainless | basket-far-clamp.dxf | basket far clamp | 1 | 304 stainless, design 1.5 mm; order 0.060 in (16 ga, 1.52 mm); finish: none; 309 x 71 mm (12.2 x 2.8 in), 6 holes | OSH Cut |  |  |  |  | no price yet
2 | laser-stainless | basket-far-plate.dxf | basket far plate | 1 | 304 stainless, design 3 mm; order 0.120 to 0.125 in (3.05 to 3.18 mm), M3 holes tapped; finish: none; 309 x 71 mm (12.2 x 2.8 in), 6 holes | OSH Cut |  |  |  |  | no price yet | ask for the six M3 holes tapped
2 | laser-stainless | basket-lip-clamp.dxf | basket lip clamp | 1 | 304 stainless, design 1.5 mm; order 0.060 in (16 ga, 1.52 mm); finish: none; 327 x 84 mm (12.9 x 3.3 in), 6 holes | OSH Cut |  |  |  |  | no price yet
2 | laser-stainless | basket-lip-plate.dxf | basket lip plate | 1 | 304 stainless, design 3 mm; order 0.120 to 0.125 in (3.05 to 3.18 mm), M3 holes tapped; finish: none; 327 x 84 mm (12.9 x 3.3 in), 6 holes | OSH Cut |  |  |  |  | no price yet | ask for the six M3 holes tapped
2 | laser-stainless | drum-splice.dxf | drum splice | 1 | 304 stainless, design 1 mm; order 0.036 in (0.91 mm) or 0.048 in (1.22 mm); finish: none; 60 x 544 mm (2.4 x 21.4 in), 16 holes | OSH Cut |  |  |  | V-208 | no price yet
3 | laser-stainless | drum-sheet.dxf | drum sheet | 1 | 304 stainless, design 0.8 mm; order 0.030 in (0.76 mm) or 0.036 in (0.91 mm), see the open question; finish: none (2B or mill); 1945 x 582 mm (76.6 x 22.9 in), 88 holes | OSH Cut |  |  |  | V-101, V-208 | no price yet | one piece 1945 mm long: confirm the service cuts it at this thickness (V-101); wrap a cheap blank first (V-208)
2 | laser-aluminium | liner-splice.dxf | liner splice | 1 | 5052 aluminium, design 1.5 mm; order 0.063 in (1.60 mm) or 0.060 in; finish: none; 40 x 38 mm (1.6 x 1.5 in), 2 holes | Same service as the steel |  |  |  |  | no price yet
2 | laser-aluminium | liner.dxf | liner | 1 | 5052 aluminium, design 1.5 mm; order 0.063 in (1.60 mm) or 0.060 in; finish: none; 1482 x 41 mm (58.4 x 1.6 in), 2 holes | Same service as the steel |  |  |  |  | no price yet | rolled by hand round a 471 mm plywood disc after cutting
2 | laser-aluminium | tier0-faceplate.dxf | tier0 faceplate | 1 | 5052 aluminium, design 2 mm; order 0.080 in (2.03 mm); finish: none, or brushed; 620 x 160 mm (24.4 x 6.3 in), 18 holes | Same service as the steel |  |  |  | V-110 | no price yet | timer shaft and knob holes, checked on a timer in hand (V-110)
1 | stock | angle 20x20x2 aluminum | 6063/6061 angle 20 x 20 x 2 (3/4 x 3/4 x 1/16 in) | 4 m | Cut list (mm): 2 x 205 heat-module angles; 2 x 283 heat-module angles; 2 x 165 heat-module angles; 2 x 290 heat-module angles; 4 x 72 heat-module angles; 2 x 198 heat-module angles; 1 x 290 heat-module angles; 1 x 150 power-module-barrier-angle; 1 x 60 ps1-bracket; 2 x 90 blower-plate feet. Total 3.25 m | local metal supplier |  | McMaster-Carr or Online Metals |  |  | no price yet | the BOM's 3 m is short; buy the length here
1 | stock | angle 40x40x3 aluminum | 6063/6061 angle 40 x 40 x 3 (1-1/2 x 1-1/2 x 1/8 in) | 2 m | Cut list (mm): 3 x 480 baffle-1..3; 2 x 50 idler-bracket, spring-bracket. Total 1.54 m | local metal supplier |  | McMaster-Carr or Online Metals |  |  | no price yet
1 | stock | flat bar 25x4 aluminum | 6061 flat bar 25 x 4 (1 x 5/32 in) | 0.5 m | Cut list (mm): 1 x 175.4 idler-arm. Total 0.18 m | local metal supplier |  | McMaster-Carr or Online Metals |  |  | no price yet
1 | stock | flat bar 25x8 aluminum | 6061/6082 flat bar 25 x 8 (1 x 5/16 in) | 1.5 m | Cut list (mm): 2 x 257.5 hood side bar; 2 x 334 hood end bar. Total 1.18 m | local metal supplier |  | McMaster-Carr or Online Metals |  |  | no price yet
1 | stock | flat bar 30x8 aluminum | 6061/6082 flat bar 30 x 8 (1-1/4 x 5/16 in) | 1.5 m | Cut list (mm): 2 x 400.1 lint-box side bar; 1 x 316 lint-box bottom bar. Total 1.12 m | local metal supplier |  | McMaster-Carr or Online Metals |  |  | no price yet
1 | stock | flat bar 40x8 aluminum | 6061/6082 flat bar 40 x 8 (1-1/2 x 5/16 in) | 1.5 m | Cut list (mm): 2 x 136 spool side bar; 2 x 140 spool end bar; 2 x 158 nozzle side bar; 2 x 212 nozzle end bar. Total 1.29 m | local metal supplier |  | McMaster-Carr or Online Metals |  |  | no price yet
1 | stock | flat bar 50x8 aluminum | 6061/6082 flat bar 50 x 8 (2 x 5/16 in) | 2 m | Cut list (mm): 2 x 573.5 trunk side bar; 1 x 244 trunk top bar. Total 1.39 m | local metal supplier |  | McMaster-Carr or Online Metals |  |  | no price yet
1 | hardware-store | CH-EXH-CLAMP | Exhaust pipe clamps | 2 | Worm-drive hose clamps for 102 mm (4 in), stainless band 12 wide: one over the pipe on the housing's collar, one on the pipe just inside the rear lower panel, bearing on it (model draft 9). The builder's vent hose takes its own clamp on the spigot outside. | hardware store | 4 in worm-drive hose clamp | McMaster-Carr | worm-drive clamp for 4 in |  | no price yet
1 | hardware-store | CH-EXHAUST | Exhaust pipe inside the cabinet | 1 | 4 in (102 mm) rigid aluminium duct pipe, about 1 mm wall, cut to 609.5 (mechanical/drawings/frame-cut-list.csv): it slides 23 over the blower housing's 102 discharge collar at Y 192, runs straight along the bay floor's right side at X 230, Z 150, through the 106 port in the rear lower panel and 50 proud of it as the vent hose spigot; one 6.5 hole drilled on top at Y 300 for the air-proving tap (model draft 9). No elbows: the run is straight. | hardware store | 4 in rigid aluminum duct pipe (24 in or 5 ft length) | HVAC supply | 4 in x 5 ft aluminum snap-lock pipe | V-107 | no price yet | measure on arrival: V-107
1 | hardware-store | CH-GASKET | Duct and flange gaskets | 1 | Closed-cell silicone foam, 105 C: a 3 mm ring 150 outside, 125 inside, glued under the riser's hood round the collar hole (the heat module's collar rim brushes it, draft 7); 3 mm tape 8 wide, 2 x 190, between the lint box's side bars and the front bulkhead, compressed to 1.5 (draft 8); 2 mm tape 8 wide, 900, between the nozzle's bars and the rear bulkhead, compressed to 1; 6 mm tape 8 wide, 600, on the spool's rear edges against the blower's inlet face, compressed to 4 | McMaster-Carr | silicone foam strip | Grainger | silicone foam strip | V-107 | no price yet | measure on arrival: V-107
1 | hardware-store | CH-HANDLE | Door handle | 1 | D handle, 128 mm hole centres, about 14 mm round, 30 mm standoff, stainless or aluminum, M4 tapped | McMaster-Carr | D handle 128 mm centres | hardware store | D handle 128 mm centres |  | no price yet
1 | hardware-store | CH-HINGE | Door hinges, bolt-on lift-off (flag) type | 2 | Stainless bolt-on lift-off hinge pair, 8 mm pin, leaves about 6 x 30 with two holes each; the model draws 18 mm knuckles 30 tall with the pin at X -278.5, 14 in front of the panel, one half on the ring (M6 countersunk), the other on the disc (M4 button heads from the front into the tapped leaf) | McMaster-Carr | stainless butt hinge 60 mm | hardware store | stainless butt hinge 60 mm | V-115 | no price yet | measure on arrival: V-115
1 | hardware-store | CH-PAINT | Finish for the plates | 1 | Powder coat by the cutting service, or self-etching primer and appliance enamel | online laser-cut service | powder coat option | hardware store | primer and enamel |  | no price yet
1 | hardware-store | CH-TAP | Air-proving tap and tube | 1 | Brass barb fitting with a locknut for a 6.5 hole in the pipe (1/8 NPT or M6 thread, 5 mm barb) and 1 m of 6 mm (1/4 in) silicone tube rated 105 C from the barb to PS1's port (model draft 9: up to 240, over the exhaust thermostats, down in front of the outlet box) | McMaster-Carr | brass barbed fitting 1/8 NPT with locknut and 1/4 in silicone tubing | hardware store | brass barb and silicone fuel line |  | no price yet | measure on arrival:
1 | hardware-store | CPM-CORD-120 | Cord, gas, heat pump, and no-heat builds | 1 | Listed appliance cord, NEMA 5-15P (5-20P if the heat pump unit needs it), 3-wire, 14 AWG (12 AWG for 5-20P), 1.8 m | hardware store | appliance cord 14 AWG 5-15P | electrical distributor | appliance cord 14 AWG 5-15P |  | not for the electric build; no price yet
1 | hardware-store | HE-COLLAR | Outlet collar | 1 | Galvanised 125 mm (5 in) flanged starting collar, cut so its rim stands 55.5 above the lid (227 from the floor, 3 under the riser's hood), four M4 through the flange (draft 7) | HVAC supplier | 125 mm starting collar | Grainger | 5 in duct starting collar |  | no price yet
1 | hardware-store | V-208 | Trial drum blank | 1 | 0.5 mm aluminium flashing or heavy card, at least 1950 x 600 mm, cut by hand to drum-sheet.dxf printed full size | hardware store (roof flashing roll) |  |  |  |  |  | wrapped round the real rings before the stainless is cut (V-208)
2 | hardware-store | CH-LINT | Lint basket mesh and pull | 1 each | Stainless 18 x 16 insect screen, a strip 42 x 350 mm; a D-pull with 64 mm hole centres, about 25 mm projection, M4 | hardware store |  | McMaster-Carr |  |  | no price yet
