OpenSourceAppliances/dryer/bom/heat-electric-240.csv

part_id | description | quantity | category | generic_spec | vendor_1 | vendor_1_part_number | vendor_2 | vendor_2_part_number | unit_cost | last_verified | notes
HE-K_HEAT | Heater contactor | 1 | electrical | IEC contactor, 2 poles used, AC-1 32 A or more at 240 V, 24 V DC coil, listed | RS Components | LC1D18BD (Schneider Electric) | Crescent Electric | LC1D18BD (Schneider Electric) |  | 2026-11-09 | LC1D18BD verified 2026-11-09 against the maker's datasheet: 30 Mcycles mechanical, 1 Mcycle at 32 A AC-1 (the element draws 22.5 A), coil suppression built in, -40 to 60 C, UL 508 and CSA, 45 x 77 x 95; verified on vendor listings 2026-11-05: 18 A AC-3, 32 A AC-1, 24 V DC coil; drawn in draft 7 as 45 x 77 x 86 on the tray's DIN rail, its front 21 from the rear lower panel (V-112); confirm the DC coil has built-in suppression; cost not yet collected
HE-R1 | Heating element on its frame | 1 | wear | Open-coil dryer heating element on its steel frame with ceramic insulators, 5400 W at 240 V, appliance market; 10.5 x 7.5 x 2 in (267 x 190 x 51) from a seller listing, drawn as an envelope inside the laser-cut box (draft 7) | PartSelect | 279838 (Whirlpool) | AppliancePartsPros | AP3094254 (Whirlpool 279838) |  | 2026-11-05 | verified on vendor listings 2026-11-05; the frame's size, mounting holes and terminal position are V-108 before the box is cut; aftermarket equivalents exist from several makers; cost not yet collected
HE-TF1 | Heater box thermal cutoff | 1 | wear | One-shot thermal cutoff for the heater box, rated for the element current, appliance market; sold in the 279816 kit with the high-limit | appliance parts house | 279816 kit (Whirlpool), cutoff 3977393 | Supco or ERP (aftermarket) | equivalent to 279816 kit |  |  | unverified: part number from memory, confirm before ordering; cost not yet collected; rating against element current to be confirmed, see uci-spec section 13
HE-T_HL | Heater box high-limit thermostat | 1 | wear | Bimetal disc high-limit, normally closed, auto reset, rated for the element current, appliance market; in the 279816 kit | appliance parts house | 279816 kit (Whirlpool), high-limit 3390291 | Supco or ERP (aftermarket) | equivalent to 279816 kit |  |  | unverified: part number from memory, confirm before ordering; cost not yet collected
HE-CS1 | Current switch for STAT_HEAT_ON | 1 | electrical | Clamp-type current-operated switch, listed, normally open, pickup adjustable or fixed below 5 A, contact rated 24 V DC; or the contactor's auxiliary contact block as the minimum | Veris Industries | H908 family | Schneider Electric | LADN11 auxiliary contact block (minimum alternative) |  |  | unverified: part number from memory, confirm before ordering; cost not yet collected; current switch preferred; auxiliary block is the fallback the spec allows
HE-X | Terminal blocks on the tray, mains (L1, L2, N) plus ground, and SELV (HEAT_EN, 0V, HEAT_ON x2) | 8 | electrical | Same families as CPM-X1 and CPM-X4-X6, two separate strips | Phoenix Contact | UK 6 N, UK 2.5 N | Dinkle | DK6N, DK2.5N |  |  | unverified: part number from memory, confirm before ordering; cost not yet collected
HE-TRAY | Heat module tray, laser-cut 1.5 mm steel | 1 | structure | Laser-cut tray 340 x 280 (mechanical/drawings/heat-module-tray.dxf, draft 7) on the 2020 tray rails from Y 420 to 700, held by four M4 T-nuts through the box's side angles; carries the element box, the terminal plate with the contactor and strips, and an M6 bonding stud | online laser-cut service | per DXF | local laser-cut shop | per DXF |  |  | drawn in draft 7; cut only when V-108 and V-112 are closed; cost not yet collected
HE-BOX | Element box plates, laser-cut 1.5 mm steel | 6 | structure | Four walls (left and right 205 x 108.5 with the 150 x 60 inlet in the left and the 40 x 25 terminal opening in the right, front and rear 287 x 108.5), a lid 290 x 205 with the 126 collar hole, and the terminal plate 290 x 100: mechanical/drawings/heat-module-wall-left.dxf, -right, -front, -rear, heat-module-top.dxf, heat-module-terminal-plate.dxf (draft 7); joined with CH-ANGLE-20 and M4 button heads, no bends | online laser-cut service | per DXF | local laser-cut shop | per DXF |  |  | drawn in draft 7; V-108 confirms the element fits before cutting; cost not yet collected
HE-COLLAR | Outlet collar | 1 | structure | Galvanised 125 mm (5 in) flanged starting collar, cut so its rim stands 55.5 above the lid (227 from the floor, 3 under the riser's hood), four M4 through the flange (draft 7) | HVAC supplier | 125 mm starting collar | Grainger | 5 in duct starting collar |  |  | draft 7; the collar's height sets the box height in the model (hm_box_h); cost not yet collected
HE-DIN | DIN rail and end clamps on the terminal plate | 1 | structure | 35 x 7.5 DIN rail cut to 280 with two M4, two end clamps (CLIPFIX 35 class), one partition plate between the mains and SELV strips (draft 7) | McMaster-Carr | 35 mm DIN rail and end clamps | AutomationDirect | DN-R35S1 family and DN-EB35 end clamps |  |  | draft 7; cost not yet collected
HE-WIRE | Element leads | 1 | electrical | 10 AWG high-temperature appliance wire (200 C class) with listed high-temperature ring terminals for the element; 10 AWG 105 C for the rest of the tray | electrical distributor | high-temperature appliance wire 10 AWG | McMaster-Carr | high-temperature appliance wire 10 AWG |  |  | cost not yet collected
