OpenSourceAppliances/dryer/bom/heat-gas.csv

part_id | description | quantity | category | generic_spec | vendor_1 | vendor_1_part_number | vendor_2 | vendor_2_part_number | unit_cost | last_verified | notes
HG-K_HEAT | Burner circuit relay | 1 | electrical | Relay or contactor rated for the 120 V burner circuit including the igniter's inrush, 24 V DC coil, listed | Schneider Electric | LC1D09BD | Siemens | 3RT2016-1BB41 |  |  | unverified: part number from memory, confirm before ordering; same part as CPM-K_MOTOR; cost not yet collected
HG-BURNER | Burner assembly | 1 | wear | Listed dryer gas burner assembly: valve body with its coils, hot surface igniter, radiant flame sensor, orifice, burner tube, from a dryer family that has been in production for decades | appliance parts house | gas burner assembly for a common 29 in gas dryer family | second appliance parts house | same assembly |  |  | family to be chosen; see design-rules section 11 item 7; cost not yet collected
HG-IGN | Hot surface igniter, spare | 1 | wear | Silicon carbide hot surface igniter for the chosen burner assembly | appliance parts house | igniter for the chosen assembly (Whirlpool 279311 family if that assembly is chosen) | Supco or ERP (aftermarket) | equivalent |  |  | unverified: part number from memory, confirm before ordering; cost not yet collected
HG-SENSOR | Radiant flame sensor, spare | 1 | wear | Radiant flame sensor for the chosen burner assembly | appliance parts house | sensor for the chosen assembly (Whirlpool 338906 family if that assembly is chosen) | Supco or ERP (aftermarket) | equivalent |  |  | unverified: part number from memory, confirm before ordering; cost not yet collected
HG-COILS | Gas valve coil kit, spare | 1 | wear | Valve coil kit for the chosen burner assembly | appliance parts house | coil kit for the chosen assembly (Whirlpool 279834 family if that assembly is chosen) | Supco or ERP (aftermarket) | equivalent |  |  | unverified: part number from memory, confirm before ordering; cost not yet collected
HG-T_BHL | Burner high-limit thermostat | 1 | wear | Bimetal disc high-limit on the burner housing, normally closed, rated for the burner circuit, appliance market | appliance parts house | high-limit for the chosen assembly | Supco or ERP (aftermarket) | equivalent |  |  | unverified: part number from memory, confirm before ordering; cost not yet collected
HG-TF1 | Burner housing thermal fuse | 1 | wear | One-shot thermal cutoff on the burner housing, rated for the burner circuit, appliance market | appliance parts house | thermal fuse for the chosen assembly | Supco or ERP (aftermarket) | equivalent |  |  | unverified: part number from memory, confirm before ordering; cost not yet collected
HG-RLY_VALVE | Valve-open relay for STAT_HEAT_ON | 1 | electrical | Plug-in or interface relay with a 120 V AC coil, 1 changeover contact, listed, wired across the gas valve coil | Finder | 40.31 series, 120 V AC coil, with socket | Omron | MY2 series, 120 V AC coil, with socket |  |  | unverified: part number from memory, confirm before ordering; cost not yet collected
HG-LP | LP conversion kit | 1 | electrical | Maker's LP orifice and regulator kit for the chosen burner assembly | appliance parts house | LP kit for the chosen assembly | second appliance parts house | same kit |  |  | propane builds only; cost not yet collected
HG-GAS | Gas connection parts | 1 | electrical | Listed manual shutoff valve, listed flexible gas connector with 3/8 in NPT fittings, pipe thread sealant rated for gas, leak detection solution | hardware store | listed gas connector kit | plumbing supply | listed gas connector kit |  |  | connection may legally require a licensed person; see design-rules 5.3; cost not yet collected
HG-TRAY | Heat module tray, laser-cut 1.5 mm steel | 1 | structure | Laser-cut tray on the bay rails carrying the burner assembly, its air space, relay, terminals, and the riser flange adapter | online laser-cut service | per DXF | local laser-cut shop | per DXF |  |  | drawing not yet made; cost not yet collected
HG-X | Terminal blocks on the tray, mains and SELV, two strips | 8 | electrical | Same families as CPM-X3 and CPM-X4-X6 | Phoenix Contact | UK 2.5 N | Dinkle | DK2.5N |  |  | unverified: part number from memory, confirm before ordering; cost not yet collected
