OpenSourceAppliances/dryer/bom/heat-heatpump.csv

part_id | description | quantity | category | generic_spec | vendor_1 | vendor_1_part_number | vendor_2 | vendor_2_part_number | unit_cost | last_verified | notes
HP-UNIT | Sealed heat pump unit | 1 | wear | Pre-charged sealed heat pump assembly with a fixed-speed compressor, evaporator, condenser, and drain pan, bought as one unit and never opened | OEM parts channel | Whirlpool W11551760 (WHD560CHW family) is a candidate | OEM parts channel | GE WE03X36780 is a candidate |  |  | candidates only: compressor type (must be fixed speed), refrigerant, weight, shipping, and price are unverified; see design-rules 5.4; cost not yet collected
HP-K_COMP | Compressor contactor | 1 | electrical | IEC contactor rated for the compressor's locked-rotor current at 120 V (AC-3 or hp rated), 24 V DC coil, listed | Schneider Electric | LC1D series, size from the unit's nameplate | Siemens | 3RT2 series, size from the unit's nameplate |  |  | sized once the unit is known; cost not yet collected
HP-TMR1 | Anti-short-cycle timer | 1 | electrical | Timer relay, lockout (delay-on-break) function, 3 to 5 min, 24 V DC supply, listed | Finder | 80 series multifunction timer, 24 V | Omron | H3DK series, 24 V |  |  | unverified: part number from memory, confirm before ordering; confirm the function name on the chosen part; cost not yet collected
HP-T_CHL | Condenser outlet high-limit | 1 | wear | Bimetal disc thermostat, normally closed, setpoint chosen once the unit is known, appliance market | appliance parts house | disc thermostat, L-rating to be chosen | Supco or ERP (aftermarket) | equivalent |  |  | rating chosen once the unit is known; cost not yet collected
HP-FS1 | Condensate pump with safety switch | 1 | wear | Listed condensate pump with an integral normally closed safety switch that opens on high level | Little Giant | VCMA series with safety switch | DiversiTech | ClearVue series with safety switch |  |  | unverified: part number from memory, confirm before ordering; a tank with a float switch is the alternative; cost not yet collected
HP-FILTER | Secondary lint filter | 1 | wear | Fine mesh or foam filter in a frame at the evaporator inlet, removable without tools, with a printable frame file | generic | foam or mesh filter media | generic | foam or mesh filter media |  |  | frame to be drawn; cost not yet collected
HP-RETURN | Return duct | 1 | structure | Duct from the blower outlet flange to the heat module inlet, laser-cut and bolted or standard round duct with adapters | online laser-cut service | per DXF | HVAC supply | 102 mm round duct and adapters |  |  | decided with the riser, design-rules section 11 item 6; cost not yet collected
HP-CS1 | Current switch for STAT_HEAT_ON | 1 | electrical | Clamp-type current-operated switch, listed, normally open, pickup below the compressor's running current, contact rated 24 V DC; or the contactor's auxiliary contact block | Veris Industries | H908 family | Schneider Electric | LADN11 auxiliary contact block (minimum alternative) |  |  | unverified: part number from memory, confirm before ordering; cost not yet collected
HP-TRAY | Heat module tray, laser-cut 1.5 mm steel | 1 | structure | Laser-cut tray on the bay rails carrying the sealed unit, contactor, timer, pump, terminals, and the flange adapters; sized for 20 to 35 kg | online laser-cut service | per DXF | local laser-cut shop | per DXF |  |  | drawing not yet made; cost not yet collected
HP-X | Terminal blocks on the tray, mains and SELV, two strips | 8 | electrical | Same families as CPM-X3 and CPM-X4-X6 | Phoenix Contact | UK 2.5 N | Dinkle | DK2.5N |  |  | unverified: part number from memory, confirm before ordering; cost not yet collected
