OpenSourceAppliances/dryer/mechanical/cad/audit/measured-parts.csv

part | solids | valid | closed | xmin | ymin | zmin | xmax | ymax | zmax | size_x | size_y | size_z | volume_mm3 | area_mm2 | faces | planar_faces | cylindrical_faces | other_faces | edges | vertices | flat | thickness | normal | section_loops
base-pan | 1 | 1 | 1 | -343.5 | -0.0 | -1.5 | 343.5 | 750.0 | 0.0 | 687.0 | 750.0 | 1.5 | 770130.214 | 1032525.989 | 53 | 6 | 47 | 0 | 306 | 612 | 1 | 1.5 | 0.0000 0.0000 1.0000 | 44
basket-far-clamp | 1 | 1 | 1 | -154.554 | 12.6 | 366.0 | 154.554 | 14.1 | 436.762 | 309.107 | 1.5 | 70.762 | 12155.524 | 17322.823 | 12 | 4 | 8 | 0 | 60 | 120 | 1 | 1.5 | -0.0000 -1.0000 -0.0000 | 7
basket-far-plate | 1 | 1 | 1 | -154.554 | 9.0 | 366.0 | 154.554 | 12.0 | 436.762 | 309.107 | 3.0 | 70.762 | 24347.238 | 18439.79 | 12 | 4 | 8 | 0 | 60 | 120 | 1 | 3.0 | -0.0000 -1.0000 -0.0000 | 7
basket-lip-clamp | 1 | 1 | 1 | -163.452 | 45.1 | 363.0 | 163.452 | 46.6 | 447.442 | 326.905 | 1.5 | 84.442 | 5002.108 | 8884.365 | 16 | 6 | 10 | 0 | 84 | 168 | 1 | 1.5 | -0.0000 -1.0000 -0.0000 | 8
basket-lip-plate | 1 | 1 | 1 | -163.452 | 41.5 | 363.0 | 163.452 | 44.5 | 447.442 | 326.905 | 3.0 | 84.442 | 14075.046 | 13924.013 | 24 | 11 | 13 | 0 | 132 | 264 | 1 | 3.0 | -0.0000 -1.0000 -0.0000 | 8
bay-ceiling | 1 | 1 | 1 | -343.5 | 42.0 | 300.0 | 343.5 | 750.0 | 301.5 | 687.0 | 708.0 | 1.5 | 685439.751 | 923082.996 | 55 | 30 | 25 | 0 | 318 | 636 | 1 | 1.5 | 0.0000 0.0000 1.0000 | 29
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
trunk-front | 1 | 1 | 1 | -130.0 | 652.5 | 258.0 | 130.0 | 654.0 | 831.5 | 260.0 | 1.5 | 573.5 | 177913.947 | 241253.377 | 37 | 10 | 27 | 0 | 210 | 420 | 1 | 1.5 | -0.0000 -1.0000 -0.0000 | 25
trunk-rear | 1 | 1 | 1 | -130.0 | 704.0 | 258.0 | 130.0 | 705.5 | 831.5 | 260.0 | 1.5 | 573.5 | 223308.512 | 300505.406 | 23 | 6 | 17 | 0 | 126 | 252 | 1 | 1.5 | -0.0000 -1.0000 -0.0000 | 14
[assembly] tray-rail-brackets (bought, 4 x 2020 inside corner brackets) | 4 |  |  | -190.0 | 11.5 | 40.0 | 190.0 | 738.5 | 60.0 | 380.0 | 727.0 | 20.0 | 6056.914
[assembly] hardware-tray-rails (bought, 8 x M4 x 8 button head, T-nuts for the 6 and 8 mm slots) | 8 |  |  | -185.8 | 16.2 | 34.5 | 185.8 | 733.8 | 53.8 | 371.6 | 717.6 | 19.3 | 1429.36
[assembly] feet (bought, 4 x M8 leveling feet, 50 pad) | 4 |  |  | -350.0 | -5.0 | -19.5 | 350.0 | 755.0 | 35.0 | 700.0 | 760.0 | 54.5 | 93105.692
[assembly] hardware-front-bulkhead (bought, 7 x M6 x 12 hex, washers, T-nuts) | 7 |  |  | -281.0 | 29.5 | 274.0 | 281.0 | 47.1 | 986.0 | 562.0 | 17.6 | 712.0 | 6009.126
[assembly] hardware-rear-bulkhead (bought, 10 x M6 x 12 hex, washers, T-nuts) | 10 |  |  | -281.0 | 604.4 | 274.0 | 281.0 | 622.0 | 986.0 | 562.0 | 17.6 | 712.0 | 8584.466
[assembly] drum-glides-front (bought, 2 x nylon drum glide pads, 45 x 20 x 8) | 2 |  |  | -221.142 | 41.5 | 809.166 | 221.142 | 49.5 | 852.642 | 442.285 | 8.0 | 43.477 | 13153.34
[assembly] drum-glides-rear (bought, 2 x nylon drum glide pads, 45 x 20 x 9.5) | 2 |  |  | -221.142 | 600.5 | 809.166 | 221.142 | 610.0 | 852.642 | 442.285 | 9.5 | 43.477 | 15734.737
[assembly] hardware-drum-glides (bought, 4 x M4 x 8 and 4 x M4 x 10 button head, nuts) | 16 |  |  | -211.931 | 37.8 | 818.619 | 211.931 | 613.7 | 843.189 | 423.862 | 575.9 | 24.571 | 2261.56
[assembly] hardware-bay-ceiling (bought, 20 x M6 x 12 hex, washers, T-nuts) | 20 |  |  | -331.0 | 74.0 | 289.5 | 331.0 | 736.0 | 307.1 | 662.0 | 662.0 | 17.6 | 17168.933
[assembly] hardware-base-pan (bought, 20 x M6 x 12 hex, washers, T-nuts) | 20 |  |  | -331.0 | 14.0 | -7.1 | 331.0 | 736.0 | 10.5 | 662.0 | 722.0 | 17.6 | 17168.933
[assembly] hardware-side-panel-left (bought, 29 x M6 x 12 hex, washers, T-nuts) | 29 |  |  | -352.1 | 14.0 | 14.0 | -334.5 | 736.0 | 986.0 | 17.6 | 722.0 | 972.0 | 24894.953
[assembly] hardware-side-panel-right (bought, 29 x M6 x 12 hex, washers, T-nuts) | 29 |  |  | 334.5 | 14.0 | 14.0 | 352.1 | 736.0 | 986.0 | 17.6 | 722.0 | 972.0 | 24894.953
[assembly] hardware-front-upper-panel (bought, 16 x M6 x 12 hex, washers, T-nuts) | 16 |  |  | -331.0 | -7.1 | 274.0 | 331.0 | 10.5 | 986.0 | 662.0 | 17.6 | 712.0 | 13735.146
[assembly] hardware-front-lower-panel (bought, 8 x M6 x 12 hex, washers, T-nuts) | 8 |  |  | -331.0 | -7.1 | 14.0 | 331.0 | 10.5 | 205.0 | 662.0 | 17.6 | 191.0 | 6867.573
[assembly] hardware-rear-upper-panel (bought, 18 x M6 x 12 hex, washers, T-nuts) | 18 |  |  | -331.0 | 739.5 | 274.0 | 331.0 | 757.1 | 986.0 | 662.0 | 17.6 | 712.0 | 15452.04
[assembly] hardware-rear-lower-panel (bought, 8 x M6 x 12 hex, washers, T-nuts) | 8 |  |  | -331.0 | 739.5 | 14.0 | 331.0 | 757.1 | 205.0 | 662.0 | 17.6 | 191.0 | 6867.573
[assembly] hardware-top-panel (bought, 16 x M6 x 12 hex, washers, T-nuts) | 16 |  |  | -331.0 | 14.0 | 989.5 | 331.0 | 736.0 | 1007.1 | 662.0 | 722.0 | 17.6 | 13735.146
[assembly] console-brackets (bought, 12 x 4040 inside corner brackets) | 12 |  |  | -342.0 | 614.5 | 1001.5 | 342.0 | 747.0 | 1198.5 | 684.0 | 132.5 | 197.0 | 104526.425
[assembly] hardware-console-brackets (bought, 24 x M6 x 12 hex, washers, T-nuts) | 24 |  |  | -331.0 | 625.5 | 993.5 | 331.0 | 736.0 | 1187.5 | 662.0 | 110.5 | 194.0 | 20602.719
[assembly] hardware-console-face (bought, 8 x M6 x 12 hex, washers, T-nuts) | 8 |  |  | -331.0 | 604.4 | 1024.0 | 331.0 | 622.0 | 1187.5 | 662.0 | 17.6 | 163.5 | 6867.573
[assembly] hardware-console-rear (bought, 8 x M6 x 12 hex, washers, T-nuts) | 8 |  |  | -331.0 | 739.5 | 1024.0 | 331.0 | 757.1 | 1187.5 | 662.0 | 17.6 | 163.5 | 6867.573
[assembly] hardware-console-cap (bought, 10 x M6 x 12 hex, washers, T-nuts) | 10 |  |  | -331.0 | 625.5 | 1191.0 | 331.0 | 736.0 | 1208.6 | 662.0 | 110.5 | 17.6 | 8584.466
[assembly] hardware-console-cheek-left (bought, 5 x M6 x 12 hex, washers, T-nuts) | 5 |  |  | -352.1 | 625.5 | 1024.0 | -334.5 | 736.0 | 1187.5 | 17.6 | 110.5 | 163.5 | 4292.233
[assembly] hardware-console-cheek-right (bought, 5 x M6 x 12 hex, washers, T-nuts) | 5 |  |  | 334.5 | 625.5 | 1024.0 | 352.1 | 736.0 | 1187.5 | 17.6 | 110.5 | 163.5 | 4292.233
[assembly] hardware-tier0-faceplate (bought, 6 x M4 x 10 button head, nuts) | 12 |  |  | -299.041 | 605.8 | 1010.7 | 299.041 | 618.0 | 1158.3 | 598.083 | 12.2 | 147.6 | 1771.568
[assembly] tier0-knob-dry-time (bought) | 1 |  |  | -170.0 | 586.8 | 1064.5 | -130.0 | 611.5 | 1104.5 | 40.0 | 24.7 | 40.0 | 15189.251
[assembly] tier0-timer-dry-time (bought) | 1 |  |  | -170.3 | 610.0 | 1031.3 | -129.7 | 641.7 | 1137.7 | 40.6 | 31.7 | 106.4 | 90563.21
[assembly] tier0-knob-heat-time (bought) | 1 |  |  | -80.0 | 586.8 | 1064.5 | -40.0 | 611.5 | 1104.5 | 40.0 | 24.7 | 40.0 | 15189.251
[assembly] tier0-timer-heat-time (bought) | 1 |  |  | -80.3 | 610.0 | 1031.3 | -39.7 | 641.7 | 1137.7 | 40.6 | 31.7 | 106.4 | 90563.21
[assembly] tier0-selector-body (bought) | 2 |  |  | 45.0 | 605.5 | 1087.0 | 75.0 | 656.5 | 1122.0 | 30.0 | 51.0 | 35.0 | 34073.174
[assembly] tier0-selector (bought) | 1 |  |  | 49.0 | 595.5 | 1089.5 | 71.0 | 605.5 | 1119.5 | 22.0 | 10.0 | 30.0 | 2878.124
[assembly] tier0-start-body (bought) | 2 |  |  | 115.0 | 605.5 | 1087.0 | 145.0 | 656.5 | 1122.0 | 30.0 | 51.0 | 35.0 | 34073.174
[assembly] tier0-start-button (bought) | 1 |  |  | 119.0 | 597.5 | 1093.5 | 141.0 | 605.5 | 1115.5 | 22.0 | 8.0 | 22.0 | 2984.142
[assembly] tier0-k1-relay-on-din-rail (bought) | 1 |  |  | 40.0 | 610.0 | 1024.5 | 140.0 | 694.5 | 1079.5 | 100.0 | 84.5 | 55.0 | 127556.372
[assembly] hardware-door-ring (bought, 8 x M4 x 8 button head, nuts) | 16 |  |  | -241.94 | -5.7 | 389.801 | 241.94 | 4.5 | 873.199 | 483.881 | 10.2 | 483.398 | 2161.029
[assembly] door-hinge-1-fixed (bought, flag hinge, pinned half) | 1 |  |  | -287.5 | -23.0 | 561.5 | -245.0 | -3.5 | 701.5 | 42.5 | 19.5 | 140.0 | 17840.613
[assembly] hardware-door-hinge-1 (bought, 2 x M6 x 16 countersunk, nuts) | 4 |  |  | -272.0 | -9.5 | 575.5 | -246.0 | 6.5 | 587.5 | 26.0 | 16.0 | 12.0 | 1692.21
[assembly] door-hinge-2-swing (bought, flag hinge, lift-off half) | 1 |  |  | -287.5 | -23.0 | 666.5 | -245.0 | -5.0 | 696.5 | 42.5 | 18.0 | 30.0 | 10700.959
[assembly] hardware-door-hinge-2 (bought, 2 x M4 x 8 button head into the tapped leaf) | 2 |  |  | -262.8 | -15.7 | 677.7 | -246.2 | -5.5 | 685.3 | 16.6 | 10.2 | 7.6 | 357.34
[assembly] door-handle (bought, D handle 128 centres) | 1 |  |  | 213.0 | -57.0 | 560.5 | 227.0 | -13.5 | 702.5 | 14.0 | 43.5 | 142.0 | 30386.464
[assembly] hardware-door-handle (bought, 2 x M4 x 10 button head into the handle) | 2 |  |  | 216.2 | -21.5 | 563.7 | 223.8 | -9.3 | 699.3 | 7.6 | 12.2 | 135.6 | 407.605
[assembly] door-seal (bought, OEM door seal) | 1 |  |  | -246.0 | -11.5 | 385.5 | 246.0 | -5.5 | 877.5 | 492.0 | 6.0 | 492.0 | 81939.02
[assembly] door-catch (bought, magnetic catch) | 1 |  |  | 256.0 | -10.0 | 625.5 | 268.0 | -3.5 | 637.5 | 12.0 | 6.5 | 12.0 | 936.0
[assembly] door-catch-strike (bought) | 1 |  |  | 256.0 | -11.5 | 625.5 | 268.0 | -10.5 | 637.5 | 12.0 | 1.0 | 12.0 | 144.0
[assembly] hardware-drum-tabs (bought, 60 x M4 x 8 button head, nuts) | 120 |  |  | -305.241 | 44.0 | 328.15 | 305.241 | 606.0 | 934.85 | 610.483 | 562.0 | 606.7 | 16207.714
[assembly] hardware-drum-seam (bought, 16 x M4 x 8 button head, nuts) | 32 |  |  | -19.205 | 101.2 | 936.99 | 19.205 | 508.8 | 947.357 | 38.41 | 407.6 | 10.366 | 4322.057
[assembly] baffle-1 (angle, cut to length) | 1 |  |  | -277.171 | 85.0 | 748.431 | -241.03 | 565.0 | 803.072 | 36.141 | 480.0 | 54.641 | 110481.803
[assembly] baffle-2 (angle, cut to length) | 1 |  |  | -20.0 | 85.0 | 322.998 | 20.0 | 565.0 | 362.998 | 40.0 | 480.0 | 40.0 | 110481.803
[assembly] baffle-3 (angle, cut to length) | 1 |  |  | 222.53 | 85.0 | 766.931 | 277.171 | 565.0 | 803.072 | 54.641 | 480.0 | 36.141 | 110481.803
[assembly] hardware-drum-baffles (bought, 12 x M6 x 12 button head, nuts) | 24 |  |  | -272.984 | 149.75 | 318.2 | 272.984 | 500.25 | 791.73 | 545.969 | 350.5 | 473.53 | 10142.813
[assembly] motor (bought) | 1 |  |  | -70.0 | 185.5 | 50.0 | 70.0 | 394.0 | 210.0 | 140.0 | 208.5 | 160.0 | 3046373.714
[assembly] motor-mount-1 (bought, cradle bracket) | 1 |  |  | -35.0 | 215.0 | 0.0 | 35.0 | 245.0 | 58.802 | 70.0 | 30.0 | 58.802 | 39966.897
[assembly] motor-mount-2 (bought, cradle bracket) | 1 |  |  | -35.0 | 335.0 | 0.0 | 35.0 | 365.0 | 58.802 | 70.0 | 30.0 | 58.802 | 39966.897
[assembly] hardware-motor-mounts (bought, 4 x M6 x 12 hex, washers, nuts, through the base pan) | 8 |  |  | -28.0 | 224.0 | -7.1 | 28.0 | 356.0 | 10.5 | 56.0 | 132.0 | 17.6 | 4562.023
[assembly] pulley (bought) | 1 |  |  | -11.0 | 394.0 | 109.0 | 11.0 | 416.0 | 131.0 | 22.0 | 22.0 | 22.0 | 6967.148
[assembly] blower (bought) | 1 |  |  | -110.0 | 85.5 | 10.0 | 291.0 | 215.0 | 230.0 | 401.0 | 129.5 | 220.0 | 5340928.083
[assembly] heat-module-angles-bottom (20x20x2 aluminium angle, 2 x 205 outside, 2 x 283 inside) | 4 |  |  | -165.0 | 422.0 | 61.5 | 165.0 | 627.0 | 81.5 | 330.0 | 205.0 | 20.0 | 73539.827
[assembly] heat-module-angles-top (20x20x2 aluminium angle, 2 x 165, 2 x 290) | 4 |  |  | -147.0 | 420.0 | 153.5 | 147.0 | 629.0 | 173.5 | 294.0 | 209.0 | 20.0 | 68523.827
[assembly] heat-module-angles-corner (20x20x2 aluminium angle, 4 x 72) | 4 |  |  | -147.0 | 420.0 | 81.5 | 147.0 | 629.0 | 153.5 | 294.0 | 209.0 | 72.0 | 21633.531
[assembly] heat-module-element-rails (20x20x2 aluminium angle, 2 x 198) | 2 |  |  | -143.5 | 425.5 | 61.5 | 143.5 | 623.5 | 81.5 | 287.0 | 198.0 | 20.0 | 29968.765
[assembly] heat-module-element (bought, 279838 class open-coil element on its frame, envelope) | 1 |  |  | -133.5 | 429.5 | 81.5 | 157.0 | 619.5 | 132.5 | 290.5 | 190.0 | 51.0 | 2592870.0
[assembly] heat-module-collar (bought, 125 flanged starting collar, cut to 55.5) | 1 |  |  | -77.5 | 447.5 | 171.5 | 77.5 | 602.5 | 227.0 | 155.0 | 155.0 | 55.5 | 19547.838
[assembly] heat-module-thermostats (bought, 279816 class high-limit and thermal cut-off, envelopes) | 2 |  |  | -121.0 | 473.0 | 171.5 | 121.0 | 527.0 | 186.5 | 242.0 | 54.0 | 15.0 | 15480.765
[assembly] heat-module-terminal-angle (20x20x2 aluminium angle, 290) | 1 |  |  | -145.0 | 635.5 | 61.5 | 145.0 | 655.5 | 81.5 | 290.0 | 20.0 | 20.0 | 21849.148
[assembly] heat-module-din-rail (bought, 35 x 7.5 top hat, 280) | 1 |  |  | -140.0 | 635.5 | 94.0 | 140.0 | 643.0 | 129.0 | 280.0 | 7.5 | 35.0 | 13377.655
[assembly] heat-module-devices (bought, envelopes: 2 end clamps, X_HM mains and SELV strips, partition, K_HEAT, CS1) | 7 |  |  | -140.0 | 643.0 | 73.0 | 43.6 | 729.0 | 150.0 | 183.6 | 86.0 | 77.0 | 502878.0
[assembly] heat-module-bonding-stud (bought, M6 x 16 hex bolt, 2 nuts, star washers; the PE ring terminal goes between the nuts) | 3 |  |  | 134.0 | 674.0 | 54.4 | 146.0 | 686.0 | 76.0 | 12.0 | 12.0 | 21.6 | 1535.662
[assembly] heat-module-hardware (bought, 64 x M4 x 8 button head, 60 nuts, 4 T-nuts for the 6 mm slot) | 124 |  |  | -163.8 | 417.8 | 55.5 | 163.8 | 649.3 | 175.7 | 327.6 | 231.5 | 120.2 | 16922.394
[assembly] hardware-power-module-plate (bought, 4 x M6 x 12 hex, washers, T-nuts) | 4 |  |  | -291.0 | 641.0 | 274.0 | -159.0 | 658.6 | 986.0 | 132.0 | 17.6 | 712.0 | 3433.787
[assembly] power-module-rail-A1-devices (bought, envelopes: X1 cord: 4 x UK 6 N (L1, L2, N, PE), CB1: 1P MCB, F1: UK 5-HESI fuse terminal, 2 end clamps) | 5 |  |  | -295.0 | 660.5 | 315.0 | -217.5 | 720.5 | 405.0 | 77.5 | 60.0 | 90.0 | 213485.2
[assembly] power-module-rail-A2-devices (bought, envelopes: PSU: HDR-60-24, K_MOTOR: LC1K0910BD class mini contactor, 2 end clamps) | 4 |  |  | -295.0 | 660.5 | 425.0 | -178.5 | 717.5 | 515.0 | 116.5 | 57.0 | 90.0 | 433870.5
[assembly] power-module-rail-A3-devices (bought, envelopes: X2 heat module mains: 4 x UK 6 N, X3 motor and S1: 5 x UK 2.5 N, 2 end clamps) | 4 |  |  | -295.0 | 660.5 | 556.5 | -212.2 | 702.5 | 603.5 | 82.8 | 42.0 | 47.0 | 138091.2
[assembly] power-module-rail-B1-devices (bought, envelopes: RLY_MOTOR, RLY_HEAT, RLY_HEAT_LO: 3 x 38.51 class, PTC1 to PTC3 in fuse terminals, F2: UK 5-HESI, X4 heat module SELV: 4 x UK 2.5 N, 2 end clamps) | 6 |  |  | -295.0 | 660.5 | 653.5 | -199.8 | 730.5 | 746.5 | 95.2 | 70.0 | 93.0 | 291878.8
[assembly] power-module-rail-B2-devices (bought, envelopes: X5 chassis switches: 10 x UK 2.5 N, X6 sensors: 6 x UK 2.5 N, 2 end clamps) | 4 |  |  | -295.0 | 660.5 | 798.0 | -176.8 | 696.5 | 842.0 | 118.2 | 36.0 | 44.0 | 174007.2
[assembly] power-module-din-rails (bought, 5 x 35 x 7.5 top hat, 140) | 5 |  |  | -295.0 | 653.0 | 342.5 | -155.0 | 660.5 | 837.5 | 140.0 | 7.5 | 495.0 | 33288.275
[assembly] power-module-barrier-angle (20x20x2 aluminium angle, 150) | 1 |  |  | -300.0 | 653.0 | 640.0 | -150.0 | 673.0 | 660.0 | 150.0 | 20.0 | 20.0 | 11272.765
[assembly] power-module-standoffs (bought, 4 x M4 x 75 hex standoffs, female both ends) | 4 |  |  | -294.041 | 653.0 | 316.5 | -155.959 | 728.0 | 633.5 | 138.083 | 75.0 | 317.0 | 11733.055
[assembly] power-module-ground-stud (bought, M6 x 16 hex bolt, 2 nuts, star washers; the cord's PE ring terminal goes between the nuts) | 3 |  |  | -171.0 | 645.9 | 944.0 | -159.0 | 667.5 | 956.0 | 12.0 | 21.6 | 12.0 | 1535.662
[assembly] power-module-hardware (bought, 22 x M4 x 8 button head, 14 nuts) | 36 |  |  | -293.8 | 649.3 | 316.2 | -156.2 | 731.7 | 823.8 | 137.6 | 82.4 | 507.6 | 5211.159
[assembly] grommets (bought, 5 x rubber grommets for 1.5 panels: 22 mm hole x 2, 30 mm hole x 1, 16 mm hole x 2) | 5 |  |  | -289.0 | 38.75 | 298.75 | 301.0 | 708.0 | 1002.75 | 590.0 | 669.25 | 704.0 | 6693.713
[assembly] cord-bushing (bought, PG16 strain relief) | 1 |  |  | -290.011 | 677.0 | -6.5 | -259.989 | 703.0 | 18.0 | 30.022 | 26.0 | 24.5 | 8877.396
[assembly] power-cord (bought) | 1 |  |  | -279.5 | 685.5 | -16.5 | -270.5 | 820.0 | 320.0 | 9.0 | 134.5 | 336.5 | 29365.096
[assembly] hardware-liner (bought, 2 x M3 x 6 button head, nuts) | 4 |  |  | -15.7 | 16.3 | 863.45 | 15.7 | 22.0 | 871.229 | 31.401 | 5.7 | 7.779 | 234.826
[assembly] lint-box-bars (30 x 8 aluminium flat bar: 2 sides mitred at the top, 1 bottom) | 3 |  |  | -166.0 | 8.5 | 62.0 | 166.0 | 38.5 | 462.066 | 332.0 | 30.0 | 400.066 | 261325.657
[assembly] lint-box-foam (bought, 3 mm closed-cell foam tape 8 wide, 2 x 190, compressed to 1.5) | 2 |  |  | -166.0 | 38.5 | 275.0 | 166.0 | 40.0 | 462.066 | 332.0 | 1.5 | 187.066 | 4255.258
[assembly] spool-bars (40 x 8 aluminium flat bar: 2 x 136, 2 x 140) | 4 |  |  | -78.0 | 40.0 | 62.0 | 78.0 | 80.0 | 198.0 | 156.0 | 40.0 | 136.0 | 175718.681
[assembly] spool-foam (bought, 6 mm closed-cell foam tape 8 wide, 600, compressed to 4 on the blower plate) | 4 |  |  | -78.0 | 80.0 | 62.0 | 78.0 | 84.0 | 198.0 | 156.0 | 4.0 | 136.0 | 17664.0
[assembly] lint-box-hardware (bought, 40 pieces: M4 x 8, M4 x 10 and M4 x 40 button heads, 2 x M6 x 20 button heads with 4 mm spacers and T-nuts) | 40 |  |  | -178.0 | 4.8 | 62.2 | 178.0 | 47.0 | 423.8 | 356.0 | 42.2 | 361.6 | 11200.987
[assembly] basket-mesh (bought, stainless 18 x 16 mesh strip, 42 wide, 350 long, wrapped and folded 5 at each edge) | 3 |  |  | -163.452 | 12.0 | 363.0 | 163.452 | 45.1 | 445.935 | 326.905 | 33.1 | 82.935 | 16043.178
[assembly] basket-pull (bought, D-pull, 64 mm centres, 25 projection) | 1 |  |  | -37.0 | 16.5 | 409.0 | 37.0 | 41.5 | 419.0 | 74.0 | 25.0 | 10.0 | 8057.275
[assembly] hardware-basket (bought, 12 x M3 x 5 button head into the tapped plates, 2 x M4 x 10 button head into the pull) | 14 |  |  | -153.75 | 9.1 | 370.335 | 153.75 | 48.25 | 431.902 | 307.501 | 39.15 | 61.567 | 1208.883
[assembly] hood-bars (25 x 8 aluminium flat bar: 2 sides, front, rear) | 4 |  |  | -175.0 | 448.0 | 231.5 | 175.0 | 705.5 | 256.5 | 350.0 | 257.5 | 25.0 | 234798.925
[assembly] hood-gasket (bought, 3 mm foam ring 150 x 125, glued under the hood's bottom plate) | 1 |  |  | -75.0 | 450.0 | 227.0 | 75.0 | 600.0 | 230.0 | 150.0 | 150.0 | 3.0 | 16198.837
[assembly] trunk-bars (50 x 8 aluminium flat bar: 2 sides, 1 top) | 3 |  |  | -130.0 | 654.0 | 258.0 | 130.0 | 704.0 | 831.5 | 260.0 | 50.0 | 573.5 | 553698.387
[assembly] nozzle-bars (40 x 8 aluminium flat bar: 2 sides, top, bottom) | 4 |  |  | -114.0 | 612.5 | 658.5 | 114.0 | 652.5 | 816.5 | 228.0 | 40.0 | 158.0 | 234860.381
[assembly] nozzle-foam (bought, 2 mm closed-cell foam tape 8 wide, 900, compressed to 1 on the bulkhead) | 4 |  |  | -114.0 | 611.5 | 658.5 | 114.0 | 612.5 | 816.5 | 228.0 | 1.0 | 158.0 | 5760.957
[assembly] riser-hardware (bought, 70 x M4 x 8 and M4 x 10 button heads) | 70 |  |  | -174.8 | 448.2 | 227.8 | 174.8 | 707.7 | 831.3 | 349.6 | 259.5 | 603.5 | 12758.223
[assembly] door-switch (bought, two-contact plunger switch, envelope) | 1 |  |  | 166.17 | -11.0 | 412.297 | 219.203 | 25.0 | 465.33 | 53.033 | 36.0 | 53.033 | 34081.25
[assembly] hardware-door-switch (bought, 2 x M4 x 8 button head into the switch's tapped ears) | 2 |  |  | 192.776 | -3.7 | 416.982 | 214.518 | 6.5 | 438.724 | 21.742 | 10.2 | 21.742 | 357.34
[assembly] ps1-bracket (angle 20x20x2, 60) | 1 |  |  | 220.0 | 60.0 | 0.0 | 280.0 | 80.0 | 20.0 | 60.0 | 20.0 | 20.0 | 4363.65
[assembly] ps1-air-proving-switch (bought, envelope) | 1 |  |  | 220.0 | 80.0 | 0.0 | 280.0 | 108.0 | 60.0 | 60.0 | 28.0 | 60.0 | 100578.329
[assembly] hardware-ps1 (bought, 2 x M6 x 12 hex, nuts, through the base pan; 2 x M4 x 8 button head into the switch) | 6 |  |  | 229.0 | 64.0 | -10.0 | 271.0 | 86.0 | 15.8 | 42.0 | 22.0 | 25.8 | 2638.352
[assembly] exhaust-thermostats (bought, TF2 thermal fuse, T_HI and T_LO cycling thermostats, envelopes on the blower outlet) | 3 |  |  | 119.0 | 123.0 | 206.0 | 241.0 | 177.0 | 221.0 | 122.0 | 54.0 | 15.0 | 23221.148
[assembly] hardware-exhaust-thermostats (bought, 6 x M4 x 8 button head into the housing) | 6 |  |  | 126.2 | 126.2 | 200.0 | 233.8 | 173.8 | 210.2 | 107.6 | 47.6 | 10.2 | 1072.02
[assembly] blower-plate-feet (angle 20x20x2, 2 x 90) | 2 |  |  | -135.0 | 64.0 | 0.0 | 135.0 | 84.0 | 20.0 | 270.0 | 20.0 | 20.0 | 13287.301
[assembly] hardware-blower-plate (bought, 4 x M4 x 8 button head into the housing, 4 x M4 x 8 and nuts into the feet, 4 x M6 x 12 hex, washers, nuts through the base pan) | 20 |  |  | -116.0 | 68.0 | -7.1 | 116.0 | 92.0 | 183.8 | 232.0 | 24.0 | 190.9 | 6357.217
[assembly] exhaust-duct (bought, 4 in aluminium pipe, 102 x 1, cut to length, one 6.5 hole for the tap) | 1 |  |  | 179.0 | 192.0 | 99.0 | 281.0 | 801.5 | 201.0 | 102.0 | 609.5 | 102.0 | 193361.673
[assembly] exhaust-clamps (bought, 2 x worm-drive hose clamps for 102, envelopes) | 4 |  |  | 178.3 | 198.0 | 98.3 | 281.7 | 750.0 | 211.7 | 103.4 | 552.0 | 113.4 | 10700.378
[assembly] exhaust-tap-barb (bought, 1/8 NPT or M6 brass barb fitting with a locknut, 5 mm barb, envelope) | 1 |  |  | 224.226 | 295.0 | 192.0 | 235.774 | 305.0 | 221.0 | 11.547 | 10.0 | 29.0 | 1215.319
[assembly] ps1-tube (bought, 6 mm silicone tube from the tap to PS1, drawn on its route) | 1 |  |  | 227.0 | 91.0 | 60.0 | 253.0 | 303.0 | 243.0 | 26.0 | 212.0 | 183.0 | 11463.04
[assembly] th1-exhaust-thermistor (bought, 10 k NTC appliance thermistor, envelope) | 1 |  |  | 102.0 | 31.5 | 145.0 | 138.0 | 62.0 | 175.0 | 36.0 | 30.5 | 30.0 | 17281.34
[assembly] hardware-th1 (bought, 1 x M4 x 20 button head from inside the lint box, nut on the body) | 2 |  |  | 115.959 | 36.3 | 166.2 | 124.041 | 58.5 | 173.8 | 8.083 | 22.2 | 7.6 | 420.925
[assembly] moisture-bars (bought, dryer moisture sensor bar set, two stainless strips on an insulating base, envelope) | 1 |  |  | 175.445 | 41.5 | 452.909 | 248.579 | 49.5 | 545.131 | 73.134 | 8.0 | 92.222 | 20769.531
[assembly] hardware-moisture-bars (bought, 2 x M4 x 16 button head from the drum side, nuts in the front gap) | 4 |  |  | 189.423 | 33.5 | 465.539 | 234.601 | 51.7 | 532.502 | 45.177 | 18.2 | 66.963 | 741.319
[assembly] entry-blank-2 (the second entry-blank, cut two to drawings/entry-blank.dxf; on the condensate drain) | 1 |  |  | -260.0 | 748.5 | 44.0 | -200.0 | 750.0 | 88.0 | 60.0 | 1.5 | 44.0 | 3865.933
[assembly] hardware-entry-blanks (bought, 4 x M4 x 8 button head, nuts) | 8 |  |  | -255.041 | 743.5 | 62.2 | -204.959 | 753.7 | 153.8 | 50.083 | 10.2 | 91.6 | 1080.514
[assembly] cable-clamps (bought, 4 x nylon P-clip for a 12 mm bundle, envelopes) | 8 |  |  | -258.0 | 115.0 | 0.0 | -227.5 | 605.0 | 15.0 | 30.5 | 490.0 | 15.0 | 3409.264
[assembly] hardware-cable-clamps (bought, 4 x M4 x 8 button head, nuts under the pan) | 8 |  |  | -254.041 | 116.2 | -6.5 | -245.959 | 603.8 | 3.7 | 8.083 | 487.6 | 10.2 | 1080.514
[assembly] roller-front-1 (bought) | 1 |  |  | -210.173 | 50.0 | 313.164 | -150.173 | 75.0 | 373.164 | 60.0 | 25.0 | 60.0 | 68521.081
[assembly] roller-rear-1 (bought) | 1 |  |  | -210.173 | 576.5 | 313.164 | -150.173 | 601.5 | 373.164 | 60.0 | 25.0 | 60.0 | 68521.081
[assembly] roller-front-2 (bought) | 1 |  |  | 150.173 | 50.0 | 313.164 | 210.173 | 75.0 | 373.164 | 60.0 | 25.0 | 60.0 | 68521.081
[assembly] roller-rear-2 (bought) | 1 |  |  | 150.173 | 576.5 | 313.164 | 210.173 | 601.5 | 373.164 | 60.0 | 25.0 | 60.0 | 68521.081
[assembly] hardware-roller-studs (bought, 4 x ISO 7379 shoulder screws 10 x 35 M8, 1.0 shims, spacers 16 x 10.5 x 8.5, M8 washers and nuts) | 20 |  |  | -188.173 | 28.5 | 335.164 | 188.173 | 623.0 | 351.164 | 376.345 | 594.5 | 16.0 | 26570.921
[assembly] belt (bought, PJ 5 rib) | 1 |  |  | -313.5 | 396.0 | 106.5 | 313.5 | 408.0 | 945.0 | 627.0 | 12.0 | 838.5 | 93324.744
[assembly] idler-pulley (bought, flat idler 40 with bearing) | 1 |  |  | -82.0 | 394.5 | 143.0 | -38.0 | 409.5 | 187.0 | 44.0 | 15.0 | 44.0 | 18849.085
[assembly] idler-arm (flat bar 25x4, cut to length) | 1 |  |  | -129.427 | 390.0 | 10.573 | -45.573 | 394.0 | 179.427 | 83.853 | 4.0 | 168.853 | 16879.089
[assembly] hardware-idler-axle (bought, M8 x 30 bolt, nut) | 1 |  |  | -67.506 | 385.0 | 158.5 | -52.494 | 414.5 | 171.5 | 15.011 | 29.5 | 13.0 | 2443.76
[assembly] idler-bracket (angle 40x40x3, cut to length) | 1 |  |  | -140.0 | 350.0 | 0.0 | -90.0 | 390.0 | 40.0 | 50.0 | 40.0 | 40.0 | 11180.667
[assembly] hardware-idler-pivot (bought, M8 x 25 bolt, nut) | 1 |  |  | -122.506 | 382.0 | 18.5 | -107.494 | 400.0 | 31.5 | 15.011 | 18.0 | 13.0 | 1865.707
[assembly] spring-bracket (angle 40x40x3, cut to length) | 1 |  |  | 45.0 | 350.0 | 0.0 | 85.0 | 390.0 | 40.0 | 40.0 | 40.0 | 40.0 | 8977.19
[assembly] hardware-idler-spring-posts (bought, 2 x M5 shoulder posts) | 2 |  |  | -84.5 | 384.0 | 22.5 | 67.5 | 417.5 | 111.5 | 152.0 | 33.5 | 89.0 | 1256.637
[assembly] idler-spring (bought, extension spring) | 1 |  |  | -80.189 | 409.0 | 25.509 | 63.189 | 417.0 | 108.491 | 143.378 | 8.0 | 82.983 | 7580.847
[assembly] hardware-idler-brackets (bought, 4 x M6 x 12 hex, nuts, through the base pan) | 8 |  |  | -134.0 | 364.0 | -9.0 | 81.0 | 376.0 | 8.6 | 215.0 | 12.0 | 17.6 | 4562.023
