OpenSourceAppliances/dryer/mechanical/drawings/frame-cut-list.csv

item | profile | length_mm | qty | note
post-1 | 40x40 | 1000.0 | 1 | corner post
post-2 | 40x40 | 1000.0 | 1 | corner post
post-3 | 40x40 | 1000.0 | 1 | corner post
post-4 | 40x40 | 1000.0 | 1 | corner post
rail-bottom-front | 40x40 | 610.0 | 1 | end rail
rail-bottom-rear | 40x40 | 610.0 | 1 | end rail
rail-bottom-left | 40x40 | 670.0 | 1 | side rail
rail-bottom-right | 40x40 | 670.0 | 1 | side rail
rail-mid-front-left | 40x40 | 135.0 | 1 | front stub, lint duct passes between the stubs
rail-mid-front-right | 40x40 | 135.0 | 1 | front stub
rail-mid-rear | 40x40 | 610.0 | 1 | end rail
rail-mid-left | 40x40 | 670.0 | 1 | side rail
rail-mid-right | 40x40 | 670.0 | 1 | side rail
rail-mid-rearcross | 40x40 | 610.0 | 1 | rear bulkhead cross rail
rail-top-front | 40x40 | 610.0 | 1 | end rail
rail-top-rear | 40x40 | 610.0 | 1 | end rail
rail-top-left | 40x40 | 670.0 | 1 | side rail
rail-top-right | 40x40 | 670.0 | 1 | side rail
rail-top-rearcross | 40x40 | 610.0 | 1 | rear bulkhead cross rail
tray-rail-1 | 20x20 | 750.0 | 1 | 2020 tray rail, on the bottom end rails
tray-rail-2 | 20x20 | 750.0 | 1 | 2020 tray rail, on the bottom end rails
felt-seal-long | 10 mm polyester felt, 18 wide strip | 1282 | 2 | or cut to drawings/felt-seal-long.dxf; one per bulkhead, round the bottom
felt-seal-short | 10 mm polyester felt, 18 wide strip | 396 | 2 | or cut to drawings/felt-seal-short.dxf; one per bulkhead, over the top
console-post-1 | 40x40 | 200.0 | 1 | console post
console-post-2 | 40x40 | 200.0 | 1 | console post
console-post-3 | 40x40 | 200.0 | 1 | console post
console-post-4 | 40x40 | 200.0 | 1 | console post
console-rail-front | 40x40 | 610.0 | 1 | console end rail
console-rail-rear | 40x40 | 610.0 | 1 | console end rail
console-rail-left | 40x40 | 58.5 | 1 | console side rail
console-rail-right | 40x40 | 58.5 | 1 | console side rail
baffle-1..3 | angle 40x40x3 aluminum | 480.0 | 3 | drum baffles, drilled on the drill press
belt (bought) | PJ poly-V, 5 ribs | 2222 | 1 | length of the drawn path round the drum, the pulley and the idler; pick the nearest catalog J length (V-012)
heat-module angles | angle 20x20x2 aluminum | 205 | 2 | box bottom, outside the side walls
heat-module angles | angle 20x20x2 aluminum | 283.0 | 2 | box bottom, inside the end walls
heat-module angles | angle 20x20x2 aluminum | 165.0 | 2 | lid, side walls
heat-module angles | angle 20x20x2 aluminum | 290.0 | 2 | lid, end walls
heat-module angles | angle 20x20x2 aluminum | 72.0 | 4 | box corners
heat-module angles | angle 20x20x2 aluminum | 198.0 | 2 | element rails, inside the side walls
heat-module angles | angle 20x20x2 aluminum | 290.0 | 1 | terminal plate foot
power-module-barrier-angle | angle 20x20x2 aluminum | 150.0 | 1 | mains to SELV barrier, on the plate
liner | 1.5 mm 5052 aluminium strip, 41.3 wide | 1482.4 | 1 | or cut to drawings/liner.dxf; roll round a 471 form, seam at the top
lint-box side bar | flat bar 30x8 aluminum | 400.1 | 2 | lint box sides; top end cut at 43 degrees to meet the liner, tapped M4 on both edges, one 8.5 hole for the hang bolt
lint-box bottom bar | flat bar 30x8 aluminum | 316.0 | 1 | lint box bottom, tapped M4 on both edges, three 4.5 through holes
spool side bar | flat bar 40x8 aluminum | 136.0 | 2 | spool sides, tapped M4 on the front edge
spool end bar | flat bar 40x8 aluminum | 140.0 | 2 | spool top and bottom, tapped M4 on the front edge
hood side bar | flat bar 25x8 aluminum | 257.5 | 2 | hood sides, tapped M4 on both edges
hood end bar | flat bar 25x8 aluminum | 334.0 | 2 | hood front and rear, tapped M4 on both edges
trunk side bar | flat bar 50x8 aluminum | 573.5 | 2 | riser trunk sides, tapped M4 on both edges and the foot
trunk top bar | flat bar 50x8 aluminum | 244.0 | 1 | riser trunk top, tapped M4 on both edges
nozzle side bar | flat bar 40x8 aluminum | 158.0 | 2 | inlet nozzle sides, tapped M4 on both edges
nozzle end bar | flat bar 40x8 aluminum | 212.0 | 2 | inlet nozzle top and bottom, tapped M4 on both edges
ps1-bracket | angle 20x20x2 aluminum | 60 | 1 | air-proving switch bracket, on the base pan
blower-plate feet | angle 20x20x2 aluminum | 90.0 | 2 | blower plate feet, on the base pan
exhaust duct (bought) | 4 in (102) aluminium pipe | 609.5 | 1 | from 2 past the housing's collar to 50 proud of the rear lower panel; one 6.5 hole on top at Y 300 for the tap
idler-arm | flat bar 25x4 aluminum | 175.4 | 1 | idler arm, two 8.5 holes and one 5.2 hole on the drill press
idler-bracket, spring-bracket | angle 40x40x3 aluminum | 50 | 2 | idler pivot and spring anchor, bolted through the base pan
