OpenSourceAppliances/dryer/mechanical/cad/audit/measured-loops.csv

source | part | loop_type | centre_u | centre_v | width | height | edges | vertices
step-section | base-pan | rrect | 0.0 | 375.0 | 687.0 | 750.0 | 8
step-section | base-pan | circle | -275.0 | 690.0 | 22.0 | 22.0 | 1
step-section | base-pan | circle | -325.0 | 20.0 | 8.5 | 8.5 | 1
step-section | base-pan | circle | -325.0 | 730.0 | 8.5 | 8.5 | 1
step-section | base-pan | circle | 325.0 | 20.0 | 8.5 | 8.5 | 1
step-section | base-pan | circle | 325.0 | 730.0 | 8.5 | 8.5 | 1
step-section | base-pan | circle | -325.0 | 80.0 | 6.5 | 6.5 | 1
step-section | base-pan | circle | -325.0 | 227.5 | 6.5 | 6.5 | 1
step-section | base-pan | circle | -325.0 | 375.0 | 6.5 | 6.5 | 1
step-section | base-pan | circle | -325.0 | 522.5 | 6.5 | 6.5 | 1
step-section | base-pan | circle | -325.0 | 670.0 | 6.5 | 6.5 | 1
step-section | base-pan | circle | -265.0 | 20.0 | 6.5 | 6.5 | 1
step-section | base-pan | circle | -265.0 | 730.0 | 6.5 | 6.5 | 1
step-section | base-pan | circle | -132.5 | 20.0 | 6.5 | 6.5 | 1
step-section | base-pan | circle | -132.5 | 730.0 | 6.5 | 6.5 | 1
step-section | base-pan | circle | -128.0 | 370.0 | 6.5 | 6.5 | 1
step-section | base-pan | circle | -110.0 | 74.0 | 6.5 | 6.5 | 1
step-section | base-pan | circle | -102.0 | 370.0 | 6.5 | 6.5 | 1
step-section | base-pan | circle | -70.0 | 74.0 | 6.5 | 6.5 | 1
step-section | base-pan | circle | -22.0 | 230.0 | 6.5 | 6.5 | 1
step-section | base-pan | circle | -22.0 | 350.0 | 6.5 | 6.5 | 1
step-section | base-pan | circle | 0.0 | 20.0 | 6.5 | 6.5 | 1
step-section | base-pan | circle | 0.0 | 730.0 | 6.5 | 6.5 | 1
step-section | base-pan | circle | 22.0 | 230.0 | 6.5 | 6.5 | 1
step-section | base-pan | circle | 22.0 | 350.0 | 6.5 | 6.5 | 1
step-section | base-pan | circle | 55.0 | 370.0 | 6.5 | 6.5 | 1
step-section | base-pan | circle | 70.0 | 74.0 | 6.5 | 6.5 | 1
step-section | base-pan | circle | 75.0 | 370.0 | 6.5 | 6.5 | 1
step-section | base-pan | circle | 110.0 | 74.0 | 6.5 | 6.5 | 1
step-section | base-pan | circle | 132.5 | 20.0 | 6.5 | 6.5 | 1
step-section | base-pan | circle | 132.5 | 730.0 | 6.5 | 6.5 | 1
step-section | base-pan | circle | 235.0 | 70.0 | 6.5 | 6.5 | 1
step-section | base-pan | circle | 265.0 | 20.0 | 6.5 | 6.5 | 1
step-section | base-pan | circle | 265.0 | 70.0 | 6.5 | 6.5 | 1
step-section | base-pan | circle | 265.0 | 730.0 | 6.5 | 6.5 | 1
step-section | base-pan | circle | 325.0 | 80.0 | 6.5 | 6.5 | 1
step-section | base-pan | circle | 325.0 | 227.5 | 6.5 | 6.5 | 1
step-section | base-pan | circle | 325.0 | 375.0 | 6.5 | 6.5 | 1
step-section | base-pan | circle | 325.0 | 522.5 | 6.5 | 6.5 | 1
step-section | base-pan | circle | 325.0 | 670.0 | 6.5 | 6.5 | 1
step-section | base-pan | circle | -250.0 | 120.0 | 4.5 | 4.5 | 1
step-section | base-pan | circle | -250.0 | 280.0 | 4.5 | 4.5 | 1
step-section | base-pan | circle | -250.0 | 440.0 | 4.5 | 4.5 | 1
step-section | base-pan | circle | -250.0 | 600.0 | 4.5 | 4.5 | 1
step-section | basket-far-clamp | sector | 0.0 | 401.381 | 309.107 | 70.762 | 4
step-section | basket-far-clamp | circle | -123.142 | 399.903 | 3.4 | 3.4 | 1
step-section | basket-far-clamp | circle | -83.042 | 403.343 | 3.4 | 3.4 | 1
step-section | basket-far-clamp | circle | -45.548 | 373.185 | 3.4 | 3.4 | 1
step-section | basket-far-clamp | circle | 45.548 | 373.185 | 3.4 | 3.4 | 1
step-section | basket-far-clamp | circle | 83.042 | 403.343 | 3.4 | 3.4 | 1
step-section | basket-far-clamp | circle | 123.142 | 399.903 | 3.4 | 3.4 | 1
step-section | basket-far-plate | sector | 0.0 | 401.381 | 309.107 | 70.762 | 4
step-section | basket-far-plate | circle | -123.142 | 399.903 | 3.0 | 3.0 | 1
step-section | basket-far-plate | circle | -83.042 | 403.343 | 3.0 | 3.0 | 1
step-section | basket-far-plate | circle | -45.548 | 373.185 | 3.0 | 3.0 | 1
step-section | basket-far-plate | circle | 45.548 | 373.185 | 3.0 | 3.0 | 1
step-section | basket-far-plate | circle | 83.042 | 403.343 | 3.0 | 3.0 | 1
step-section | basket-far-plate | circle | 123.142 | 399.903 | 3.0 | 3.0 | 1
step-section | basket-lip-clamp | sector | 0.0 | 405.221 | 326.905 | 84.442 | 4
step-section | basket-lip-clamp | sector | 0.0 | 401.491 | 310.833 | 72.181 | 4
step-section | basket-lip-clamp | circle | -150.9 | 429.052 | 3.4 | 3.4 | 1
step-section | basket-lip-clamp | circle | -96.153 | 415.538 | 3.4 | 3.4 | 1
step-section | basket-lip-clamp | circle | -32.901 | 397.401 | 3.4 | 3.4 | 1
step-section | basket-lip-clamp | circle | 32.901 | 397.401 | 3.4 | 3.4 | 1
step-section | basket-lip-clamp | circle | 96.153 | 415.538 | 3.4 | 3.4 | 1
step-section | basket-lip-clamp | circle | 150.9 | 429.052 | 3.4 | 3.4 | 1
step-section | basket-lip-plate | other | 0.0 | 405.221 | 326.905 | 84.442 | 12
step-section | basket-lip-plate | sector | 0.0 | 401.491 | 310.833 | 72.181 | 4
step-section | basket-lip-plate | circle | -150.9 | 429.052 | 3.0 | 3.0 | 1
step-section | basket-lip-plate | circle | -96.153 | 415.538 | 3.0 | 3.0 | 1
step-section | basket-lip-plate | circle | -32.901 | 397.401 | 3.0 | 3.0 | 1
step-section | basket-lip-plate | circle | 32.901 | 397.401 | 3.0 | 3.0 | 1
step-section | basket-lip-plate | circle | 96.153 | 415.538 | 3.0 | 3.0 | 1
step-section | basket-lip-plate | circle | 150.9 | 429.052 | 3.0 | 3.0 | 1
step-section | bay-ceiling | rpoly | 0.0 | 396.0 | 687.0 | 708.0 | 8
step-section | bay-ceiling | rect | 0.0 | 679.0 | 264.0 | 57.0 | 4
step-section | bay-ceiling | rect | -137.9 | 402.0 | 40.0 | 90.0 | 4
step-section | bay-ceiling | rect | 145.4 | 402.0 | 40.0 | 90.0 | 4
step-section | bay-ceiling | rect | 0.0 | 610.75 | 612.0 | 2.5 | 4
step-section | bay-ceiling | circle | -200.0 | 690.0 | 30.0 | 30.0 | 1
step-section | bay-ceiling | rect | -225.0 | 652.25 | 152.0 | 3.5 | 4
step-section | bay-ceiling | circle | -275.0 | 690.0 | 22.0 | 22.0 | 1
step-section | bay-ceiling | circle | 290.0 | 60.0 | 16.0 | 16.0 | 1
step-section | bay-ceiling | circle | -325.0 | 80.0 | 6.5 | 6.5 | 1
step-section | bay-ceiling | circle | -325.0 | 227.5 | 6.5 | 6.5 | 1
step-section | bay-ceiling | circle | -325.0 | 375.0 | 6.5 | 6.5 | 1
step-section | bay-ceiling | circle | -325.0 | 522.5 | 6.5 | 6.5 | 1
step-section | bay-ceiling | circle | -325.0 | 670.0 | 6.5 | 6.5 | 1
step-section | bay-ceiling | circle | -265.0 | 631.5 | 6.5 | 6.5 | 1
step-section | bay-ceiling | circle | -265.0 | 730.0 | 6.5 | 6.5 | 1
step-section | bay-ceiling | circle | -132.5 | 631.5 | 6.5 | 6.5 | 1
step-section | bay-ceiling | circle | -132.5 | 730.0 | 6.5 | 6.5 | 1
step-section | bay-ceiling | circle | 0.0 | 631.5 | 6.5 | 6.5 | 1
step-section | bay-ceiling | circle | 0.0 | 730.0 | 6.5 | 6.5 | 1
step-section | bay-ceiling | circle | 132.5 | 631.5 | 6.5 | 6.5 | 1
step-section | bay-ceiling | circle | 132.5 | 730.0 | 6.5 | 6.5 | 1
step-section | bay-ceiling | circle | 265.0 | 631.5 | 6.5 | 6.5 | 1
step-section | bay-ceiling | circle | 265.0 | 730.0 | 6.5 | 6.5 | 1
step-section | bay-ceiling | circle | 325.0 | 80.0 | 6.5 | 6.5 | 1
step-section | bay-ceiling | circle | 325.0 | 227.5 | 6.5 | 6.5 | 1
step-section | bay-ceiling | circle | 325.0 | 375.0 | 6.5 | 6.5 | 1
step-section | bay-ceiling | circle | 325.0 | 522.5 | 6.5 | 6.5 | 1
step-section | bay-ceiling | circle | 325.0 | 670.0 | 6.5 | 6.5 | 1
step-section | blower-plate | rrect | 0.0 | 122.5 | 260.0 | 245.0 | 8
step-section | blower-plate | rect | 0.0 | 130.0 | 140.0 | 120.0 | 4
step-section | blower-plate | circle | -110.0 | 10.0 | 4.5 | 4.5 | 1
step-section | blower-plate | circle | -88.0 | 60.0 | 4.5 | 4.5 | 1
step-section | blower-plate | circle | -88.0 | 180.0 | 4.5 | 4.5 | 1
step-section | blower-plate | circle | -70.0 | 10.0 | 4.5 | 4.5 | 1
step-section | blower-plate | circle | 70.0 | 10.0 | 4.5 | 4.5 | 1
step-section | blower-plate | circle | 88.0 | 60.0 | 4.5 | 4.5 | 1
step-section | blower-plate | circle | 88.0 | 180.0 | 4.5 | 4.5 | 1
step-section | blower-plate | circle | 110.0 | 10.0 | 4.5 | 4.5 | 1
step-section | console-cap | rrect | 0.0 | 680.75 | 693.0 | 141.5 | 8
step-section | console-cap | circle | -325.0 | 680.75 | 6.5 | 6.5 | 1
step-section | console-cap | circle | -245.0 | 631.5 | 6.5 | 6.5 | 1
step-section | console-cap | circle | -245.0 | 730.0 | 6.5 | 6.5 | 1
step-section | console-cap | circle | -81.667 | 631.5 | 6.5 | 6.5 | 1
step-section | console-cap | circle | -81.667 | 730.0 | 6.5 | 6.5 | 1
step-section | console-cap | circle | 81.667 | 631.5 | 6.5 | 6.5 | 1
step-section | console-cap | circle | 81.667 | 730.0 | 6.5 | 6.5 | 1
step-section | console-cap | circle | 245.0 | 631.5 | 6.5 | 6.5 | 1
step-section | console-cap | circle | 245.0 | 730.0 | 6.5 | 6.5 | 1
step-section | console-cap | circle | 325.0 | 680.75 | 6.5 | 6.5 | 1
step-section | console-cheek-left | rrect | 680.75 | 1100.75 | 141.5 | 201.5 | 8
step-section | console-cheek-left | circle | 631.5 | 1030.0 | 6.5 | 6.5 | 1
step-section | console-cheek-left | circle | 631.5 | 1133.0 | 6.5 | 6.5 | 1
step-section | console-cheek-left | circle | 680.75 | 1181.5 | 6.5 | 6.5 | 1
step-section | console-cheek-left | circle | 730.0 | 1030.0 | 6.5 | 6.5 | 1
step-section | console-cheek-left | circle | 730.0 | 1133.0 | 6.5 | 6.5 | 1
step-section | console-cheek-right | rrect | 680.75 | 1100.75 | 141.5 | 201.5 | 8
step-section | console-cheek-right | circle | 631.5 | 1030.0 | 6.5 | 6.5 | 1
step-section | console-cheek-right | circle | 631.5 | 1133.0 | 6.5 | 6.5 | 1
step-section | console-cheek-right | circle | 680.75 | 1181.5 | 6.5 | 6.5 | 1
step-section | console-cheek-right | circle | 730.0 | 1030.0 | 6.5 | 6.5 | 1
step-section | console-cheek-right | circle | 730.0 | 1133.0 | 6.5 | 6.5 | 1
step-section | console-face | rrect | 0.0 | 1101.5 | 690.0 | 200.0 | 8
step-section | console-face | rect | 0.0 | 1084.5 | 560.0 | 120.0 | 4
step-section | console-face | circle | -325.0 | 1030.0 | 6.5 | 6.5 | 1
step-section | console-face | circle | -325.0 | 1133.0 | 6.5 | 6.5 | 1
step-section | console-face | circle | -245.0 | 1181.5 | 6.5 | 6.5 | 1
step-section | console-face | circle | -81.667 | 1181.5 | 6.5 | 6.5 | 1
step-section | console-face | circle | 81.667 | 1181.5 | 6.5 | 6.5 | 1
step-section | console-face | circle | 245.0 | 1181.5 | 6.5 | 6.5 | 1
step-section | console-face | circle | 325.0 | 1030.0 | 6.5 | 6.5 | 1
step-section | console-face | circle | 325.0 | 1133.0 | 6.5 | 6.5 | 1
step-section | console-face | circle | -295.0 | 1014.5 | 4.5 | 4.5 | 1
step-section | console-face | circle | -295.0 | 1154.5 | 4.5 | 4.5 | 1
step-section | console-face | circle | 0.0 | 1014.5 | 4.5 | 4.5 | 1
step-section | console-face | circle | 0.0 | 1154.5 | 4.5 | 4.5 | 1
step-section | console-face | circle | 295.0 | 1014.5 | 4.5 | 4.5 | 1
step-section | console-face | circle | 295.0 | 1154.5 | 4.5 | 4.5 | 1
step-section | console-rear | rrect | 0.0 | 1100.75 | 690.0 | 201.5 | 8
step-section | console-rear | circle | -325.0 | 1030.0 | 6.5 | 6.5 | 1
step-section | console-rear | circle | -325.0 | 1133.0 | 6.5 | 6.5 | 1
step-section | console-rear | circle | -245.0 | 1181.5 | 6.5 | 6.5 | 1
step-section | console-rear | circle | -81.667 | 1181.5 | 6.5 | 6.5 | 1
step-section | console-rear | circle | 81.667 | 1181.5 | 6.5 | 6.5 | 1
step-section | console-rear | circle | 245.0 | 1181.5 | 6.5 | 6.5 | 1
step-section | console-rear | circle | 325.0 | 1030.0 | 6.5 | 6.5 | 1
step-section | console-rear | circle | 325.0 | 1133.0 | 6.5 | 6.5 | 1
step-section | door-disc | circle | 0.0 | 631.5 | 540.0 | 540.0 | 1
step-section | door-disc | circle | -259.0 | 681.5 | 4.5 | 4.5 | 1
step-section | door-disc | circle | -250.0 | 681.5 | 4.5 | 4.5 | 1
step-section | door-disc | circle | 220.0 | 567.5 | 4.5 | 4.5 | 1
step-section | door-disc | circle | 220.0 | 695.5 | 4.5 | 4.5 | 1
step-section | door-ring | circle | 0.0 | 631.5 | 560.0 | 560.0 | 1
step-section | door-ring | circle | 0.0 | 631.5 | 470.0 | 470.0 | 1
step-section | door-ring | circle | 182.434 | 449.066 | 8.5 | 8.5 | 1
step-section | door-ring | circle | -266.0 | 581.5 | 6.5 | 6.5 | 1
step-section | door-ring | circle | -252.0 | 581.5 | 6.5 | 6.5 | 1
step-section | door-ring | circle | -237.899 | 532.959 | 4.5 | 4.5 | 1
step-section | door-ring | circle | -237.899 | 730.041 | 4.5 | 4.5 | 1
step-section | door-ring | circle | -98.541 | 393.601 | 4.5 | 4.5 | 1
step-section | door-ring | circle | -98.541 | 869.399 | 4.5 | 4.5 | 1
step-section | door-ring | circle | 98.541 | 393.601 | 4.5 | 4.5 | 1
step-section | door-ring | circle | 98.541 | 869.399 | 4.5 | 4.5 | 1
step-section | door-ring | circle | 237.899 | 532.959 | 4.5 | 4.5 | 1
step-section | door-ring | circle | 237.899 | 730.041 | 4.5 | 4.5 | 1
step-section | drum-ring-front | circle | 0.0 | 631.5 | 618.4 | 618.4 | 1
step-section | drum-ring-front | circle | 0.0 | 631.5 | 540.0 | 540.0 | 1
step-section | drum-ring-front | circle | -301.2 | 631.5 | 4.5 | 4.5 | 1
step-section | drum-ring-front | circle | -294.618 | 568.877 | 4.5 | 4.5 | 1
step-section | drum-ring-front | circle | -294.618 | 694.123 | 4.5 | 4.5 | 1
step-section | drum-ring-front | circle | -275.16 | 508.991 | 4.5 | 4.5 | 1
step-section | drum-ring-front | circle | -275.16 | 754.009 | 4.5 | 4.5 | 1
step-section | drum-ring-front | circle | -243.676 | 454.459 | 4.5 | 4.5 | 1
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
step-section | rear-bulkhead | circle | 61.0 | 765.5 | 10.0 | 10.0 | 1
step-section | rear-bulkhead | circle | 61.0 | 779.5 | 10.0 | 10.0 | 1
step-section | rear-bulkhead | circle | 61.0 | 793.5 | 10.0 | 10.0 | 1
step-section | rear-bulkhead | circle | 75.0 | 681.5 | 10.0 | 10.0 | 1
step-section | rear-bulkhead | circle | 75.0 | 695.5 | 10.0 | 10.0 | 1
step-section | rear-bulkhead | circle | 75.0 | 709.5 | 10.0 | 10.0 | 1
step-section | rear-bulkhead | circle | 75.0 | 723.5 | 10.0 | 10.0 | 1
step-section | rear-bulkhead | circle | 75.0 | 737.5 | 10.0 | 10.0 | 1
step-section | rear-bulkhead | circle | 75.0 | 751.5 | 10.0 | 10.0 | 1
step-section | rear-bulkhead | circle | 75.0 | 765.5 | 10.0 | 10.0 | 1
step-section | rear-bulkhead | circle | 75.0 | 779.5 | 10.0 | 10.0 | 1
step-section | rear-bulkhead | circle | 75.0 | 793.5 | 10.0 | 10.0 | 1
step-section | rear-bulkhead | circle | 89.0 | 681.5 | 10.0 | 10.0 | 1
step-section | rear-bulkhead | circle | 89.0 | 695.5 | 10.0 | 10.0 | 1
step-section | rear-bulkhead | circle | 89.0 | 709.5 | 10.0 | 10.0 | 1
step-section | rear-bulkhead | circle | 89.0 | 723.5 | 10.0 | 10.0 | 1
step-section | rear-bulkhead | circle | 89.0 | 737.5 | 10.0 | 10.0 | 1
step-section | rear-bulkhead | circle | 89.0 | 751.5 | 10.0 | 10.0 | 1
step-section | rear-bulkhead | circle | 89.0 | 765.5 | 10.0 | 10.0 | 1
step-section | rear-bulkhead | circle | 89.0 | 779.5 | 10.0 | 10.0 | 1
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
