OpenSourceAppliances/dryer/mechanical/drawings/power-module-plate.dxf

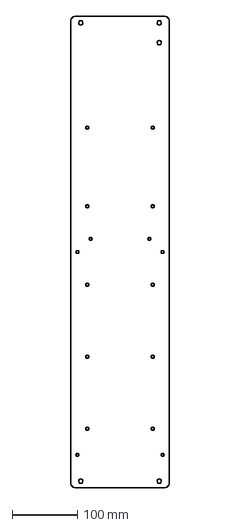
[picture p76: CAD file, 2026-11-07]
mechanical/drawings/power-module-plate.dxf
150.0 x 720.0 mm
