OpenSourceAppliances/dryer/mechanical/drawings/bay-ceiling.dxf

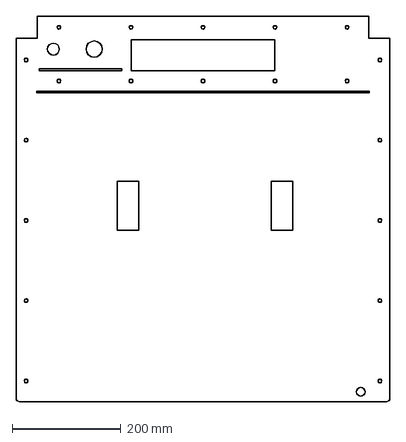
[picture p77: CAD file, 2026-11-07]
mechanical/drawings/bay-ceiling.dxf
687.0 x 708.0 mm
