OpenSourceAppliances/dryer/mechanical/step/rail-bottom-right.step

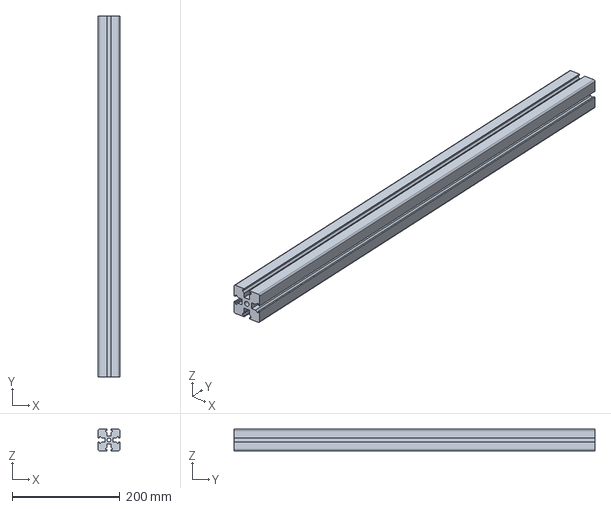
[picture p78: CAD file, 2026-11-07]
mechanical/step/rail-bottom-right.step
40.0 x 670.0 x 40.0 mm
