OpenSourceAppliances/dryer/mechanical/drawings/basket-lip-plate.dxf

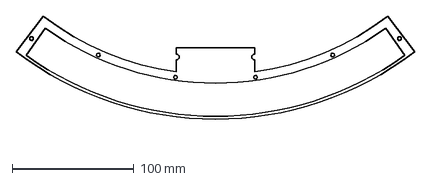
[picture p79: CAD file, 2026-11-07]
mechanical/drawings/basket-lip-plate.dxf
326.9 x 102.9 mm
