OpenSourceAppliances/dryer/mechanical/step/console-rear.step

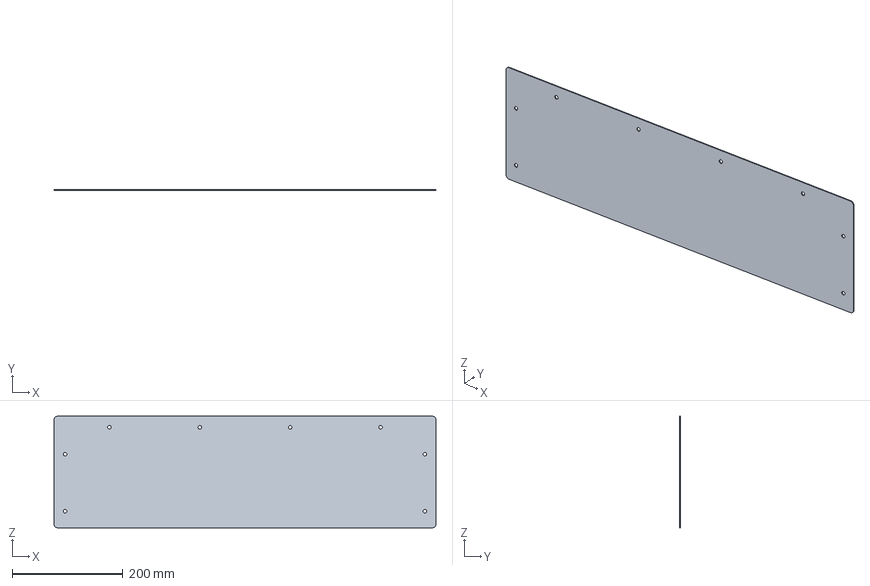
[picture p80: CAD file, 2026-11-07]
mechanical/step/console-rear.step
690.0 x 1.50 x 201.5 mm
