OpenSourceAppliances/dryer/mechanical/drawings/side-panel-right.dxf

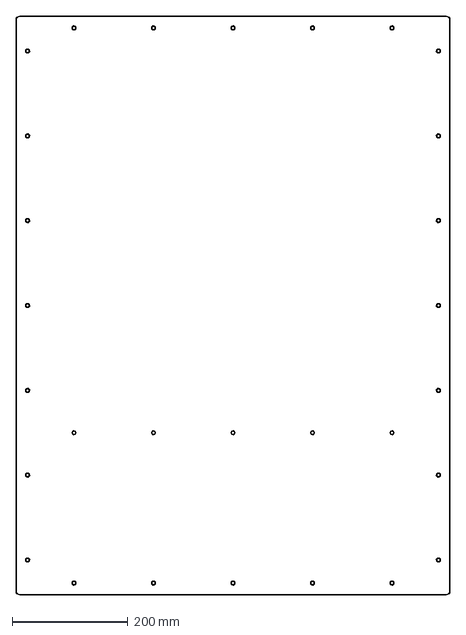
[picture p81: CAD file, 2026-11-07]
mechanical/drawings/side-panel-right.dxf
750.0 x 1000.0 mm
