OpenSourceAppliances/dryer/mechanical/step/door-ring.step

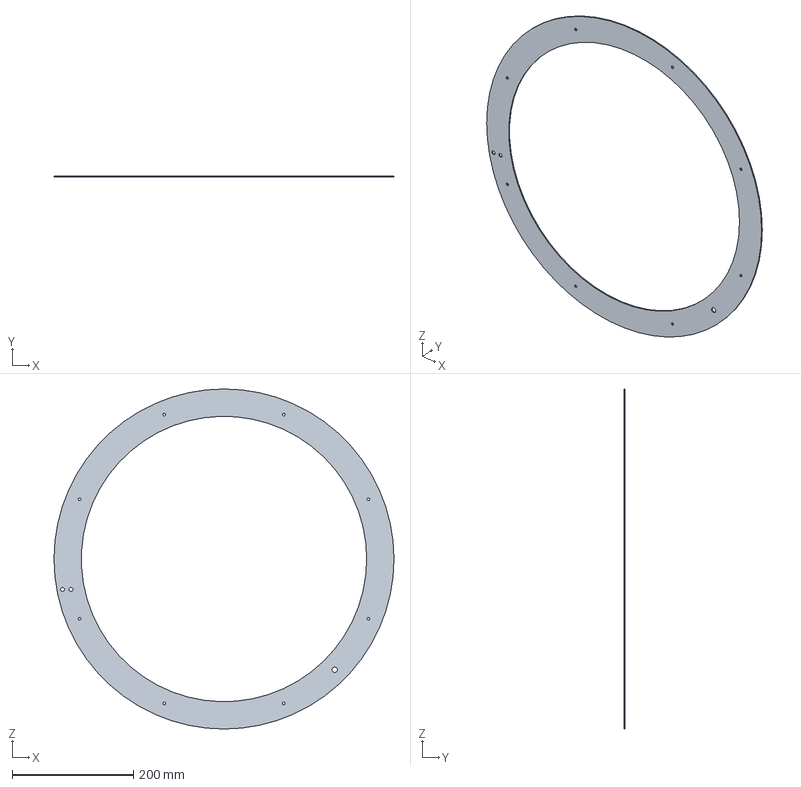
[picture p82: CAD file, 2026-11-07]
mechanical/step/door-ring.step
560.0 x 2.00 x 560.0 mm
