OpenSourceAppliances/dryer/mechanical/drawings/heat-module-tray.dxf

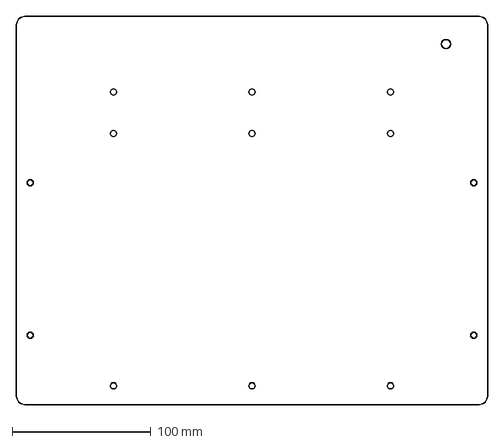
[picture p83: CAD file, 2026-11-07]
mechanical/drawings/heat-module-tray.dxf
340.0 x 280.0 mm
