OpenSourceAppliances/dryer/mechanical/step/rail-bottom-front.step

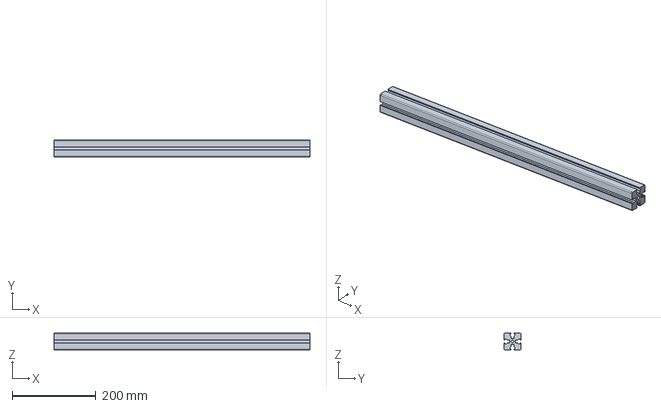
[picture p84: CAD file, 2026-11-07]
mechanical/step/rail-bottom-front.step
610.0 x 40.0 x 40.0 mm
