OpenSourceAppliances/dryer/mechanical/drawings/door-disc.dxf

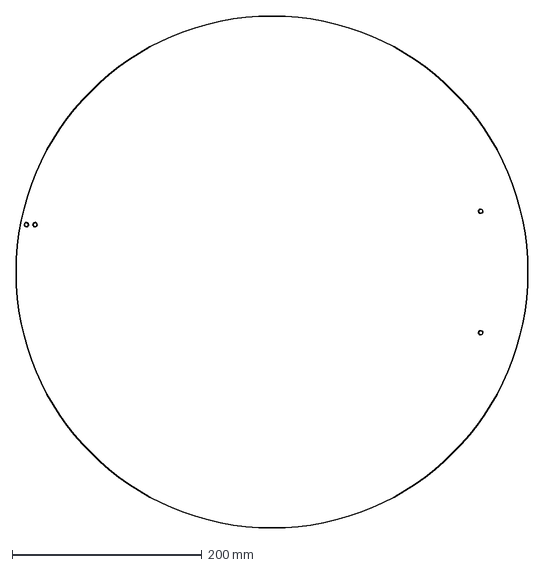
[picture p85: CAD file, 2026-11-07]
mechanical/drawings/door-disc.dxf
540.0 x 540.0 mm
