OpenSourceAppliances/dryer/mechanical/step/drum-ring-front.step

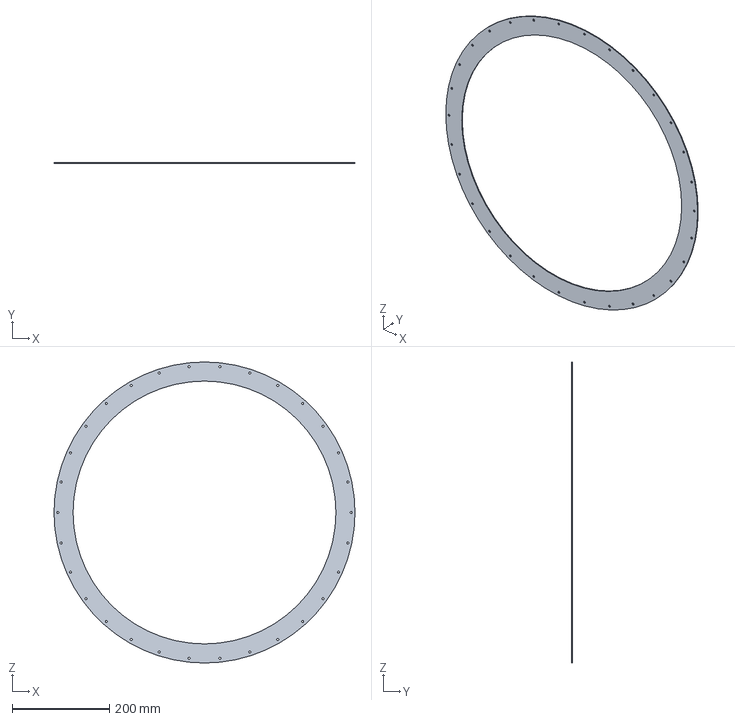
[picture p86: CAD file, 2026-11-07]
mechanical/step/drum-ring-front.step
618.4 x 2.00 x 618.4 mm
