OpenSourceAppliances/dryer/mechanical/drawings/liner-splice.dxf

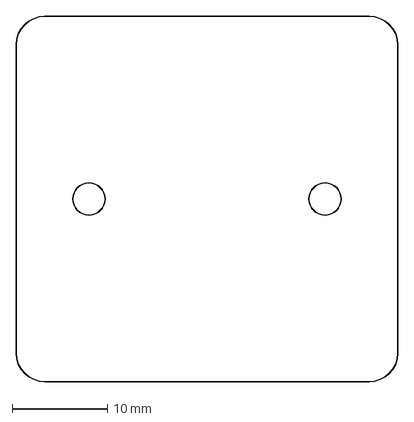
[picture p87: CAD file, 2026-11-07]
mechanical/drawings/liner-splice.dxf
40.0 x 38.3 mm
