OpenSourceAppliances/dryer/mechanical/step/post-2.step

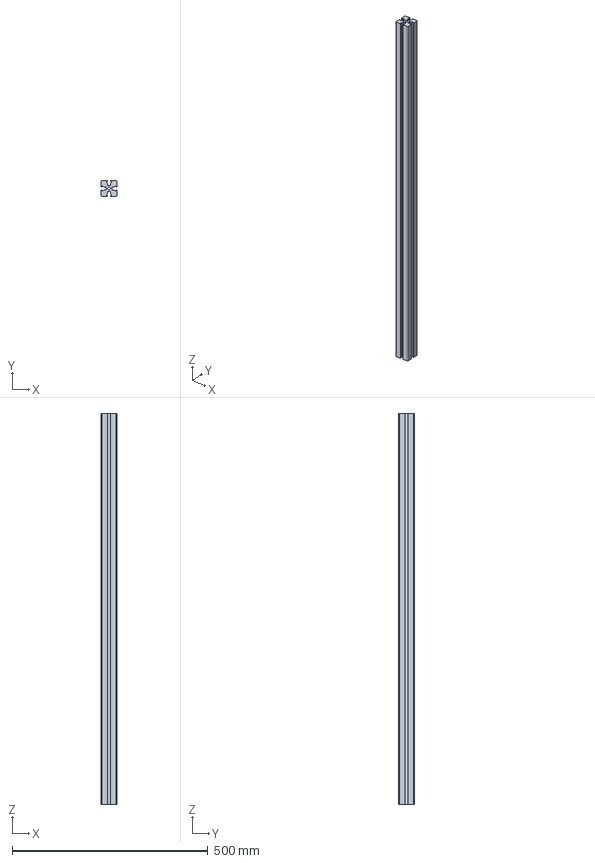
[picture p88: CAD file, 2026-11-07]
mechanical/step/post-2.step
40.0 x 40.0 x 1000.0 mm
