OpenSourceAppliances/dryer/mechanical/drawings/door-ring.dxf

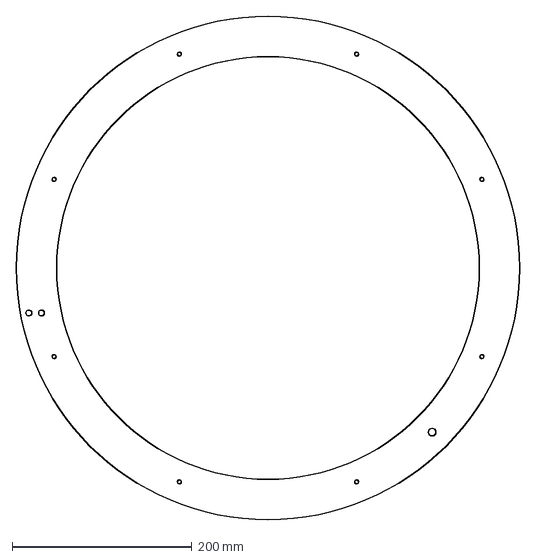
[picture p89: CAD file, 2026-11-07]
mechanical/drawings/door-ring.dxf
560.0 x 560.0 mm
