OpenSourceAppliances/dryer/mechanical/step/heat-module-top.step

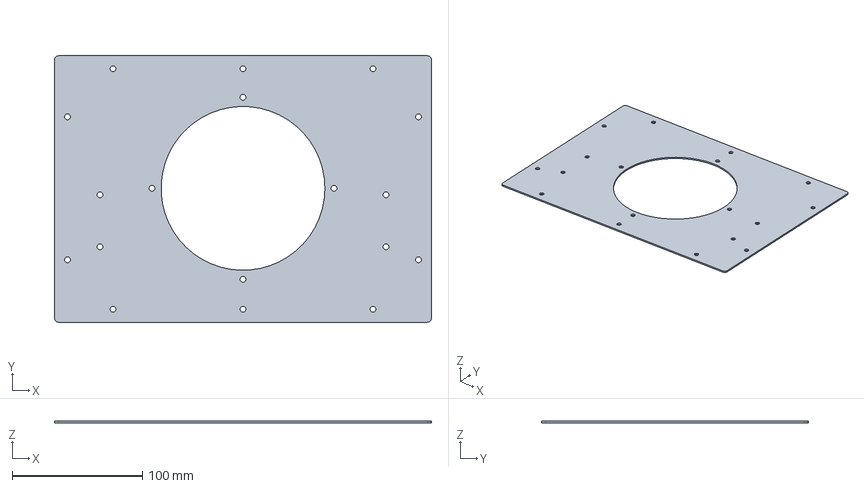
[picture p90: CAD file, 2026-11-07]
mechanical/step/heat-module-top.step
290.0 x 205.0 x 1.50 mm
