OpenSourceAppliances/dryer/mechanical/drawings/top-panel.dxf

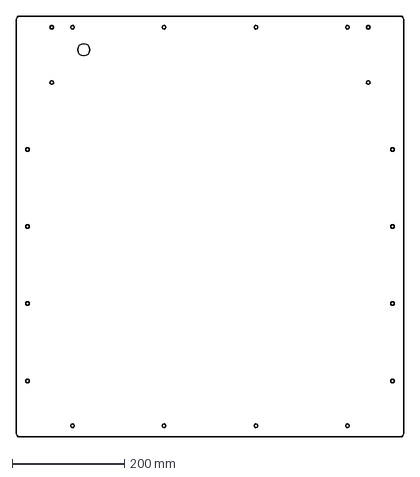
[picture p91: CAD file, 2026-11-07]
mechanical/drawings/top-panel.dxf
690.0 x 750.0 mm
