OpenSourceAppliances/dryer/mechanical/step/basket-far-clamp.step

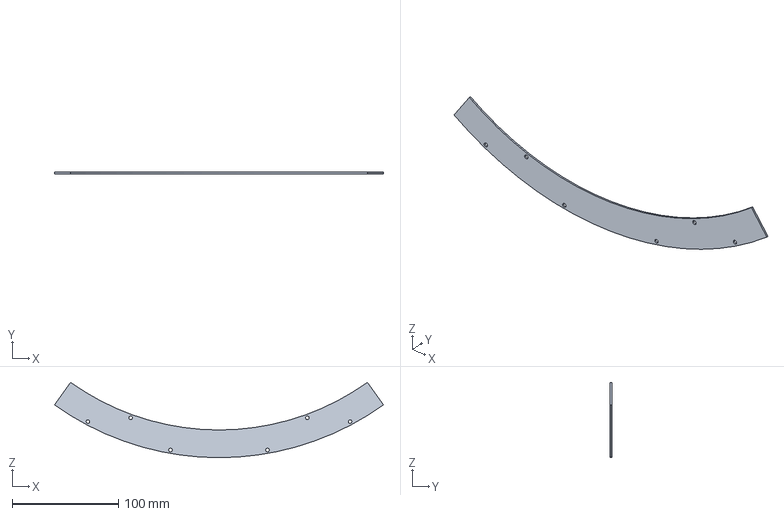
[picture p92: CAD file, 2026-11-07]
mechanical/step/basket-far-clamp.step
309.1 x 1.50 x 70.8 mm
