OpenSourceAppliances/dryer/mechanical/drawings/front-lower-panel.dxf

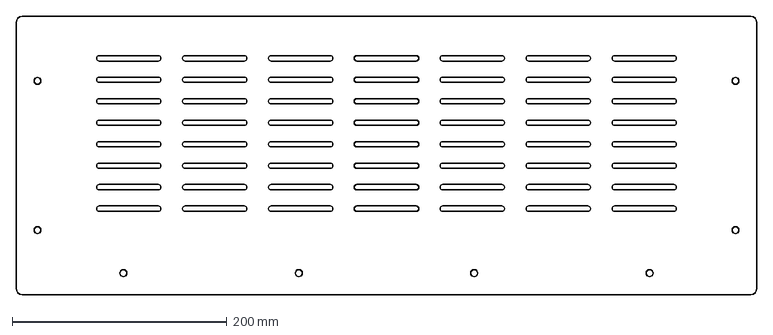
[picture p93: CAD file, 2026-11-07]
mechanical/drawings/front-lower-panel.dxf
690.0 x 259.0 mm
