OpenSourceAppliances/dryer/mechanical/step/console-face.step

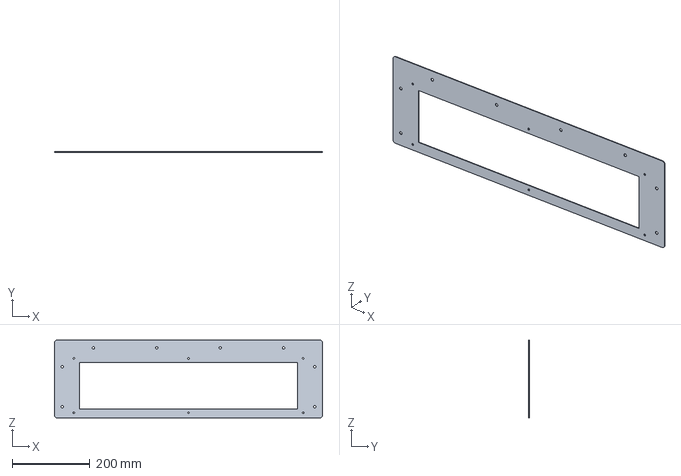
[picture p94: CAD file, 2026-11-07]
mechanical/step/console-face.step
690.0 x 1.50 x 200.0 mm
