OpenSourceAppliances/dryer/mechanical/drawings/drum-splice.dxf

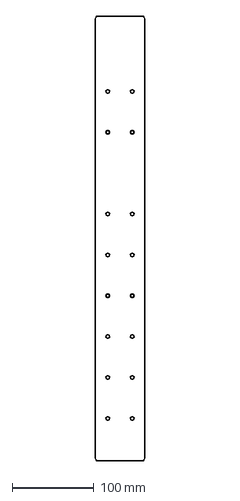
[picture p95: CAD file, 2026-11-07]
mechanical/drawings/drum-splice.dxf
60.0 x 544.0 mm
