OpenSourceAppliances/dryer/mechanical/drawings/console-cheek-left.dxf

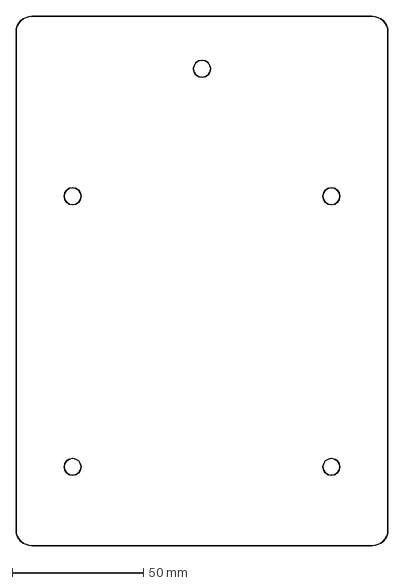
[picture p96: CAD file, 2026-11-07]
mechanical/drawings/console-cheek-left.dxf
141.5 x 201.5 mm
