OpenSourceAppliances/dryer/mechanical/step/basket-far-plate.step

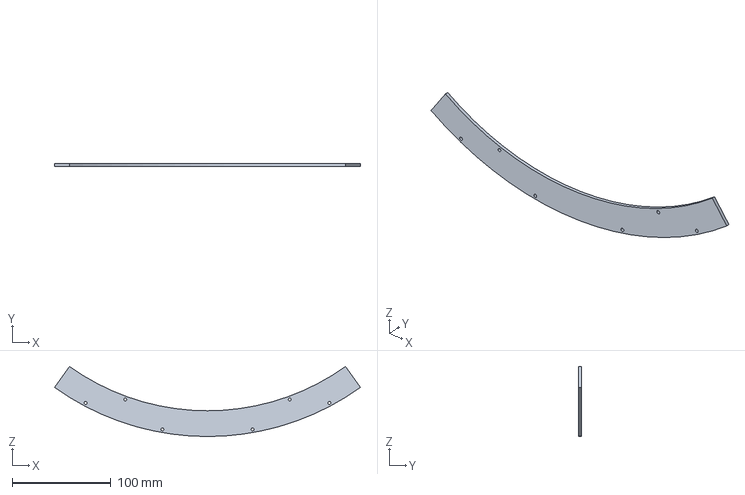
[picture p97: CAD file, 2026-11-07]
mechanical/step/basket-far-plate.step
309.1 x 3.00 x 70.8 mm
