OpenSourceAppliances/dryer/mechanical/drawings/trunk-front.dxf

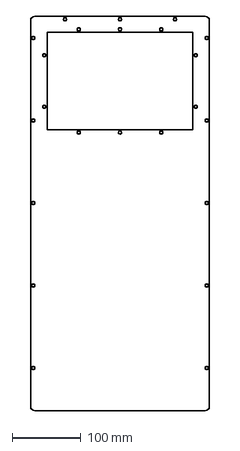
[picture p98: CAD file, 2026-11-07]
mechanical/drawings/trunk-front.dxf
260.0 x 573.5 mm
