OpenSourceAppliances/dryer/mechanical/step/entry-blank.step

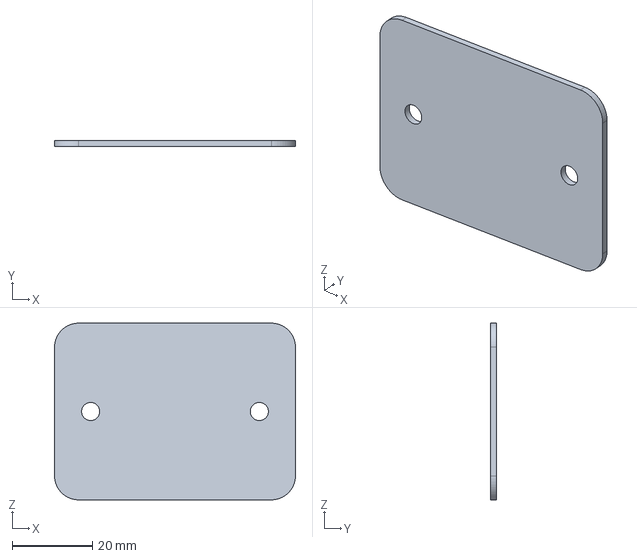
[picture p99: CAD file, 2026-11-07]
mechanical/step/entry-blank.step
60.0 x 1.50 x 44.0 mm
