OpenSourceAppliances/dryer/mechanical/drawings/heat-module-wall-rear.dxf

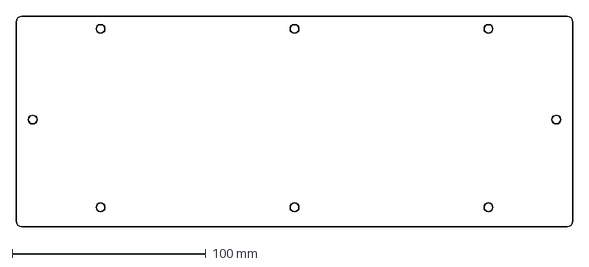
[picture p100: CAD file, 2026-11-07]
mechanical/drawings/heat-module-wall-rear.dxf
287.0 x 108.5 mm
