OpenSourceAppliances/dryer/mechanical/drawings/heat-module-wall-right.dxf

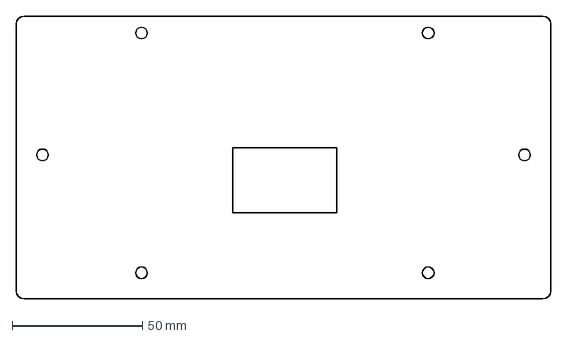
[picture p101: CAD file, 2026-11-07]
mechanical/drawings/heat-module-wall-right.dxf
205.0 x 108.5 mm
