OpenSourceAppliances/dryer/mechanical/step/front-lower-panel.step

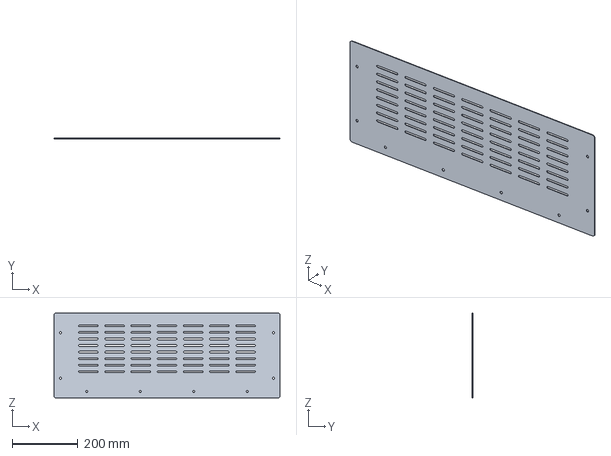
[picture p102: CAD file, 2026-11-07]
mechanical/step/front-lower-panel.step
690.0 x 1.50 x 259.0 mm
