OpenSourceAppliances/dryer/mechanical/drawings/heat-module-wall-left.dxf

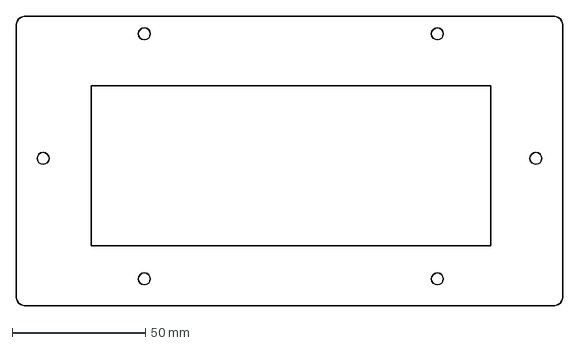
[picture p103: CAD file, 2026-11-07]
mechanical/drawings/heat-module-wall-left.dxf
205.0 x 108.5 mm
