OpenSourceAppliances/dryer/mechanical/step/heat-module-wall-rear.step

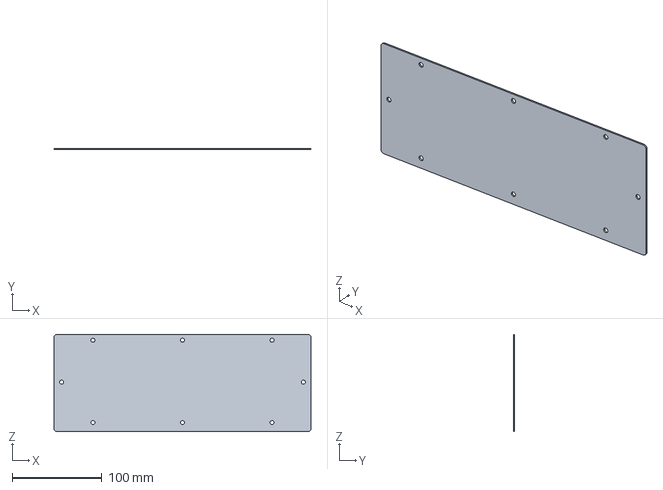
[picture p104: CAD file, 2026-11-07]
mechanical/step/heat-module-wall-rear.step
287.0 x 1.50 x 108.5 mm
