OpenSourceAppliances/dryer/mechanical/drawings/rear-upper-panel.dxf

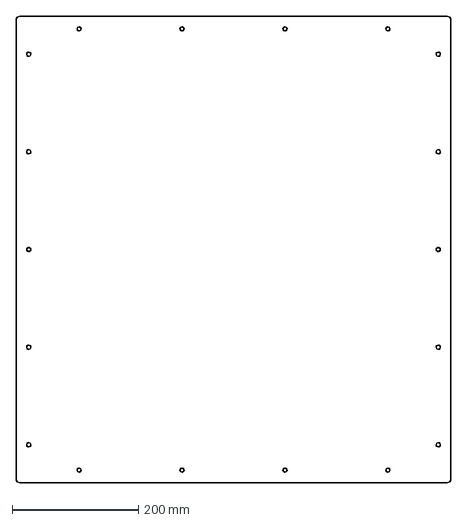
[picture p105: CAD file, 2026-11-07]
mechanical/drawings/rear-upper-panel.dxf
690.0 x 740.0 mm
