OpenSourceAppliances/dryer/mechanical/step/tray-rail-1.step

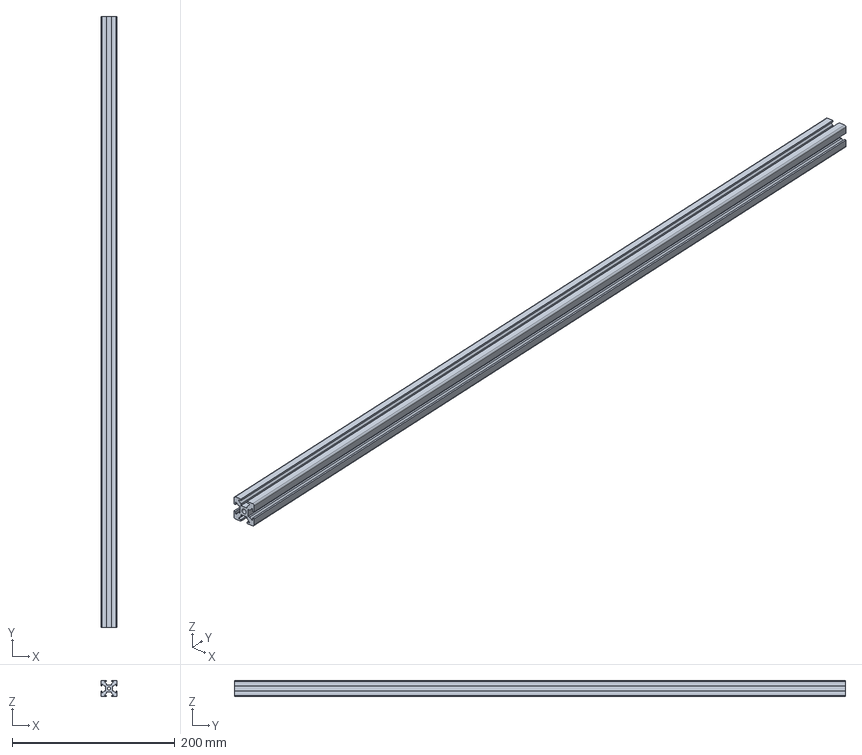
[picture p106: CAD file, 2026-11-07]
mechanical/step/tray-rail-1.step
20.0 x 750.0 x 20.0 mm
