OpenSourceAppliances/dryer/mechanical/drawings/blower-plate.dxf

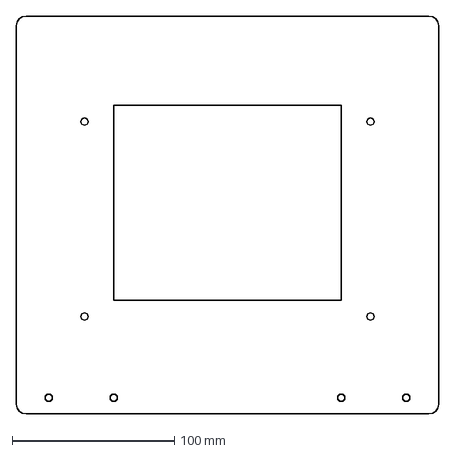
[picture p107: CAD file, 2026-11-07]
mechanical/drawings/blower-plate.dxf
260.0 x 245.0 mm
