OpenSourceAppliances/dryer/mechanical/step/console-cheek-left.step

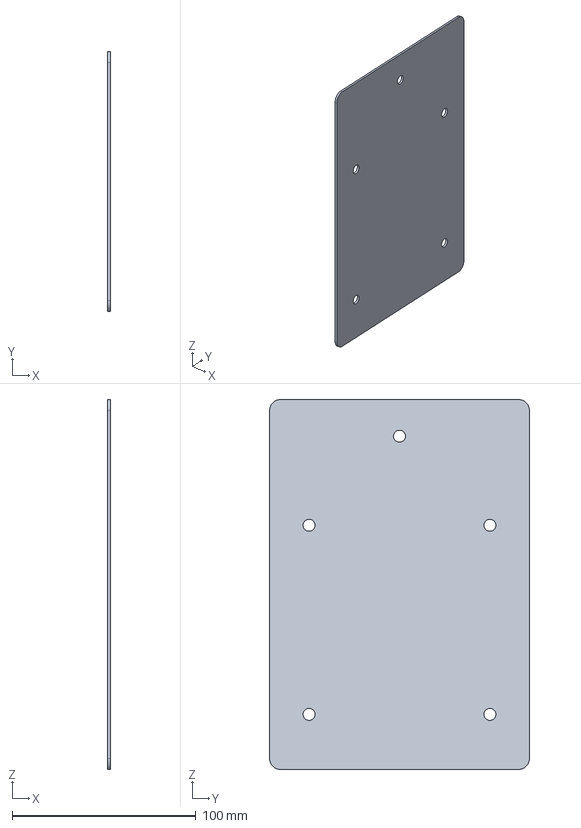
[picture p108: CAD file, 2026-11-07]
mechanical/step/console-cheek-left.step
1.50 x 141.5 x 201.5 mm
