OpenSourceAppliances/dryer/mechanical/drawings/power-module-cover.dxf

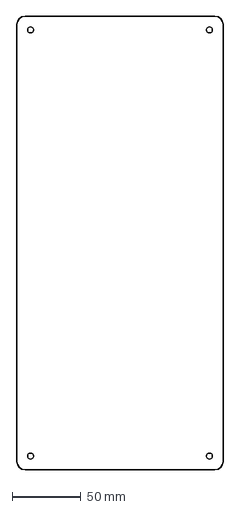
[picture p109: CAD file, 2026-11-07]
mechanical/drawings/power-module-cover.dxf
150.0 x 330.0 mm
