OpenSourceAppliances/dryer/mechanical/step/liner-splice.step

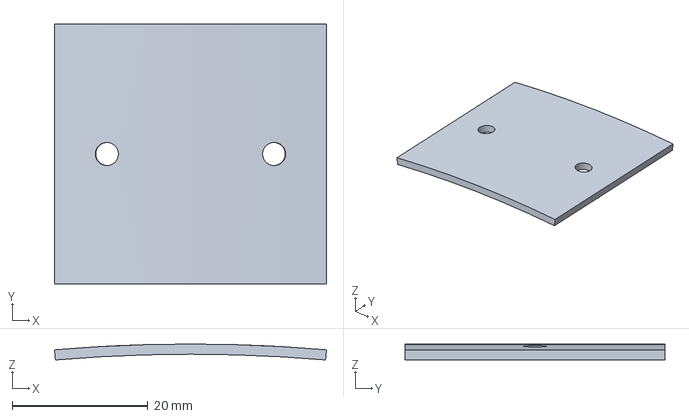
[picture p110: CAD file, 2026-11-07]
mechanical/step/liner-splice.step
40.1 x 38.3 x 2.35 mm
