OpenSourceAppliances/dryer/mechanical/drawings/console-cap.dxf

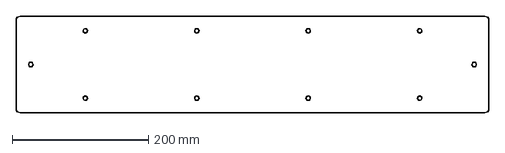
[picture p111: CAD file, 2026-11-07]
mechanical/drawings/console-cap.dxf
693.0 x 141.5 mm
