OpenSourceAppliances/dryer/mechanical/step/basket-lip-plate.step

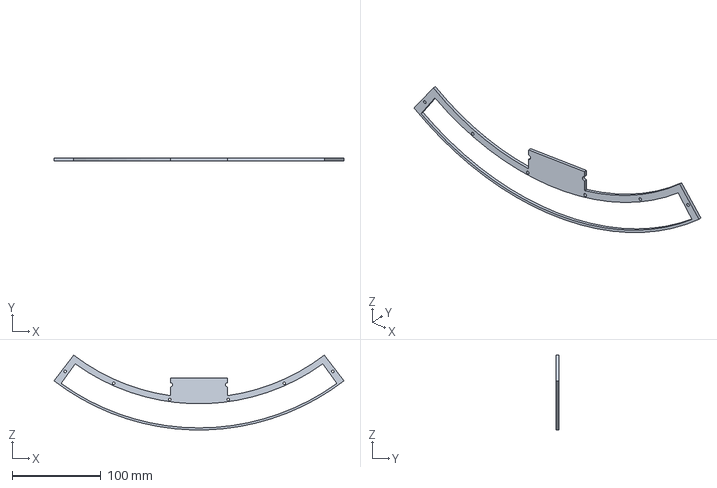
[picture p113: CAD file, 2026-11-07]
mechanical/step/basket-lip-plate.step
326.9 x 3.00 x 84.3 mm
