OpenSourceAppliances/dryer/mechanical/drawings/rear-lower-panel.dxf

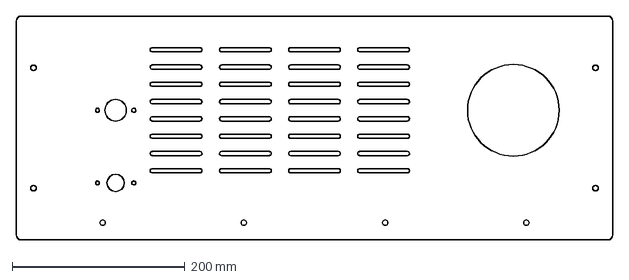
[picture p114: CAD file, 2026-11-07]
mechanical/drawings/rear-lower-panel.dxf
690.0 x 259.0 mm
