OpenSourceAppliances/dryer/mechanical/step/power-module-plate.step

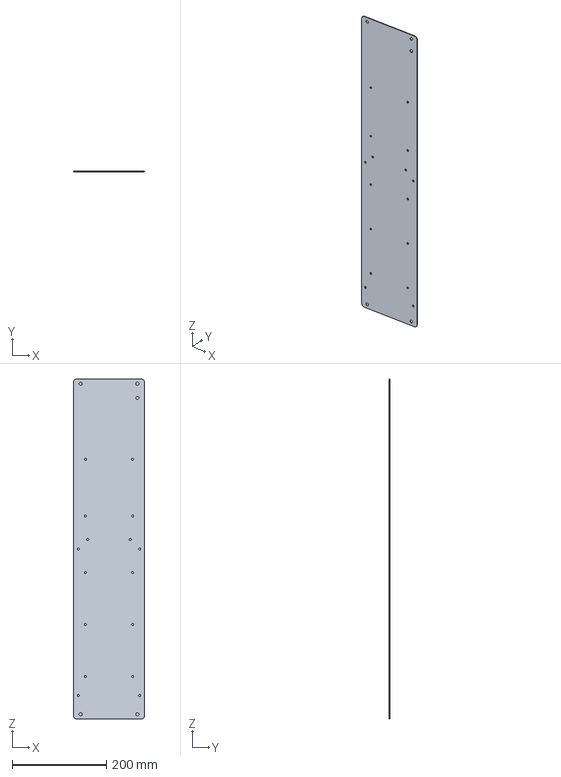
[picture p115: CAD file, 2026-11-07]
mechanical/step/power-module-plate.step
150.0 x 1.50 x 720.0 mm
