OpenSourceAppliances/dryer/mechanical/drawings/felt-seal-long.dxf

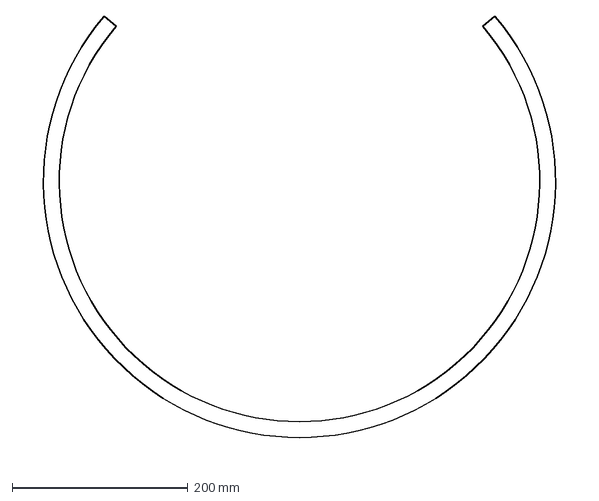
[picture p116: CAD file, 2026-11-07]
mechanical/drawings/felt-seal-long.dxf
643.8 x 505.5 mm
