OpenSourceAppliances/dryer/mechanical/step/felt-seal-rear-long.step

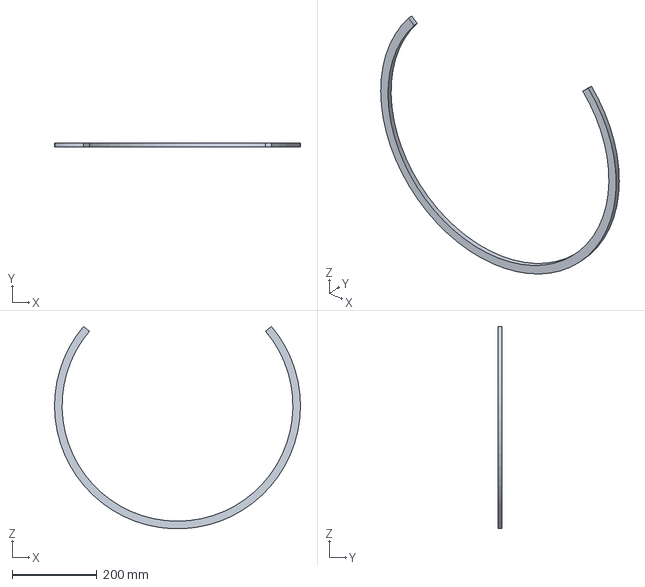
[picture p117: CAD file, 2026-11-07]
mechanical/step/felt-seal-rear-long.step
582.0 x 10.0 x 478.6 mm
