OpenSourceAppliances/dryer/mechanical/drawings/base-pan.dxf

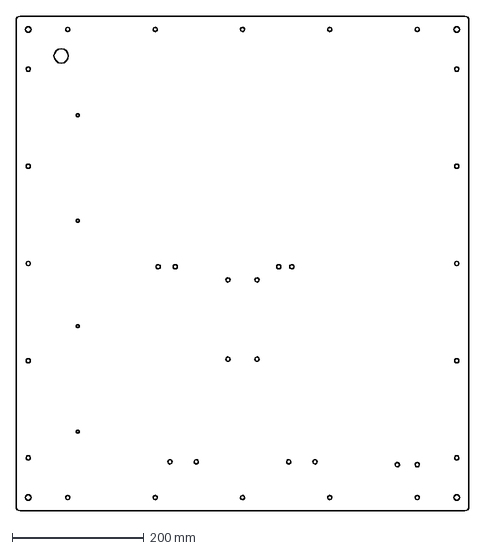
[picture p118: CAD file, 2026-11-07]
mechanical/drawings/base-pan.dxf
687.0 x 750.0 mm
