OpenSourceAppliances/dryer/mechanical/step/basket-lip-clamp.step

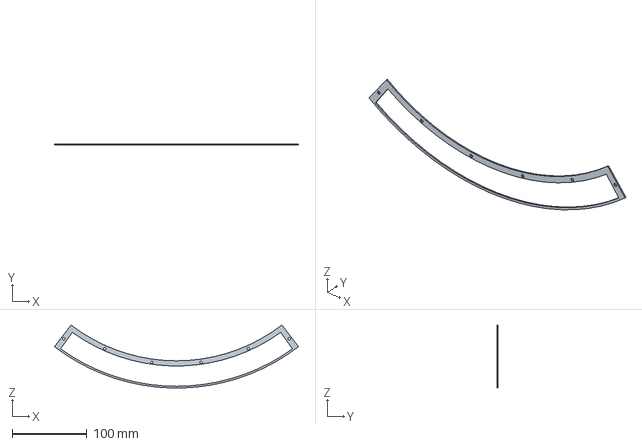
[picture p119: CAD file, 2026-11-07]
mechanical/step/basket-lip-clamp.step
326.9 x 1.50 x 84.3 mm
