OpenSourceAppliances/dryer/mechanical/drawings/power-module-barrier.dxf

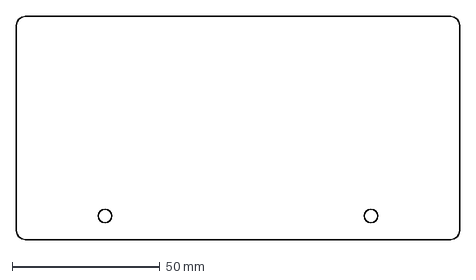
[picture p120: CAD file, 2026-11-07]
mechanical/drawings/power-module-barrier.dxf
150.0 x 75.5 mm
