OpenSourceAppliances/dryer/mechanical/step/front-bulkhead.step

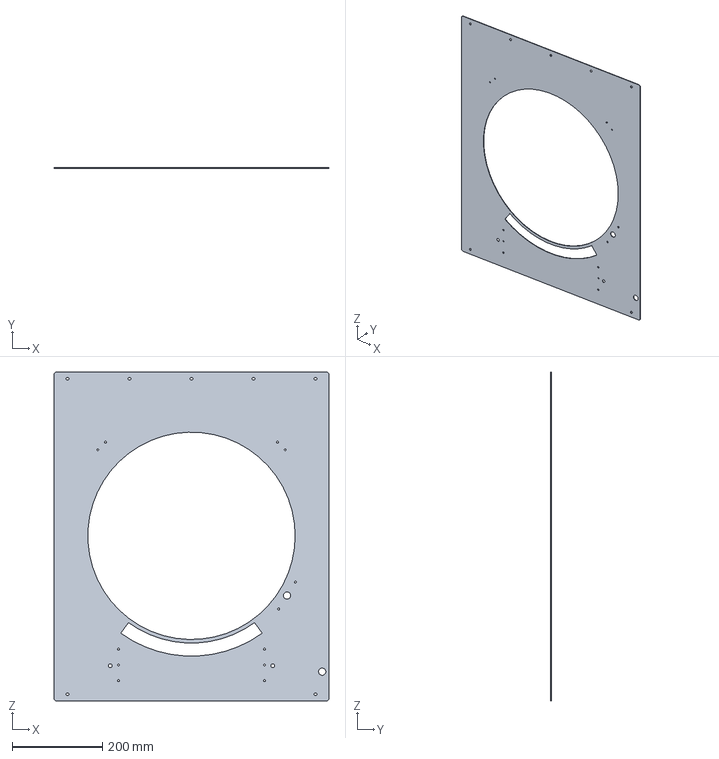
[picture p121: CAD file, 2026-11-07]
mechanical/step/front-bulkhead.step
610.0 x 1.50 x 730.0 mm
