OpenSourceAppliances/dryer/mechanical/drawings/entry-blank.dxf

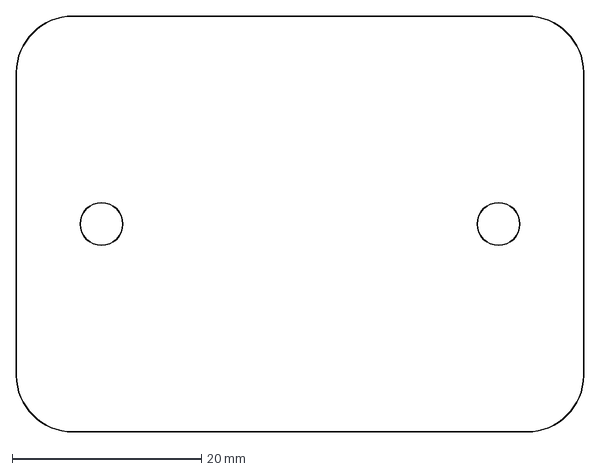
[picture p122: CAD file, 2026-11-07]
mechanical/drawings/entry-blank.dxf
60.0 x 44.0 mm
