OpenSourceAppliances/dryer/mechanical/step/lint-box-back.step

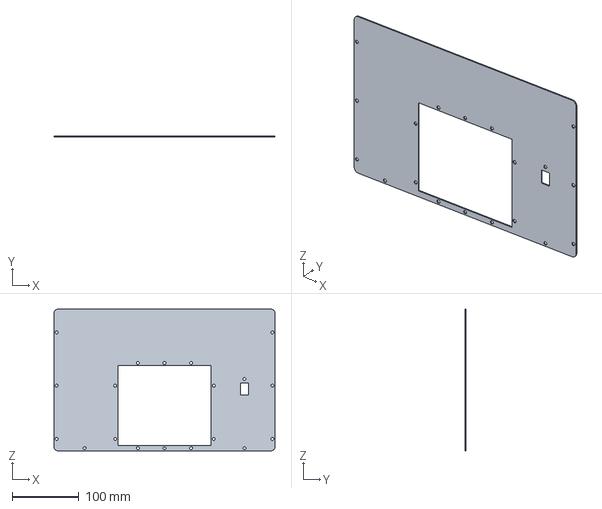
[picture p123: CAD file, 2026-11-07]
mechanical/step/lint-box-back.step
332.0 x 1.50 x 213.0 mm
