OpenSourceAppliances/dryer/mechanical/drawings/lint-box-back.dxf

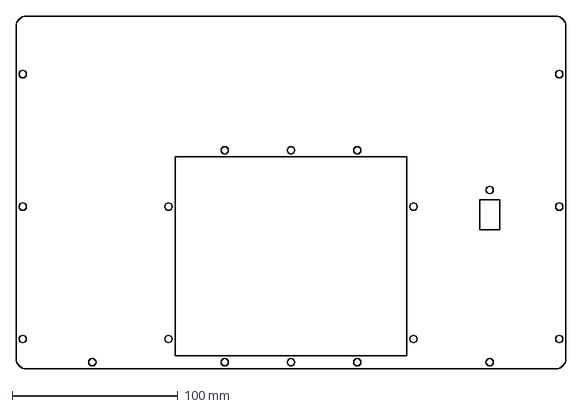
[picture p124: CAD file, 2026-11-07]
mechanical/drawings/lint-box-back.dxf
332.0 x 213.0 mm
