OpenSourceAppliances/dryer/mechanical/step/rear-bulkhead.step

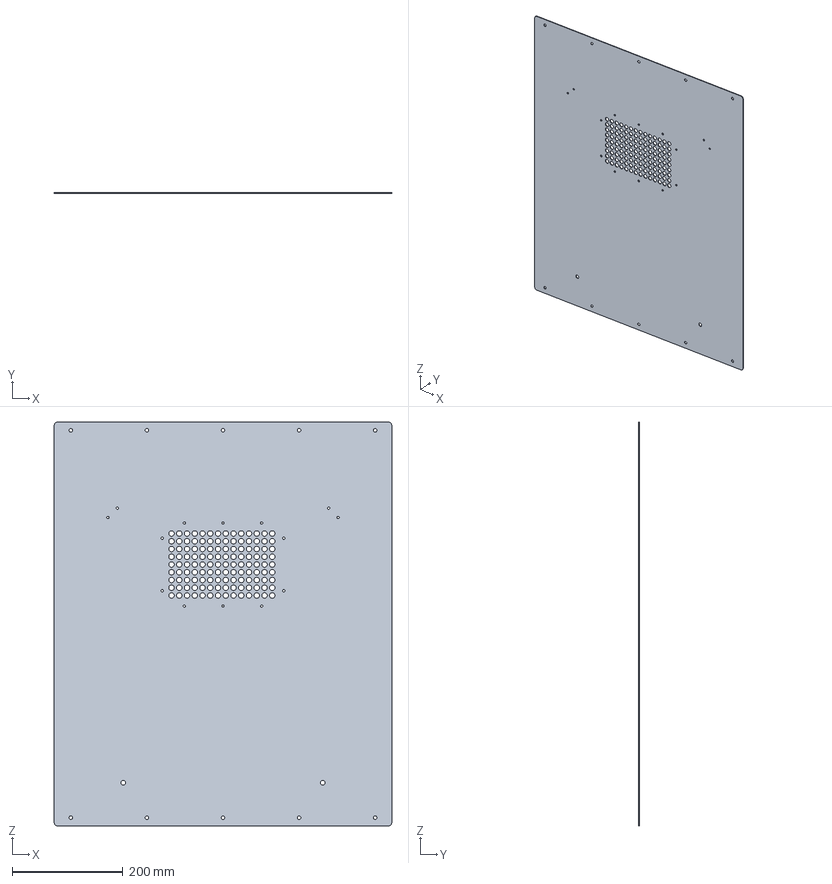
[picture p125: CAD file, 2026-11-07]
mechanical/step/rear-bulkhead.step
610.0 x 1.50 x 730.0 mm
