OpenSourceAppliances/dryer/mechanical/drawings/front-bulkhead.dxf

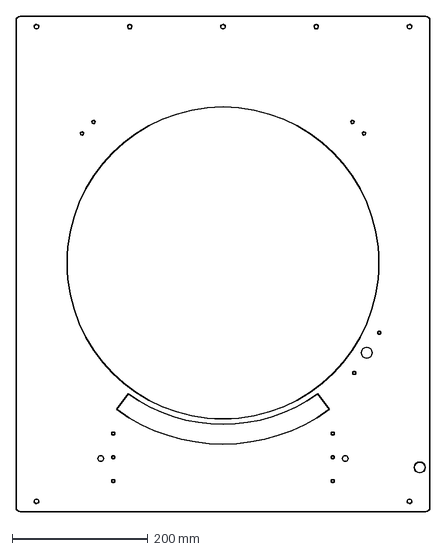
[picture p126: CAD file, 2026-11-07]
mechanical/drawings/front-bulkhead.dxf
610.0 x 730.0 mm
