OpenSourceAppliances/dryer/mechanical/step/base-pan.step

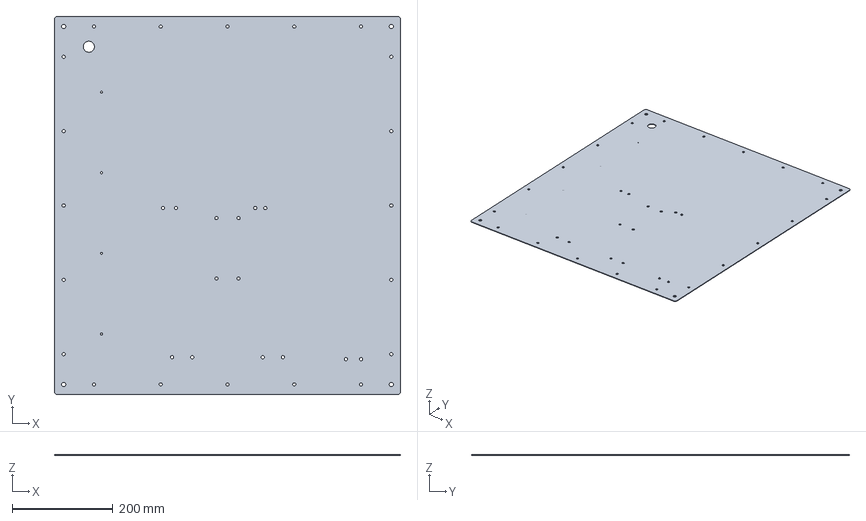
[picture p127: CAD file, 2026-11-07]
mechanical/step/base-pan.step
687.0 x 750.0 x 1.50 mm
