OpenSourceAppliances/dryer/mechanical/drawings/front-upper-panel.dxf

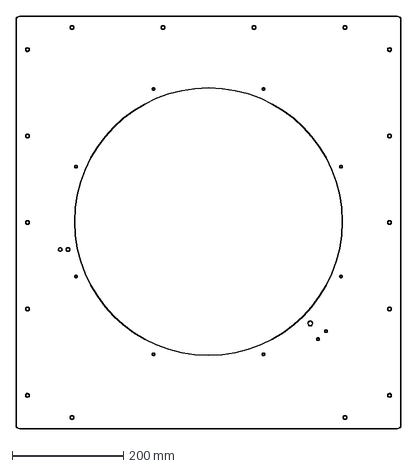
[picture p128: CAD file, 2026-11-07]
mechanical/drawings/front-upper-panel.dxf
690.0 x 740.0 mm
