OpenSourceAppliances/dryer/mechanical/step/drum-sheet.step

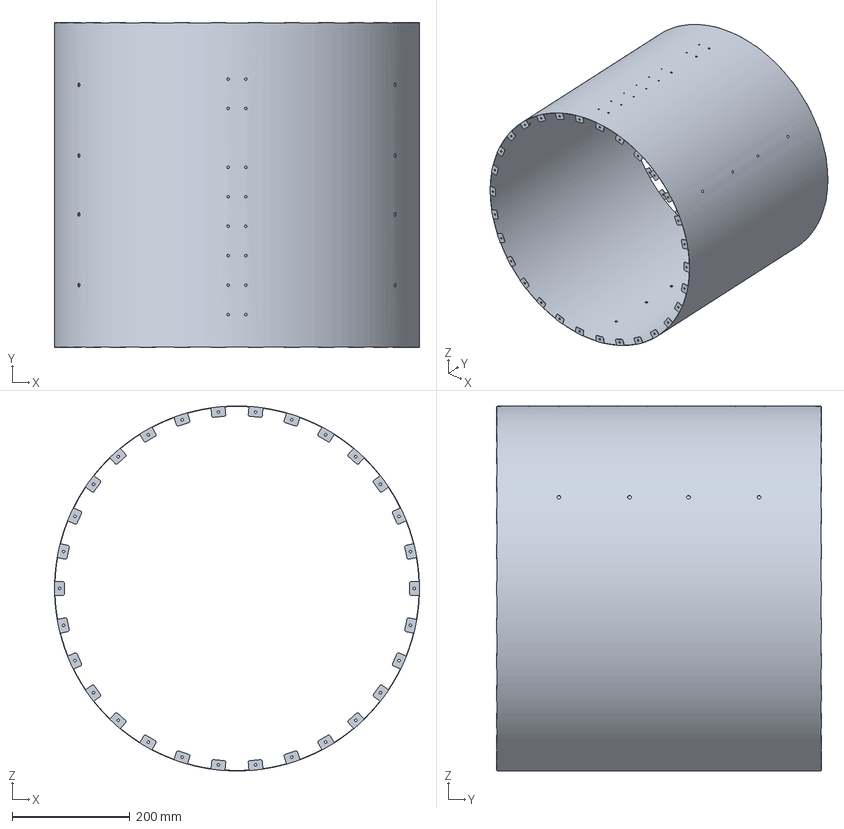
[picture p129: CAD file, 2026-11-07]
mechanical/step/drum-sheet.step
620.0 x 551.6 x 619.9 mm
