OpenSourceAppliances/dryer/mechanical/drawings/hood-bottom.dxf

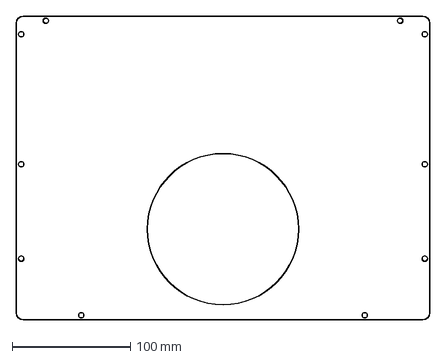
[picture p130: CAD file, 2026-11-07]
mechanical/drawings/hood-bottom.dxf
350.0 x 257.5 mm
