OpenSourceAppliances/dryer/mechanical/drawings/drum-sheet.dxf

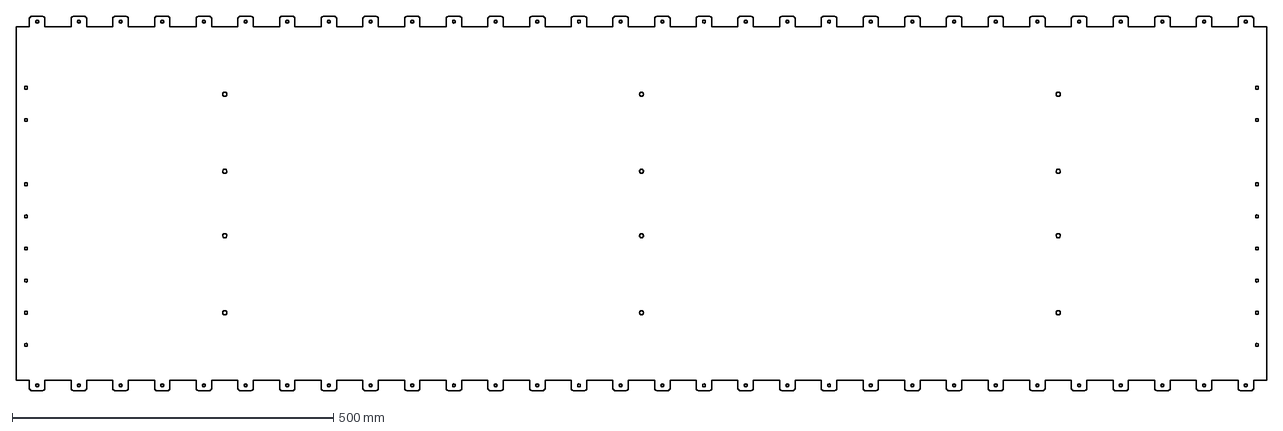
[picture p131: CAD file, 2026-11-07]
mechanical/drawings/drum-sheet.dxf
1945.3 x 582.0 mm
