OpenSourceAppliances/dryer/mechanical/step/console-rail-left.step

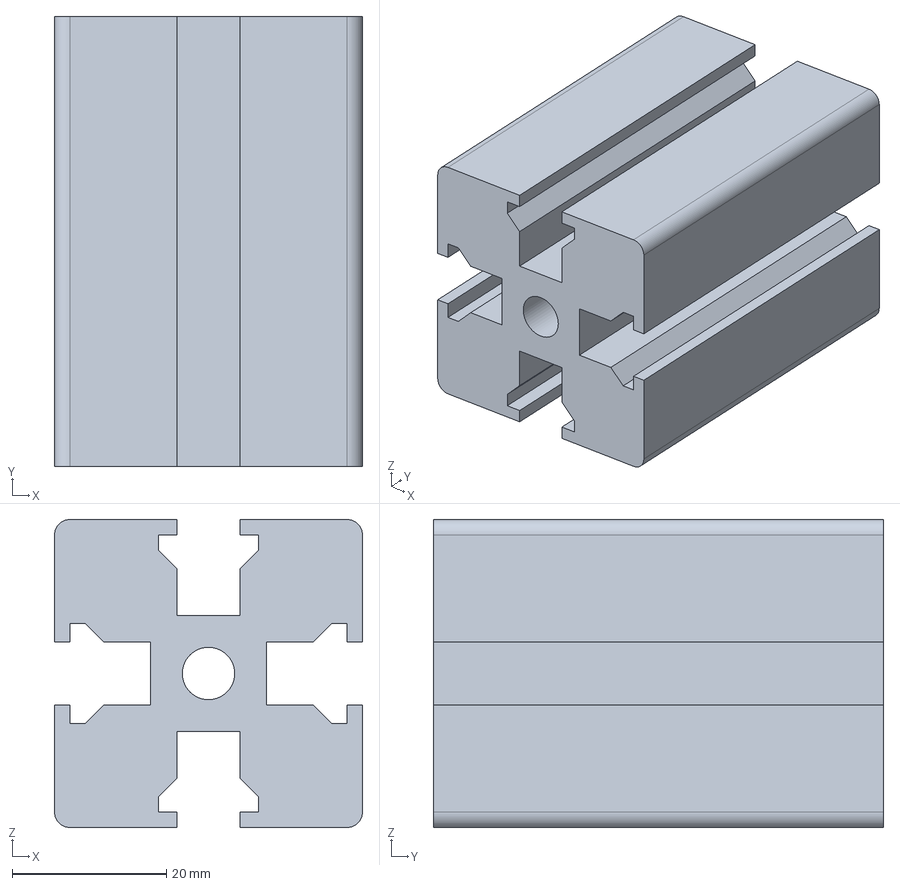
[picture p132: CAD file, 2026-11-07]
mechanical/step/console-rail-left.step
40.0 x 58.5 x 40.0 mm
