OpenSourceAppliances/dryer/mechanical/drawings/trunk-rear.dxf

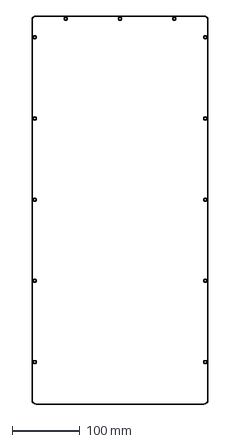
[picture p133: CAD file, 2026-11-07]
mechanical/drawings/trunk-rear.dxf
260.0 x 573.5 mm
