OpenSourceAppliances/dryer/mechanical/drawings/liner.dxf

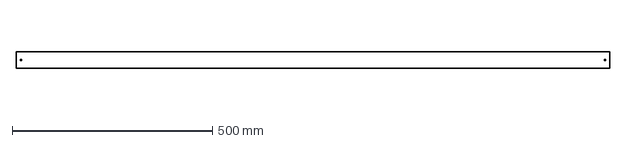
[picture p134: CAD file, 2026-11-07]
mechanical/drawings/liner.dxf
1482.4 x 41.3 mm
