OpenSourceAppliances/dryer/mechanical/step/console-post-2.step

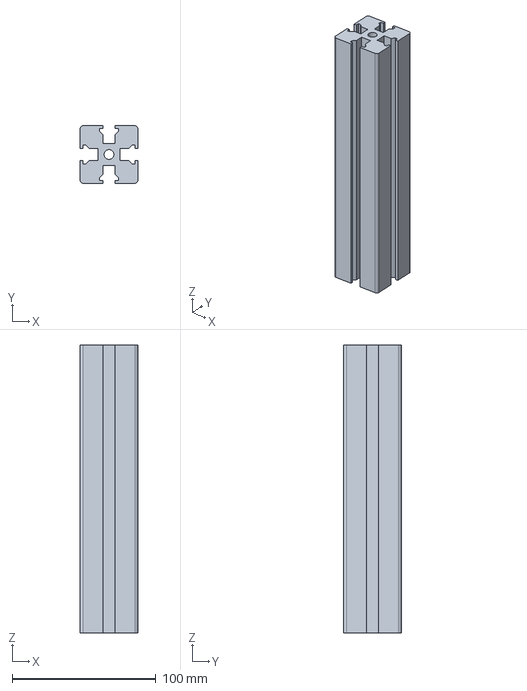
[picture p135: CAD file, 2026-11-07]
mechanical/step/console-post-2.step
40.0 x 40.0 x 200.0 mm
