OpenSourceAppliances/dryer/mechanical/drawings/hood-top.dxf

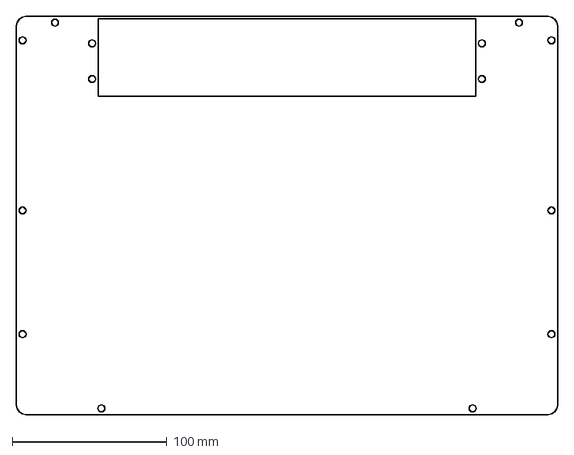
[picture p136: CAD file, 2026-11-07]
mechanical/drawings/hood-top.dxf
350.0 x 257.5 mm
