OpenSourceAppliances/dryer/mechanical/drawings/lint-box-front.dxf

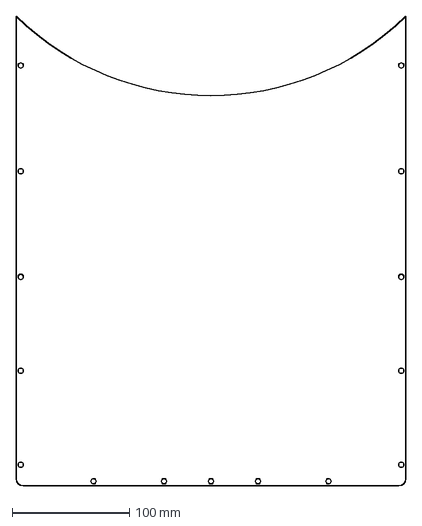
[picture p137: CAD file, 2026-11-07]
mechanical/drawings/lint-box-front.dxf
332.0 x 400.1 mm
