OpenSourceAppliances/dryer/mechanical/drawings/basket-far-clamp.dxf

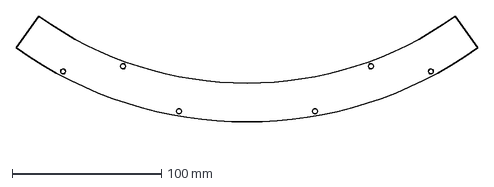
[picture p138: CAD file, 2026-11-07]
mechanical/drawings/basket-far-clamp.dxf
309.1 x 87.3 mm
