OpenSourceAppliances/dryer/mechanical/drawings/heat-module-top.dxf

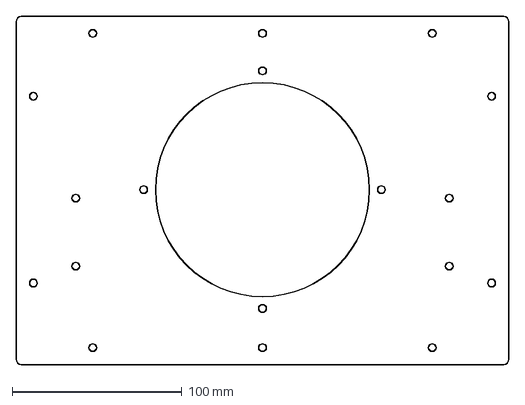
[picture p139: CAD file, 2026-11-07]
mechanical/drawings/heat-module-top.dxf
290.0 x 205.0 mm
