OpenSourceAppliances/dryer/mechanical/step/heat-module-wall-left.step

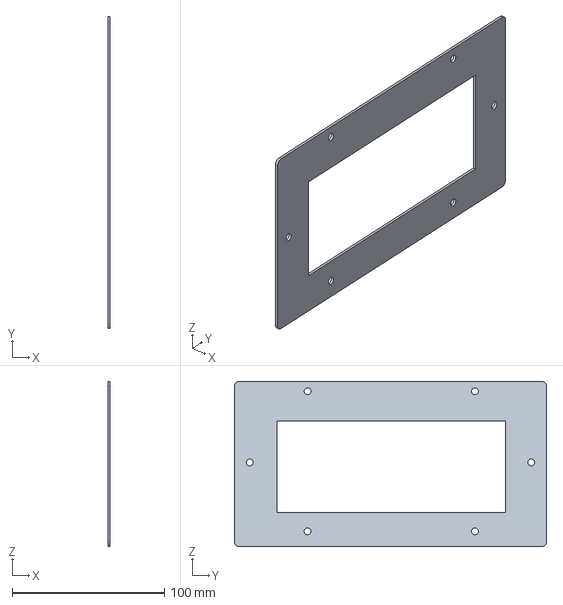
[picture p140: CAD file, 2026-11-07]
mechanical/step/heat-module-wall-left.step
1.50 x 205.0 x 108.5 mm
