OpenSourceAppliances/dryer/mechanical/drawings/heat-module-terminal-plate.dxf

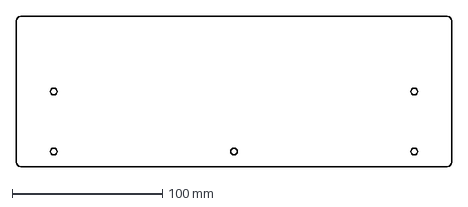
[picture p141: CAD file, 2026-11-07]
mechanical/drawings/heat-module-terminal-plate.dxf
290.0 x 100.0 mm
