OpenSourceAppliances/dryer/mechanical/drawings/console-face.dxf

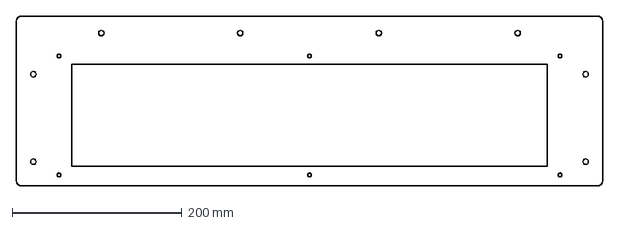
[picture p142: CAD file, 2026-11-07]
mechanical/drawings/console-face.dxf
690.0 x 200.0 mm
