OpenSourceAppliances/dryer/mechanical/step/felt-seal-front-long.step

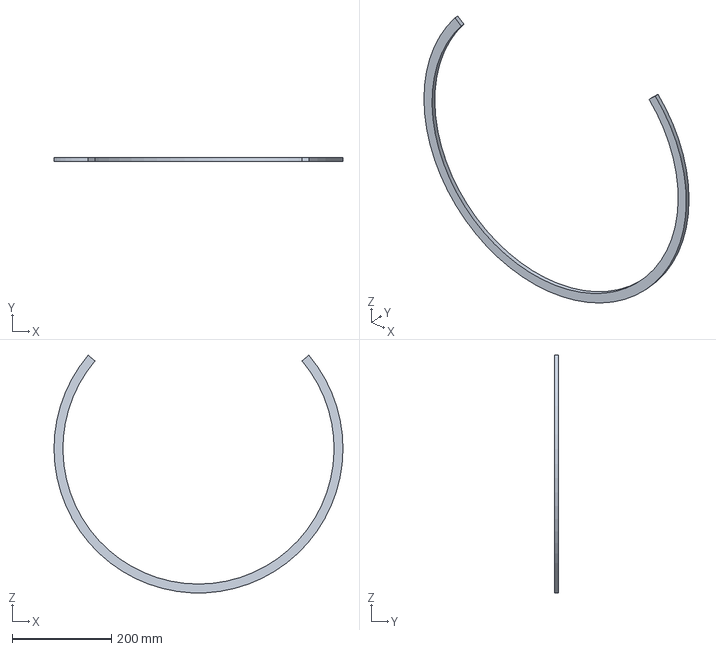
[picture p143: CAD file, 2026-11-07]
mechanical/step/felt-seal-front-long.step
582.0 x 8.00 x 478.6 mm
