OpenSourceAppliances/dryer/mechanical/drawings/felt-seal-short.dxf

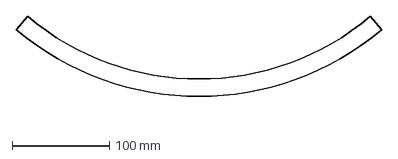
[picture p144: CAD file, 2026-11-07]
mechanical/drawings/felt-seal-short.dxf
375.9 x 105.5 mm
