OpenSourceAppliances/dryer/mechanical/drawings/rear-bulkhead.dxf

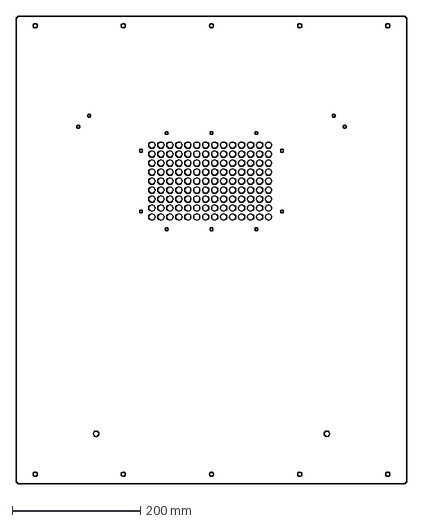
[picture p145: CAD file, 2026-11-07]
mechanical/drawings/rear-bulkhead.dxf
610.0 x 730.0 mm
