OpenSourceAppliances/dryer/mechanical/step/bay-ceiling.step

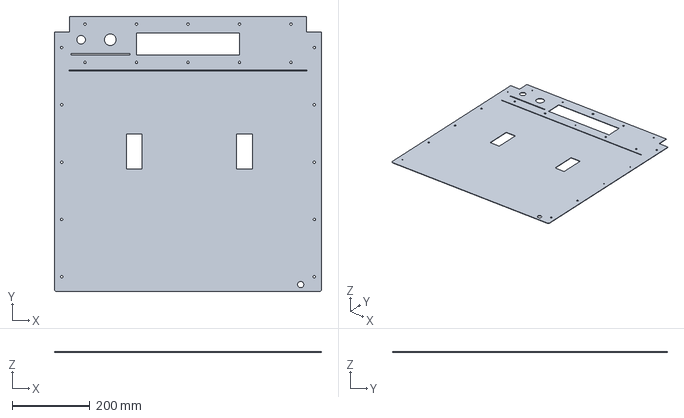
[picture p146: CAD file, 2026-11-07]
mechanical/step/bay-ceiling.step
687.0 x 708.0 x 1.50 mm
