OpenSourceAppliances/dryer/mechanical/drawings/basket-far-plate.dxf

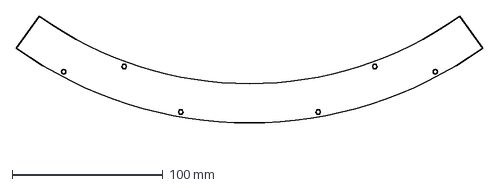
[picture p147: CAD file, 2026-11-07]
mechanical/drawings/basket-far-plate.dxf
309.1 x 87.3 mm
