OpenSourceAppliances/dryer/mechanical/step/tier0-faceplate.step

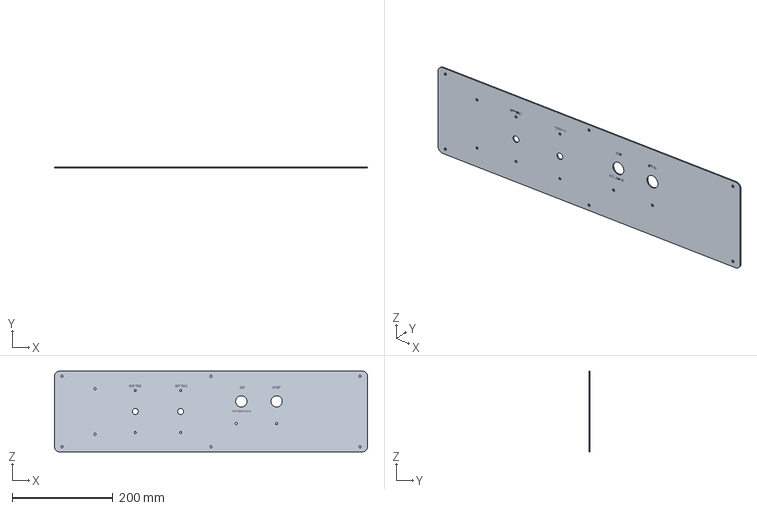
[picture p148: CAD file, 2026-11-07]
mechanical/step/tier0-faceplate.step
620.0 x 2.00 x 160.0 mm
