OpenSourceAppliances/dryer/mechanical/drawings/drum-ring.dxf

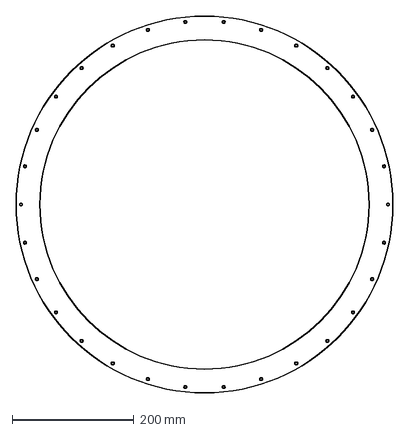
[picture p149: CAD file, 2026-11-07]
mechanical/drawings/drum-ring.dxf
618.4 x 618.4 mm
