OpenSourceAppliances/dryer/mechanical/drawings/console-rear.dxf

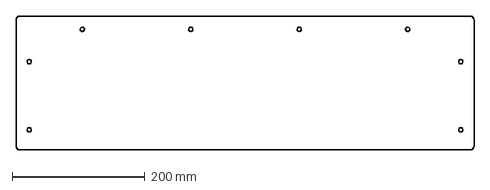
[picture p150: CAD file, 2026-11-07]
mechanical/drawings/console-rear.dxf
690.0 x 201.5 mm
