OpenSourceAppliances/dryer/mechanical/step/front-upper-panel.step

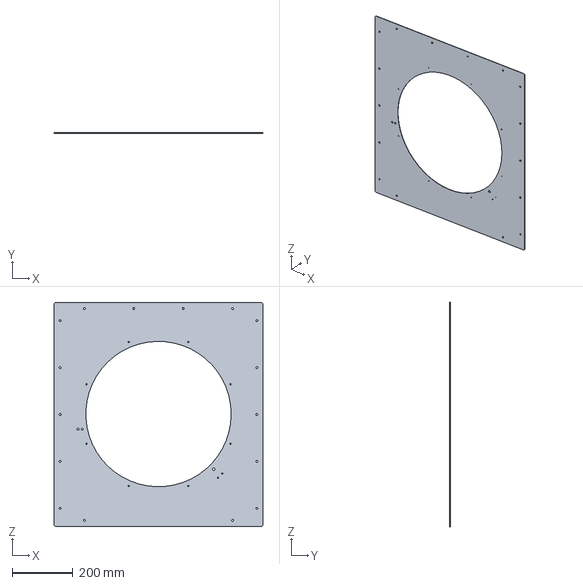
[picture p151: CAD file, 2026-11-07]
mechanical/step/front-upper-panel.step
690.0 x 1.50 x 740.0 mm
