OpenSourceAppliances/dryer/mechanical/drawings/basket-lip-clamp.dxf

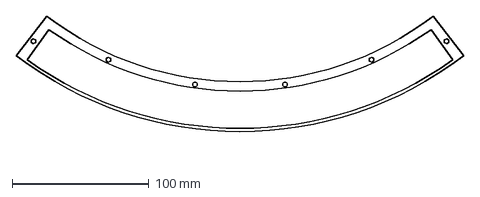
[picture p152: CAD file, 2026-11-07]
mechanical/drawings/basket-lip-clamp.dxf
326.9 x 102.9 mm
