OpenSourceAppliances/dryer/mechanical/step/drum-splice.step

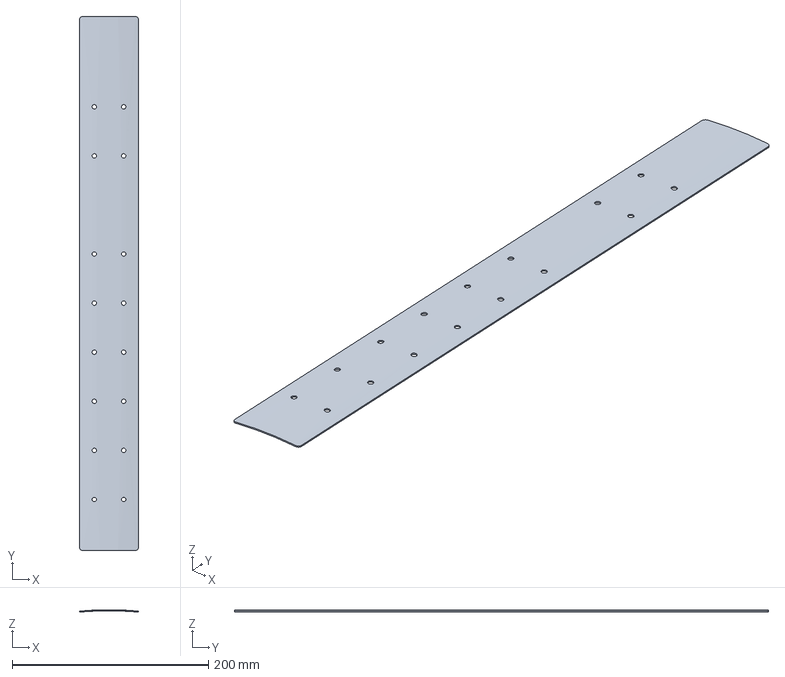
[picture p153: CAD file, 2026-11-07]
mechanical/step/drum-splice.step
59.9 x 544.0 x 2.33 mm
