OpenSourceAppliances/dryer/mechanical/drawings/tier0-faceplate.dxf

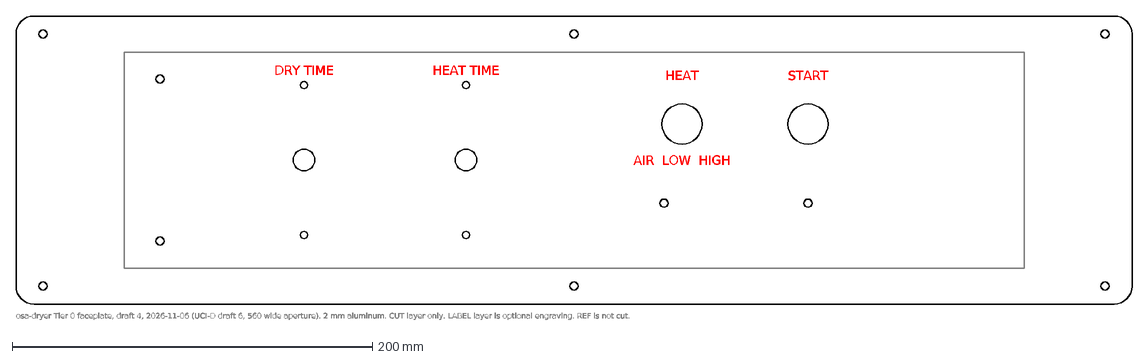
[picture p154: CAD file, 2026-11-07]
mechanical/drawings/tier0-faceplate.dxf
DRY TIME
HEAT TIME
HEAT
START
AIR LOW HIGH
osa-dryer Tier 0 faceplate, draft 4, 2026-11-06 (UCI-D draft 6, 560 wide aperture). 2 mm aluminum. CUT layer only. LABEL layer is optional engraving. REF is not
