OpenSourceAppliances/dryer/mechanical/step/rail-mid-front-left.step

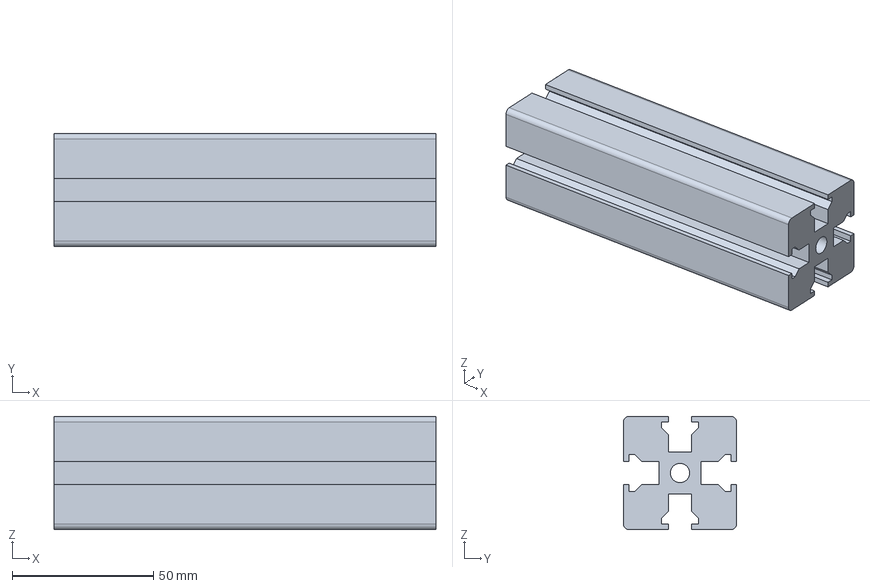
[picture p155: CAD file, 2026-11-07]
mechanical/step/rail-mid-front-left.step
135.0 x 40.0 x 40.0 mm
