OpenSourceAppliances/dryer/mechanical/drawings/felt-seal.dxf

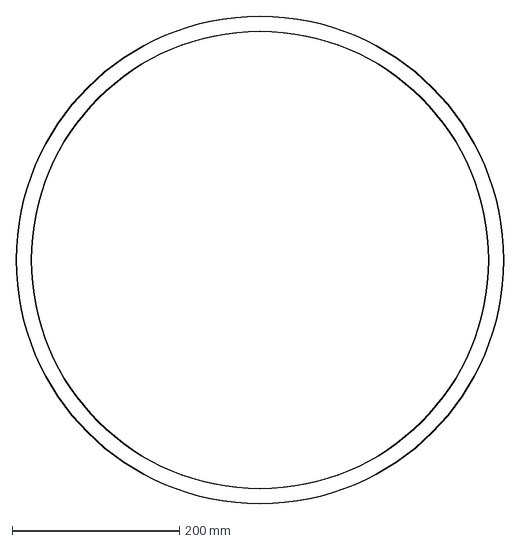
[picture p156: CAD file, 2026-11-06]
mechanical/drawings/felt-seal.dxf
582.0 x 582.0 mm
