OpenSourceAppliances/dryer/mechanical/step/hood-top.step

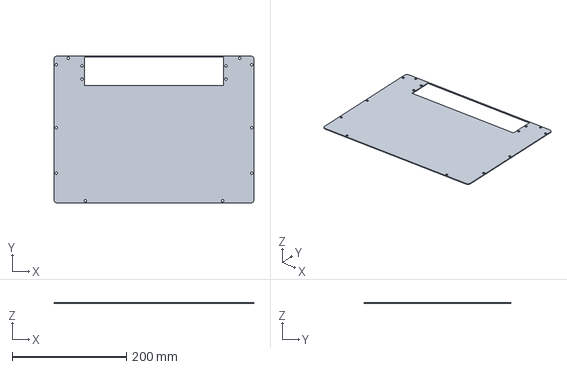
[picture p157: CAD file, 2026-11-07]
mechanical/step/hood-top.step
350.0 x 257.5 x 1.50 mm
