OpenSourceAppliances/dryer/mechanical/drawings/felt-seal-rear.dxf

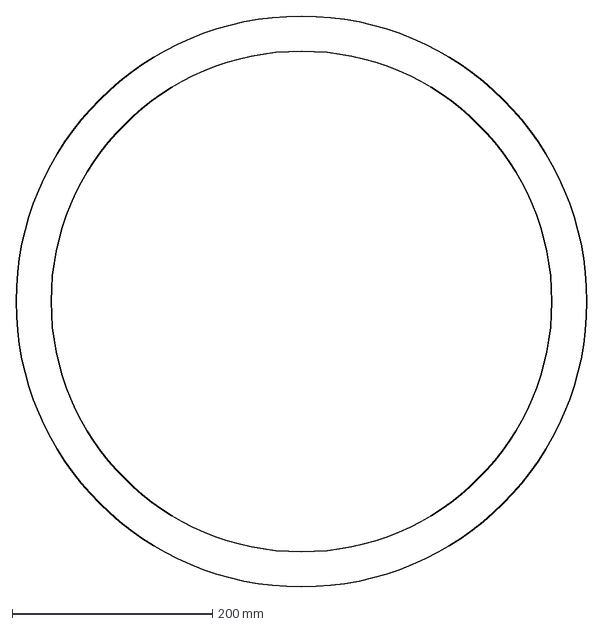
[picture p158: CAD file, 2026-11-06]
mechanical/drawings/felt-seal-rear.dxf
570.0 x 570.0 mm
