OpenSourceAppliances/dryer/mechanical/step/power-module-cover.step

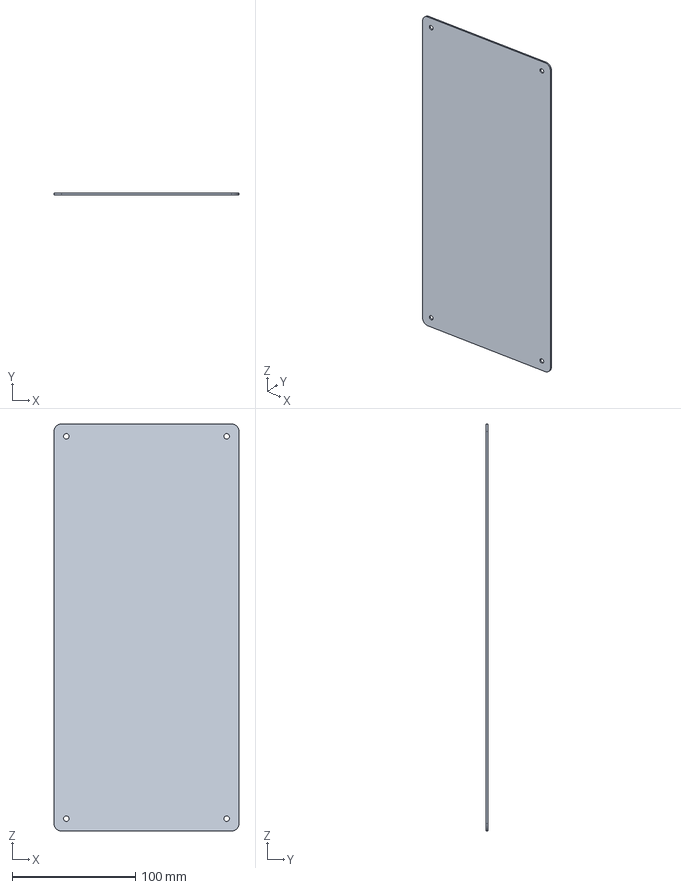
[picture p159: CAD file, 2026-11-07]
mechanical/step/power-module-cover.step
150.0 x 1.50 x 330.0 mm
