OpenSourceAppliances/dryer/mechanical/step/heat-module-terminal-plate.step

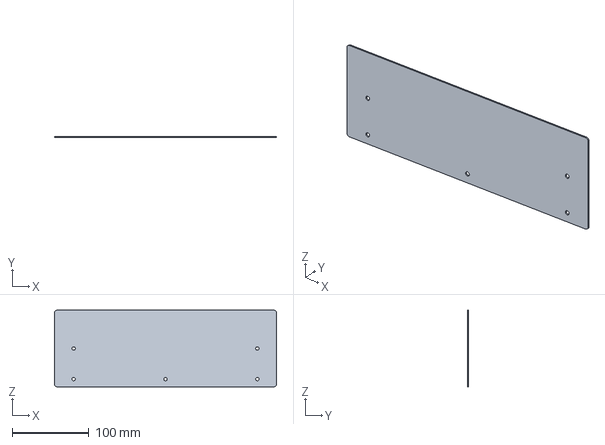
[picture p160: CAD file, 2026-11-07]
mechanical/step/heat-module-terminal-plate.step
290.0 x 1.50 x 100.0 mm
