OpenSourceAppliances/dryer/mechanical/step/felt-seal-front-short.step

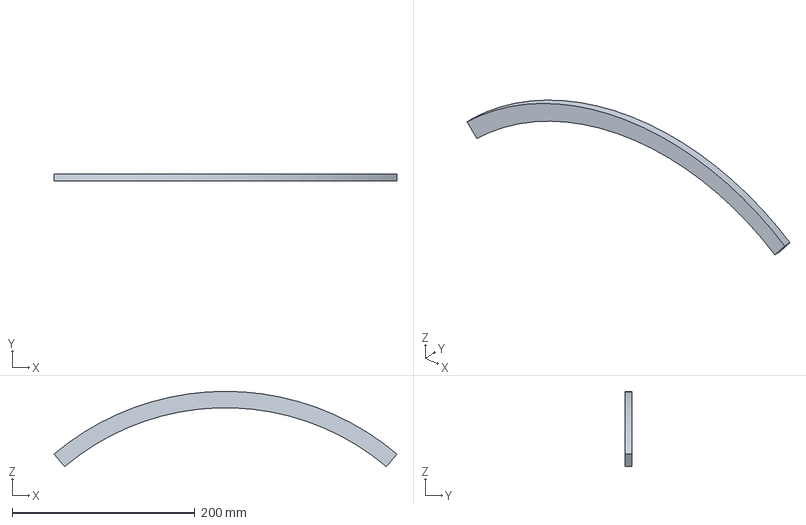
[picture p161: CAD file, 2026-11-07]
mechanical/step/felt-seal-front-short.step
375.9 x 8.00 x 82.6 mm
