OpenSourceAppliances/dryer/mechanical/step/side-panel-right.step

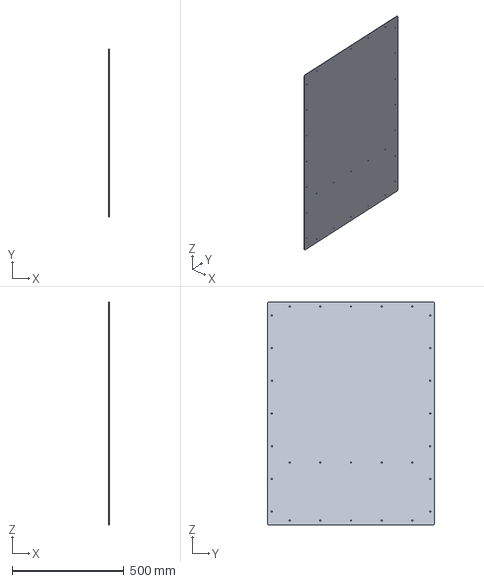
[picture p163: CAD file, 2026-11-07]
mechanical/step/side-panel-right.step
1.50 x 750.0 x 1000.0 mm
