OpenSourceAppliances/dryer/mechanical/step/lint-box-front.step

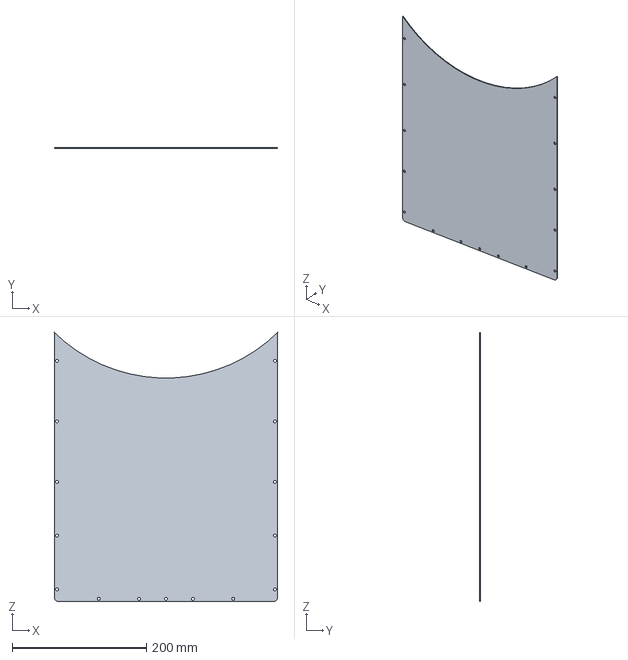
[picture p164: CAD file, 2026-11-07]
mechanical/step/lint-box-front.step
332.0 x 1.50 x 400.1 mm
