OpenSourceAppliances/dryer/mechanical/step/trunk-rear.step

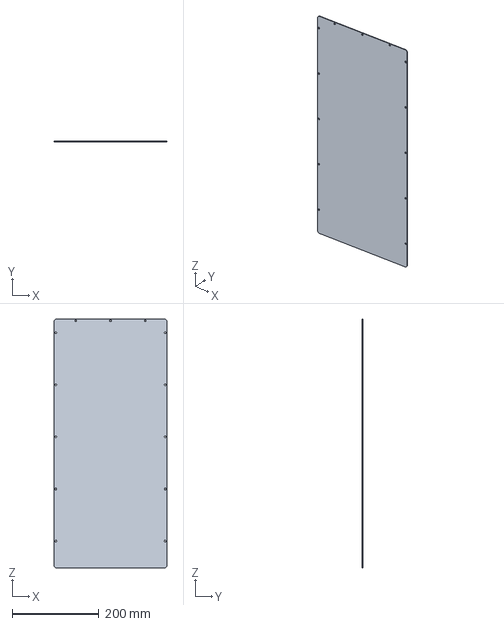
[picture p165: CAD file, 2026-11-07]
mechanical/step/trunk-rear.step
260.0 x 1.50 x 573.5 mm
