OpenSourceAppliances/dryer/mechanical/step/console-cap.step

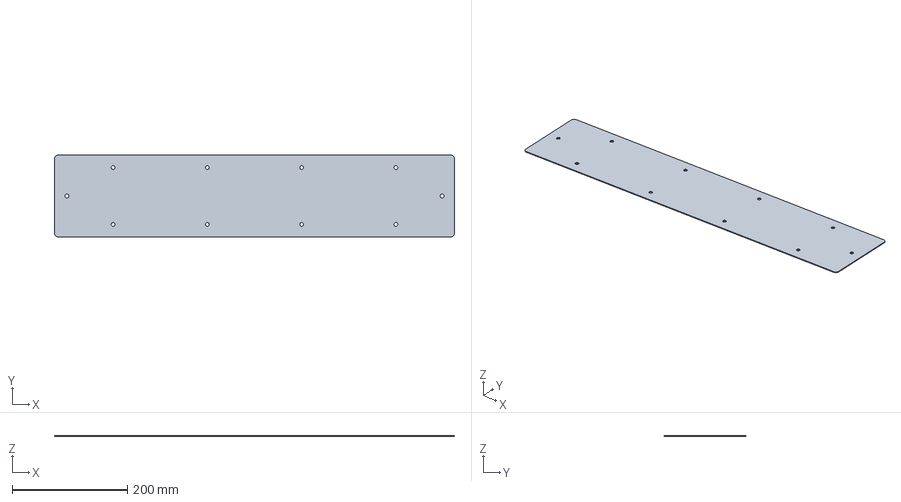
[picture p166: CAD file, 2026-11-07]
mechanical/step/console-cap.step
693.0 x 141.5 x 1.50 mm
