OpenSourceAppliances/dryer/mechanical/step/liner.step

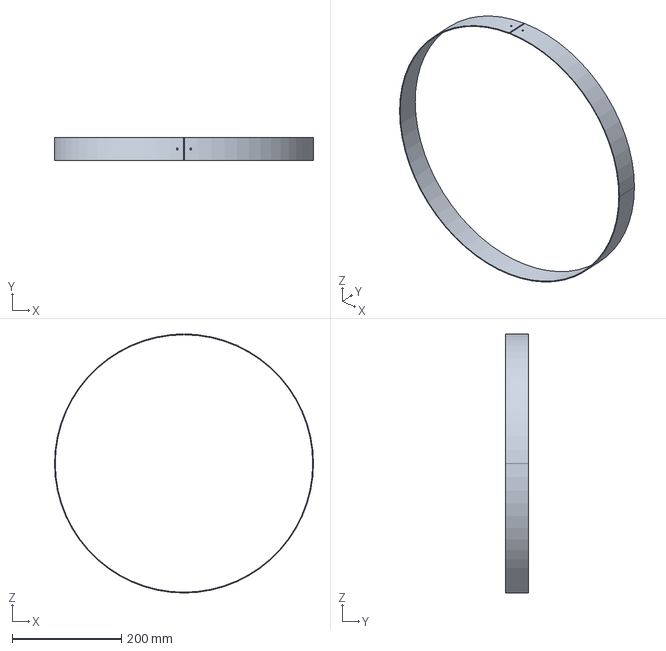
[picture p167: CAD file, 2026-11-07]
mechanical/step/liner.step
474.0 x 41.3 x 474.0 mm
