OpenSourceAppliances/dryer/mechanical/step/power-module-barrier.step

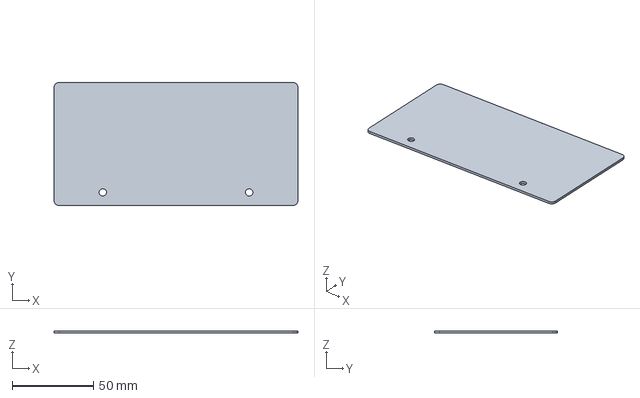
[picture p168: CAD file, 2026-11-07]
mechanical/step/power-module-barrier.step
150.0 x 75.5 x 1.50 mm
