OpenSourceAppliances/dryer/mechanical/step/felt-seal-rear-short.step

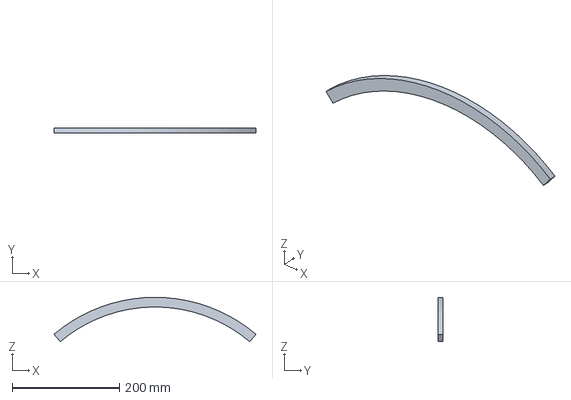
[picture p169: CAD file, 2026-11-07]
mechanical/step/felt-seal-rear-short.step
375.9 x 10.0 x 82.6 mm
