OpenSourceAppliances/dryer/mechanical/step/heat-module-tray.step

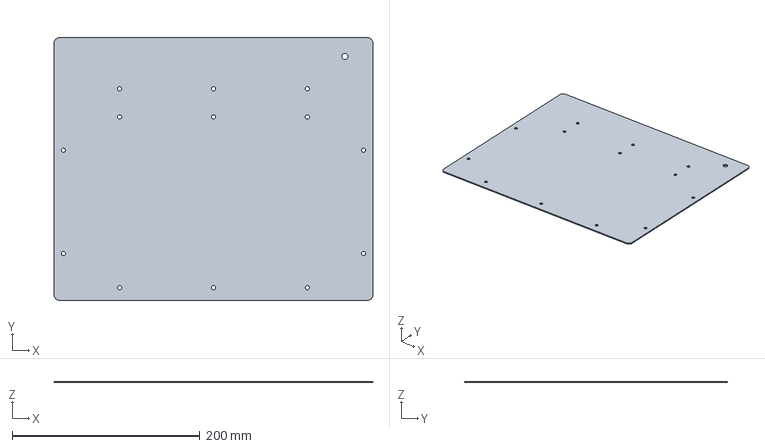
[picture p170: CAD file, 2026-11-07]
mechanical/step/heat-module-tray.step
340.0 x 280.0 x 1.50 mm
