OpenSourceAppliances/dryer/mechanical/step/trunk-front.step

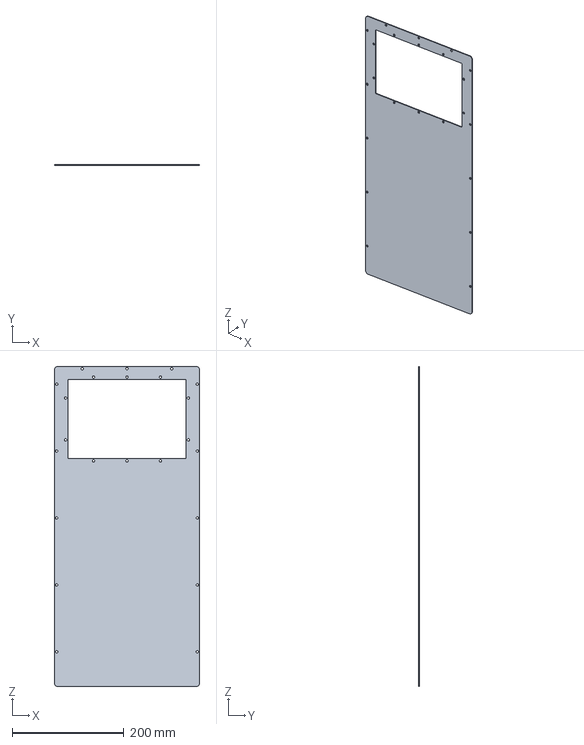
[picture p171: CAD file, 2026-11-07]
mechanical/step/trunk-front.step
260.0 x 1.50 x 573.5 mm
