OpenSourceAppliances/dryer/mechanical/step/blower-plate.step

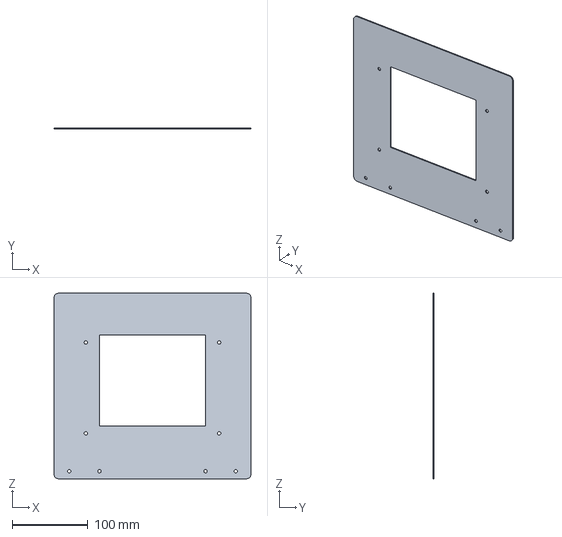
[picture p172: CAD file, 2026-11-07]
mechanical/step/blower-plate.step
260.0 x 1.50 x 245.0 mm
