OpenSourceAppliances/dryer/mechanical/step/door-disc.step

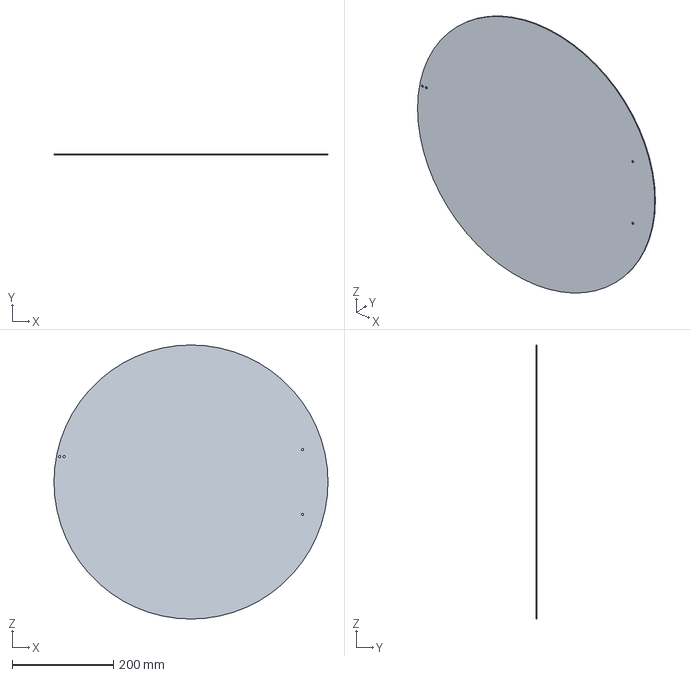
[picture p173: CAD file, 2026-11-07]
mechanical/step/door-disc.step
540.0 x 2.00 x 540.0 mm
