OpenSourceAppliances/dryer/mechanical/step/rear-upper-panel.step

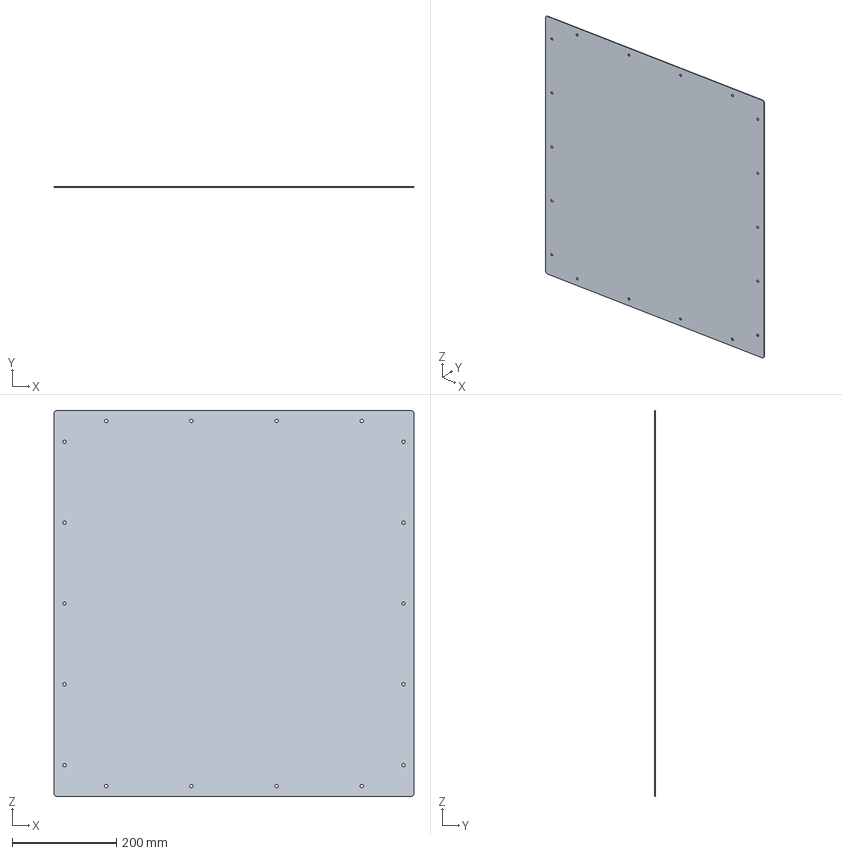
[picture p174: CAD file, 2026-11-07]
mechanical/step/rear-upper-panel.step
690.0 x 1.50 x 740.0 mm
