OpenSourceAppliances/dryer/(list of files, cad)

Other CAD files:
mechanical/step/osa-dryer-assembly.step
mechanical/step/rail-top-right.step
mechanical/step/rail-top-rear.step
mechanical/step/console-rail-front.step
mechanical/step/rail-top-rearcross.step
mechanical/step/post-1.step
mechanical/step/drum-ring-rear.step
mechanical/step/top-panel.step
mechanical/step/rail-bottom-left.step
mechanical/step/console-post-1.step
mechanical/step/rail-bottom-rear.step
mechanical/step/heat-module-wall-front.step
mechanical/step/rail-mid-left.step
mechanical/step/console-rail-right.step
mechanical/step/console-post-3.step
mechanical/step/tray-rail-2.step
mechanical/step/rail-mid-right.step
mechanical/step/console-rail-rear.step
mechanical/step/console-cheek-right.step
mechanical/step/rail-mid-rearcross.step
mechanical/step/post-4.step
mechanical/step/rail-top-front.step
mechanical/step/console-post-4.step
mechanical/step/rail-mid-rear.step
mechanical/step/rail-mid-front-right.step
mechanical/step/rail-top-left.step
mechanical/step/hood-bottom.step
mechanical/step/side-panel-left.step
mechanical/step/post-3.step
mechanical/fusion/osa-dryer-assembly-motion.f3d
mechanical/fusion/osa-dryer-parametric.f3d
