OpenSourceAppliances/dryer/mechanical/cad/audit/fusion-screens/01-assembly-iso.jpg

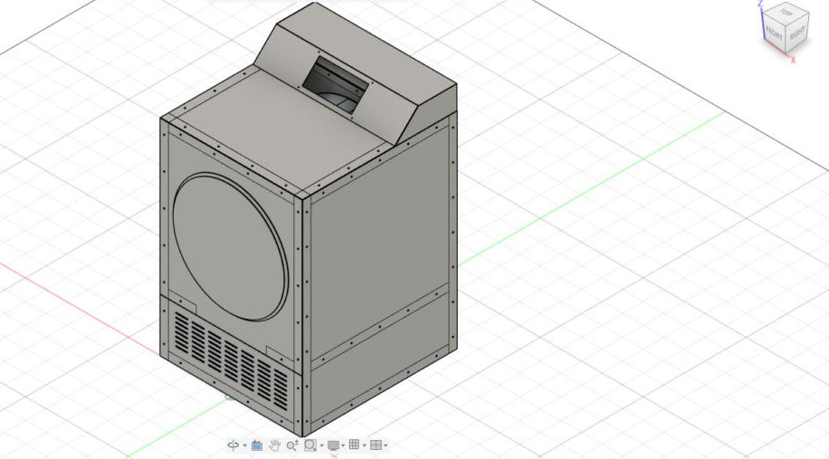
mechanical/cad/audit/fusion-screens/01-assembly-iso.jpg
