OpenSourceAppliances/dryer/mechanical/cad/audit/fusion-screens/08-assembly-iso-front-right.jpg

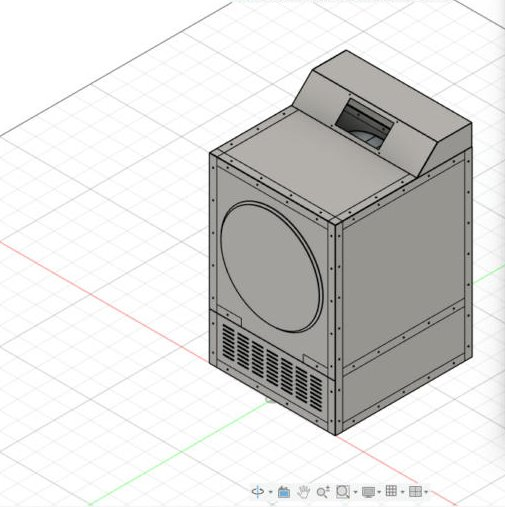
mechanical/cad/audit/fusion-screens/08-assembly-iso-front-right.jpg
