OpenSourceAppliances/dryer/docs/verification.md

# Verification plan

Draft 7, 2026-11-07 (draft 6 2026-11-06, draft 5 2026-11-06, draft 4 2026-11-06, draft 3 2026-11-06, draft 2 2026-11-06, draft 1 2026-11-05). Status: the plan is complete for the electric reference build; every check is open until someone signs it. Draft 7 records the parametric Fusion build in V-014 (every part drawn natively in Fusion compared with the script's files) and V-021 (the motion check rerun on it). Draft 6 records the draft 9 model (the blower plate, the exhaust set, the two chassis sensors, the blanked entries, the cable clamps): V-107 names what the plate waits on, V-112 adds the two sensors' envelopes, V-116 is the moisture bar set against the drum and the basket, V-205 moves the tap to the exhaust pipe, V-010 and V-021 record the runs. Draft 5 records the draft 8 model (the ducts as plates on flat bar frames, the throat liner, the lint basket, the door switch, PS1 and the exhaust thermostats): V-013 measures the new sections, V-018 is the basket, V-023 the liner, V-107, V-111 and V-115 say which measured figure each new envelope waits on. Draft 4 records the draft 7 model (the heat module, the power module plate, the glides, the roller studs, the 20 pulley) and the rule that every bought part is drawn from published figures before the first build, so the parts-in-hand checks say which figure each confirms. Draft 3 records the draft 6 model, which settles the three draft 5 findings (V-015, V-016, V-021 and V-022 now point at the decisions and the drawn result) and reruns V-010, V-013 and V-019. Draft 2 added V-021 (motion check), renumbered the second V-014 to V-022, and recorded the draft 5 model's findings.

The dryer is designed fully on paper, then built once and run once. This document is how that works without a surprise at the end: every number that came from reasoning instead of measurement has a check, every check has a gate, and nothing is cut, bought twice, or powered until the gate before it is closed. The checks are the design's honesty made into a list.

## How to use it

- Each check has an ID. Gate 0 is paper only. Gate 1 is parts in hand. Gate 2 is sub-assemblies on the bench. Gate 3 is the assembled machine without power. Gate 4 is `docs/commissioning.md`. Gate 5 is the test run.
- "Unlocks" says what may happen once the check passes. A DXF whose check is open is not sent to the cutter.
- "Regenerate" means: put the measured number into `mechanical/cad/osa_dryer_cad.py`, run it, and look at the diff of the DXFs and the cut list before ordering anything.
- Sign a check by writing the date, the measured value, and your initials in the Result column, and keep a photo in `builds/<your build>/`.
- A check that fails is not reworded. It gets a `DECISIONS.md` entry and a design change, then it is run again.

## Gate 0: design review, paper only

| ID | Check | Method | Pass when | Unlocks | Result |
| --- | --- | --- | --- | --- | --- |
| V-001 | Every document against the charter | Read `README.md`, `docs/design-rules.md`, `controls/uci-spec.md`, `electrical/wiring/common-power-module.md`, `controls/tier0-mechanical/README.md` against the ten core principles and the electrical rules | No rule broken without a `DECISIONS.md` entry | Gate 1 purchasing | |
| V-002 | One pin table everywhere | Compare J1 and J2 pin numbers and names across the UCI spec, the wiring doc, both ladder SVGs, the Tier 0 wiring SVG, and the commissioning checklist | Identical | Gate 1 purchasing | done 2026-11-05 by the author; repeat after any edit |
| V-003 | Interlock truth table | Walk `ladder-common-power-module.svg` for each of: door open, no airflow, TF2 open, T_HI open, T_LO open, module removed, J1 pins 3, 4, 5 shorted together, J1 pin 11 shorted to pin 9, heat module absent | In every row the heat module cannot be energized unless door closed and airflow proven and limits closed and a request present; the motor cannot run with the door open | V-201 | |
| V-004 | Contactor and relay ratings | Datasheets of HE-K_HEAT, CPM-K_MOTOR, CPM-RLY: AC-1 at 240 V for the element current, AC-3 or hp at 120 V for the motor FLA and LRA, DC coil suppression present or a diode added on the ladder | Every rating has margin over the load; suppression accounted for | Purchasing those lines | |
| V-005 | 24 V budget | Module 1.0 A + K_MOTOR coil + K_HEAT coil + three interface relay coils + three PTC lines against the PSU rating; PSU inrush against F1 | Total under 2.5 A with margin; F1 holds the inrush per the PSU sheet | Purchasing CPM-PSU, CPM-F1 | |
| V-006 | CB1 against the motor start | Motor LRA from its sheet against the C-curve trip band of CB1 | LRA inside the no-trip region for the start duration | Purchasing CPM-CB1 | |
| V-007 | Wire gauges | Each wire-list gauge against its current and against the breaker ahead of it (30 A branch for the element path, CB1 for the 120 V side) | No wire smaller than its protection allows | Buying wire | |
| V-008 | Heater-box limits against element current | Datasheets of HE-TF1 and HE-T_HL | Rated at or above the element current at 240 V; otherwise move the under-rated one to the coil circuit and log it | Purchasing HE lines | |
| V-009 | Thermostat settings against the fault rule | L-ratings of CPM-T_HI and CPM-T_LO against the 40 °C threshold in UCI 8.4 and the 60 to 70 °C exhaust target | Closing temperatures above 40 °C; opening temperatures inside the target | Purchasing thermostats | |
| V-010 | CAD interference and dimensional audit | Run `osa_dryer_cad.py --check` (pairwise overlap of every solid), then `cad_audit.py` on the written files: every STEP re-read and measured (solids, validity, closed shells, bounding box, volume, every cylindrical surface and every planar face), every flat part sectioned and every loop classified, every DXF read and matched loop by loop to its STEP section, the rolled drum parts unwrapped onto their flat patterns, every M6 hole checked to sit on a rail centre line, the assembly re-imported and re-checked for overlap, and 500 values stated in the documents compared with the files | No overlap; no audit failure; the report in `mechanical/cad/audit/audit-report.md` | Cutting anything | run 2026-11-07 on draft 9: 213 solids, no overlaps (`--check`, and again on the re-imported assembly), 603 document checks and 741 generic checks pass; the new rows are Q-001 to Q-047. The audit's assembly check now samples a grid of points through every pair's box overlap as well as running the boolean, because the boolean returned 0 for the condensate blank 2 mm into the bottom rear rail where Fusion found 115 mm3 (the sample finds 135, the same place); the drain moved from Z 60 to 66. Earlier, run 2026-11-06 on draft 8: 198 solids, no overlaps (`--check`, and again on the re-imported assembly), 555 document checks and 717 generic checks pass; the new rows are M-016d to M-020k and N-001 to N-040. Draft 7 model, 2026-11-06: 167 parts, no overlaps; 500 document checks and 598 generic checks pass (the audit now takes 10 mm felt as a flat part, sections the module's collar for V-013, checks the power module plate's M6 against the cross rails, and allows the new named diameters). Earlier, draft 6 model, 2026-11-06: 127 parts, no overlaps; 364 document checks and 468 generic checks pass (the audit now classifies the curved lint slot as an annular sector, takes the riser's two sections for V-013, treats the console's plates and members like the cabinet's, and reads the Tier 0 faceplate's numbers from the drawing script the model now imports). Earlier, draft 5 model, 2026-11-06: 110 parts, no overlaps; 320 document checks and 404 generic checks pass (the audit now classifies rounded outlines, reads bulge arcs in DXF polylines, re-centres tilted plates on their outline, ignores engraving in the diameter list, and matches the Tier 0 faceplate's own drawing to its STEP section). Drawing everything found three things the numbers alone had hidden: the belt could not pass the single ceiling slot (fixed: two slots where the runs cross), the lint slot sits in the front felt annulus and partly outside the drum (V-016, open), and the UCI envelope is deeper than the console wedge (V-015, open). Earlier, interference option run 2026-11-05: no overlaps after the bay rework (first run found 13). Audit written and run 2026-11-05: 269 document checks and 378 generic checks pass. The audit found what the interference check could not: the console face plate sloped the wrong way (minus 45 instead of plus 45 about X), the bay ceiling plate in three pieces, a cord hole through an M6 hole, two louver columns through the exhaust port, M6 holes on the front lower panel where no rail is (the lint duct gap), the drum belt track 77 mm from the pulley, and the rollers overhanging the drum end. All fixed in the model and the documents. |
| V-011 | Hole sizes against the fastener budget | `cad_audit.py` lists every round feature deeper than 0.5 mm in every DXF and in every STEP and allows only the named set | Only 4.5 (M4), 6.5 (M6), 6.6 (M6 bonding studs with nuts), 8.5 (M8 feet studs and roller studs) plus part-specific holes that are named (10 inlet, 22 cord bushing and grommets, 30 harness grommet, 126 collar opening, 106 exhaust port, the door and ring openings, 22.3 devices, 12 timer shafts and 4 yoke holes on the Tier 0 faceplate, the felt arcs), the corner radii (6, 3, 10 on the plates; 2 and 1.5 on the extrusions) and the extrusions' centre bores (6.8, 4.2) | Cutting | run 2026-11-05 and 2026-11-06 in the audit, again on draft 7: every diameter is on the list |
| V-012 | Belt length and drum speed | The model draws the belt on its path round the drum (R 310 plus half the 3.5 mm belt), the 20 mm pulley and the 40 mm idler at X -60, Z 165, and prints the length of that path: 2222 mm (2232 with the 30 pulley of drafts 3 to 6; the two-pulley estimate of draft 3 was 2214). Pick the nearest catalog J-section poly-V length and place the idler so its take-up covers the difference. The drum speed is 1725 x pulley / 620; the model refuses a pulley outside 45 to 57 rpm | A catalog belt fits inside the idler's take-up range; the pulley wrap (120 degrees as drawn) is enough for the drum load; 45 to 55 drum rpm | V-105, motor position | drawn 2026-11-06; checking the ratio on 2026-11-06 found the 30 pulley gave 83 rpm, so draft 7 uses 20 (56 rpm); the idler position, the arm and the spring are placeholders for the catalog idler kit chosen at V-105 |
| V-013 | Air path areas | Blower outlet area against the heat module's inlet (150 x 60) and collar (125 round), the riser's hood (334 x 25 between its bars), trunk (244 x 50) and nozzle (212 x 142), the rear inlet hole field (126 x 10 mm), the curved lint slot (radius 238 to 267, 72 degrees), the lint basket's outer wall inside the lint box (its mesh arc times its length to the bulkhead), the lint box (316 x 30 between its bars), the spool (140 x 120), the exhaust (102 round); `cad_audit.py` computes them from the measured features (each bar frame from a section of its bar compound, the slot from its arcs, the basket from a section of its mesh, the collar from a section of its tube) | Nothing in the path smaller than the blower outlet; inlet field at least equal | Cutting bulkheads and ducts | run 2026-11-06 on draft 8: module inlet 9000, module collar 12037 (inside the 0.6 wall), hood 8350, trunk 12200, nozzle 30104, inlet field 9896, lint slot 9202, basket outer wall inside the box 9294, lint box 9480, spool 16800, exhaust 8171 mm2, all at or above the 102 mm outlet (8171); the spool's bottom bar covers the lowest 15 mm of the blower's 130 mouth, leaving 12400 of its 13273. Earlier: run 2026-11-06 on draft 7: module inlet 9000, module collar 12037 (inside the 0.6 wall), riser 13000, riser hood 8400, lint duct 11088, lint slot 8867, inlet field 9896, exhaust 8171 mm2, all at or above the 102 mm outlet (8171). Earlier, run 2026-11-06 on draft 6: riser 13000, riser hood 8400, lint duct 11088, lint slot 8867, inlet field 9896, exhaust 8171 mm2, all at or above the 102 mm outlet (8171); the hood is the tightest at 103 percent. Earlier, 2026-11-05: riser 13000, lint duct 12096, lint slot 10057, inlet field 9896, exhaust 8171 |
| V-014 | Independent kernel re-measure | Open every STEP in Autodesk Fusion and run `mechanical/cad/fusion_audit/fusion_audit.py` there: it measures every body (volume, bounding box, faces, every cylindrical surface) and the chosen clearances with Fusion's own kernel and writes `audit/fusion-measured.csv`; then `cad_audit.py --fusion` compares the two records body by body and feature by feature | Every volume within 0.01 percent, every bounding box and every cylinder axis within 0.02 mm, every clearance within 0.02 mm; face counts may differ (the kernels split periodic faces differently) and are reported, not failed | Cutting anything | The parametric Fusion build, 2026-11-07, Fusion 2706.1.17: the document `mechanical/cad/fusion_build/fusion_build.py` draws natively (not an imported STEP) measured the same way by `measure_active()` and compared with the OpenCascade measurements of the script's assembly STEP by component name, 213 of 213 components, 1136 bodies, 640 comparisons, 0 failures; the one allowed difference is the Tier 0 faceplate's engraved labels in Fusion's own font, 36 mm3 (0.019 percent), allowed by name in `cad_audit.py` (`mechanical/cad/audit/fusion-build-report.md`). The STEP record remade the same day after the cord's bend became a ball (`Solid.makeSphere` had drawn a hemisphere): 1216 bodies, 4994 cylinders, 60 clearances, 1099 comparisons pass, only the cord's row changed. Draft 9 rerun, 2026-11-07, Fusion 2706.1.17, after the PS1 tube was redrawn as three runs with a ball at each bend (its swept version had come back from the STEP file 226 mm3 small, found when the parametric Fusion build was compared with it) and `fusion_audit.py` switched to Fusion's high-accuracy volumes (`body.volume` is a medium-accuracy figure, 0.015 percent low on the drum splice): 1216 bodies, 4994 cylinders, 60 clearances; 1099 comparisons pass, every volume within 0.01 percent (the tube and the splice now within 0.001 percent) and every box, cylinder axis and clearance within 0.02 mm; the same two CHECKs on face counts. Draft 9, 2026-11-07, Fusion 2706.1.17: 1216 bodies (80 part files and the 213-component assembly), 4994 cylinders, 60 clearances; 1099 comparisons pass, every volume within 0.01 percent and every box, cylinder axis and clearance within 0.02 mm; the same two CHECKs on face counts (the drum sheet and the liner). Draft 8, 2026-11-06, Fusion 2706.1.17: 1151 bodies (78 part files and the 198-component assembly), 4818 cylinders, 57 clearances; 1041 comparisons pass, every volume within 0.01 percent and every box, cylinder axis and clearance within 0.02 mm; two CHECKs on face counts (the drum sheet OCP 600 / Fusion 570 as before, and the rolled throat liner OCP 10 / Fusion 8, the kernels splitting its periodic faces differently). The first draft 8 run measured the front bulkhead before the moved lint box holes (Z 310 and 345) had reached the machine, failed on that one file, and was rerun on the current file. Draft 7, 2026-11-06, Fusion 2706.1.17: 943 bodies (69 part files and the 167-component assembly), 3943 cylinders, 52 clearances; 895 comparisons pass, every volume within 0.01 percent and every box, cylinder axis and clearance within 0.02 mm; the one CHECK is the drum sheet's face count as before (OCP 600, Fusion 570). Earlier, draft 6 with the 500 wide aperture, 2026-11-06, Fusion 2706.1.17: 637 bodies (58 part files and the 127-component assembly), 3162 cylinders, 44 clearances; 711 comparisons pass, every volume within 0.01 percent and every box, cylinder axis and clearance within 0.02 mm; the one CHECK is the drum sheet's face count as before (OCP 600, Fusion 570). The first draft 6 attempt had measured the draft 5 part files before they reached the machine and was discarded. Draft 5, 2026-11-06, Fusion 2706.1.17: 535 bodies (48 part files and the 110-component assembly, whose hardware sets Fusion lists body by body and the comparison adds up), 2808 cylinders, 44 clearances; 610 comparisons pass, every volume within 0.01 percent and every box and clearance within 0.02 mm; the one CHECK is the drum sheet's face count again (OCP 600, Fusion 570). Earlier, run 2026-11-05: 105 bodies (46 part files and the 59-solid assembly), 1352 cylinders, 44 clearances; 423 comparisons pass. Every bounding box identical to 0.0000 mm, every volume within 2 ppm, every hole and round surface matched with no extras, every clearance identical. One CHECK: Fusion counts 450 faces on the drum sheet where OpenCascade counts 480, because it merges the tab root faces into the shell; same volume, same features. Visual and Measure-tool check 2026-11-06: the assembly opened in Fusion through File > Open, looked over from the six views inside and out, and 23 dimensions read from Fusion's Measure dialog by clicking faces, edges and bodies (drum 620, door opening 460 on the axis, cabinet 690 x 750 x 1001.5, UCI aperture 240 x 120 with 4.5 holes on 260 x 140, clearances 35 / 20 / 7.7 / 9.2 / 0 / 2, console 113.137, port 106, cord 22, rings 618.4 and 548 apart); all as documented. Record and screenshots: `mechanical/cad/audit/fusion-visual-check.md`. |
| V-022 | Heat module fits the bay (was a second V-014) | The drawn module (tray 340 x 280, box 290 x 205 x 110, collar to 227, terminal plate and devices to Y 729) against the bay: under the hood (230) and the mid rear end rail (260), inside the tray rails, 15 or more from the rear lower panel; the pull-out path out the back; the model asserts the module's highest point and the devices' depth | Fits; slides out the back with the rear lower panel off and nothing else moved | HE-TRAY and HE-BOX drawings | decided 2026-11-06 (`DECISIONS.md`): the module leaves by the back. Draft 7 draws the whole module: highest point 227 (the collar's rim), K_HEAT's front 21 from the panel, the box's front wall 5 behind the idler spring; the Fusion motion check (V-021) slides it 250 out under the hood with no interference. What the drawing cannot settle is the element's frame and terminals (V-108) and the device sizes (V-112) |
| V-023 | Throat liner | Drawn in draft 8: a 1.5 mm aluminium strip rolled to radius 235.5 between the door ring's back face and the front bulkhead, spliced at the top, the lint box's top following it 0.2 outside. Roll the first liner round a 471 plywood disc and offer it up to the ring and the bulkhead before the lint box is made | The liner springs no more than 0.5 off the form, its ends sit on the ring's back face and the bulkhead with the 0.2 float, the splice's heads sit inside, and the box's arcs clear it | Lint box plates (their top arc) | drawn; the first rolled strip is the test |
| V-015 | Console aperture against the Tier 0 parts | Timer yoke, knob, 22 mm devices, K1 rail against the 560 x 120 x 120 envelope (uci-spec draft 5); and the envelope against the console itself | Everything inside; the envelope inside the console | T0-FACE cutting | needs V-110 for the bought parts. Decided 2026-11-06 (`DECISIONS.md`): the console is a 200 tall vertical box on its own 4040 frame, 138.5 deep, so the whole envelope (120 deep behind the panel plane) sits inside it with 18 to spare and the chassis never reaches into the envelope (the top panel is 23 below it, the front rail 17 above it, the posts' bracket bolt heads 45 to each side of the 500 wide envelope). Drawing the Tier 0 module into the envelope found K1's socket 14 mm below the aperture's projection; faceplate draft 2 moves the 22 mm devices 20 above the centre line and the rail 24 below it, and the model asserts K1 inside the projection. Draft 5 had found the wedge console too shallow for the envelope |
| V-016 | Door against the drum | Door opening 460 inside the ring opening 480; felt annulus 273 to 291 lands on the ring face between the tabs (inside 293.2) and the 540 bore; the curved lint slot (238 to 266) inside the bore and outside the opening; door disc 540; hinge load | Everything inside its zone with margin | Front bulkhead and door DXFs | PASSES on paper in draft 6, 2026-11-06, by option (b) below with the tabs kept as folded tabs (16 tall, so the felt rides the ring face inboard of them): the audit measures the felt 2.2 mm inside the tab roots, 0.5 off the front ring face, and the slot 8 outside the opening and 4 inside the bore (`DECISIONS.md`). Earlier, FAILS on paper, 2026-11-06, found when the felt was drawn: the lint slot (260 x 40, 270 below the axis) occupies the front bulkhead from radius 250 to 290 at its middle and reaches radius 318 at its ends, so it sits in the felt annulus, outside the ring bore (240) and at its ends outside the drum (310). Air leaving the drum would have to pass between the ring face and the bulkhead, and the slot ends open into the drum compartment. The rear felt is drawn; the front felt is not, and the slot waits. Options, all within the charter: (a) a curved slot inside the bore, radius 205 to 235 over plus or minus 36 degrees about the bottom (about 8300 mm2, above the 8171 mm2 blower outlet), with the door opening reduced to 400 and raised 15 mm so its edge clears the slot by 17; (b) the same curved slot at radius 238 to 268 with the ring bore opened to 540 (ring 270 to 309.2), the tabs lanced inward on the ring's inside face so the ring's front face is smooth, and the felt at radius 275 to 305; the door opening stays 460; (c) a lint filter in the door itself (a housing in the disc, like several European dryers), which removes the slot from the bulkhead. Needs a `DECISIONS.md` entry; the model's `lint_slot_*`, `door_opening_d`, `ring_id` and `felt_ri/ro` are the parameters |
| V-017 | Drum support geometry | Roller positions (310 + roller radius, plus or minus 32 degrees) on both bulkheads against the chosen roller's diameter and bore; the ISO 7379 10 x 35 stud's stack (1.0 shim, 25 roller, 8.5 spacer, 1.5 bulkhead, 0.5 float) against the roller bought; the glides (8 and 9.5 thick) against the felt's compressed thickness; the front studs' nuts against the lint duct (4 mm) | Rollers touch the sheet over the rings, the roller tracks on the sheet carry no fasteners, the drum has about 1 mm of end play between the glides, nothing else touches the drum | Rear and front bulkhead DXFs | drawn 2026-11-06 (draft 7): the audit measures the stud and glide stacks; the roller's bore and width are V-102 |
| V-018 | Lint basket fits the slot and comes out through the door | Drawn in draft 8: a mesh basket on two laser-cut 3 mm sector plates (radius 239.5 to 265.5, 35.6 degrees each side of straight down) through the slot (238 to 267) with 0.9 each side, a lip on the bulkhead's drum side whose outer radius (268.5) rides inside the rings' 540 bore, a 64 mm D-pull on the lip's tab at the bottom of the door opening; the Fusion motion model slides it 40 mm back into the drum. Build the basket first and try it in the cut bulkhead | The basket slides through the slot without binding, its lip seats on the bulkhead, the pull is reachable through the open door, the basket lifts out through the opening, and the mesh seam at the inner arc stays closed | Front bulkhead DXF (the slot's outer radius 267 is draft 8) | drawn; the 0.9 clearance and the mesh thickness (0.6 assumed) are confirmed on the first basket |
| V-019 | Height and reach | Total height 1221 on the feet (1203 on the frame, 18 for the feet run in) against the laundry space; door opening bottom at 419.5 above the floor; the console face (its aperture centre at 1102.5 above the floor) reachable | Fits the space; a person can reach the drum bottom; the knobs are at a comfortable height | Nothing; information | draft 6 numbers; a 1221 machine is 100 taller than draft 5's wedge console gave, and still under the 1250 or so that commercial dryers with a raised console reach |
| V-020 | Scope of the first test run | Electric reference build only, Tier 0 only, no gas, no heat pump | Stated in `builds/` before buying | Gate 1 | |
| V-021 | Motion check in Fusion | Open the assembly STEP in Autodesk Fusion and run `mechanical/cad/fusion_motion/fusion_motion.py` there: it makes as-built joints for everything that moves (drum with its rings, splice, baffles and bolts; pulley, blower and idler; four rollers; door with its hinge halves, handle, seal and strike; two timer knobs, the selector and START; the heat module tray), plays the motion, and runs Fusion's interference analysis at rest, half way and fully moved | Every joint turns or slides the way the documents say; no interference at rest; anything that appears during the motion is a design finding | Nothing; information | Rerun 2026-11-07 on the parametric Fusion build (`mechanical/cad/fusion_build/`, its stage G): the same script run on the document Fusion draws natively from the parameters, not on an imported STEP; 15 as-built joints and 5 rigid groups found their faces on the drawn parts, 0 overlaps of 1 mm3 or more over the three poses among the 213 components, the archive `mechanical/fusion/osa-dryer-parametric.f3d` exported with the joints and appearances in it (screenshot 74). Rerun 2026-11-07 on draft 9: 15 joints as before; the first import found 115.1 mm3 between the condensate drain's blank and the bottom rear end rail at every pose (the blank's edge 2 into the rail's top), the drain moved to Z 66 and the rerun gave 0 overlaps of 1 mm3 or more over the three poses among the 213 components; 1216 bodies re-measured by `fusion_audit.py`; seven screenshots (66 to 72) of the two-tone model, the bay with the blower's outlet box and the exhaust pipe, the back with the spigot and the blanked entries, the rear lower panel off, the moisture bar set on the bulkhead, the thermistor on the lint box, and the half-way pose. Rerun 2026-11-06 on draft 8: 15 joints (the lint basket slides 40 mm back into the drum); the first import found 13.5 mm3 between the lowest lint box M4 heads and the bay ceiling's front edge, which the script's own check had missed (a failed boolean returning zero; the check now clips each pair to its overlap and agrees); after the screws moved to Z 310, 0 overlaps of 1 mm3 or more over the three poses among the 198 components; 1151 bodies re-measured by `fusion_audit.py`; eight screenshots (58 to 65) of the two-tone model, the riser, the lint box and liner, the basket pulled out, the console, the bay and the heat module out the back. run 2026-11-06 on draft 4 of the model (barebones knobs and pin): 13 joints, the motion as documented, rest pose clean; at the slid-out poses the heat module tray meets the motor, the pulley and the blower, which stand on the centre line in its path (up to 2.95e6 mm3 overlap at 250 mm out), and behind it the riser's bottom (Z 180) is lower than the module's top (222), so the module cannot leave by the back either. Options: the module leaves by the back with the riser's bottom raised to 230 and a top-rear outlet flange on the module (the rear lower panel already comes off), or the drive moves off the centre line. Decided 2026-11-06: out the back (`DECISIONS.md`). Rerun 2026-11-06 on draft 6 (and again after the 500 wide aperture): 14 joints, the tray joint pulling toward the back with the rear lower panel left out of the moved poses; 0 overlaps of 1 mm3 or more at rest, a quarter of the way and half way (door 100 degrees, tray 250 mm out the back under the riser's hood). Rerun 2026-11-06 on draft 7: 14 joints, the whole electric heat module (every heat-module component, 19 of them) in the tray's rigid group; 0 overlaps of 1 mm3 or more over the three poses among the 167 components; seven screenshots (51 to 57) of the modules, the glides and the studs. Record: `mechanical/cad/audit/fusion-motion-check.md`, archive `mechanical/fusion/osa-dryer-assembly-motion.f3d` |

## Gate 1: parts in hand, nothing cut yet

Measure, write the numbers into the CAD parameters, regenerate, read the diff, then order the laser cutting.

| ID | Check | Method | Pass when | Unlocks | Result |
| --- | --- | --- | --- | --- | --- |
| V-101 | Drum sheet stock | Confirm the cutting service cuts 0.8 mm 304 at 1945 x 590 in one piece, and what the kerf and tab accuracy are | A single blank; tab fold lines marked by the cutter or by hand from the DXF | Ordering the drum sheet | |
| V-102 | Rollers | Measure roller OD, width and bore on the chosen roller; the model assumes 60, 25 and 10.5 on an ISO 7379 10 x 35 shoulder screw (draft 7) | `roller_d`, `roller_bore_d`, `roller_stud_shoulder` and `roller_spacer` confirmed or changed; the 8.5 bulkhead holes stay unless the stud's thread changes | Both bulkhead DXFs, CH-ROLLER-STUDS | |
| V-103 | Drum rings | Measure the cut rings: outside diameter against the sheet's inside (618.4), flatness, hole circle | Rings round within 0.5 mm; holes match the tabs | V-208 | |
| V-104 | Felt strip and glides | Width, thickness, adhesive, temperature rating of the felt; the glide pad material and thickness | The two arcs (1282 and 396 on radius 282, radius 273 to 291) covered by the strip; the felt's compressed thickness (drawn 8 at the front, 10 at the rear) matches the glides (8 and 9.5), so the drum rides on the glides with the felt just touching | Bulkhead felt, CH-GLIDES | |
| V-105 | Belt and idler | Belt length and rib count bought; idler diameter and spring rate | V-012 recomputed with real numbers; motor pulley position fixed | Motor mount plate | |
| V-106 | Motor | NEMA frame base pattern, shaft diameter and length both ends (the model assumes 1/2 in both ends, draft 7), FLA and LRA, thermal protector type | Mount plate holes drawn; V-004, V-006 confirmed with the nameplate; the pulley and blower bores match | Motor mount, K_MOTOR, CB1 | |
| V-107 | Blower set | Housing outlet size and orientation (draft 9 draws the 102 discharge collar of design-rules 3.2 on the outlet box's rear face at X 230, Z 150, Y 190, and the 4 in pipe over it), the inlet's diameter and the flat face round it (the blower plate's back carries that face, draft 9: the housing's inlet face sits on the plate at Y 85.5 with the spool's 140 x 120 bore cut through the plate), the housing's screw pattern round its inlet (the plate's four 4.5 holes are drawn on a nominal 176 x 120 and are drilled from the housing in hand), wheel bore and rotation direction, the thermostats' and tap's positions | The plate's holes match the housing; the collar's position and size give the pipe a straight run to the port with the clamp over the joint; wheel bore matches the motor shaft; the thermostats' positions on the outlet box (draft 8 envelopes at X 130, 180, 230, on the box top at 206 in draft 9) | Blower plate DXF (its housing holes), the exhaust pipe's cut length, exhaust thermostat brackets | |
| V-108 | Element on its frame | The 279838 class element's frame outline (the model assumes 267 x 190 x 51 from a listing, draft 7), its mounting holes, where its two terminals leave and how far they stand out; the height of the catalog 125 collar bought | The element sits on the two angle rails' top legs inside the box with room above and beside it, the rails' bolt holes drawn to the frame, the terminal opening in the right wall placed, the box height set so the collar's rim stands at 227 (`hm_box_h`); then the air speed over the coil checked against the element maker's figure at V-205's measured flow | HE-TRAY and HE-BOX DXFs | |
| V-109 | Thermal fuses and thermostats | Tab size, mounting hole spacing, body size (the model assumes 40 hole spacing on a 14 x 54 bracket, body 22 x 22 x 13, draft 7) | Brackets drawn on the blower housing; the two pairs of holes in the element box's lid confirmed | Brackets, HE-BOX lid | |
| V-110 | Timers | Yoke length, shaft diameter, knob diameter, body depth | `tier0_drawings.py` parameters updated; V-015 confirmed | T0-FACE DXF | |
| V-111 | Air-proving switch | Port size, mounting ears, pressure range (the model draws a 60 x 28 x 60 envelope on a 20x20x2 angle bracket at X 250, Y 70 on the base pan, draft 8) | Bracket holes and tube routing confirmed | V-205, the PS1 bracket | |
| V-112 | Power module and heat module devices | Every device's width, height across the rail and depth off the plate against the envelopes in the model (draft 7: datasheet figures for the PSU and K_HEAT, listing figures for K_MOTOR, typical figures for the terminal blocks, breaker, fuse terminals, relays, end clamps and the current switch); the rails' free length; the cord bushing's thread against the 22 hole; draft 9: the exhaust thermistor's body, nib and screw hole against the 36 x 30 x 14 envelope with a 10 x 16 nib and one M4 at 10 above its centre, and the moisture bar set's footprint, thickness and tab holes against the 90 x 30 x 8 envelope with two M4 at 35 either side of its centre and the terminals at the centre | Everything fits its rail (A1 77.5, A2 116.5, A3 82.8, B1 95.2, B2 118.2, the heat module's 183.6, all on 140 or 280 rails) and stands 15 or more from the rear panels; the barrier at 640 clears the devices on A3 and B1; the thermistor's slot and hole and the bar set's three holes are cut to the bought parts | Power module plate, cover and barrier DXFs; HE-BOX terminal plate; the lint box back plate's thermistor slot and hole; the front bulkhead's three moisture bar holes | |
| V-113 | Extrusion and hardware | Slot width, T-nut fit, whether the extrusion's bore takes an M8 tap for the feet | Feet method confirmed | Frame cutting | |
| V-114 | Connectors intermate | Mini-Fit Jr. and XH parts from the two makers plug together and latch | Yes | Harness making | |
| V-115 | Door hardware and door switch | Hinge and latch dimensions; the door switch's body, plunger travel and ear pattern (the model draws a 30 x 25 x 45 envelope with an 8 mm plunger on radius 258 at 45 degrees right of bottom, pressed 3 mm by the closed disc, ears on radius 288, draft 8) | Front panel and ring holes drawn: the plunger hole 8.5 and the two 4.5 ear holes are in the DXFs and move to the switch's own pattern | Front upper panel and door ring DXFs | |
| V-116 | Chassis sensors in place | The moisture bar set (draft 9 envelope 90 x 30 x 8 on the front bulkhead's drum side at 58 degrees right of bottom on radius 250, inside the ring bore) against the turning drum, the basket's lip ring and the felt; the exhaust thermistor's nib in the lint box's airstream; both pairs through the 16 grommets with the door switch cable | The drum turns with the bars 0.5 or more off the ring's front face and clear of the baffles' path; the basket slides out past the bars; the three cables pass the grommets without chafe; both sensors read at X6 with a meter (the thermistor near 10 k at room temperature, the bars open with nothing across them) | Nothing; information, unless a clash moves the bars, which moves three holes in the front bulkhead DXF | drawn 2026-11-06: 1.3 to the ring's bore edge, 40 to the lip ring, the bars' corners at radius 268.8 inside the 270 bore |

## Gate 2: bench tests, before the frame exists

| ID | Check | Method | Pass when | Unlocks | Result |
| --- | --- | --- | --- | --- | --- |
| V-201 | Power module on the bench | Wire it complete on its plate, with the barrier and the cover fitted. Lamps as loads: a 120 V lamp on X3 for the motor, a 240 V lamp (or a second 120 V lamp L1 to N) on a test tray for the heat module. Door switches, PS1, TF2, T_HI, T_LO on flying leads. Run commissioning stages 1 and 2 with the test plug, with PS1 operated by hand (blow into its tube) | Every line of stages 1 and 2 ticks | Fitting the power module to the frame | |
| V-202 | Tier 0 module on the bench | Plug into the bench power module; run commissioning stage 3 | Every line ticks | Fitting the module | |
| V-203 | Electric heat module on the bench | Element resistance, TF1 and T_HL continuity, K_HEAT coil resistance, tray bonding. The element is never energized outside the chassis | All as expected | Fitting the tray | |
| V-204 | Motor and blower | Motor on its mount plate on the bench with the blower, run from the bench power module through K_MOTOR: direction, current against FLA, vibration, noise, the thermal protector does not trip in 20 min | Current within nameplate; no trip | Fitting the drive | |
| V-205 | Air-proving setpoint | Blower, 1 m of duct, PS1 on its tap (draft 9: a barb fitting in a 6.5 hole on the exhaust pipe's top at Y 300, 108 behind the collar joint, and a 6 mm tube to the switch's port; which of the switch's ports, and whether the tap wants to be further from the collar's turbulence, is part of this test), a manometer. Find the pressure with a clean inlet and with the inlet half blocked. Set PS1 to close at a clean inlet and open before half blocked | A setpoint exists with margin both ways; record it in `bom.csv` CPM-PS1 and on the PS1 label, and the tap's final position in the model | Fitting PS1; the tap hole in the pipe | |
| V-206 | Faceplate fit | The cut faceplate with both timers, the selector, the button, and K1 fitted | Everything fits and clears the aperture band | Module assembly | |
| V-207 | Bulkhead and drum dry fit | Rear bulkhead with rollers on two sawhorses, drum on the rollers, front bulkhead held against it: turn the drum by hand | Drum turns on the rollers, ring faces land on the felt, nothing else touches | Frame assembly | |
| V-208 | Drum wrap, cheap material first | Wrap a 0.5 mm aluminum flashing or heavy card blank cut to the sheet DXF around the real rings and bolt the tabs. Measure the diameter at mid-length at four angles. Hang a 5 kg weight on a strap over the belt track (352 from the front edge) to mimic belt pull and measure again. Press a roller against the sheet at the ring with 50 N and look for a dent. Then wrap the stainless | Mid-length out-of-round under 3 mm free and under 5 mm loaded; tabs land on the ring holes without forcing (the model assumes a sharp fold; if the real fold moves the hole, change `tab_h` or the hole offset in the model); no dent at the roller; two people can close the seam | Cutting the stainless sheet, V-207 | |

## Gate 3: assembled, unplugged

Done step by step inside `docs/build-guide.md`; listed here so none is skipped.

| ID | Check | Pass when |
| --- | --- | --- |
| V-301 | Frame square and level | Diagonals equal within 2 mm on every face; feet set |
| V-302 | Every T-nut bolt torqued | Marked with a paint pen after torque |
| V-303 | Bonding | Commissioning stage 1 bonding list, every item short to PE |
| V-304 | Drum turns by hand | Free, no rubbing, both directions, with the belt off |
| V-305 | Belt tracks | Belt centered on the drum and the pulley through ten turns by hand |
| V-306 | Seals | Felt seals in contact all round; a sheet of paper is gripped at four points |
| V-307 | Ducts sealed | Riser, lint duct, exhaust joined with gaskets and clamps, no gap you can see light through |
| V-308 | Door | Latches, opens past 90 degrees, operates S1 and S2 (continuity) |
| V-309 | Lint screen | Seats, comes out without tools |
| V-310 | Harness | Wire list ticked at both ends; J1 and J2 reach the module with slack and are strain relieved |
| V-311 | Nothing loose | Rock the cabinet, shake the panels, open and close the door ten times |

## Gate 4: commissioning

`docs/commissioning.md`, all stages, in order, with the numbers written on the sheet in the lid.

## Gate 5: the test run

| ID | Check | Method | Pass when |
| --- | --- | --- | --- |
| V-501 | Air-only run | 20 min, empty drum, panels on. Exhaust airflow measured at the duct (anemometer or a bag timing), motor current, noise notes | Airflow at or above 2.5 m3/min; current within nameplate |
| V-502 | First heated run, empty | 10 min HIGH, then 5 min cool-down. Exhaust temperature every minute, element current, number of T_HI cycles | Exhaust reaches the target and T_HI cycles; no limit trips; no smell after the first minutes |
| V-503 | Wet towels | 4 kg of cotton towels from a spin-dried washer, HIGH, HEAT TIME 50, DRY TIME 60. Temperatures, current, moisture at the end by feel and weight | Dry at the end; no limit trip; no lint outside the filter |
| V-504 | Door interrupt | Open the door mid-cycle, close it, press START | Stops at once, restarts only on START |
| V-505 | Power interrupt | Pull the plug mid-cycle for 10 s | Stays stopped until START |
| V-506 | Restricted vent | Cover half the exhaust outlet for one heated cycle | T_HI cycles faster; the high-limit does not trip; if it does, the thermostat settings are wrong, not the limit |
| V-507 | After the run | Panels off: lint where it should not be, any discoloration, every terminal cool, belt tracking, drum rims | Nothing found, or found and logged |
| V-508 | Build log | `builds/2026-MM-<builder>/` with every number, every photo, every deviation, and the measured values written into `bom.csv` and the CAD parameters | Complete |

## What this plan does not cover

- Gas and heat pump modules: their own rows are added when those modules move past paper. The electric reference build is the only one in scope for the first test run.
- Long-term wear: that is the failure-mode guide's job, fed by the build log.
- Code compliance: the builder's, not the plan's. The plan makes the machine conservative; it does not make it legal anywhere.
