OpenSourceAppliances/dryer/mechanical/cad/audit/fusion-measured.csv

record | file | body | other | is_solid | volume_mm3 | area_mm2 | faces | planar_faces | cylindrical_faces | edges | vertices | xmin | ymin | zmin | xmax | ymax | zmax | radius | ax | ay | az | fx | fy | fz | t0 | t1 | length | n_faces | value_mm | note
body | base-pan | Body1 |  | 1 | 770130.2143 | 1032525.9891 | 53 | 6 | 47 | 110 | 102 | -343.5 | -0.0 | -1.5 | 343.5 | 750.0 | 0.0
cylinder | base-pan | Body1 |  |  |  |  |  |  |  |  |  |  |  |  |  |  |  | 6.0 | 0.0 | 0.0 | 1.0 | -337.5 | 6.0 | 0.0 | -1.5 | 0.0 | 1.5 | 1
cylinder | base-pan | Body1 |  |  |  |  |  |  |  |  |  |  |  |  |  |  |  | 6.0 | 0.0 | 0.0 | 1.0 | 337.5 | 6.0 | 0.0 | -1.5 | 0.0 | 1.5 | 1
cylinder | base-pan | Body1 |  |  |  |  |  |  |  |  |  |  |  |  |  |  |  | 6.0 | 0.0 | 0.0 | 1.0 | -337.5 | 744.0 | 0.0 | -1.5 | 0.0 | 1.5 | 1
cylinder | base-pan | Body1 |  |  |  |  |  |  |  |  |  |  |  |  |  |  |  | 6.0 | 0.0 | 0.0 | 1.0 | 337.5 | 744.0 | 0.0 | -1.5 | 0.0 | 1.5 | 1
cylinder | base-pan | Body1 |  |  |  |  |  |  |  |  |  |  |  |  |  |  |  | 4.25 | 0.0 | -0.0 | 1.0 | -325.0 | 20.0 | 0.0 | -1.5 | 0.0 | 1.5 | 1
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
