OpenSourceAppliances/dryer/mechanical/cad/audit/measured-planes.csv

part | normal_x | normal_y | normal_z | area_mm2 | centroid_x | centroid_y | centroid_z
base-pan | 0.0 | 0.0 | 1.0 | 513420.143 | 0.209 | 374.909 | -1.5
base-pan | 0.0 | 0.0 | 1.0 | 513420.143 | 0.209 | 374.909 | 0.0
base-pan | 1.0 | 0.0 | -0.0 | 1107.0 | -343.5 | 375.0 | -0.75
base-pan | -1.0 | 0.0 | 0.0 | 1107.0 | 343.5 | 375.0 | -0.75
base-pan | 0.0 | 1.0 | 0.0 | 1012.5 | 0.0 | -0.0 | -0.75
base-pan | 0.0 | -1.0 | 0.0 | 1012.5 | -0.0 | 750.0 | -0.75
basket-far-clamp | -0.0 | -1.0 | -0.0 | 8103.682 | 0.0 | 12.6 | 394.744
basket-far-clamp | -0.0 | -1.0 | -0.0 | 8103.682 | 0.0 | 14.1 | 394.744
basket-far-clamp | -0.813101 | 0.0 | 0.582123 | 39.0 | -146.986 | 13.35 | 426.192
basket-far-clamp | 0.813101 | 0.0 | 0.582123 | 39.0 | 146.986 | 13.35 | 426.192
basket-far-plate | -0.0 | -1.0 | -0.0 | 8115.746 | 0.0 | 9.0 | 394.74
basket-far-plate | -0.0 | -1.0 | -0.0 | 8115.746 | 0.0 | 12.0 | 394.74
basket-far-plate | -0.813101 | 0.0 | 0.582123 | 78.0 | -146.986 | 10.5 | 426.192
basket-far-plate | 0.813101 | 0.0 | 0.582123 | 78.0 | 146.986 | 10.5 | 426.192
basket-lip-clamp | -0.0 | -1.0 | -0.0 | 3334.738 | -0.0 | 45.1 | 407.056
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
