OpenSourceAppliances/dryer/CHANGELOG.md

# Changelog

Newest first. A tagged release means someone built it from the tag and the build log is in `builds/`.

## Unreleased

- 2026-11-09: The drive redesigned because the drawn one cannot be bought (`DECISIONS.md`): a stock NEMA 56 drum motor through a countershaft (6J sheaves, 5/8 in shaft in two pillow blocks, 49 drum rpm) and a separate packaged blower on its own motor. The parts are carted at Grainger, Texas Belting and McMaster-Carr; the BOM's drive lines are rewritten; the model and drawings are redrawn in draft 10.
- 2026-11-09: Sourcing pass, `bom/sourcing-2026-11-09.md`: carts filled (nothing ordered) at Digi-Key, SupplyHouse, Kele, AppliancePartsPros and McMaster-Carr, about 3506 USD before shipping and tax, with each substitution and what was left out and why. The drive (motor, motor pulley, belt, idler) and the blower were not carted: no catalog motor, belt or pulley matches the drawn drive, which needs a decision. The laser-cut plates wait on their Gate 1 checks. Correction: the 120 V breaker WMZT1C10 is UL 1077, not UL 489 as written on 2026-11-09, and is listed as discontinued; the BOM now names Eaton FAZ-C10/1-SP (UL 1077, what the spec asks for).
- 2026-11-09: The electrical parts checked against the makers' current datasheets, `bom/electrical-durability.md`: 16 parts with their rated life in operations, their duty in this dryer and the life that gives (12 outlast the machine, 3 are wear parts, 1 not yet checked). Corrections to the BOM found on the way: the motor contactor LC1K0910BD does not exist (TeSys K with a DC coil is LP1K or LP4K; now LP4K0910BW3, with a built-in coil suppressor and 30 million operations mechanical); the HEAT selector XB4BD33 already has its two contacts, so the two extra ZBE101 blocks are dropped; the K1 socket PYF08A-E is not in Omron's catalogue, now PYFZ-08-E; the breaker leads with the Eaton WMZT1C10 (UL 489) since the ABB S201-C10 is the IEC part. The checked lines carry the date and figures in their notes.
- 2026-11-07: The order plan, `bom/order-plan.csv` from `bom/order_plan.py`: 150 lines in 11 order groups (motor and drive, appliance parts, electrical, extrusion, fasteners, laser cutting in four materials, bar and angle stock, hardware store), each with what to send the vendor and the check that holds it, in three waves (buy and measure, cut after the checks, the drum sheet last). Fastener counts come from the model (259 M6 bolts and 247 M6 T-nuts where the BOM ordered 200 and 240), and the 20x20 angle from the cut list (3.25 m where the BOM ordered 3 m). Open before ordering: the inch stock for the metric thicknesses (the drum sheet above all), the drum sheet's one-piece size (V-101), the lint box hang bolts (M8 in the BOM, M6 in the model's set name), prices and the unverified part numbers.
- 2026-11-07: Two-tone paint in blue and grey (RAL 5023 distant blue body, RAL 7024 graphite grey trim; `DECISIONS.md`) and the first product renders, `mechanical/renders/` (fourteen shots: the dryer from three sides, open for service from the left and the rear, and each module and set on its own), made by `render()` in `fusion_motion.py` (draft 7) with Fusion's own renderer from the parametric model. The paint is two appearances the script makes in the design from the library's glossy enamel, named by RAL number. Found on the way: Fusion closes outright if `SceneSettings.cameraType` is set from a script; the local renderer keeps its own 36 mm view whatever the viewport camera's angle, so the shots are rendered bigger and cropped to the look of a longer lens; an environment brings its own exposure (Soft Light 9.5 EV) and setting the scene's default 12 EV over it makes the picture dark.
- 2026-11-07: The parametric Fusion build finished, stages E to G: all 213 parts of draft 9 drawn natively in Fusion and checked against the script's files (`mechanical/cad/fusion_build/README.md`, `mechanical/cad/audit/fusion-build-report.md`: 1136 bodies, 640 comparisons, 0 failures; the one intended difference is the Tier 0 faceplate's labels in Fusion's own font, 0.019 percent of its volume, allowed by name in `cad_audit.py`). Stage E draws the door, the Tier 0 module, the drive, belt and idler, the roller studs, the heat and power modules, the sensors, blanks, clamps, feet and brackets from `numbers.json` (67 components, 165 bodies); stage F the 841 bolts, nuts, washers and spacers of 44 hardware sets from `hardware.json` as fixed bodies made with Fusion's temporary-geometry tools (`DECISIONS.md`); stage G runs `fusion_motion.py` on the built document: 15 joints, 5 rigid groups, the library appearances, 0 overlaps of 1 mm3 or more at the three poses (V-021), and exports the archive of the parametric model, `mechanical/fusion/osa-dryer-parametric.f3d` (22.9 MB, 2875 timeline features). Screenshot 74. Found on the way and fixed: the cord's bend was a hemisphere (`Solid.makeSphere`'s default angles), now a ball, the assembly STEP, views and records regenerated and the Fusion record remade (V-014); a Move feature cannot rotate about a construction axis; a join that only touches leaves a separate body; `createTorus` draws about the origin whatever centre it is given (the button heads measured 29.5 mm3 big, then 14 mm3 small, before the torus was moved to its height). Fusion slows with the length of a session (stage E took an hour, the same work after a restart minutes), so the build is run a stage at a time with the archive exported between.
- 2026-11-07: The parametric Fusion build (`mechanical/cad/fusion_build/`, the editable version of the design decided on 2026-11-06), stages A to D of G: `fusion_build.py` runs inside Fusion and draws the design in a new document from user parameters (cabinet width, depth and height, drum diameter and length, door opening, bay height, plate thicknesses, panel pitch, console height, the UCI aperture) and derived ones: the frame and console sub-frame as the T-slot section extruded by expressions and placed by Move features in expressions (29 bars), the 34 flat plates from `plates.json` (outline sketches dimensioned where the numbers carry expressions, 627 holes and 88 slots as patterned cuts), the drum set (sheet with its patterned tabs, rings, splice, baffles, rollers, felts, glides), and the ducts, blower plate feet and exhaust set (the bar frames as boxes with their tapped holes). 130 of the 213 parts so far, every one measured in Fusion at the script's volume (0.01 percent) and place (0.02 mm); the script's numbers now carry their expressions (`Ex`), the plate functions write `plates.json`, and the script writes `numbers.json` (its derived numbers) and `hardware.json` (every placed bolt, nut, washer and spacer) for the remaining stages. Found on the way: Fusion's `body.volume` is a medium-accuracy figure (0.015 percent low on the drum splice; `fusion_audit.py` now measures at high accuracy and `fusion-measured.csv` is remade), and the PS1 tube's swept bends came back from the STEP file 226 mm3 small (the tube is now three runs with a ball at each bend; assembly STEP and the views regenerated, the audit's records follow). Screenshot 73.
- 2026-11-06: Model draft 9, the parts of the reference build finished (three entries in `DECISIONS.md`). The blower housing hangs on a blower plate: a 1.5 mm steel plate across the bay in front of it on two 20x20x2 angle feet through the base pan, with the spool's bore cut through it and the spool's foam on its face; the housing's screws go into it on the bought housing's pattern (V-107). The exhaust is drawn as parts: the housing's 102 discharge collar, a catalog 4 in aluminium pipe along the bay floor through the rear lower panel's port and 50 proud of it as the vent hose spigot, two worm-drive clamps, the air-proving tap, barb and tube to PS1. The two chassis sensors the UCI-D wires to J2 are placed: the exhaust thermistor on the bay side of the lint box's back plate, the moisture bar set on the front bulkhead's drum side (the door switch cable's grommets grow to 16 to pass its pair). The gas entry and the condensate drain are cut in the rear lower panel and blanked by two 60 x 44 plates. The four cable clamp holes get their P-clips. The no-heat module is the electric module's empty box (`bom/heat-none.csv`). 213 parts; the audit grows to the new parts (Q rows; 603 document checks, 741 generic, 1099 Fusion comparisons, 0 failures) and its assembly check gains a point-sampled overlap test beside the boolean (Fusion found the condensate blank 2 mm into the bottom rail where the boolean said 0; the drain moved to Z 66). Fusion pass (script draft 6): 15 joints, 0 interferences over three poses, 1216 bodies re-measured, the archive re-exported, seven screenshots (66 to 72). Design rules draft 9, verification draft 6 (V-116), wiring draft 3 (the sensor routes and the tube), build guide draft 3, maintenance draft 2, BOM lines CH-EXHAUST (rewritten), CH-EXH-CLAMP, CH-TAP, CH-BLOWER-PLATE, CH-BLANKS, CH-CLIPS, CPM-TH1, CPM-MOIST. The design is finished in the script and converted to an editable, parametric Fusion build at the end (`DECISIONS.md`).
- 2026-11-06: Fusion pass on draft 8: 15 joints (the lint basket slides), zero interferences over three poses after the lint box's lowest drum-side screws moved to Z 310 (Fusion found 13.5 mm3 in the bay ceiling's edge; the script's `--check` now clips each pair to its overlap before the boolean, which is what makes it agree), 1151 bodies re-measured and 1041 comparisons pass (V-014), the archive re-exported, eight screenshots (58 to 65); two-tone appearances (white body, charcoal console, door and skirt); no door window (`DECISIONS.md`).
- 2026-11-06: UCI-D draft 6: the aperture grows to 560 x 120 (faceplate 620 x 160 on the 590 x 140 pattern, envelope 560 x 120 x 120), as wide as the console's posts allow; the console face, the Tier 0 faceplate drawing (draft 4) and the audit rows follow (`DECISIONS.md`).
- 2026-11-06: Model draft 8, the ducts drawn as parts (three entries in `DECISIONS.md`). Every duct is 1.5 mm laser-cut plate screwed with M4 button heads into the tapped edges of aluminium flat bar frames: the lint box between the front stubs (30 x 8 bars, hung on two M8 into the stubs' tapped end bores, the front bulkhead its back wall above 265), a spool of 40 x 8 bars to the blower's mouth, the riser's hood (25 x 8), trunk (50 x 8) and inlet nozzle (40 x 8), with foam where a frame meets a plate it is not screwed to. Drawing them found the door throat open all round the opening (the blower would have drawn room air past the drum), so a rolled 1.5 mm throat liner now stands between the ring and the bulkhead and the lint box's top follows it. The lint filter is a mesh basket on 3 mm laser-cut sector plates through the slot (widened to radius 238 to 267), with a D-pull on its lip inside the door opening; Fusion slides it. The door switch (plunger through the ring, 45 degrees right of bottom), PS1 on an angle bracket, the exhaust thermostats on the blower's outlet box, the motor cradles' M6, the door switch's two grommets and four cable clamp holes are placed, and the harness routes are written (`electrical/wiring/common-power-module.md` 4a). 198 parts; the audit grows to the new parts (V-013 measures each frame's section, V-018 the basket, V-023 the liner); design rules draft 8, verification draft 5, BOM lines CH-DUCTS, CH-FLATBAR, CH-LINER, CH-LINT, CH-BOLT-M3, CH-BOLT-M8, CH-DS-MOUNT, CH-PS1-BRKT, the build guide's duct and basket steps.
- 2026-11-06: Fusion holds the design of record (`mechanical/fusion/osa-dryer-assembly-motion.f3d`), with the script, STEP, DXF and the wiring document as its open form; no KiCad schematic will be drawn, the wiring document and the ladder drawings are the electrical design. `DECISIONS.md`; the empty `electrical/schematic/` folder removed.
- 2026-11-06: Model draft 7, the two modules and the drum's support, drawn from published figures before the first build (three entries in `DECISIONS.md`). Electric heat module: a bolted 1.5 mm duct box (290 x 205 x 110) on the tray with 20x20x2 angle at every edge and 64 M4, the catalog element on two angle rails inside, a 125 round starting collar on the lid 3 under the riser's hood (which now reaches forward to Y 448 with a foam ring round the collar's hole), the thermostats on the lid, and a terminal plate behind the box with a DIN rail carrying K_HEAT, the two strips and the current switch; the tray rails run the full depth on 2020 corner brackets and the tray takes M4 T-nuts. Common power module: out of the bay and onto a 150 x 720 plate on the rear faces of the rear cross rails, left of the riser, with five 140 DIN rails (mains under a cover on standoffs, SELV above a barrier), every device an envelope from its datasheet or listing, serviced with the rear upper panel off; K_MOTOR becomes a mini contactor for depth; the cord and the harnesses pass through grommets in the bay ceiling and the top panel. Drum: two nylon glides per bulkhead locate it endways with the felt in two arcs round them; the rollers turn on ISO 7379 shoulder screws through the bulkheads, moved from 30 to 32 degrees so the front nuts clear the lint duct. Drive: the pulley is 20 mm, because 30 gave 83 drum rpm against the 45 to 55 target. 167 parts, no overlaps; the audit, the Fusion checks, the design rules (draft 7), the wiring doc (draft 2), the build guide (draft 2), the maintenance guide and the BOMs follow.
- 2026-11-06: UCI-D draft 5: the aperture grows to 500 x 120 (faceplate 540 x 160 on six M4, envelope 500 x 120 x 120) so later modules have room for a display beside the controls; `DECISIONS.md`. Tier 0 faceplate draft 3 spreads the controls across the wider plate. Model, audit rows, design rules, Tier 0 README and BOM follow.
- 2026-11-06: Model draft 6, the three draft 5 findings settled and drawn (four entries in `DECISIONS.md`). Lint slot: the drum rings' bore grows to 540 and the slot becomes a curved slot inside it (radius 238 to 266, 72 degrees, 8867 mm2) below the unchanged 460 door opening; the felts move out to radius 273 to 291, the tabs shrink to 16 tall, and the front felt is drawn. Heat module: it leaves by the back; the riser's bottom rises to 230 with a 300 x 28 hood over the module's outlet collar, the cord enters through the base pan under the power module and runs under the pan, and the feet grow to 18 under the pan. Console: a 200 tall box across the rear of the top on its own 4040 frame (4 posts, 4 rails, 12 corner brackets, M6 hardware), 138.5 deep, holding the whole UCI-D envelope; vertical face with the aperture, cap, rear plate, two cheeks; the machine is 1203 tall on the frame. Every M4 is a button head (2.5 mm key); the UCI-D spec (draft 4) and the fastener budget say so. Tier 0 faceplate draft 2: the 22 mm devices 20 above the centre line, K1's rail 24 below it, so K1 stays inside the aperture; the model now imports the faceplate's numbers from `tier0_drawings.py`. 127 parts, no overlaps; 364 document checks and 468 generic checks pass (the audit reads the curved slot as an annular sector and the riser's two sections). Design rules draft 6, verification plan draft 3, BOM lines updated (extrusion, brackets, T-nuts, feet, felt, M4 bolts, lint screen, ducts, strain relief). Fusion motion check rerun on draft 6 (`fusion_motion.py` draft 3): 14 joints, the tray now slides out the back, 0 overlaps at rest and while moving; six new screenshots and the archive. V-014 rerun in Fusion on draft 6: 633 bodies, 711 comparisons with the OpenCascade measurements, no differences.
- 2026-11-06: Model draft 5, the realism pass. Everything the design rules called for is now drawn: T-slot profiles on all 25 extrusions (8 mm slot 4040, 6 mm slot 2020, centre bores), 6 mm laser corner radii on every plate (3 on the cheeks, splice and tabs), every panel bolt (M6 x 12 hex with washer, 175 of them, each sitting in a slot), the four leveling feet in the posts' tapped bores through 8.5 holes in the base pan, the belt drawn on its real path with the flat idler, its arm, pivot and spring brackets and spring, the door's eight M4 ring bolts, two flag hinges, D-handle, seal and magnetic catch, the Tier 0 module (faceplate with engraved legends, two timers with yokes and knobs, selector, START, K1 on its DIN rail), the rear felt seal, the cord bushing and cord, and detail on the motor (end bells, shafts, terminal box, two cradle mounts), pulley (grooves, hub) and blower (inlet mouth, outlet box into the exhaust duct). 110 parts, no overlaps. Drawing the belt showed that the single ceiling slot on the centre line could not pass it (the runs cross the plate at X -138 and +148); the bay ceiling now has two slots. Drawing the felt showed the lint slot in the felt annulus, outside the ring bore and with its ends outside the drum (V-016 fails on paper; options listed, decision open). Drawing the Tier 0 module showed the 120 mm UCI envelope does not fit inside the console wedge (V-015, open). Drum bolts M4 x 8 (not 10) and M6 x 12 at the baffles (the holes were always 6.5). The audit grew to 320 document checks and 404 generic checks (rounded outlines, bulge arcs in DXF polylines, the faceplate's own drawing matched to its STEP section); all pass. Fusion: `fusion_motion.py` draft 2 joints the real knobs, hinge, idler and door hardware (14 joints), applies library appearances to every component, and its interference analysis at three poses is clean at rest; only the heat module tray's path through the drive remains (V-021, decision open). Archive with joints and appearances in `mechanical/fusion/`. Design rules draft 5, BOM lines for the hinges, handle, hardware, idler arm and motor mounts.
- 2026-11-05: CAD audit. `mechanical/cad/cad_audit.py` measures every STEP and DXF the model writes and compares them with 269 values taken from the design rules and the UCI spec, plus 378 generic checks (one solid, valid, closed, every loop classified, no cut overlaps another, DXF matches its STEP section loop by loop, drum parts unwrap onto their flat patterns, every M6 hole on a rail, assembly re-checked for overlap). `fusion_audit.py` repeated the measurements inside Autodesk Fusion for an independent kernel (V-014): 105 bodies, 423 comparisons, no difference beyond 2 ppm in volume and none in position. 2026-11-06: the assembly opened in Fusion by hand, looked over from six views and 23 dimensions read from the Measure dialog, all as documented (`mechanical/cad/audit/fusion-visual-check.md`). Found and fixed: console face sloping the wrong way, bay ceiling plate in three pieces, cord hole through an M6 hole, louvers through the exhaust port, panel holes where no rail is, belt track 77 mm off the pulley, rollers overhanging the drum. Model draft 3: drum sheet now carries its tabs and every hole, rings and splice carry their holes, baffles are 40 x 40 x 3 angles with holes, front and rear panels split at 260, DXFs in world coordinates on a CUT layer. Design rules draft 4.
- 2026-11-05: Drum changed from a bought OEM drum to a builder-made wrapped 304 sheet on two laser-cut rings, with its flat patterns, four catalog rollers, a catalog belt by length, and the wrap test V-208. The OEM drum decision is reversed in DECISIONS.md.
- 2026-11-05: First CAD pass: parametric model (CadQuery) with 51 parts, 17 laser-cut plates as DXF, 21-piece extrusion cut list, STEP for everything, check views, interference check. Verification plan (`docs/verification.md`) with 70 checks in six gates. Build guide outline with the gates. Mechanical architecture decided and logged (five decisions). Mechanical BOM lines.
- 2026-11-05: Tier 0 faceplate drawing (DXF and SVG), Tier 0 wiring drawing, cabinet concept layout drawing, all generated by `mechanical/drawings/tier0_drawings.py`. UCI-D draft 3 (aperture 240 x 120). BOM corrected from the timer family sheet; gas and heat pump BOMs at family level; drum target revised to 650 mm.
- 2026-11-05: Electrical paper stage: common power module wiring doc with terminal map and wire list, two ladder drawings (SVG, generated by `ladder.py`), commissioning checklist with the UCI test plug, first BOM lines (six verified today), failure-mode guide first entries, two more decisions.
- 2026-11-05: Heat source becomes a module with four choices (none, electric, gas, heat pump). UCI-D draft 2, design rules draft 2, two decisions logged, per-module BOM files added.
- 2026-11-05: UCI-D spec, draft 1 (`controls/uci-spec.md`).
- 2026-11-05: Dryer design rules, draft 1 (`docs/design-rules.md`).
- 2026-11-05: Tier 0 control module block design (`controls/tier0-mechanical/README.md`).
- 2026-11-05: Five architecture decisions logged in `DECISIONS.md`.
- 2026-11-05: Repo created in the charter layout. Design phase, before CAD.
