OpenSourceAppliances/dryer/(commit log)

2026-11-06 Dryer: paper design through the first CAD pass
    UCI-D spec draft 3, design rules draft 3, common power module wiring and
    ladder drawings, commissioning checklist, verification plan with gates,
    failure-mode guide, BOM with six verified lines, Tier 0 faceplate and
    wiring drawings, parametric CAD (CadQuery) with STEP and DXF exports
    including the builder-made drum, extrusion cut list, and the decision
    log. Nothing built yet.
    Claude-Session: https://claude.ai/code/session_01NfhpBdgHddjGK2zf7kXLEY
    [base-pan.dxf, base-pan.step, bay-ceiling.dxf, bay-ceiling.step, bom-tiers.csv, bom.csv, console-cap.dxf, console-cap.step]
2026-11-06 CAD audit: measure every STEP and DXF against the documents, fix what it found
    mechanical/cad/cad_audit.py re-reads every file the model writes with the
    OpenCascade kernel and ezdxf: one solid, valid, closed, bounding box, volume,
    every cylindrical surface, every planar face, every flat part sectioned and
    every loop classified, every DXF matched loop by loop to its STEP section,
    the rolled drum parts unwrapped onto their flat patterns, every M6 hole on a
    rail centre line, the assembly re-imported and re-checked for overlap, and
    269 values stated in docs/design-rules.md and controls/uci-spec.md compared
    with the files (mechanical/cad/expected-dimensions.csv). Report and the full
    measured reco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
    [base-pan.dxf, base-pan.step, bay-ceiling.dxf, bay-ceiling.step, console-cap.dxf, console-cap.step, console-cheek-left.dxf, console-cheek-left.step]
2026-11-06 Fusion re-measure of every STEP (V-014): 423 comparisons, no differences
    fusion_audit.py run inside Autodesk Fusion 2706.1.17 over all 47 STEP files:
    105 bodies, 1352 cylinders, 44 clearances. cad_audit.py --fusion compared
    the record with the OpenCascade measurements: every bounding box identical
    to 0.0000 mm, every volume within 2 ppm, every hole and round surface
    matched with no extras, every clearance identical. One face-count CHECK on
    the drum sheet (Fusion merges the tab root faces into the shell).
    The script now finds the repo from its own location or a REPO variable and
    logs relative paths only.
    Claude-Session: https://claud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
    [fusion-measured.csv]
2026-11-06 Fusion by-hand check: assembly opened in Fusion, six views, 23 Measure readings
    mechanical/cad/audit/fusion-visual-check.md records the assembly STEP opened
    in Autodesk Fusion through File > Open, looked over from the standard views
    inside and out, and 23 dimensions read from Fusion's Measure dialog by
    clicking faces, edges and bodies: drum 620, door opening 460 on the axis,
    cabinet 690 x 750 x 1001.5, UCI aperture 240 x 120 with 4.5 holes on the
    260 x 140 pattern, clearances 35 / 20 / 7.7 / 9.2 / 0 / 2, console cap
    113.137, exhaust port 106, cord entry 22, rings 618.4 and 548 apart. All as
    documented. Screenshots cropped to the CAD viewport in fusion-screens/.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
2026-11-06 Model draft 5: everything the rules call for is drawn; belt slots moved; three findings
    The parametric model now draws the T-slot profiles of all 25 extrusions,
    6 mm laser corner radii on every plate, all 175 panel bolts in their slots,
    the four leveling feet in the posts' tapped bores, the belt on its real
    path with the flat idler, arm, brackets and spring, the door's ring bolts,
    two flag hinges, D-handle, seal and catch, the Tier 0 module with engraved
    faceplate, timers, knobs, selector, START and K1, the rear felt seal, the
    cord bushing and cord, and detail on the motor, pulley and blower. 110
    parts, no overlaps.
    Drawing the belt showed the single ceiling slot on the centre line could
    no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
    [base-pan.dxf, base-pan.step, bay-ceiling.dxf, bay-ceiling.step, bom.csv, console-cap.dxf, console-cap.step, console-cheek-left.dxf]
2026-11-06 Model draft 6: the three draft 5 findings settled and drawn
    Four decisions (DECISIONS.md 2026-11-06): the lint slot becomes a curved
    slot inside the drum rings' bore, which grows to 540, with the 460 door
    opening kept and both felts drawn at radius 273 to 291; the heat module
    leaves by the back under a hood on a riser raised to 230, the cord enters
    through the base pan and the feet grow to 18 under the pan; the console is
    a 200 tall box across the rear of the top on its own small 4040 frame,
    138.5 deep, holding the whole UCI-D envelope (machine 1203 tall on the
    frame); every M4 is a button head with a hex socket.
    Tier 0 faceplate draft 2: the 22 mm devices 20 above the centre line and
    K1's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
    [base-pan.dxf, base-pan.step, bay-ceiling.dxf, bay-ceiling.step, bom.csv, console-cap.dxf, console-cap.step, console-cheek-left.dxf]
2026-11-06 Fusion motion check on draft 6: 14 joints, the tray out the back, clean
    fusion_motion.py draft 3 run on the draft 6 assembly in Fusion: the tray
    joint now slides toward the back and the rear lower panel is left out of
    the moved poses. Fusion's interference analysis finds 0 overlaps of 1 mm3
    or more at rest, a quarter of the way and half way (door 100 degrees, heat
    module 250 mm out the back under the riser's hood), which closes the draft
    5 finding. Six screenshots cropped to the viewport, the archive with joints
    and appearances, the record in fusion-motion-check.md, V-021 updated. The
    Fusion re-measure of the part files (V-014) is still the draft 5 run; the
    draft 6 rerun is pending.
    Co-Auth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
    [osa-dryer-assembly-motion.f3d]
2026-11-06 Fusion re-measure of draft 6 (V-014): 633 bodies, 711 comparisons, no differences
    fusion_audit.py rerun inside Fusion on the draft 6 part files and assembly:
    633 bodies, 3148 cylinders, 44 clearances. cad_audit.py --fusion compares
    them with the OpenCascade measurements: 711 comparisons pass, every volume
    within 0.01 percent, every box, axis and clearance within 0.02 mm; the one
    CHECK is the drum sheet's face count, as in every run. Report, CSV and log
    updated; V-021 record notes it.
    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
    [fusion-measured.csv]
2026-11-06 UCI-D draft 5: aperture 500 wide; Tier 0 faceplate draft 3
    The control aperture grows from 240 x 120 to 500 x 120 so later modules
    have room for a display beside the controls (DECISIONS.md 2026-11-06):
    faceplate 540 x 160 on six M4 (520 x 140 plus two on the centre line),
    envelope 500 x 120 x 120. The console frame is unchanged; the envelope
    clears the posts' bracket bolts by 45 a side. The Tier 0 faceplate
    spreads its knobs, selector and START across the plate. Model, drawings,
    audit rows (six holes, new positions), design rules, verification V-015,
    Tier 0 README and BOM follow; model regenerated, no overlaps, audit clean.
    Claude-Se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
    [base-pan.dxf, base-pan.step, bay-ceiling.dxf, bay-ceiling.step, bom.csv, console-cap.dxf, console-cap.step, console-cheek-left.dxf]
2026-11-06 STEP files: pin the writer's time stamp so unchanged parts stay unchanged
    Every regeneration rewrote all 58 STEP files because the STEP writer
    stamps the file with the time of day. The model now replaces the stamp
    with the draft number (same length, so nothing else in the file moves),
    so a diff of mechanical/step shows geometry changes only. The audit reads
    the files as before.
    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
    [base-pan.step, bay-ceiling.step, console-cap.step, console-cheek-left.step, console-cheek-right.step, console-face.step, console-post-1.step, console-post-2.step]
2026-11-06 Fusion rerun after the 500 wide aperture: motion check clean, 711 comparisons pass
    Assembly re-imported, 14 joints rebuilt, 0 overlaps over the three poses,
    archive re-exported. fusion_audit.py rerun on the current part files: 637
    bodies, 3162 cylinders; cad_audit.py --fusion: 711 comparisons pass.
    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
    [fusion-measured.csv, osa-dryer-assembly-motion.f3d]
2026-11-06 Model draft 7: electric heat module, power module plate, drum glides and roller studs, 20 pulley
    The two modules and the drum's support are drawn from published figures
    before the first build (three entries in DECISIONS.md).
    Electric heat module: a bolted 1.5 mm duct box (290 x 205 x 110) on the
    tray, joined at every edge with 20x20x2 aluminium angle and 64 M4 button
    heads with nuts (no brake, no rivets), the 279838 class element on two
    angle rails inside, a 125 flanged starting collar on the lid standing 3
    under the riser's hood (which now reaches forward to Y 448 and carries a
    foam ring round the collar hole), the 279816 thermostats on the lid, and a
    terminal plate behind the box with a 2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
    [base-pan.dxf, base-pan.step, bay-ceiling.dxf, bay-ceiling.step, bom-tiers.csv, bom.csv, console-cap.dxf, console-cap.step]
2026-11-06 Fusion checks on draft 7: motion, interference, re-measure, screenshots
    Model draft 7 imported into Fusion 2706.1.17: 14 as-built joints with
    the whole heat module (every heat-module component) in the tray's rigid
    group, library appearances on all 167 components, 0 interferences of
    1 mm3 or more at rest, a quarter and half way (door 100 degrees, tray
    250 mm out the back under the hood). Archive updated.
    Independent re-measure with Fusion's kernel: 943 bodies, 3943 cylinders,
    52 clearances; 895 comparisons pass (the usual drum sheet face-count
    CHECK only). The Fusion audit's clearance list follows the draft 7 names
    and adds single-body pairs for the modules, the glides and the felts;
    the com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
    [fusion-measured.csv, osa-dryer-assembly-motion.f3d]
2026-11-06 Fusion is the design of record; no KiCad schematic
    The Fusion archive with its joints and appearances is the mechanical
    design of record; the CadQuery script, the STEP and DXF exports and the
    wiring document stay beside it as the open form. The electrical design
    is the wiring document and the ladder drawings; no KiCad schematic will
    be drawn, and the empty electrical/schematic folder goes. Logged in
    DECISIONS.md as a departure from the charter's native-format rule.
    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
2026-11-07 Model draft 8: ducts as plates on flat bar frames, throat liner, lint basket, door switch, PS1, thermostats; UCI-D 560 wide
    Every duct is now a part: 1.5 mm laser-cut plates screwed with M4 button
    heads into the tapped edges of aluminium flat bar frames (lint box 30x8,
    spool 40x8, hood 25x8, trunk 50x8, nozzle 40x8), with foam where a frame
    meets a plate it is not screwed to. Drawing the lint duct showed the door
    throat was open all round the opening, so a rolled 1.5 mm throat liner
    stands between the ring and the front bulkhead and the lint box's top
    follows it. The lint filter is a mesh basket on 3 mm sector plates through
    the slot (widened to radius 238 to 267) with a D-pull inside the do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
    [base-pan.dxf, base-pan.step, basket-far-clamp.dxf, basket-far-clamp.step, basket-far-plate.dxf, basket-far-plate.step, basket-lip-clamp.dxf, basket-lip-clamp.step]
2026-11-07 Fusion pass on draft 8: basket slide, zero interferences, clipped check, two-tone paint, no door window
    Fusion motion draft 5 adds the lint basket as a slider (40 mm back into
    the drum), so the model has 15 joints. The first import found 13.5 mm3
    between the lint box's lowest drum-side M4 heads and the bay ceiling's
    front edge, which the script's own --check had missed because a failed
    boolean returned zero volume; the screws moved up to Z 310/345/380 and
    the check now clips each pair to its bounding-box overlap before the
    intersection, which makes it agree with Fusion (0 overlaps of 1 mm3 or
    more over three poses among 198 components). fusion_audit re-measured
    1151 bodies and 1041 compariso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
    [base-pan.dxf, basket-far-clamp.dxf, basket-far-plate.dxf, basket-lip-clamp.dxf, basket-lip-plate.dxf, bay-ceiling.dxf, console-cap.dxf, console-cheek-left.dxf]
2026-11-07 Model draft 9: the reference build's parts finished; the blower plate, exhaust set, chassis sensors, blanked entries, cable clips
    The blower housing hangs on a 1.5 mm blower plate standing across the
    bay in front of it on two 20x20x2 angle feet through the base pan, with
    the spool's bore cut through it and the spool's foam on its face; the
    housing's own screws go into it on the bought housing's pattern (V-107).
    The exhaust is drawn as parts: the housing's 102 discharge collar, a
    catalog 4 in aluminium pipe along the bay floor's right side through the
    rear lower panel's port and 50 proud of it as the vent hose spigot, two
    worm-drive clamps, the air-proving tap, barb and tube to PS1. The two
    c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
    [base-pan.dxf, base-pan.step, basket-far-clamp.dxf, basket-far-clamp.step, basket-far-plate.dxf, basket-far-plate.step, basket-lip-clamp.dxf, basket-lip-clamp.step]
2026-11-07 Parametric Fusion build, stages A and B: frame and plates built natively from parameters
    mechanical/cad/fusion_build/fusion_build.py runs inside Fusion and draws the
    design in a new document: user parameters (cab_w, cab_d, ext, bay_top, the
    plate thicknesses, drum_d, drum_l, door_d, panel_pitch, console_h, the UCI
    aperture) and derived ones (half_w, drum_axis_z, cab_h, rear_bulk_y, ...),
    the 23 frame bars as the exact T-slot section extruded by expressions and
    placed by Move features in expressions, and the 34 flat plates from
    plates.json: outline sketches dimensioned where the numbers carry
    expressions, holes and slots as patterned cuts (627 holes in 133 cuts, 88
    slots in 2), each plate mov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
    [osa-dryer-assembly.step]
2026-11-07 Parametric Fusion build, stage C: the drum set built natively; volumes measured at high accuracy
    Stage C of mechanical/cad/fusion_build/fusion_build.py draws the drum sheet
    (a tube of drum_d and drum_d - 1.6 mm by drum_l, one tab joined at each end
    and patterned 30 times, the seam and baffle holes cut inward from planes
    tangent to the drum), the two rings, the splice strip (its corners filleted),
    the three angle baffles, the four rollers, the felt arcs and the glide pads
    with their nut pockets; every drum part is drawn about the component's Y axis
    and moved by drum_front_y and drum_axis_z, the rollers by expressions in
    drum_d. 17 components, 19 bodies.
    fusion_audit.py now measures volume an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
    [fusion-build-measured.csv]
2026-11-07 Parametric Fusion build, stage D: ducts, blower plate feet, exhaust set; the PS1 tube redrawn for the STEP file
    Stage D of mechanical/cad/fusion_build/fusion_build.py draws the console
    sub-frame (8 bars), the throat liner and its splice, the lint box and spool
    bars and foams, the basket's plates, clamps, mesh and pull, the hood, trunk
    and nozzle bars, the hood gasket and nozzle foam, the blower plate's angle
    feet, the exhaust pipe, its clamps, the tap barb and the PS1 tube: 30
    components, 56 bodies. The bar frames are the script's boxes with the same
    tapped holes (4.2, the screw's length less the plate it passes through) cut
    from the bar's face; parts about the drum axis are drawn about the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
    [fusion-build-measured.csv, fusion-measured.csv, measured-parts.csv, osa-dryer-assembly.step]
2026-11-07 Decision: the parametric Fusion build draws the hardware as fixed bodies
    Bolts, nuts, washers and spacers (861 pieces in 45 sets, from hardware.json)
    are built with Fusion's temporary-geometry tools and added as one base
    feature per set, at the script's positions, instead of as features: a bolt
    as features is five to eight timeline entries and Fusion's time per feature
    grows with the document, so 861 of them would take hours and bury the
    editable parts in the timeline. Running stage F again redraws them on the
    holes after a parameter change.
    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
2026-11-07 Parametric build: the drive split into four groups, a drop() helper for rebuilding one group
    Stage E's first run in Fusion (59 minutes) built the door, the Tier 0
    module, the heat and power modules, the sensors, the feet and the brackets;
    its drive group stopped on "Invalid entity". build_drive now draws the motor,
    cradles, pulley and blower only; build_belt, build_idler and build_studs
    take the rest, so each group is run and checked on its own, and drop()
    deletes a group's components by name before it is rebuilt.
    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
2026-11-07 Parametric build fixes from the stage E run; the cord's bend drawn as a ball
    Stage E's first run matched 161 of its 168 components. What it found:
    joins that only touch leave a body of their own, so a part's Move now moves
    every body of its component and a join merges with whichever body it meets;
    the door handle is the bar first with the standoffs joined into it; the
    hinge's countersinks are the script's cone (it also nicks the knuckle where
    it stands proud of the leaf) instead of a chamfer; a Move cannot turn a body
    about the component's own axis ("Invalid entity"), so the idler spring is
    drawn on planes normal to its direction; the roller studs build (480 s).
    The script's cord bend was S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
    [measured-parts.csv, osa-dryer-assembly.step]
2026-11-07 Parametric Fusion build finished: stages E to G, every part checked, the archive of record
    Stage F's button heads were wrong because TemporaryBRepManager.createTorus draws about the origin whatever centre
    point it is given; the round is now made at the origin and moved up before it is clipped to its band. With that all
    213 components of the native build measure at the script's volume and place (1136 bodies, 640 comparisons, 0
    failures; the faceplate's engraved text is the one allowed difference, by name in cad_audit.py). stage_f takes
    only=(prefixes) to redraw chosen hardware sets.
    Stage G runs fusion_motion.py on the built document: 15 joints, 5 rigid groups, the library appearances, 0
    ove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
    [fusion-build-measured.csv, fusion-measured.csv, osa-dryer-parametric.f3d]
2026-11-08 Blue and grey two-tone paint and the first product renders
    The Fusion model's paint changes from white and charcoal to RAL 5023 distant blue (body panels) and RAL 7024
    graphite grey (console, door, skirt): two appearances fusion_motion.py makes in the design from the library's
    glossy enamel, named by RAL number so they can be ordered as powder coat (DECISIONS.md). The parametric archive is
    re-exported with the new paint.
    mechanical/renders/: fourteen 1920 x 1080 renders made by render() in fusion_motion.py (draft 7) with Fusion's own
    local renderer: the dryer from three sides, open for service from the left and the rear, and the drum, heat module,
    power module, Tier 0 module, door, drive, l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
    [osa-dryer-parametric.f3d]
2026-11-08 Order plan: what to buy, from whom, and what to send them
    bom/order_plan.py builds bom/order-plan.csv from the BOM files, the DXF drawings, the cut list, the model's
    hardware counts and the verification plan: 150 lines in 11 order groups, each with what to send the vendor (DXF files
    and the US sheet stock to cut them from, the cut list, the part number or the generic spec), the quantity and the
    check that holds it, in three waves (buy and measure, cut after the checks, the drum sheet last).
    Fastener counts come from the model, which places more than the BOM orders (259 M6 bolts and 247 T-nuts against
    200 and 240); the 20x20 angle comes from the cut list (3.25 m against the BOM's 3 m). vendo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
    [order-plan.csv]
2026-11-09 README: say plainly where the project stands
    The front page now opens with a render labelled as a render (nothing has been built) and a table of where each
    stage stands: the design drawn and computer-checked; the paper review 10 of 23 checks with results, 4 waiting on
    real parts and 9 not done (the electrical ratings, wire gauges, limits and the interlock truth table among them);
    every physical check, 43 of them, not started; the BOM's part numbers unverified and unpriced; no independent
    review, and the design drafted with heavy AI assistance. Replaces the old status line, which still said the
    editable Fusion build was to come.
    Claude-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
2026-11-10 Electrical parts checked against the makers' datasheets
    bom/electrical-durability.md records, for the 16 electrical parts that set the dryer's life, the part picked, the
    maker's rated life from the current datasheet, the duty in this dryer and the life that gives: 12 outlast the
    machine, 3 are wear parts (timers, cycling thermostats, element), 1 is not yet checked (the OEM fuses and limit).
    BOM corrections found on the way: the motor contactor LC1K0910BD does not exist; LP4K0910BW3 replaces it (same
    frame, built-in coil suppressor, 30 million operations). The XB4BD33 already carries its two contacts, so the extra
    ZBE101 blocks are gone. The K1 socket becomes PYFZ-08-E (PYF08A-E is not in th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
    [bom.csv, heat-electric-240.csv, order-plan.csv]
2026-11-10 Sourcing pass: carts at five sellers, breaker corrected to FAZ-C10/1-SP
    Records what was carted (nothing ordered), each substitution, and what
    was left out and why: the drive and blower have no catalog match for the
    drawn parts, and the laser-cut plates wait on their Gate 1 checks.
    The WMZT1C10 is UL 1077, not UL 489, and is listed as discontinued.
    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
    [bom.csv, order-plan.csv]
2026-11-10 Sourcing: propose the appliance dryer motor for the drive
    The drawn drive (dual-shaft 48 frame at 1725 rpm, 20 mm PJ pulley) has
    no catalog match; the smallest 1/2 in bore J pulley gives about twice the
    drum speed. Records the carted Whirlpool 279827 motor, WP694089 wheel and
    279640 idler, and what the change would mean for the drawings.
    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
2026-11-10 Drive redesigned: stock 56-frame motor, countershaft, separate blower
    The drawn dual-shaft motor and 20 mm pulley cannot be bought. Records
    the decision, rewrites the drive BOM lines, marks design-rules 7a Drive
    as superseded until draft 10, and updates the sourcing record.
    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
    [bom.csv, order-plan.csv]
